YazgacResearch/3DPrinter/README.md

# High Resolution 3D Printer

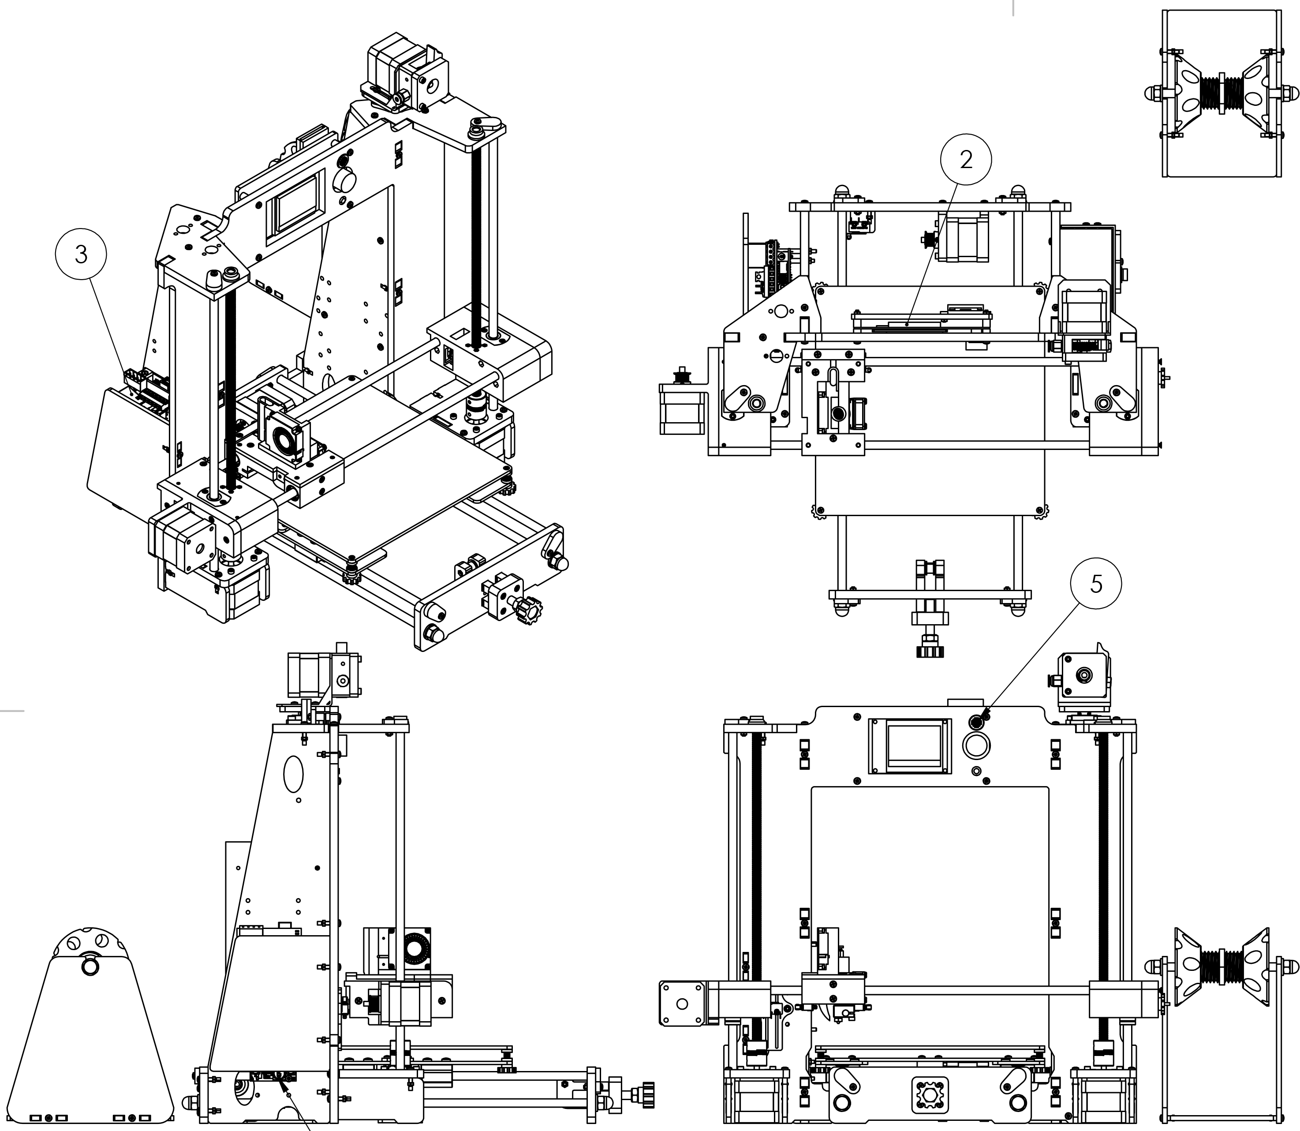
[picture p1: Images/design-1.png]
