YazgacResearch/3DPrinter/Marlin-bugfix-2.0.4.4/Patches for Eagle/Readme.txt

configuration files for Eagle.

Marlin version 020005
