YazgacResearch/3DPrinter/Drawings/3D_Printer_Rev_02/Electronics/Ramps_1.4/Shield Ramps 1.4.jpg

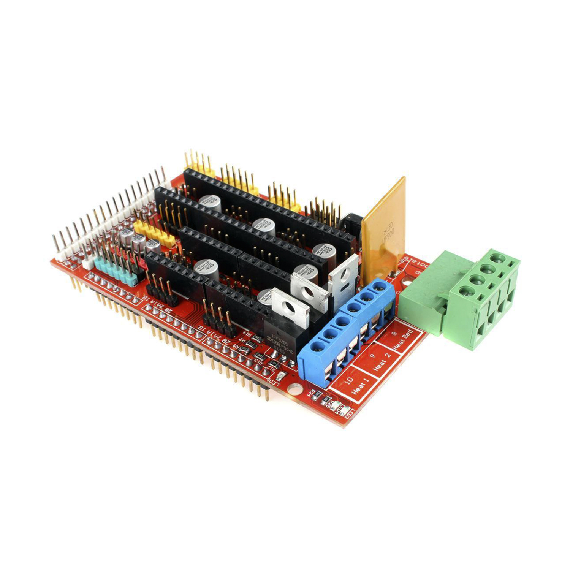
Drawings/3D_Printer_Rev_02/Electronics/Ramps_1.4/Shield Ramps 1.4.jpg
