YazgacResearch/3DPrinter/Marlin-bugfix-2.0.4.4/fotolar/IMG-9921.JPG

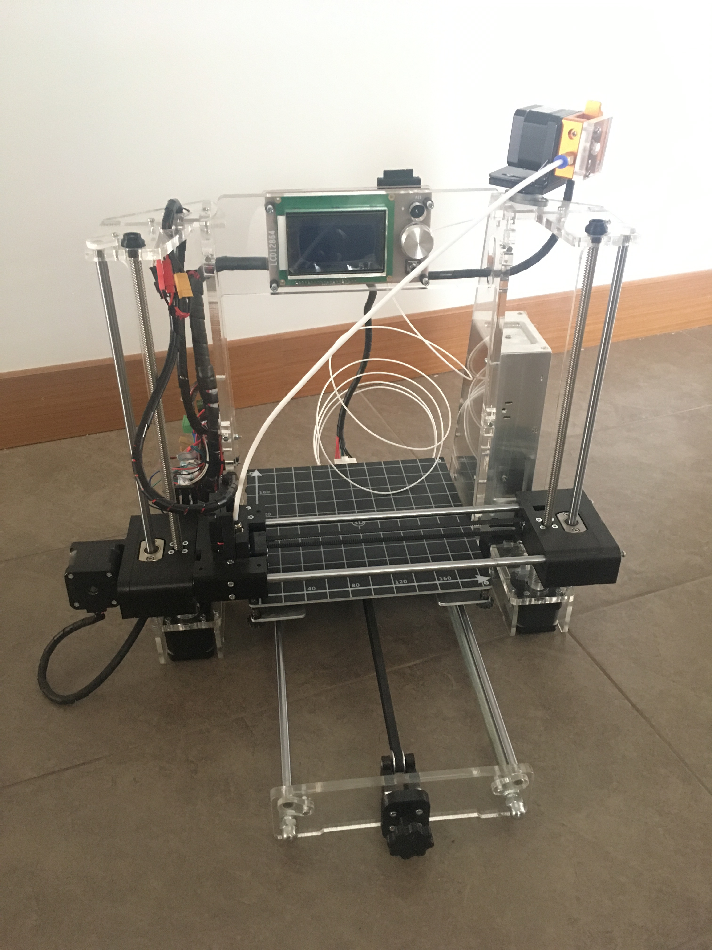
Marlin-bugfix-2.0.4.4/fotolar/IMG-9921.JPG
