YazgacResearch/3DPrinter/Marlin-bugfix-2.0.4.4/fotolar/IMG-9924.JPG

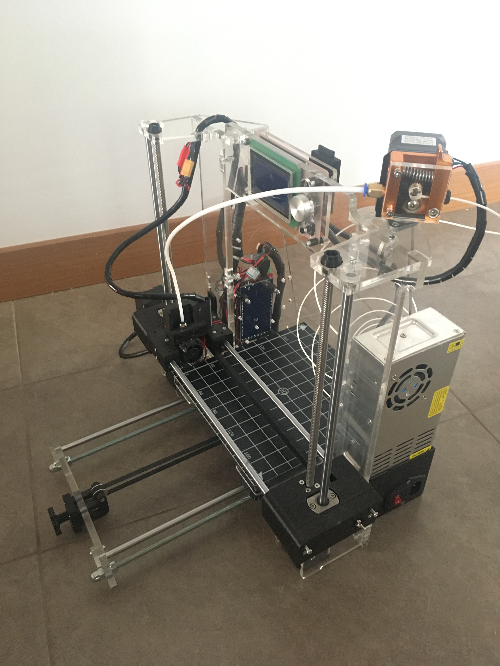
Marlin-bugfix-2.0.4.4/fotolar/IMG-9924.JPG
