YazgacResearch/3DPrinter/Marlin-bugfix-2.0.4.4/Pics/2.jpg

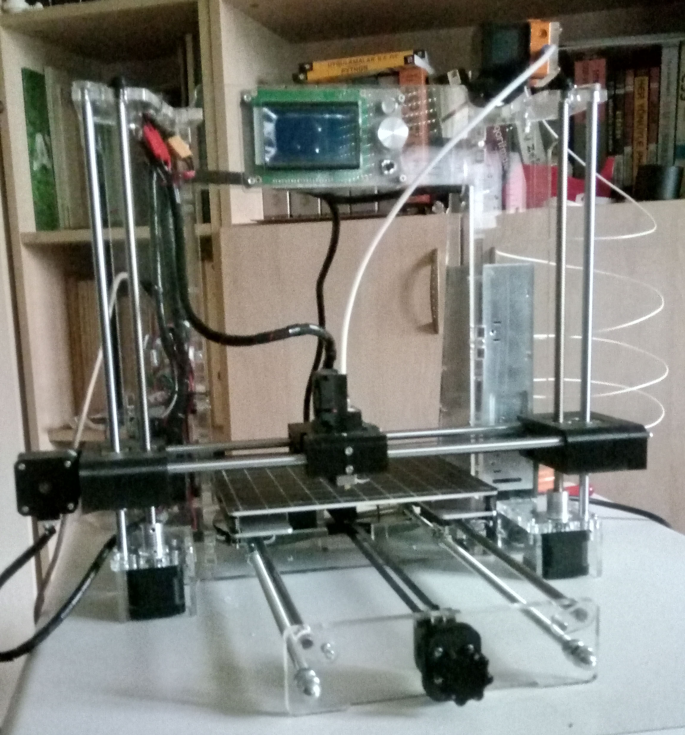
Marlin-bugfix-2.0.4.4/Pics/2.jpg
