YazgacResearch/3DPrinter/Marlin-bugfix-2.0.4.4/Pics/3-34178_black-eagle-png-eagle-clip-art.png

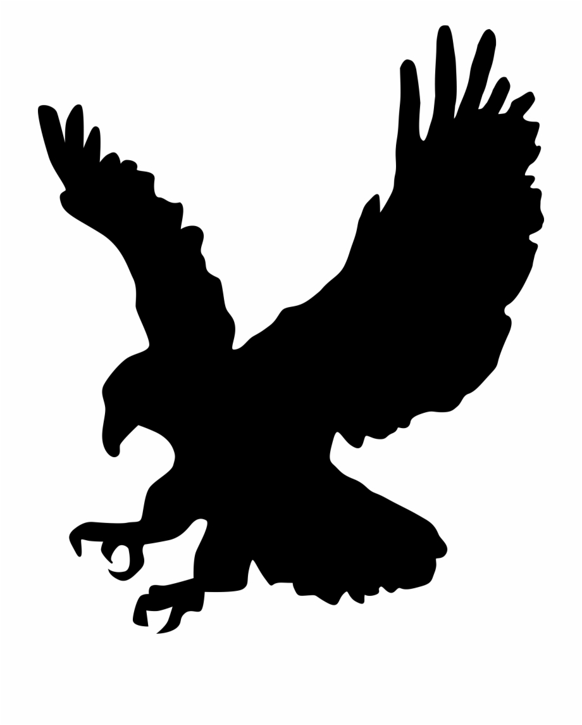
Marlin-bugfix-2.0.4.4/Pics/3-34178_black-eagle-png-eagle-clip-art.png
