YazgacResearch/3DPrinter/Marlin-bugfix-2.0.4.4/Pics/20200408_193704.jpg

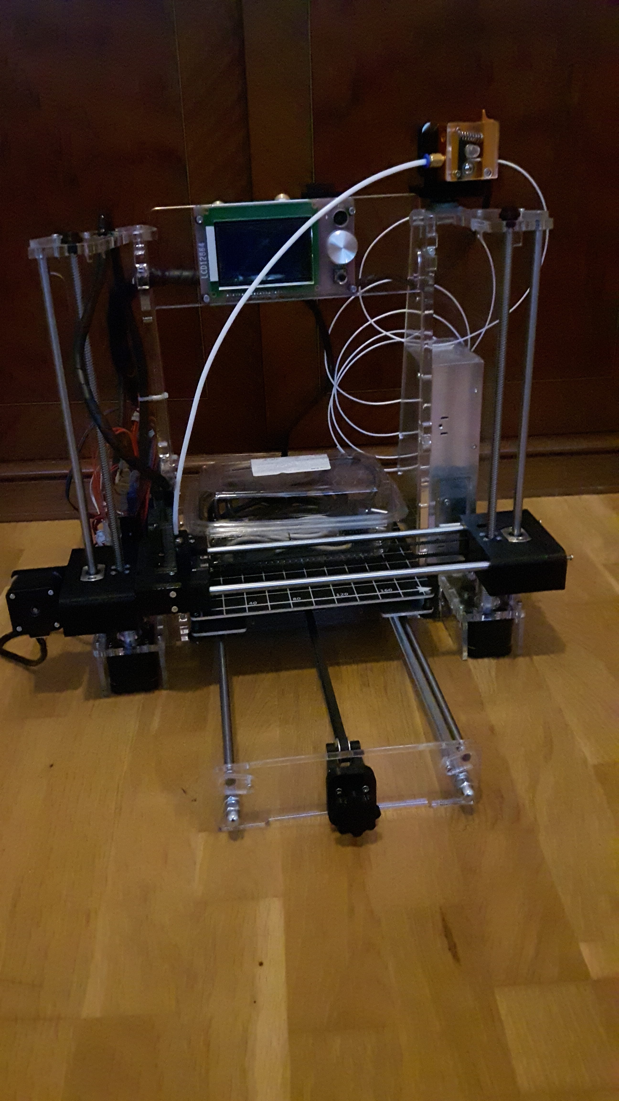
Marlin-bugfix-2.0.4.4/Pics/20200408_193704.jpg
