YazgacResearch/3DPrinter/Marlin-bugfix-2.0.4.4/Pics/20200408_193806.jpg

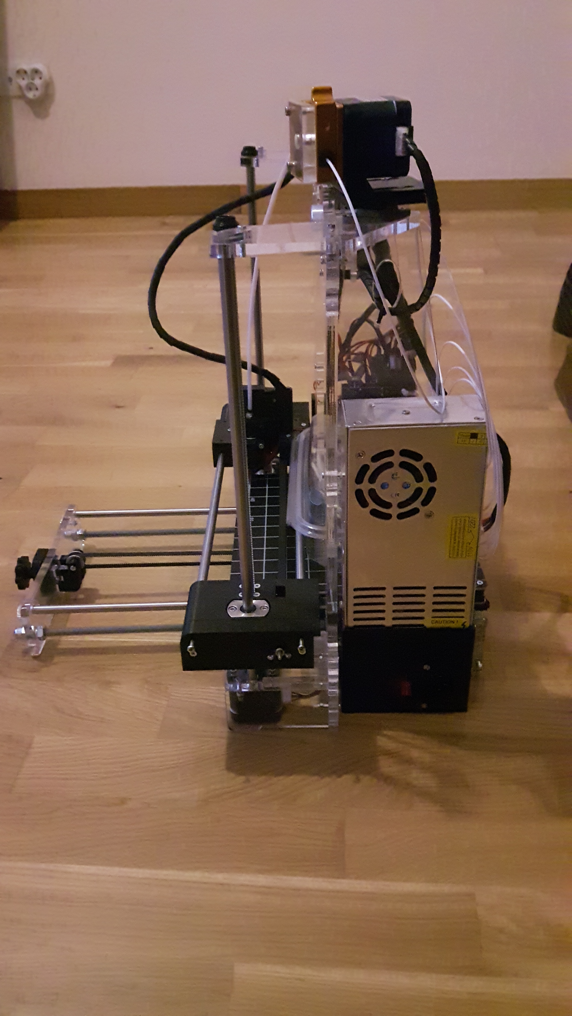
Marlin-bugfix-2.0.4.4/Pics/20200408_193806.jpg
