YazgacResearch/3DPrinter/Marlin-bugfix-2.0.4.4/Pics/Bald Eagle.png

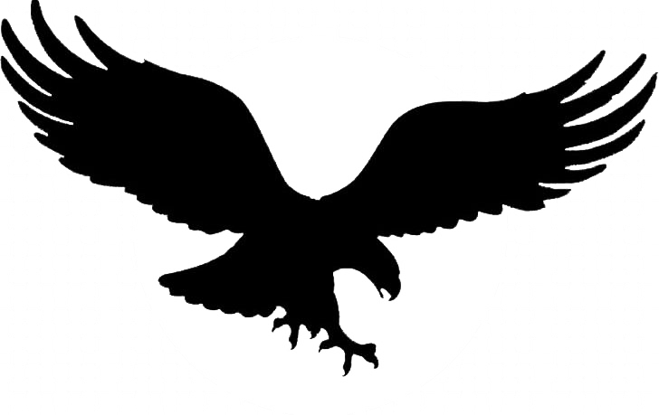
Marlin-bugfix-2.0.4.4/Pics/Bald Eagle.png
