YazgacResearch/3DPrinter/Marlin-bugfix-2.0.4.4/Pics/hiclipart.com.png

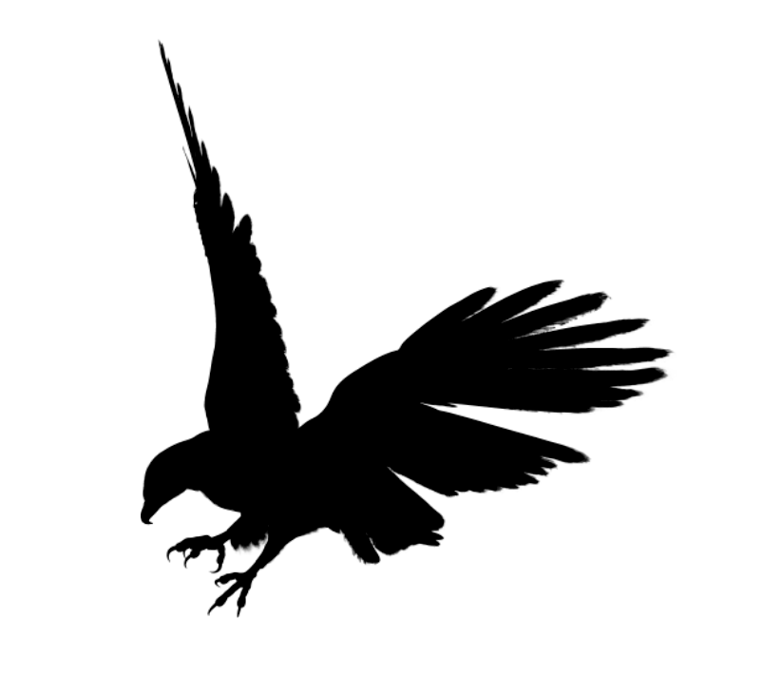
Marlin-bugfix-2.0.4.4/Pics/hiclipart.com.png
