YazgacResearch/3DPrinter/Marlin-bugfix-2.0.4.4/Pics/imgbin-bald-eagle-golden-eagle-tattoo-black-eagle-winged-eagle-insignia-ps52xis5R0xdxzzyCkJUg5Wib.jpg

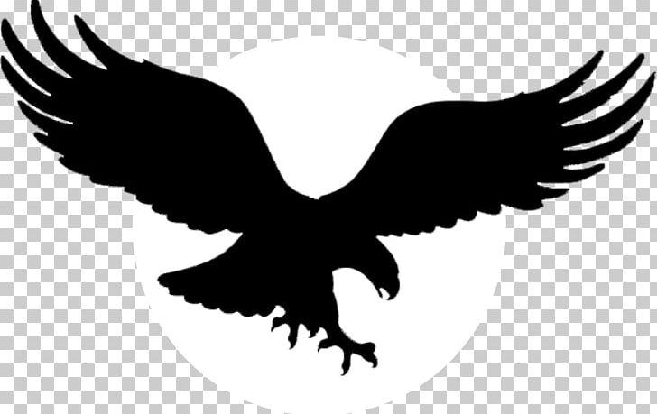
Marlin-bugfix-2.0.4.4/Pics/imgbin-bald-eagle-golden-eagle-tattoo-black-eagle-winged-eagle-insignia-ps52xis5R0xdxzzyCkJUg5Wib.jpg
