YazgacResearch/3DPrinter/Marlin-bugfix-2.0.4.4/Pics/SeekPng.com_magnifying-glass-png-no_660315.png

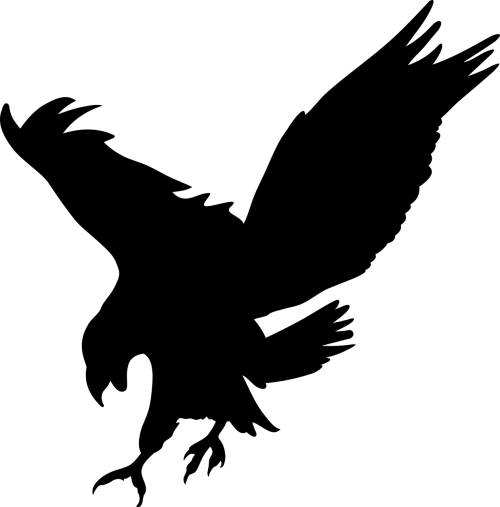
Marlin-bugfix-2.0.4.4/Pics/SeekPng.com_magnifying-glass-png-no_660315.png
