YazgacResearch/3DPrinter/Marlin-bugfix-2.0.4.4/Pics/toppng.com-flying-eagle-png-image-eagle-sv-516x599.png

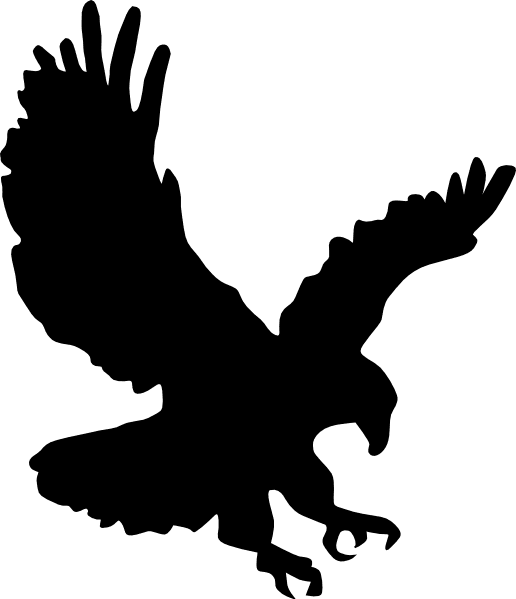
Marlin-bugfix-2.0.4.4/Pics/toppng.com-flying-eagle-png-image-eagle-sv-516x599.png
