YazgacResearch/3DPrinter/Drawings/3D_Printer_Rev_02/3D_Printer/Table_3DPrinter_BOM_01.xlsx

ITEM NO. | QTY. | PART NO. | DESCRIPTION
1 | 1 | 3D_Printer_Mechanic_Assem
 | 1 | MainFrame_Assem
 | 1 | MainFrame_Grp_Assem
 | 1 | MainFrame_FrontSide
 | 1 | MainFrame_BackLeftSide
 | 1 | MainFrame_BackRightSide
 | 1 | MainFrame_TopLeftSide
 | 1 | MainFrame_TopRightSide
 | 12 | M3 DIN 934 | Hexagon Full Nut to DIN 934 ~ISO 4032
 | 12 | M3X12mm ISO_7045 | Pan Head PoziDriv® Machine Screw DIN 7985 Z ~ISO 7045
 | 2 | MainFrame_ShaftStoper
 | 1 | Y_Axis_Grp_Assem
 | 1 | Y_DriveSide_Grp_Assem
 | 1 | Y_Axis_DriveSide_Plate
 | 1 | Y_Axis_MotorPlate_01
 | 1 | Y_Axis_MotorPlate_02
 | 1 | Y_Axis_SensorPlate
 | 4 | M3 DIN 934 | Hexagon Full Nut to DIN 934 ~ISO 4032
 | 1 | Step_motor_nema17_42x42x40mm
 | 4 | M3 x 30 DIN_912 | DIN 912 / ISO 4762 Made by Desing Table From M1,6 x 2,5 to M16 x 330
 | 1 | LimitSwitch_10T85(GSFY-10)
 | 2 | M2,5 DIN 934 | Hexagon Full Nut to DIN 934 ~ISO 4032
 | 2 | M2,5 x 10 | DIN 912 / ISO 4762 Made by Desing Table From M1,6 x 2,5 to M16 x 330
 | 1 | Pulley_GT2_20T
 | 4 | M3X12mm ISO_7045 | Pan Head PoziDriv® Machine Screw DIN 7985 Z ~ISO 7045
 | 2 | GuideRod_380_Yax
 | 1 | Y_TensionSide_Grp_Assem
 | 1 | Y_Axis_TensionSide_Plate
 | 1 | Y_Axis_Tensioner_Right
 | 1 | Y_Axis_Tensioner_Left
 | 1 | GT2_Pulley-3mm_bore-v8
 | 1 | GT2 Pulley 3mm bore v8.step
 | 1 | bearing.step
 | 1 | outer_plate.step
 | 5 | M3 DIN 934 | Hexagon Full Nut to DIN 934 ~ISO 4032
 | 1 | M3x25 ISO 7046-2
 | 1 | Y_Axis_TensionPlate_M8
 | 2 | M8 DIN 934 | Hexagon Full Nut to DIN 934 ~ISO 4032
 | 4 | M3x30 ISO_7046-2
 | 1 | DIN 933 | Hexagon Head Set Screw DIN 933
 | 1 | Y_Axis_TensionScrewCover_M8
 | 4 | MainFrame_ShaftStoper
 | 4 | M3 DIN 934 | Hexagon Full Nut to DIN 934 ~ISO 4032
 | 4 | M3X12mm ISO_7045 | Pan Head PoziDriv® Machine Screw DIN 7985 Z ~ISO 7045
 | 1 | Y_Carriage_Grp_WHB
 | 1 | HeatBed_CenterPart
 | 2 | HeatBed_SidePart
 | 14 | M3 DIN 934 | Hexagon Full Nut to DIN 934 ~ISO 4032
 | 1 | Y_Axis_BeltHolder
 | 6 | M3X10mm ISO_7045 | Pan Head PoziDriv® Machine Screw DIN 7985 Z ~ISO 7045
 | 2 | M3X12mm ISO_7045 | Pan Head PoziDriv® Machine Screw DIN 7985 Z ~ISO 7045
 | 2 | M3X20mm ISO_7045 | Pan Head PoziDriv® Machine Screw DIN 7985 Z ~ISO 7045
 | 4 | LineerBearingBlock_SC8UU
 | 16 | M4X16mm ISO_7045 | Pan Head PoziDriv® Machine Screw DIN 7985 Z ~ISO 7045
 | 8 | BedLeveling_SpringCap
 | 4 | BedLeveling_SpringD6H10
 | 4 | BedLeveling_ThumbWheel
 | 1 | HeatPad_220x220
 | 4 | M3x25 ISO 7046-2
 | 2 | Rod_M8x400
 | 8 | M8 DIN_125A | Flat Washer to DIN125A
 | 4 | M8 DIN 934 | Hexagon Full Nut to DIN 934 ~ISO 4032
 | 4 | M8 ISO_1587 | Hexagon Domed Cap Nut DIN 1587
 | 4 | M3 DIN 934 | Hexagon Full Nut to DIN 934 ~ISO 4032
 | 4 | M3X12mm ISO_7045 | Pan Head PoziDriv® Machine Screw DIN 7985 Z ~ISO 7045
 | 1 | Z_Axis_Grp_Right
 | 1 | Z_Axis_FramePart_01_Right
 | 2 | Z_Axis_FramePart_02
 | 2 | M3 DIN 934 | Hexagon Full Nut to DIN 934 ~ISO 4032
 | 1 | Z_Axis_Motor_Plate
 | 1 | Step_motor_nema17_42x42x40mm
 | 4 | M3 x 30 DIN_912 | DIN 912 / ISO 4762 Made by Desing Table From M1,6 x 2,5 to M16 x 330
 | 1 | Coupling_5x8
 | 4 | M3X5mm DIN_913 | Hexagon Socket Drive Set Screw Flat Point DIN 913 ISO 4026
 | 1 | LeadScrew_Trap_tr8_P2_318
 | 1 | GuideRod_340_Zax
 | 1 | Z_Axis_TopSide_ShaftGuide
 | 2 | M3X12mm ISO_7045 | Pan Head PoziDriv® Machine Screw DIN 7985 Z ~ISO 7045
 | 1 | Z_Axis_Grp_Left
 | 1 | Z_Axis_FramePart_01_Left
 | 2 | Z_Axis_FramePart_02
 | 2 | M3 DIN 934 | Hexagon Full Nut to DIN 934 ~ISO 4032
 | 1 | Z_Axis_Motor_Plate
 | 1 | Step_motor_nema17_42x42x40mm
 | 4 | M3 x 30 DIN_912 | DIN 912 / ISO 4762 Made by Desing Table From M1,6 x 2,5 to M16 x 330
 | 1 | Coupling_5x8
 | 4 | M3X5mm DIN_913 | Hexagon Socket Drive Set Screw Flat Point DIN 913 ISO 4026
 | 1 | LeadScrew_Trap_tr8_P2_318
 | 1 | Z_Axis_TopSide_ShaftGuide
 | 1 | GuideRod_340_Zax
 | 2 | M3X12mm ISO_7045 | Pan Head PoziDriv® Machine Screw DIN 7985 Z ~ISO 7045
 | 11 | M3 DIN 934 | Hexagon Full Nut to DIN 934 ~ISO 4032
 | 9 | M3X12mm ISO_7045 | Pan Head PoziDriv® Machine Screw DIN 7985 Z ~ISO 7045
 | 1 | Z_Axis_LimitSwitch_Grp
 | 1 | Z_Axis_LimitSwitch_BasePlate
 | 1 | LimitSwitch_10T85(GSFY-10)
 | 2 | M2 DIN 934 | Hexagon Full Nut to DIN 934 ~ISO 4032
 | 2 | Senkschraube ISO 7046-2 - M2x10-H1
 | 2 | M3 x 30 DIN_912 | DIN 912 / ISO 4762 Made by Desing Table From M1,6 x 2,5 to M16 x 330
 | 1 | X_Axis_Grp_Assem
 | 1 | DriveSideGrp_Assem
 | 1 | X_DriverSide_Block
 | 1 | X_DriverSide_MotorBlock
 | 6 | M3 DIN 934 | Hexagon Full Nut to DIN 934 ~ISO 4032
 | 4 | M3x30 ISO_7046-2
 | 4 | M3x5 ISO_7046-2
 | 1 | LineerBearingFlange-LM8UU
 | 2 | M3x25 DIN_912 | DIN 912 / ISO 4762 Made by Desing Table From M1,6 x 2,5 to M16 x 330
 | 1 | LeadScrew_AntiBacklash_tr8x2_Trapezodial
 | 1 | TR08.stp
 | 1 | nakretka tr08.stp
 | 1 | napinacz nakretki tr8.stp
 | 1 | sprezyna nakretka tr 8.stp
 | 4 | M2 DIN 934 | Hexagon Full Nut to DIN 934 ~ISO 4032
 | 4 | M2 x 10 DIN_912 | DIN 912 / ISO 4762 Made by Desing Table From M1,6 x 2,5 to M16 x 330
 | 1 | Step_motor_nema17_42x42x40mm
 | 4 | M3x12 ISO_7046-2
 | 1 | Pulley_GT2_20T
 | 1 | X_TensionSideGrp_Assem
 | 1 | X_TensionSide_Block
 | 1 | X_Tension_Grp
 | 1 | X_Tensioner
 | 1 | M3x15 ISO_7046-2
 | 3 | M3 DIN 934 | Hexagon Full Nut to DIN 934 ~ISO 4032
 | 1 | X_TensionerScrewPart
 | 1 | M3x55 ISO_7046-2
 | 1 | GT2_Pulley-3mm_bore-v8
 | 1 | GT2 Pulley 3mm bore v8.step
 | 1 | bearing.step
 | 1 | outer_plate.step
 | 1 | X_TensionSide_Cap
 | 8 | M3 DIN 934 | Hexagon Full Nut to DIN 934 ~ISO 4032
 | 4 | M3x35 ISO_7046-2
 | 1 | LineerBearingFlange-LM8UU
 | 2 | M3 x 30 DIN_912 | DIN 912 / ISO 4762 Made by Desing Table From M1,6 x 2,5 to M16 x 330
 | 1 | LeadScrew_AntiBacklash_tr8x2_Trapezodial
 | 1 | TR08.stp
 | 1 | nakretka tr08.stp
 | 1 | napinacz nakretki tr8.stp
 | 1 | sprezyna nakretka tr 8.stp
 | 4 | M2 DIN 934 | Hexagon Full Nut to DIN 934 ~ISO 4032
 | 4 | M2 x 10 DIN_912 | DIN 912 / ISO 4762 Made by Desing Table From M1,6 x 2,5 to M16 x 330
 | 2 | GuideRod_400_Xax
 | 2 | M3x25 ISO 7046-2
 | 2 | M3X5mm DIN_913 | Hexagon Socket Drive Set Screw Flat Point DIN 913 ISO 4026
 | 1 | X_Carriage_Main_Assem
 | 1 | X_Carriage_Grp_Assem
 | 1 | Carriage_Main
 | 4 | LineerBearing_LM8UU
 | 2 | M3X5mm DIN_913 | Hexagon Socket Drive Set Screw Flat Point DIN 913 ISO 4026
 | 2 | M3X3mm DIN_913 | Hexagon Socket Drive Set Screw Flat Point DIN 913 ISO 4026
 | 2 | LimitSwitch_10T85(GSFY-10)
 | 4 | M2,5 DIN 934 | Hexagon Full Nut to DIN 934 ~ISO 4032
 | 4 | M2,5x10 ISO_7046-2
 | 1 | Carriage_Cable_Clamp
 | 2 | M3x8 ISO_7046-2
 | 2 | M3x5 ISO_7046-2
 | 1 | Extruder_Grp_Assem
 | 1 | Extruder_Frame_Main
 | 1 | Fan_BLDC_40x10
 | 1 | Fan centrifugal 40x40x10 v9.iges
 | 1 | base.iges
 | 1 | lid.iges
 | 1 | driver and stator.iges
 | 1 | rotor.iges
 | 1 | fan.iges
 | 4 | M2 x 10 DIN_912 | DIN 912 / ISO 4762 Made by Desing Table From M1,6 x 2,5 to M16 x 330
 | 1 | Extruder_Hotend_E3D_V6
 | 1 | E3D All Metal Hotend V6 assy.STEP
 | 1 | Fan-DC-KDE0503PFB3-Promoco_Fan-DC-KDE0503PFB3-Promoco.STEP
 | 1 | Fan-House-30x30x10-Promoco_Fan-House-KDE0503PFB3-Promoco.STEP
 | 1 | Fan-30x30x10-Promoco_Fan-KDE0503PFB3-Promoco.STEP
 | 1 | E3D v6 HotEnd - Heatsink.STEP
 | 1 | E3D v6 HotEnd - Heatbreak.STEP
 | 1 | E3D v6 HotEnd - Nozzle.STEP
 | 1 | E3D v6 HotEnd - Heat Block.STEP
 | 1 | Ceramic Cartridge Heater.STEP
 | 1 | Thermistor.STEP
 | 1 | HEXAGON SOCKET HEAD CAP SCREWS_SCB3-4.STEP
 | 1 | HEXAGON SOCKET HEAD CAP SCREWS_SCB3-10.STEP
 | 1 | Flat Washers_PWF3.STEP
 | 1 | E3D-v6 Fan Duct.STEP
 | 4 | Self Tapping Screws - Pan Head_CSPTRSA-SUS-TP3-16.STEP
 | 1 | Extruder_Clamp_Main
 | 2 | M3 x 30 DIN_912 | DIN 912 / ISO 4762 Made by Desing Table From M1,6 x 2,5 to M16 x 330
 | 1 | Extruder_Cable_Clamp_Main
 | 2 | Senkschraube ISO 7046-2 - M2x10-H1
 | 1 | Extruder_Nozle_Main
 | 1 | Bowden_M8
 | 1 | Bronse fitting^Bowden_M8
 | 1 | Bushing^Bowden_M8
 | 1 | Push-In^Bowden_M8
 | 3 | M3x10 ISO_7046-2
 | 1 | Feeder_Grp_Assem
 | 1 | Angle_Mounting_Bracket_Nema17
 | 1 | Step_motor_nema17_42x42x40mm
 | 1 | Remote_Extrueder_Motor_Mount
 | 4 | M3X12mm ISO_7045 | Pan Head PoziDriv® Machine Screw DIN 7985 Z ~ISO 7045
 | 1 | Bearing_House_KFL08 | Rhino converted to STEP
 | 2 | DIN125_EN_ISO_7089_M4 | Washer BRB A4 1,7x4x0,3
 | 2 | DIN_EN_ISO_4032_M4
 | 2 | DIN_EN_ISO_912_M4x20
 | 1 | Mk8_Ext_Main_Right
 | 1 | MK8_Ext_01
 | 1 | DIN_EN_ISO_7045_M3x10
 | 1 | MK8_Ext_02
 | 1 | MK8_Ext_03
 | 2 | DIN_EN_ISO_912M3x5
 | 1 | MK8_Ext_04
 | 1 | Spring_1x25
 | 1 | DIN_EN_ISO_913M3x5
 | 1 | DIN_EN_ISO_912M3x20
 | 1 | Filament_Input_Guide_M6x1.75x7.8
 | 1 | Filament_Output_Guide
 | 1 | Filament_Output_Guide_M6x0.96x7.5
 | 1 | Bowden_M6x4
 | 1 | Feeder_Cover_Mount
 | 2 | M3 x 30 DIN_912 | DIN 912 / ISO 4762 Made by Desing Table From M1,6 x 2,5 to M16 x 330
 | 1 | SpoolHolder_Assem
 | 2 | SpoolHolder_SidePlate
 | 1 | SpoolHolder_BedPlate
 | 4 | M3 DIN 934 | Hexagon Full Nut to DIN 934 ~ISO 4032
 | 4 | M3X12mm ISO_7045 | Pan Head PoziDriv® Machine Screw DIN 7985 Z ~ISO 7045
 | 1 | Rod_M8x125
 | 2 | M8 DIN_125A | Flat Washer to DIN125A
 | 2 | M8 ISO_1587 | Hexagon Domed Cap Nut DIN 1587
 | 1 | SpoolHolder_Shaft_M30
 | 2 | SpoolHolder_Knob_M30
 | 1 | ECard_Cover_Plate
 | 1 | PSU_Cover_Assem
 | 1 | PSU_Cover
 | 1 | PSU_EnergySocket
 | 2 | M3 DIN 934 | Hexagon Full Nut to DIN 934 ~ISO 4032
 | 2 | M3X10mm ISO_7045 | Pan Head PoziDriv® Machine Screw DIN 7985 Z ~ISO 7045
2 | 1 | LCD_Main_ElecCards_Grp_Assem
 | 1 | LCDBottom_AnetA6
 | 1 | LCD_12864_RevA6
 | 4 | Spacer_D7H4
 | 4 | Spacer_D7H8
 | 1 | LCD_Support_PLK
 | 1 | SD_CardCase_Assem
 | 1 | SD_CardCase_Bottom
 | 1 | SD_CardCase_Top
 | 2 | Senkschraube ISO 7046-2 - M2x10-H1
 | 6 | M3 DIN 934 | Hexagon Full Nut to DIN 934 ~ISO 4032
 | 2 | M3x10 ISO_7046-2
 | 4 | M3X12mm | Pan Head PoziDriv® Machine Screw DIN 7985 Z ~ISO 7045
3 | 1 | Main_ElecCards_Grp_Ass
 | 1 | Arduino_Mega-2650
 | 1 | arduino MEGA2650.STEP
 | 1 | USB type b.SLDPRT.STEP
 | 1 | USB SHELL.STEP
 | 1 | USB core.STEP
 | 2 | usb top contact.STEP
 | 2 | usb btm contact.STEP
 | 1 | RESET BUTTON.STEP
 | 1 | RESET CORE.STEP
 | 1 | RESET.STEP
 | 1 | MEGAboard.STEP
 | 2 | 47uf CAP Dcase.STEP
 | 1 | power jack.STEP
 | 1 | crystal.STEP
 | 6 | 2pin_header__02.STEP
 | 1 | reg.STEP
 | 4 | led.STEP
 | 1 | atmega16u2.STEP
 | 5 | 8 PORT HEADER.STEP
 | 1 | 10 PORT HEADER.STEP
 | 2 | 102 RESISTOR PACK.STEP
 | 2 | 103 RESISTOR PACK.STEP
 | 1 | 220 RESISTOR PACK.STEP
 | 1 | 16mhz crystal - measured.STEP
 | 1 | PADS001.STEP
 | 15 | 603 cap on pad.STEP
 | 1 | ssot3.STEP
 | 1 | mf-msmf050-2.STEP
 | 1 | lmv358.STEP
 | 1 | lp2985dgkr.STEP
 | 2 | cd1206 diode.STEP
 | 2 | 603 resistor.STEP
 | 1 | blm21.STEP
 | 1 | m7 diode.STEP
 | 2 | MLC0603.STEP
 | 1 | 18 X 2 ROW HEADER.STEP
 | 1 | atmega2650-16AU.STEP
 | 1 | Ramps_1.4
 | 3 | Spacer_D4.4H11
 | 5 | StepMotorDriver_DRV8825
 | 1 | DRV8825.step
 | 1 | DRV8825 Driver v9.step
 | 1 | DRV8825 53TG5 CLV1.step
 | 1 | Package.step
 | 1 | PCB.step
 | 2 | RI00 v1.step
 | 1 | 152 v2.step
 | 1 | EDI v3.step
 | 1 | CAP.step
 | 5 | Cap Small.step
 | 1 | Voltage Regulator.step
 | 2 | 2.54 4W Header.step
 | 3 | Spacer_D4.4H10
 | 3 | M3 DIN 934 | Hexagon Full Nut to DIN 934 ~ISO 4032
 | 3 | M3X12mm | Pan Head PoziDriv® Machine Screw DIN 7985 Z ~ISO 7045
4 | 1 | Main_ElecCards_lm2596_Assem
 | 1 | Arduino_LM2596
 | 2 | Spacer_D4.4H10
 | 2 | M3 DIN 934 | Hexagon Full Nut to DIN 934 ~ISO 4032
 | 2 | M3X12mm | Pan Head PoziDriv® Machine Screw DIN 7985 Z ~ISO 7045
5 | 1 | BuzzerCap
6 | 1 | PSU_Assem
 | 1 | PSU_Jotta_S350-12V
 | 5 | M3X10mm ISO_7045 | Pan Head PoziDriv® Machine Screw DIN 7985 Z ~ISO 7045
