YazgacResearch/3DPrinter/Drawings/3D_Printer_Rev_02/3D_Printer/Table_3DPrinterMechanic_BOM.xlsx

ITEM NO. | QTY. | PART NO.
1 | 1 | MainFrame_Assem
 | 1 | MainFrame_Grp_Assem
 | 1 | MainFrame_FrontSide
 | 1 | MainFrame_BackLeftSide
 | 1 | MainFrame_BackRightSide
 | 1 | MainFrame_TopLeftSide
 | 1 | MainFrame_TopRightSide
 | 12 | M3 DIN 934
 | 12 | M3X12mm ISO_7045
 | 2 | MainFrame_ShaftStoper
 | 1 | Y_Axis_Grp_Assem
 | 1 | Y_DriveSide_Grp_Assem
 | 1 | Y_Axis_DriveSide_Plate
 | 1 | Y_Axis_MotorPlate_01
 | 1 | Y_Axis_MotorPlate_02
 | 1 | Y_Axis_SensorPlate
 | 4 | M3 DIN 934
 | 1 | Step_motor_nema17_42x42x40mm
 | 4 | M3 x 30 DIN_912
 | 1 | LimitSwitch_10T85(GSFY-10)
 | 2 | M2,5 DIN 934
 | 2 | M2,5 x 10
 | 1 | Pulley_GT2_20T
 | 4 | M3X12mm ISO_7045
 | 2 | GuideRod_380_Yax
 | 1 | Y_TensionSide_Grp_Assem
 | 1 | Y_Axis_TensionSide_Plate
 | 1 | Y_Axis_Tensioner_Right
 | 1 | Y_Axis_Tensioner_Left
 | 1 | GT2_Pulley-3mm_bore-v8
 | 5 | M3 DIN 934
 | 1 | M3x25 ISO 7046-2
 | 1 | Y_Axis_TensionPlate_M8
 | 2 | M8 DIN 934
 | 4 | M3x30 ISO_7046-2
 | 1 | DIN 933
 | 1 | Y_Axis_TensionScrewCover_M8
 | 4 | MainFrame_ShaftStoper
 | 4 | M3 DIN 934
 | 4 | M3X12mm ISO_7045
 | 1 | Y_Carriage_Grp_WHB
 | 1 | HeatBed_CenterPart
 | 2 | HeatBed_SidePart
 | 14 | M3 DIN 934
 | 1 | Y_Axis_BeltHolder
 | 6 | M3X10mm ISO_7045
 | 2 | M3X12mm ISO_7045
 | 2 | M3X20mm ISO_7045
 | 4 | LineerBearingBlock_SC8UU
 | 16 | M4X16mm ISO_7045
 | 8 | BedLeveling_SpringCap
 | 4 | BedLeveling_SpringD6H10
 | 4 | BedLeveling_ThumbWheel
 | 1 | HeatPad_220x220
 | 4 | M3x25 ISO 7046-2
 | 2 | Rod_M8x400
 | 8 | M8 DIN_125A
 | 4 | M8 DIN 934
 | 4 | M8 ISO_1587
 | 4 | M3 DIN 934
 | 4 | M3X12mm ISO_7045
2 | 1 | Z_Axis_Grp_Right
 | 1 | Z_Axis_FramePart_01_Right
 | 2 | Z_Axis_FramePart_02
 | 2 | M3 DIN 934
 | 1 | Z_Axis_Motor_Plate
 | 1 | Step_motor_nema17_42x42x40mm
 | 4 | M3 x 30 DIN_912
 | 1 | Coupling_5x8
 | 4 | M3X5mm DIN_913
 | 1 | LeadScrew_Trap_tr8_P2_318
 | 1 | GuideRod_340_Zax
 | 1 | Z_Axis_TopSide_ShaftGuide
 | 2 | M3X12mm ISO_7045
3 | 1 | Z_Axis_Grp_Left
 | 1 | Z_Axis_FramePart_01_Left
 | 2 | Z_Axis_FramePart_02
 | 2 | M3 DIN 934
 | 1 | Z_Axis_Motor_Plate
 | 1 | Step_motor_nema17_42x42x40mm
 | 4 | M3 x 30 DIN_912
 | 1 | Coupling_5x8
 | 4 | M3X5mm DIN_913
 | 1 | LeadScrew_Trap_tr8_P2_318
 | 1 | Z_Axis_TopSide_ShaftGuide
 | 1 | GuideRod_340_Zax
 | 2 | M3X12mm ISO_7045
4 | 11 | M3 DIN 934
5 | 9 | M3X12mm ISO_7045
6 | 1 | Z_Axis_LimitSwitch_Grp
 | 1 | Z_Axis_LimitSwitch_BasePlate
 | 1 | LimitSwitch_10T85(GSFY-10)
 | 2 | M2 DIN 934
 | 2 | Senkschraube ISO 7046-2 - M2x10-H1
7 | 2 | M3 x 30 DIN_912
8 | 1 | X_Axis_Grp_Assem
 | 1 | DriveSideGrp_Assem
 | 1 | X_DriverSide_Block
 | 1 | X_DriverSide_MotorBlock
 | 6 | M3 DIN 934
 | 4 | M3x30 ISO_7046-2
 | 4 | M3x5 ISO_7046-2
 | 1 | LineerBearingFlange-LM8UU
 | 2 | M3x25 DIN_912
 | 1 | LeadScrew_AntiBacklash_tr8x2_Trapezodial
 | 4 | M2 DIN 934
 | 4 | M2 x 10 DIN_912
 | 1 | Step_motor_nema17_42x42x40mm
 | 4 | M3x12 ISO_7046-2
 | 1 | Pulley_GT2_20T
 | 1 | X_TensionSideGrp_Assem
 | 1 | X_TensionSide_Block
 | 1 | X_Tension_Grp
 | 1 | X_Tensioner
 | 1 | M3x15 ISO_7046-2
 | 3 | M3 DIN 934
 | 1 | X_TensionerScrewPart
 | 1 | M3x55 ISO_7046-2
 | 1 | GT2_Pulley-3mm_bore-v8
 | 1 | X_TensionSide_Cap
 | 8 | M3 DIN 934
 | 4 | M3x35 ISO_7046-2
 | 1 | LineerBearingFlange-LM8UU
 | 2 | M3 x 30 DIN_912
 | 1 | LeadScrew_AntiBacklash_tr8x2_Trapezodial
 | 4 | M2 DIN 934
 | 4 | M2 x 10 DIN_912
 | 2 | GuideRod_400_Xax
 | 2 | M3x25 ISO 7046-2
 | 2 | M3X5mm DIN_913
 | 1 | X_Carriage_Main_Assem
 | 1 | X_Carriage_Grp_Assem
 | 1 | Carriage_Main
 | 4 | LineerBearing_LM8UU
 | 2 | M3X5mm DIN_913
 | 2 | M3X3mm DIN_913
 | 2 | LimitSwitch_10T85(GSFY-10)
 | 4 | M2,5 DIN 934
 | 4 | M2,5x10 ISO_7046-2
 | 1 | Carriage_Cable_Clamp
 | 2 | M3x8 ISO_7046-2
 | 2 | M3x5 ISO_7046-2
 | 1 | Extruder_Grp_Assem
 | 1 | Extruder_Frame_Main
 | 1 | Fan_BLDC_40x10
 | 4 | M2 x 10 DIN_912
 | 1 | Extruder_Hotend_E3D_V6
 | 1 | Extruder_Clamp_Main
 | 2 | M3 x 30 DIN_912
 | 1 | Extruder_Cable_Clamp_Main
 | 2 | Senkschraube ISO 7046-2 - M2x10-H1
 | 1 | Extruder_Nozle_Main
 | 1 | Bowden_M8
 | 3 | M3x10 ISO_7046-2
9 | 1 | Feeder_Grp_Assem
 | 1 | Angle_Mounting_Bracket_Nema17
 | 1 | Step_motor_nema17_42x42x40mm
 | 1 | Remote_Extrueder_Motor_Mount
 | 4 | M3X12mm ISO_7045
 | 1 | Bearing_House_KFL08
 | 2 | DIN125_EN_ISO_7089_M4
 | 2 | DIN_EN_ISO_4032_M4
 | 2 | DIN_EN_ISO_912_M4x20
 | 1 | Mk8_Ext_Main_Right
 | 1 | Filament_Input_Guide_M6x1.75x7.8
 | 1 | Filament_Output_Guide
 | 1 | Filament_Output_Guide_M6x0.96x7.5
 | 1 | Bowden_M6x4
 | 1 | Feeder_Cover_Mount
 | 2 | M3 x 30 DIN_912
10 | 1 | SpoolHolder_Assem
 | 2 | SpoolHolder_SidePlate
 | 1 | SpoolHolder_BedPlate
 | 4 | M3 DIN 934
 | 4 | M3X12mm ISO_7045
 | 1 | Rod_M8x125
 | 2 | M8 DIN_125A
 | 2 | M8 ISO_1587
 | 1 | SpoolHolder_Shaft_M30
 | 2 | SpoolHolder_Knob_M30
11 | 1 | ECard_Cover_Plate
12 | 1 | PSU_Cover_Assem
 | 1 | PSU_Cover
 | 1 | PSU_EnergySocket
 | 2 | M3 DIN 934
 | 2 | M3X10mm ISO_7045
