YazgacResearch/3DPrinter/Drawings/3D_Printer_Rev_02/Electronics/Main_ElecCards_lm2596_Assem.SLDASM

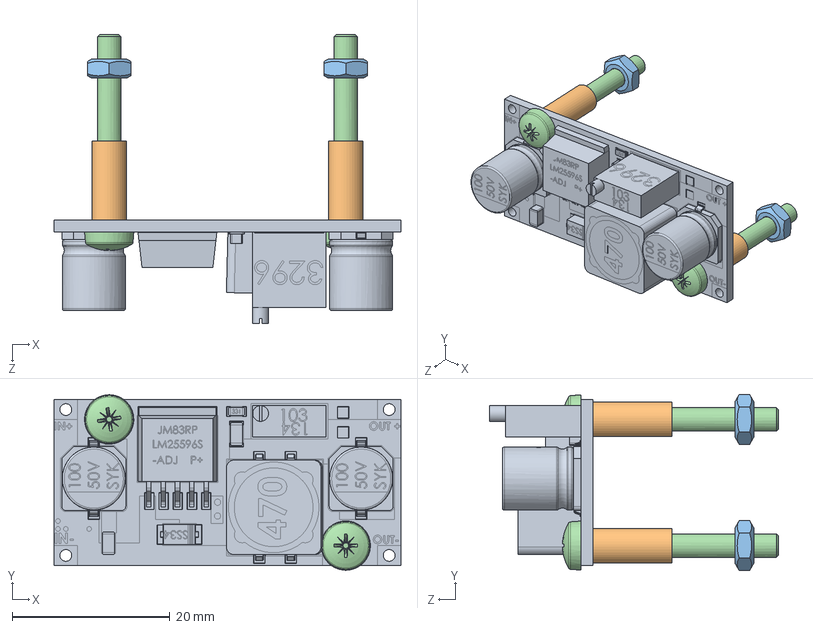
[picture p30: CAD file, 2021-01-05]
Drawings/3D_Printer_Rev_02/Electronics/Main_ElecCards_lm2596_Assem.SLDASM
44.0 x 22.4 x 36.6 mm
Arduino_LM2596
Spacer_D4.4H10 x 2
DIN_EN_ISO_934_M3 x 2
DIN_EN_ISO_7045M3x25 x 2
