YazgacResearch/3DPrinter/Drawings/3D_Printer_Rev_02/Extruder_Grp/Extruder_Sub_Parts/Extruder_Nozle_Main.SLDPRT

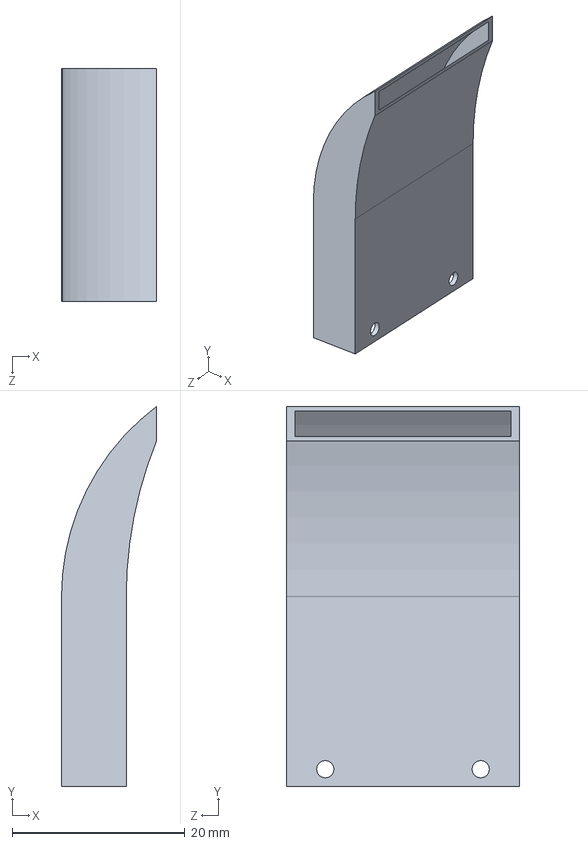
[picture p32: CAD file, 2021-01-05]
Drawings/3D_Printer_Rev_02/Extruder_Grp/Extruder_Sub_Parts/Extruder_Nozle_Main.SLDPRT
11.0 x 44.0 x 27.0 mm
