YazgacResearch/3DPrinter/Drawings/3D_Printer_Rev_02/MainFrame/MainFrame_Grp_Assem.SLDASM

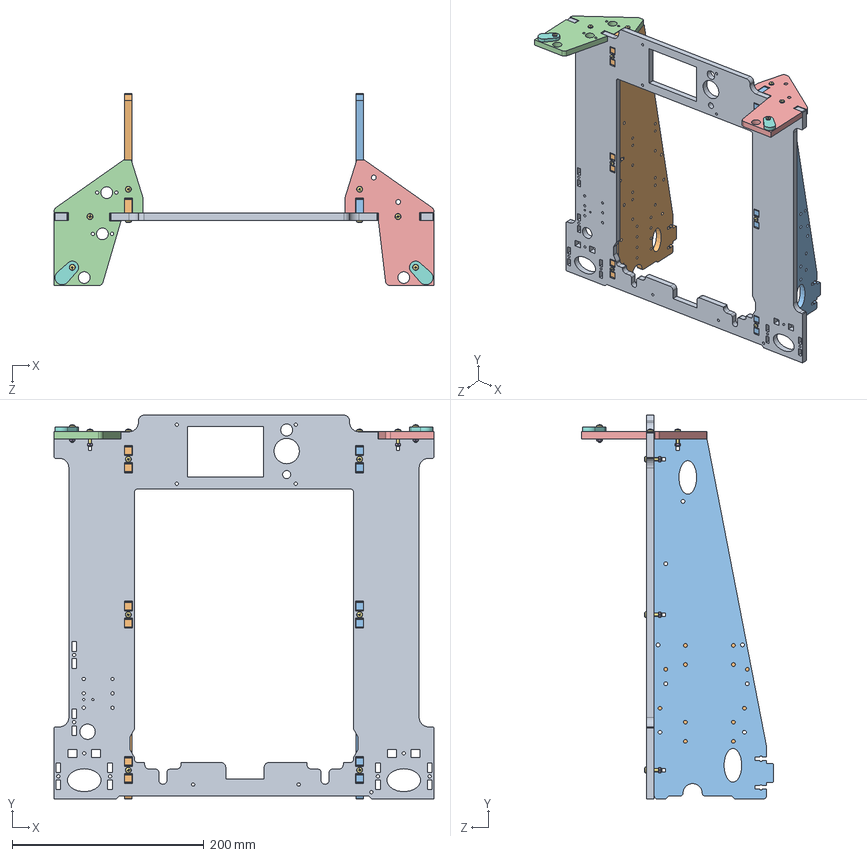
[picture p33: CAD file, 2021-01-05]
Drawings/3D_Printer_Rev_02/MainFrame/MainFrame_Grp_Assem.SLDASM
396.0 x 400.0 x 200.5 mm
MainFrame_FrontSide
MainFrame_BackLeftSide
MainFrame_BackRightSide
MainFrame_TopLeftSide
MainFrame_TopRightSide
DIN_EN_ISO_934_M3 x 12
DIN_EN_ISO_7045M3x16 x 12
MainFrame_ShaftStoper x 2
