YazgacResearch/3DPrinter/Drawings/3D_Printer_Rev_02/Ticari/e3d-v6-hot-end/Extruder_Hotend_E3D_V6.SLDASM

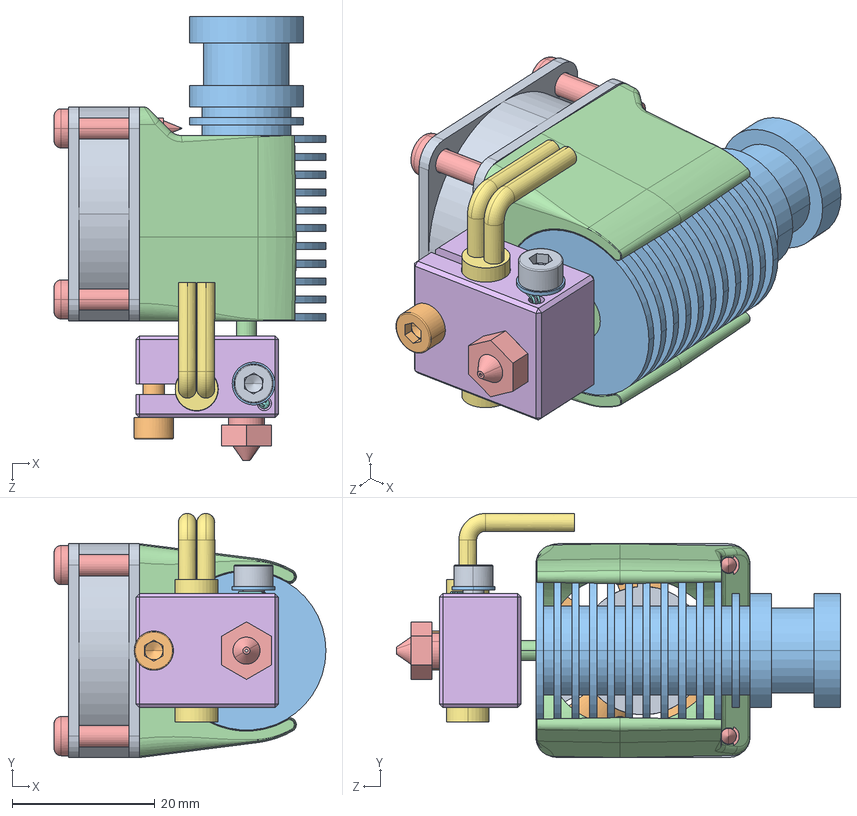
[picture p36: CAD file, 2021-01-05]
Drawings/3D_Printer_Rev_02/Ticari/e3d-v6-hot-end/Extruder_Hotend_E3D_V6.SLDASM
38.2 x 34.2 x 62.3 mm
Fan-House-30x30x10-Promoco_Fan-House-KDE0503PFB3-Promoco.STEP
Fan-30x30x10-Promoco_Fan-KDE0503PFB3-Promoco.STEP
E3D v6 HotEnd - Heatsink.STEP
E3D v6 HotEnd - Heatbreak.STEP
E3D v6 HotEnd - Nozzle.STEP
E3D v6 HotEnd - Heat Block.STEP
Ceramic Cartridge Heater.STEP
Thermistor.STEP
HEXAGON SOCKET HEAD CAP SCREWS_SCB3-4.STEP
HEXAGON SOCKET HEAD CAP SCREWS_SCB3-10.STEP
Flat Washers_PWF3.STEP
E3D-v6 Fan Duct.STEP
Self Tapping Screws - Pan Head_CSPTRSA-SUS-TP3-16.STEP x 4
