YazgacResearch/3DPrinter/Drawings/3D_Printer_Rev_02/X_Axis/X_Carriage/X_Carriage_Grp_Assem.SLDASM

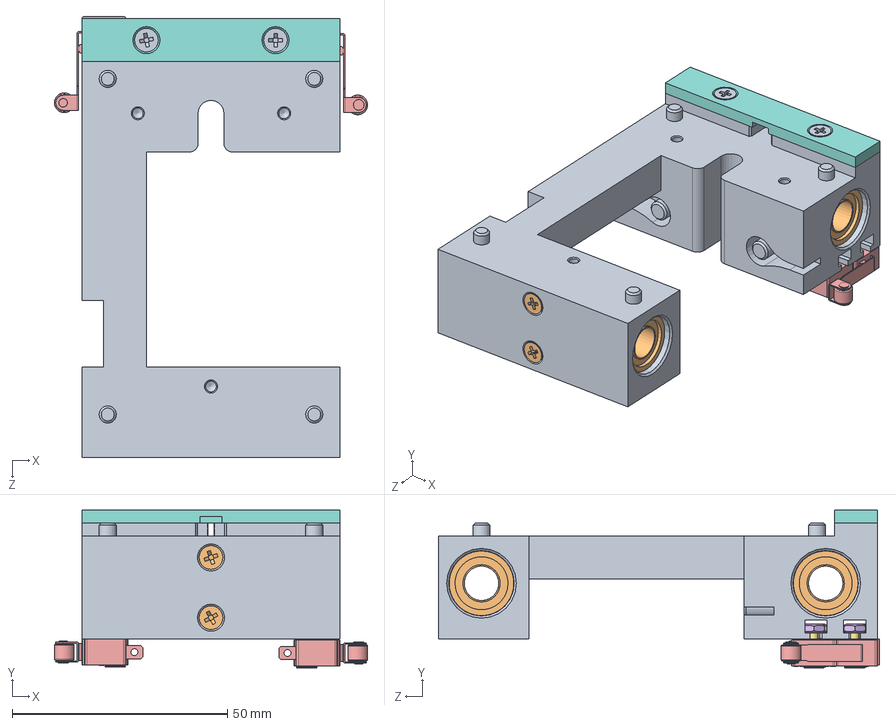
[picture p37: CAD file, 2021-01-05]
Drawings/3D_Printer_Rev_02/X_Axis/X_Carriage/X_Carriage_Grp_Assem.SLDASM
72.8 x 36.7 x 102.5 mm
Carriage_Main
LineerBearing_LM8UU x 4
DIN_EN_ISO_913_M3x5 x 2
DIN_EN_ISO_913_M3x3 x 2
LimitSwitch_10T85(GSFY-10) x 2
DIN_EN_ISO_934_M2.5 x 4
DIN_EN_ISO_7046-2-R1_M2.5x10 x 4
Carriage_Cable_Clamp
DIN_EN_ISO_7046-2-R1_M3x8 x 2
DIN_EN_ISO_7046-2-R1_M3x5 x 2
