YazgacResearch/3DPrinter/Drawings/3D_Printer_Rev_02/X_Axis/X_DriverSide/DriveSideGrp_Assem.SLDASM

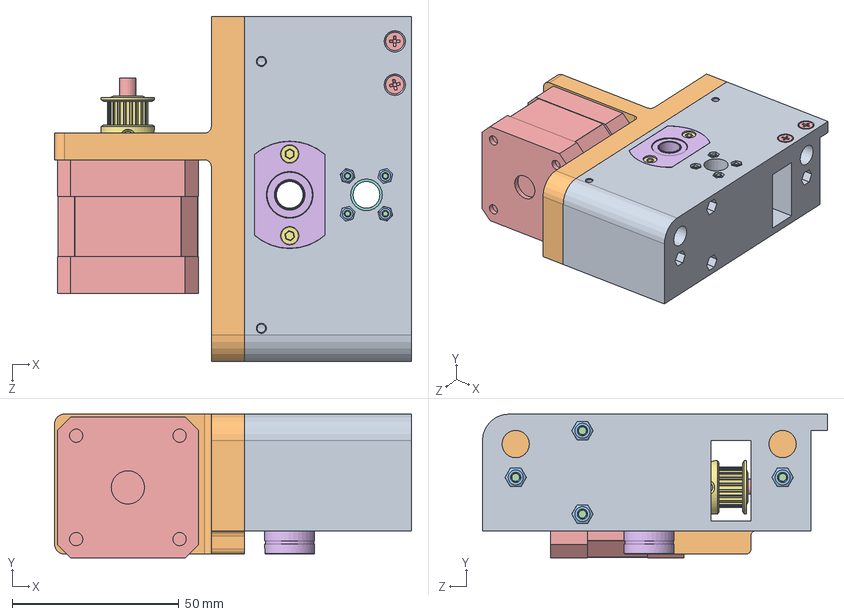
[picture p38: CAD file, 2021-01-05]
Drawings/3D_Printer_Rev_02/X_Axis/X_DriverSide/DriveSideGrp_Assem.SLDASM
107.0 x 43.2 x 103.5 mm
X_DriverSide_Block
X_DriverSide_MotorBlock
DIN_EN_ISO_934_M3 x 6
DIN_EN_ISO_7046-2-R1_M3x30 x 4
DIN_EN_ISO_7046-2-R1_M3x5 x 4
LineerBearingFlange-LM8UU
DIN_EN_ISO_912_M3x25 x 2
nakretka tr08.stp
napinacz nakretki tr8.stp
sprezyna nakretka tr 8.stp
DIN_EN_ISO_934_M2 x 4
DIN_EN_ISO_912_M2x10 x 4
Step_motor_nema17_42x42x40mm
DIN_EN_ISO_7046-2-R1_M3x12 x 4
Pulley_GT2_20T
