YazgacResearch/3DPrinter/Drawings/3D_Printer_Rev_02/X_Axis/X_TensionSide/X_Tension_Grp.SLDASM

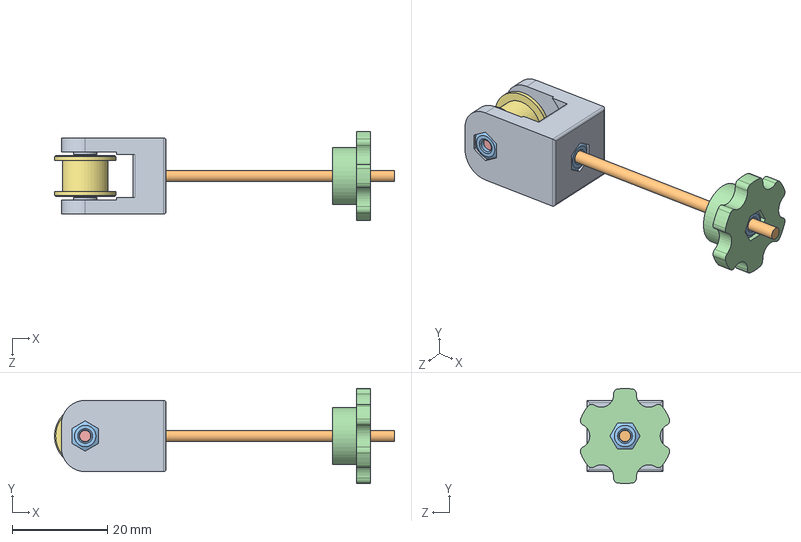
[picture p39: CAD file, 2021-01-05]
Drawings/3D_Printer_Rev_02/X_Axis/X_TensionSide/X_Tension_Grp.SLDASM
71.4 x 20.0 x 18.8 mm
X_Tensioner
DIN_EN_ISO_7046-2-R1_M3x55
DIN_EN_ISO_934_M3 x 3
X_TensionerScrewPart
DIN_EN_ISO_7046-2-R1_M3x15
bearing.step
outer_plate.step
