YazgacResearch/3DPrinter/Drawings/3D_Printer_Rev_02/Y_Axis/Y_Axis_Grp_Assem.SLDASM

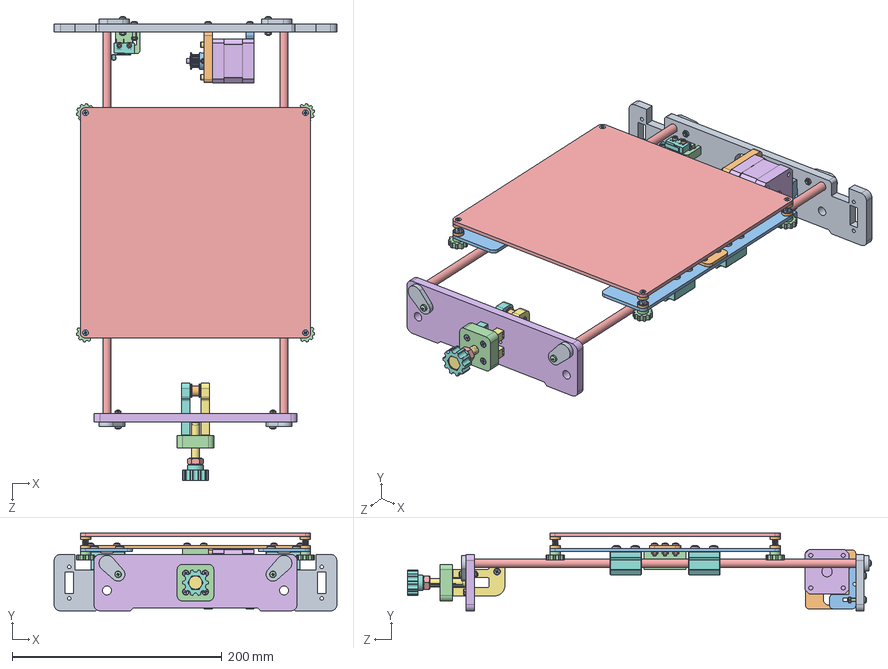
[picture p40: CAD file, 2021-01-05]
Drawings/3D_Printer_Rev_02/Y_Axis/Y_Axis_Grp_Assem.SLDASM
270.0 x 74.3 x 443.0 mm
Y_Axis_DriveSide_Plate
Y_Axis_MotorPlate_01
Y_Axis_MotorPlate_02
Y_Axis_SensorPlate
DIN_EN_ISO_934_M3 x 27
Step_motor_nema17_42x42x40mm
DIN_EN_ISO_912_M3x15 x 4
LimitSwitch_10T85(GSFY-10)
DIN_EN_ISO_934_M2.5 x 2
DIN_EN_ISO_912_M2.5x18 x 2
Pulley_GT2_20T
DIN_EN_ISO_7045M3x16 x 8
GuideRod_380_Yax x 2
Y_Axis_TensionSide_Plate
Y_Axis_Tensioner_Right
Y_Axis_Tensioner_Left
bearing.step
outer_plate.step
DIN_EN_ISO_7046-2-R1_M3x25 x 5
Y_Axis_TensionPlate_M8
DIN_EN_ISO_934_M8 x 2
DIN_EN_ISO_7046-2-R1_M3x30 x 4
DIN_EN_ISO_933_M8x50
Y_Axis_TensionScrewCover_M8
MainFrame_ShaftStoper x 4
HeatBed_CenterPart
HeatBed_SidePart x 2
Y_Axis_BeltHolder
DIN_EN_ISO_7045M3x10 x 6
DIN_EN_ISO_7045M3x12 x 2
DIN_EN_ISO_7045M3x20 x 2
LineerBearingBlock_SC8UU x 4
DIN_EN_ISO_7045M4x16 x 16
BedLeveling_SpringCap x 8
BedLeveling_SpringD6H10 x 4
BedLeveling_ThumbWheel x 4
HeatPad_220x220
