YazgacResearch/3DPrinter/Drawings/3D_Printer_Rev_02/Y_Axis/Y_Carriage/Y_Carriage_Grp_WHB.SLDASM

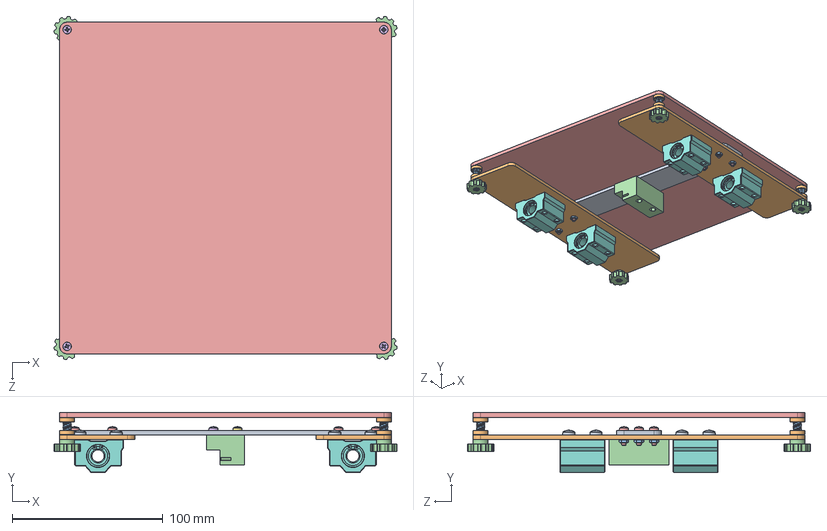
[picture p41: CAD file, 2021-01-05]
Drawings/3D_Printer_Rev_02/Y_Axis/Y_Carriage/Y_Carriage_Grp_WHB.SLDASM
227.5 x 39.8 x 227.5 mm
HeatBed_CenterPart
HeatBed_SidePart x 2
DIN_EN_ISO_934_M3 x 14
Y_Axis_BeltHolder
DIN_EN_ISO_7045M3x10 x 6
DIN_EN_ISO_7045M3x12 x 2
DIN_EN_ISO_7045M3x20 x 2
LineerBearingBlock_SC8UU x 4
DIN_EN_ISO_7045M4x16 x 16
BedLeveling_SpringCap x 8
BedLeveling_SpringD6H10 x 4
BedLeveling_ThumbWheel x 4
HeatPad_220x220
DIN_EN_ISO_7046-2-R1_M3x25 x 4
