YazgacResearch/3DPrinter/Drawings/3D_Printer_Rev_02/Y_Axis/Y_TensionSide/Y_TensionSide_Grp_Assem.SLDASM

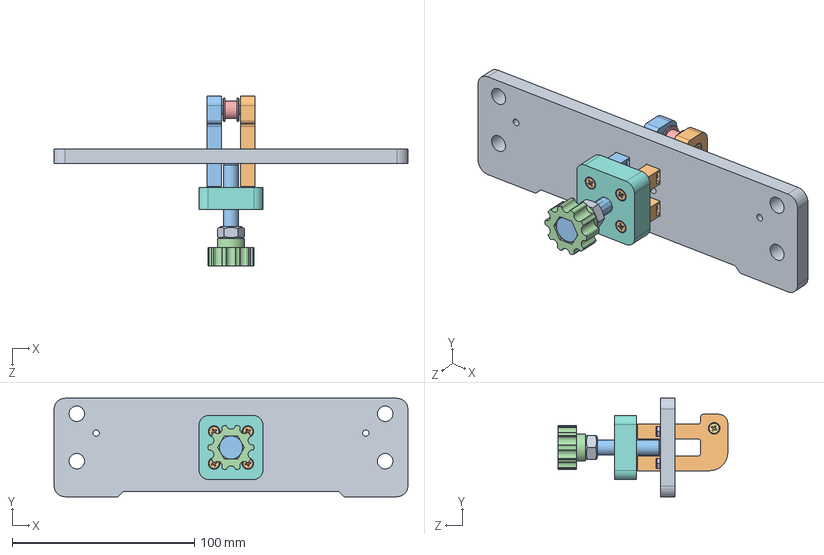
[picture p43: CAD file, 2021-01-05]
Drawings/3D_Printer_Rev_02/Y_Axis/Y_TensionSide/Y_TensionSide_Grp_Assem.SLDASM
194.0 x 54.0 x 93.0 mm
Y_Axis_TensionSide_Plate
Y_Axis_Tensioner_Right
Y_Axis_Tensioner_Left
bearing.step
outer_plate.step
DIN_EN_ISO_934_M3 x 5
DIN_EN_ISO_7046-2-R1_M3x25
Y_Axis_TensionPlate_M8
DIN_EN_ISO_934_M8 x 2
DIN_EN_ISO_7046-2-R1_M3x30 x 4
DIN_EN_ISO_933_M8x50
Y_Axis_TensionScrewCover_M8
