YazgacResearch/3DPrinter/Drawings/3D_Printer_Rev_02/Z_Axis/Z_Axis_LimitSwitch_Grp.SLDASM

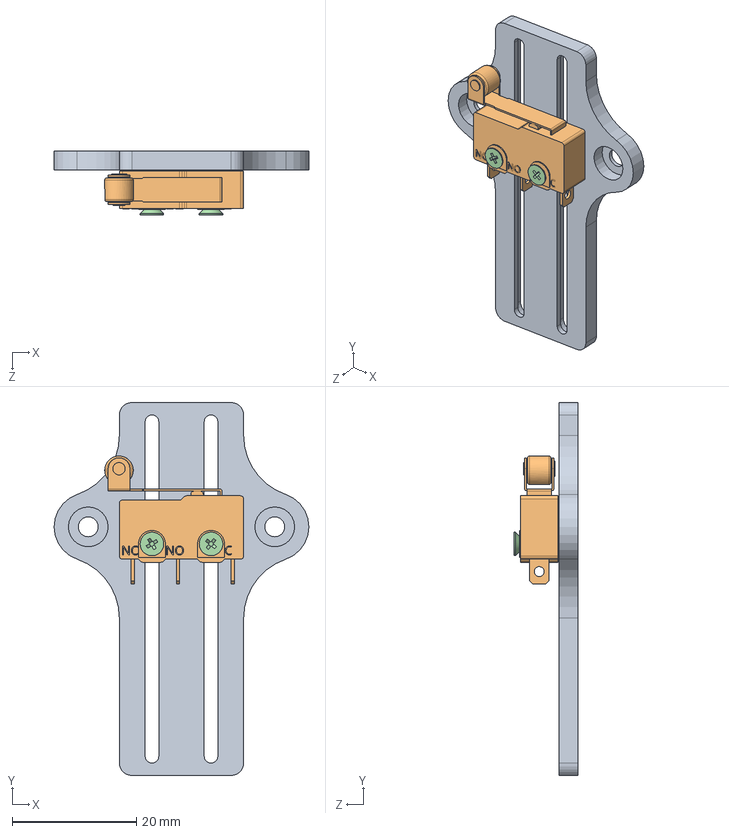
[picture p44: CAD file, 2021-01-05]
Drawings/3D_Printer_Rev_02/Z_Axis/Z_Axis_LimitSwitch_Grp.SLDASM
41.0 x 60.0 x 10.2 mm
Z_Axis_LimitSwitch_BasePlate
LimitSwitch_10T85(GSFY-10)
DIN_EN_ISO_934_M2 x 2
DIN_EN_ISO_7046-2-R1_M2x10 x 2
