YazgacResearch/3DPrinter/Drawings/3D_Printer_Rev_02/ZZ_Assembly_Documents/Solid_Assem_Doc/Soild_ExpView_Files/ExpView_Extruder_Grp_Assem.SLDASM

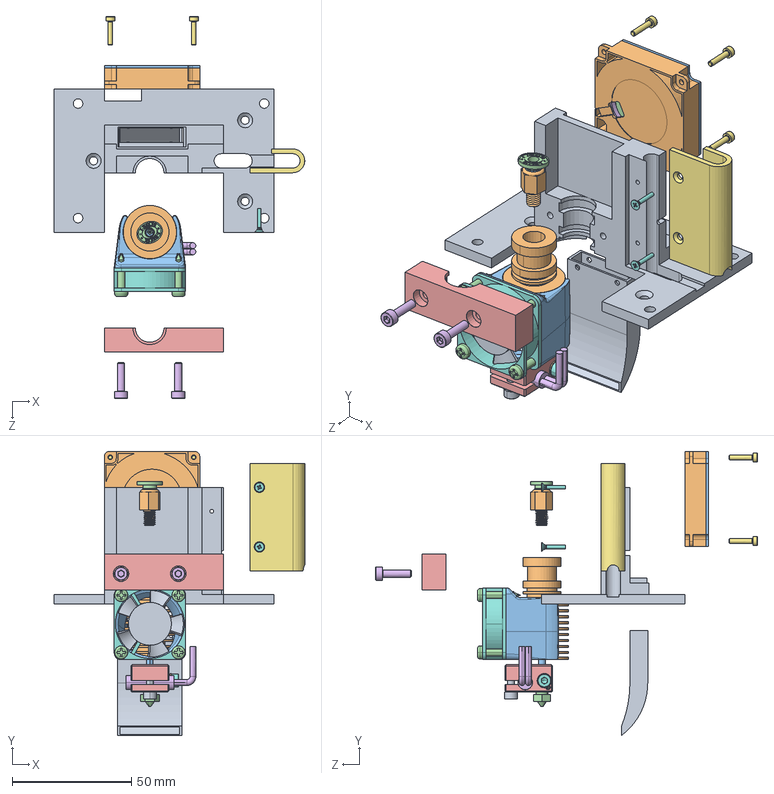
[picture p45: CAD file, 2021-01-05]
Drawings/3D_Printer_Rev_02/ZZ_Assembly_Documents/Solid_Assem_Doc/Soild_ExpView_Files/ExpView_Extruder_Grp_Assem.SLDASM
105.0 x 119.0 x 160.1 mm
Extruder_Frame_Main
base.iges
lid.iges
driver and stator.iges
rotor.iges
fan.iges
DIN_EN_ISO_912_M2x10 x 4
Fan-House-30x30x10-Promoco_Fan-House-KDE0503PFB3-Promoco.STEP
Fan-30x30x10-Promoco_Fan-KDE0503PFB3-Promoco.STEP
E3D v6 HotEnd - Heatsink.STEP
E3D v6 HotEnd - Heatbreak.STEP
E3D v6 HotEnd - Nozzle.STEP
E3D v6 HotEnd - Heat Block.STEP
Ceramic Cartridge Heater.STEP
Thermistor.STEP
HEXAGON SOCKET HEAD CAP SCREWS_SCB3-4.STEP
HEXAGON SOCKET HEAD CAP SCREWS_SCB3-10.STEP
Flat Washers_PWF3.STEP
E3D-v6 Fan Duct.STEP
Self Tapping Screws - Pan Head_CSPTRSA-SUS-TP3-16.STEP x 4
Extruder_Clamp_Main
DIN_EN_ISO_912_M3x12 x 2
Extruder_Cable_Clamp_Main
DIN_EN_ISO_7046-2-R1_M2x10 x 2
Extruder_Nozle_Main
Bronse fitting^Bowden_M8
Bushing^Bowden_M8
Push-In^Bowden_M8
