YazgacResearch/3DPrinter/Drawings/3D_Printer_Rev_02/ZZ_Extruding_Parts/Extruder_Ex/Ex_Extruder_Frame_Main.SLDPRT

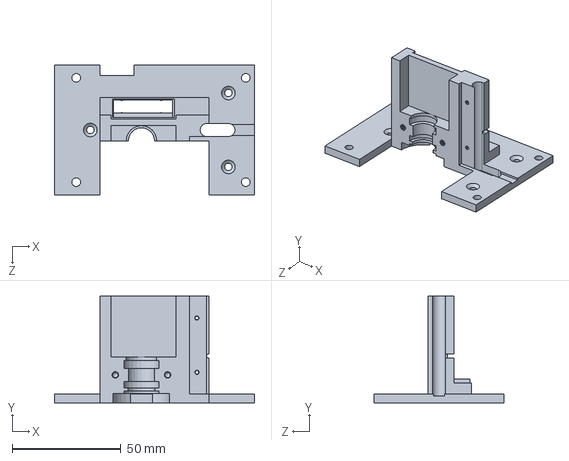
[picture p47: CAD file, 2021-01-05]
Drawings/3D_Printer_Rev_02/ZZ_Extruding_Parts/Extruder_Ex/Ex_Extruder_Frame_Main.SLDPRT
92.0 x 49.0 x 60.0 mm
