YazgacResearch/3DPrinter/Drawings/3D_Printer_Rev_02/ZZ_LaserCutting_Parts/LaserCutting_Assem_Plexi_8mm.SLDASM

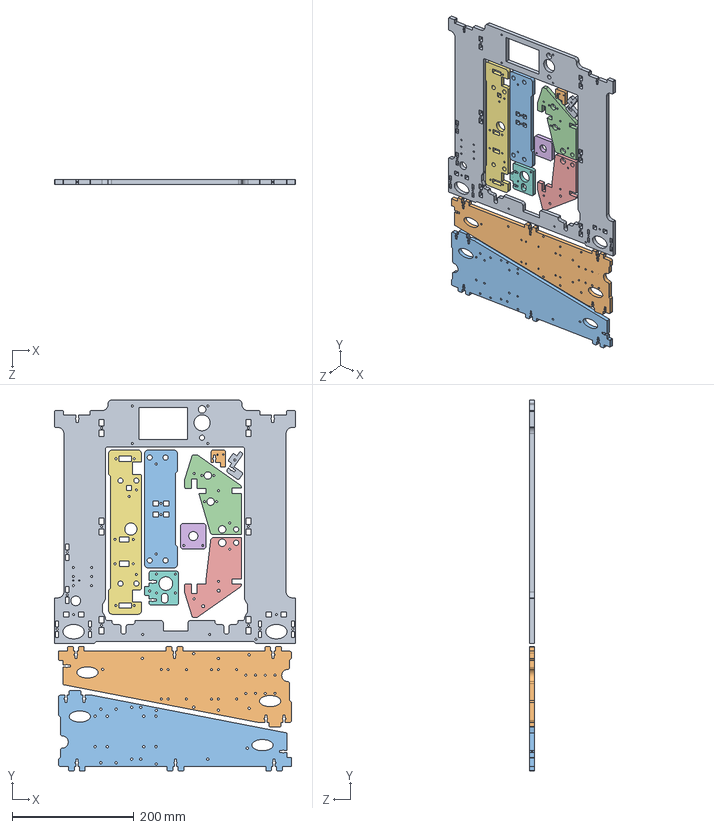
[picture p48: CAD file, 2021-01-05]
Drawings/3D_Printer_Rev_02/ZZ_LaserCutting_Parts/LaserCutting_Assem_Plexi_8mm.SLDASM
396.0 x 609.4 x 8.00 mm
MainFrame_FrontSide
MainFrame_BackLeftSide
MainFrame_BackRightSide
MainFrame_TopLeftSide
MainFrame_TopRightSide
Feeder_Cover_Mount
Y_Axis_DriveSide_Plate
Y_Axis_MotorPlate_01
Y_Axis_MotorPlate_02
Y_Axis_SensorPlate
Y_Axis_TensionSide_Plate
