YazgacResearch/3DPrinter/Drawings/3D_Printer_Rev_02/Electronics/LCD_Main_ElecCards_Grp_Assem.SLDASM

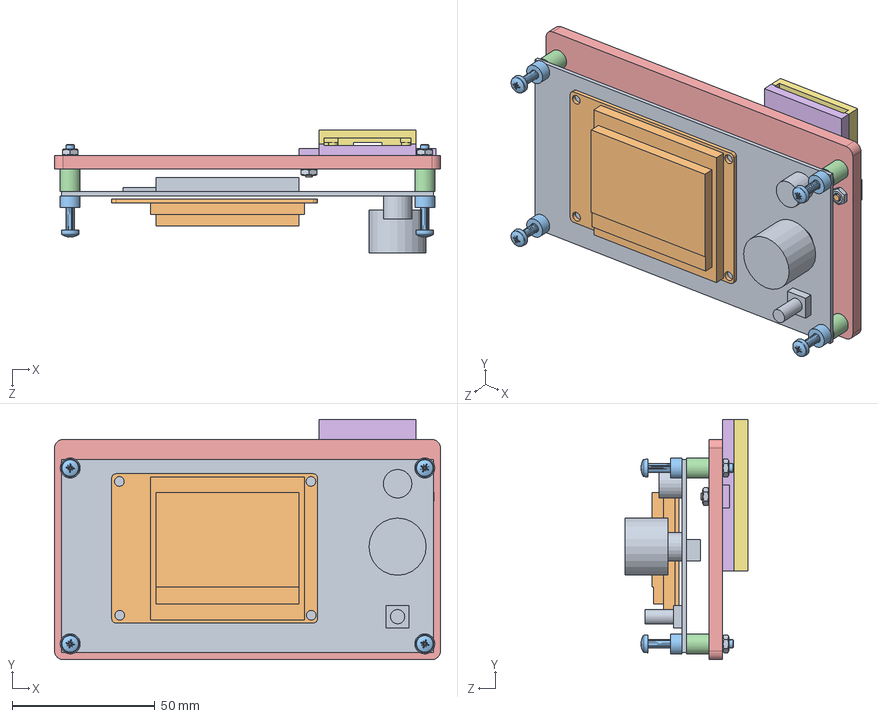
[picture p49: CAD file, 2021-01-05]
Drawings/3D_Printer_Rev_02/Electronics/LCD_Main_ElecCards_Grp_Assem.SLDASM
135.0 x 84.0 x 43.1 mm
LCDBottom_AnetA6
LCD_12864_RevA6
Spacer_D7H4 x 4
Spacer_D7H8 x 4
LCD_Support_PLK
SD_CardCase_Bottom
SD_CardCase_Top
DIN_EN_ISO_7046-2-R1_M2x5 x 2
DIN_EN_ISO_934_M3 x 6
DIN_EN_ISO_7046-2-R1_M3x10 x 2
DIN_EN_ISO_7045M3x30 x 4
