YazgacResearch/3DPrinter/Drawings/3D_Printer_Rev_02/Extruder_Grp/Extruder_Sub_Parts/Extruder_Cable_Clamp_Main.SLDPRT

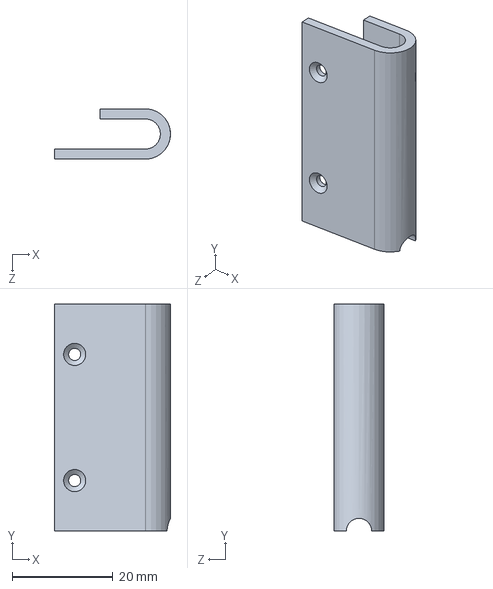
[picture p50: CAD file, 2021-01-05]
Drawings/3D_Printer_Rev_02/Extruder_Grp/Extruder_Sub_Parts/Extruder_Cable_Clamp_Main.SLDPRT
23.0 x 45.0 x 10.0 mm
