YazgacResearch/3DPrinter/Drawings/3D_Printer_Rev_02/MainFrame/MainFrame_Sub_Parts/MainFrame_FrontSide.SLDPRT

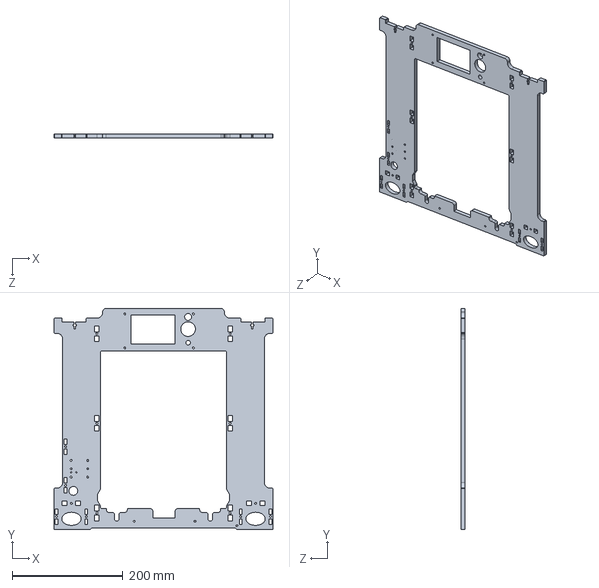
[picture p52: CAD file, 2021-01-05]
Drawings/3D_Printer_Rev_02/MainFrame/MainFrame_Sub_Parts/MainFrame_FrontSide.SLDPRT
396.0 x 400.0 x 8.00 mm
