YazgacResearch/3DPrinter/Drawings/3D_Printer_Rev_02/Ticari/Fan_BLDC_40x10/Fan_BLDC_40x10.SLDASM

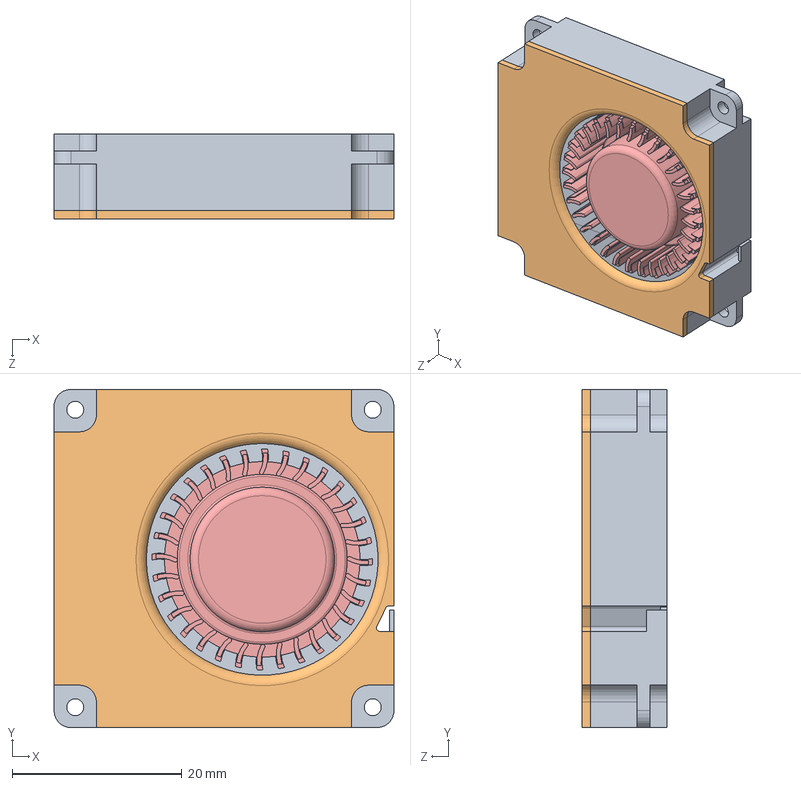
[picture p53: CAD file, 2021-01-05]
Drawings/3D_Printer_Rev_02/Ticari/Fan_BLDC_40x10/Fan_BLDC_40x10.SLDASM
40.0 x 39.8 x 10.0 mm
base.iges
lid.iges
driver and stator.iges
rotor.iges
fan.iges
