YazgacResearch/3DPrinter/Drawings/3D_Printer_Rev_02/X_Axis/X_Carriage/X_Carriage_Sub_Parts/Carriage_Main.SLDPRT

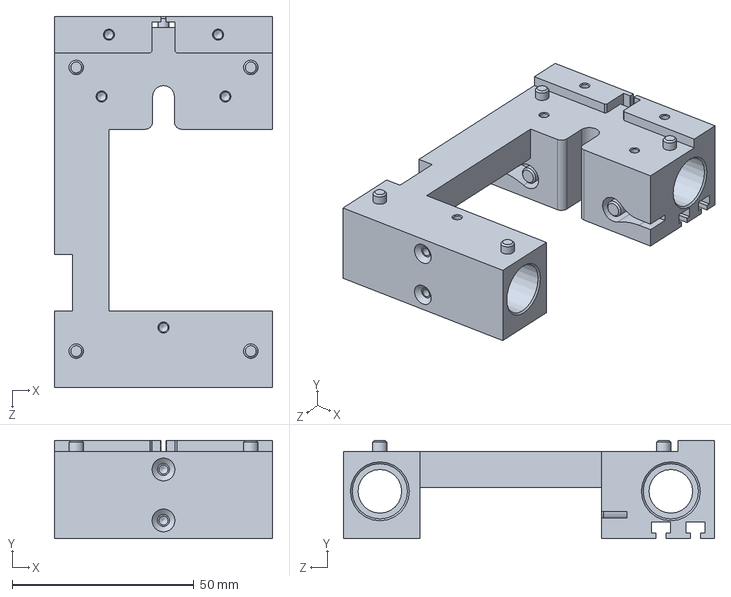
[picture p55: CAD file, 2021-01-05]
Drawings/3D_Printer_Rev_02/X_Axis/X_Carriage/X_Carriage_Sub_Parts/Carriage_Main.SLDPRT
60.0 x 27.0 x 102.0 mm
