YazgacResearch/3DPrinter/Drawings/3D_Printer_Rev_02/X_Axis/X_TensionSide/X_TensionSideGrp_Assem.SLDASM

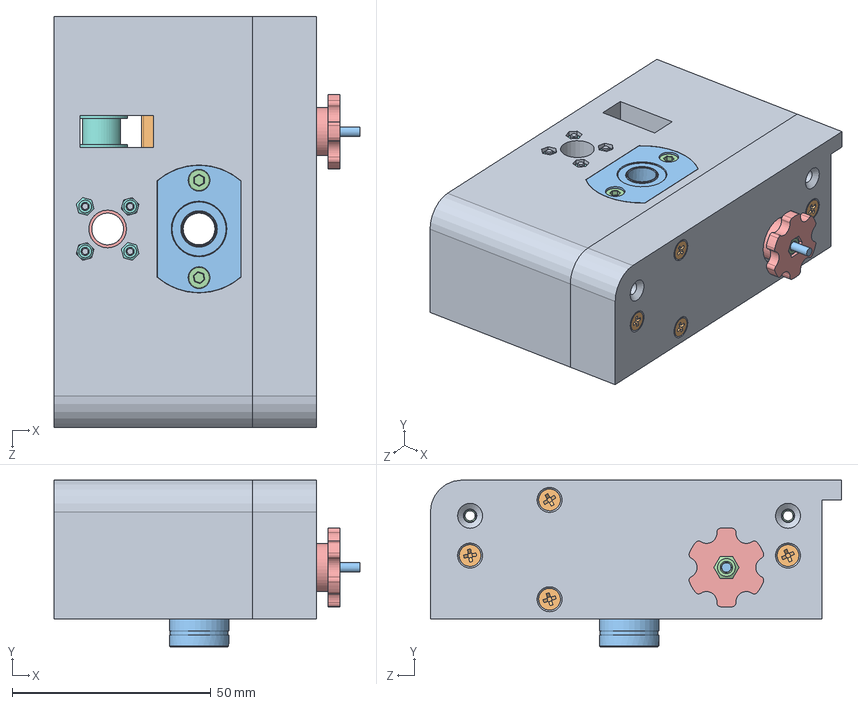
[picture p56: CAD file, 2021-01-05]
Drawings/3D_Printer_Rev_02/X_Axis/X_TensionSide/X_TensionSideGrp_Assem.SLDASM
77.0 x 42.0 x 103.5 mm
X_TensionSide_Block
X_Tensioner
DIN_EN_ISO_7046-2-R1_M3x55
DIN_EN_ISO_934_M3 x 11
X_TensionerScrewPart
DIN_EN_ISO_7046-2-R1_M3x15
bearing.step
outer_plate.step
X_TensionSide_Cap
DIN_EN_ISO_7046-2-R1_M3x35 x 4
LineerBearingFlange-LM8UU
DIN_EN_ISO_912_M3x30 x 2
nakretka tr08.stp
napinacz nakretki tr8.stp
sprezyna nakretka tr 8.stp
DIN_EN_ISO_934_M2 x 4
DIN_EN_ISO_912_M2x10 x 4
