YazgacResearch/3DPrinter/Drawings/3D_Printer_Rev_02/Z_Axis/Z_Axis_Grp_Right.SLDASM

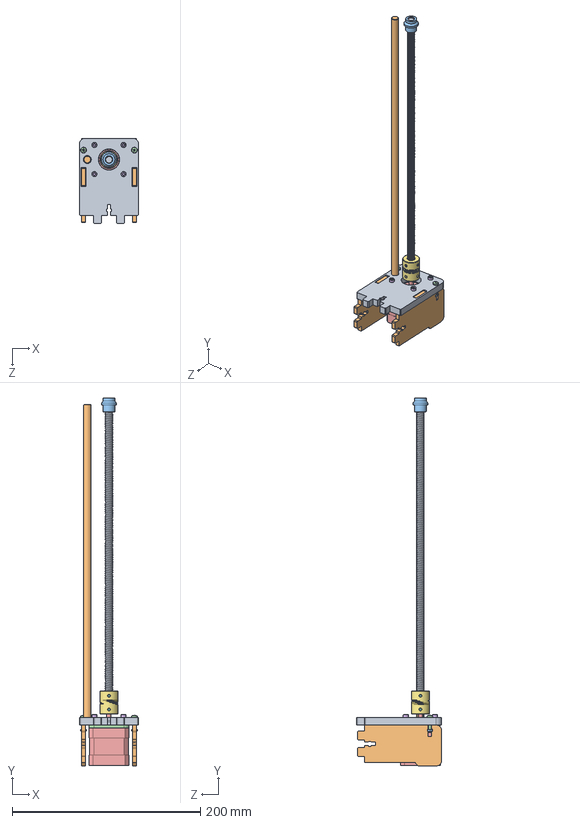
[picture p57: CAD file, 2021-01-05]
Drawings/3D_Printer_Rev_02/Z_Axis/Z_Axis_Grp_Right.SLDASM
63.0 x 390.5 x 90.5 mm
Z_Axis_FramePart_01_Right
Z_Axis_FramePart_02 x 2
DIN_EN_ISO_934_M3 x 2
Z_Axis_Motor_Plate
Step_motor_nema17_42x42x40mm
DIN_EN_ISO_912_M3x15 x 4
Coupling_5x8
DIN_EN_ISO_913_M3x5 x 4
LeadScrew_Trap_tr8_P2_318
GuideRod_340_Zax
Z_Axis_TopSide_ShaftGuide
DIN_EN_ISO_7045M3x16 x 2
