YazgacResearch/3DPrinter/Drawings/3D_Printer_Rev_02/ZZ_Assembly_Documents/Solid_Assem_Doc/Soild_ExpView_Files/ExpView_Z_Axis_Grp_Left.SLDASM

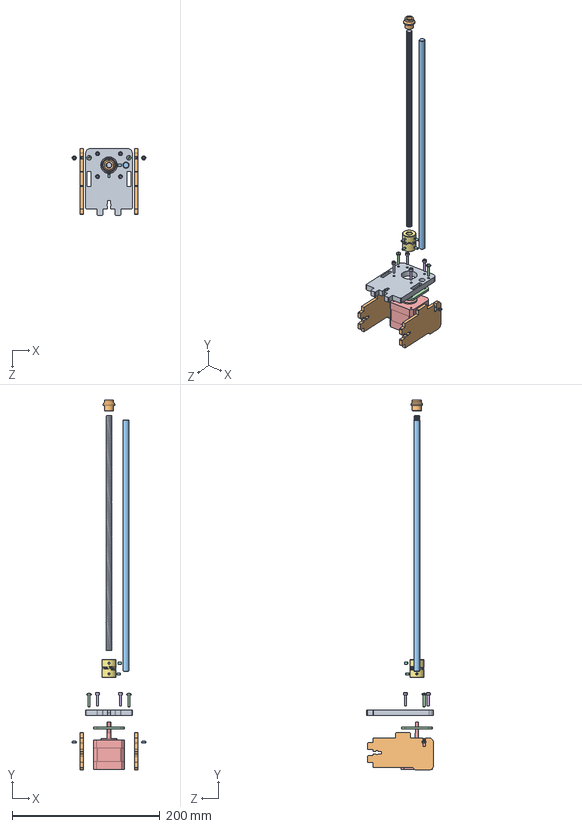
[picture p58: CAD file, 2021-01-05]
Drawings/3D_Printer_Rev_02/ZZ_Assembly_Documents/Solid_Assem_Doc/Soild_ExpView_Files/ExpView_Z_Axis_Grp_Left.SLDASM
100.4 x 500.5 x 90.5 mm
Z_Axis_FramePart_01_Left
Z_Axis_FramePart_02 x 2
DIN_EN_ISO_934_M3 x 2
Z_Axis_Motor_Plate
Step_motor_nema17_42x42x40mm
DIN_EN_ISO_912_M3x15 x 4
Coupling_5x8
DIN_EN_ISO_913_M3x5 x 4
LeadScrew_Trap_tr8_P2_318
Z_Axis_TopSide_ShaftGuide
GuideRod_340_Zax
DIN_EN_ISO_7045M3x16 x 2
