YazgacResearch/3DPrinter/Drawings/3D_Printer_Rev_02/ZZ_LaserCutting_Parts/LaserCutting_Assem_Al_3mm.SLDASM

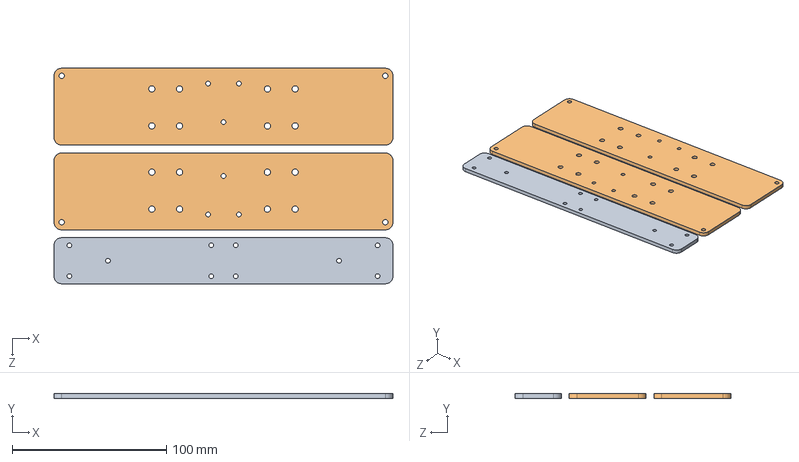
[picture p59: CAD file, 2021-01-05]
Drawings/3D_Printer_Rev_02/ZZ_LaserCutting_Parts/LaserCutting_Assem_Al_3mm.SLDASM
220.0 x 3.00 x 140.0 mm
HeatBed_CenterPart
HeatBed_SidePart x 2
