YazgacResearch/3DPrinter/Drawings/3D_Printer_Rev_02/Electronics/LCD_12864/LCD_12864_Controller_RevA6.SLDASM

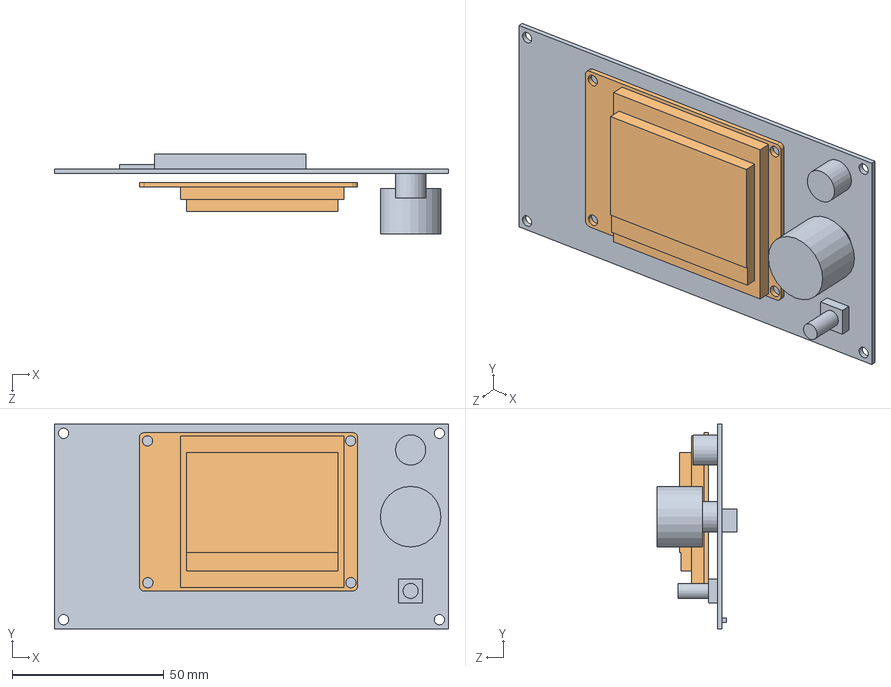
[picture p60: CAD file, 2021-01-05]
Drawings/3D_Printer_Rev_02/Electronics/LCD_12864/LCD_12864_Controller_RevA6.SLDASM
130.0 x 67.5 x 26.5 mm
LCDBottom_AnetA6
LCD_12864_RevA6
