YazgacResearch/3DPrinter/Drawings/3D_Printer_Rev_02/Electronics/PSU_Assem.SLDASM

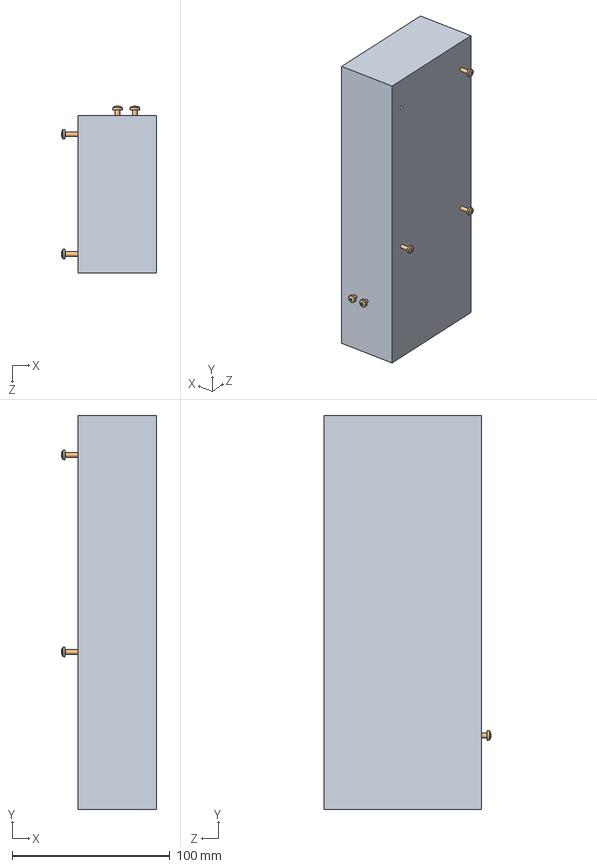
[picture p61: CAD file, 2021-01-05]
Drawings/3D_Printer_Rev_02/Electronics/PSU_Assem.SLDASM
60.4 x 250.0 x 105.9 mm
PSU_Jotta_S350-12V
DIN_EN_ISO_7045M3x10 x 5
