YazgacResearch/3DPrinter/Drawings/3D_Printer_Rev_02/MainFrame/MainFrame_Sub_Parts/MainFrame_BackRightSide.SLDPRT

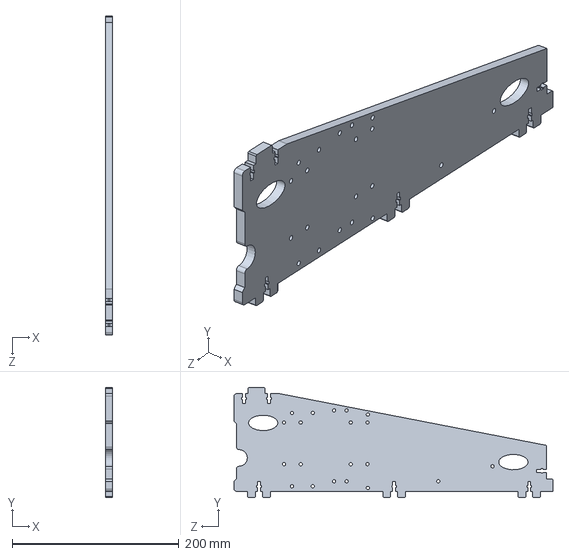
[picture p63: CAD file, 2021-01-05]
Drawings/3D_Printer_Rev_02/MainFrame/MainFrame_Sub_Parts/MainFrame_BackRightSide.SLDPRT
8.00 x 132.0 x 382.5 mm
