YazgacResearch/3DPrinter/Drawings/3D_Printer_Rev_02/ZZ_LaserCutting_Parts/LaserCutting_Assem_Plexi_4.6mm.SLDASM

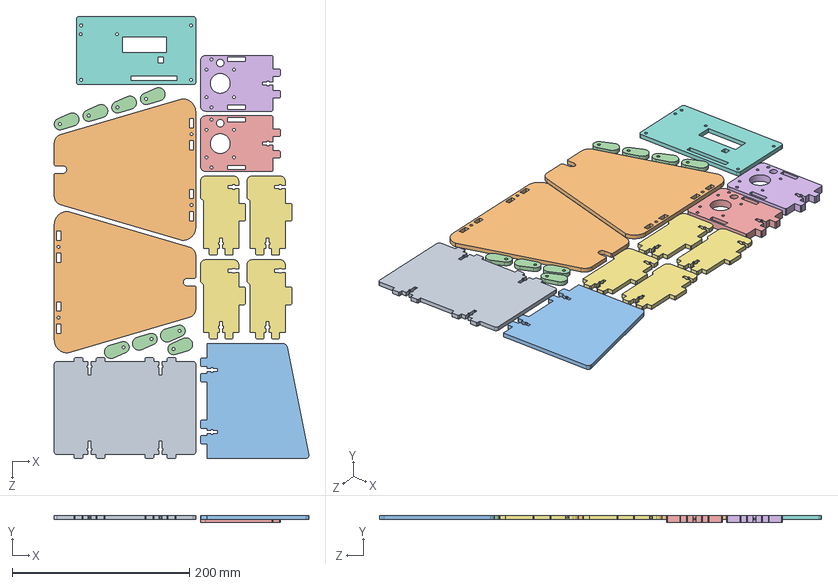
[picture p65: CAD file, 2021-01-05]
Drawings/3D_Printer_Rev_02/ZZ_LaserCutting_Parts/LaserCutting_Assem_Plexi_4.6mm.SLDASM
287.5 x 8.00 x 499.0 mm
SpoolHolder_BedPlate
SpoolHolder_SidePlate x 2
ECard_Cover_Plate
MainFrame_ShaftStoper x 8
Z_Axis_FramePart_01_Left
Z_Axis_FramePart_01_Right
Z_Axis_FramePart_02 x 4
LCD_Support_PLK
