YazgacResearch/3DPrinter/Drawings/3D_Printer_Rev_02/Electronics/PSU_Cover_Assem.SLDASM

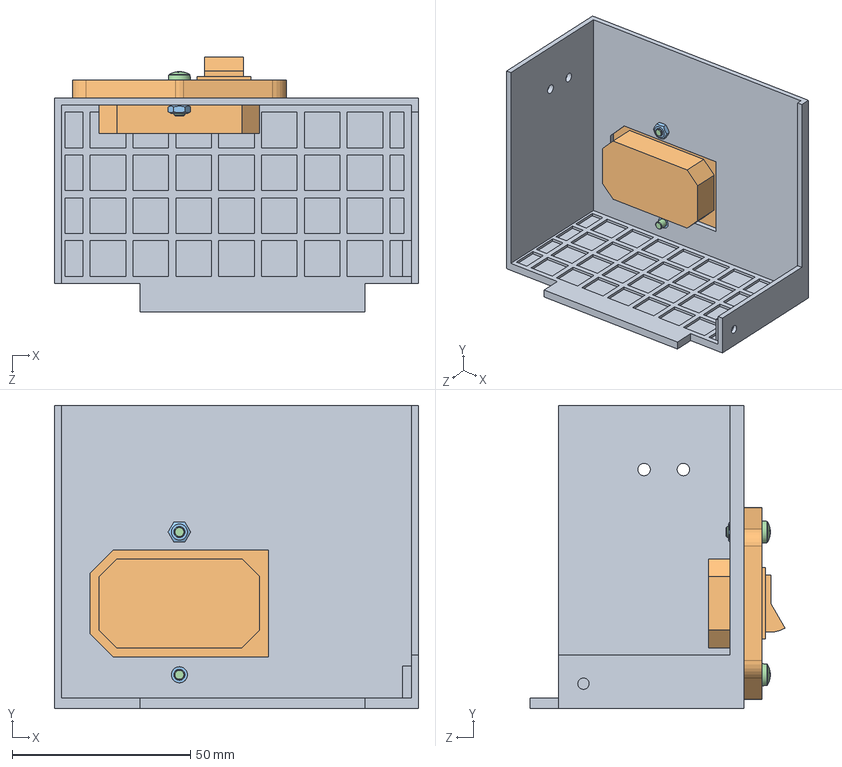
[picture p66: CAD file, 2021-01-05]
Drawings/3D_Printer_Rev_02/Electronics/PSU_Cover_Assem.SLDASM
102.0 x 85.0 x 71.5 mm
PSU_Cover
PSU_EnergySocket
DIN_EN_ISO_934_M3 x 2
DIN_EN_ISO_7045M3x10 x 2
