YazgacResearch/3DPrinter/Drawings/3D_Printer_Rev_02/MainFrame/MainFrame_Sub_Parts/MainFrame_ShaftStoper.SLDPRT

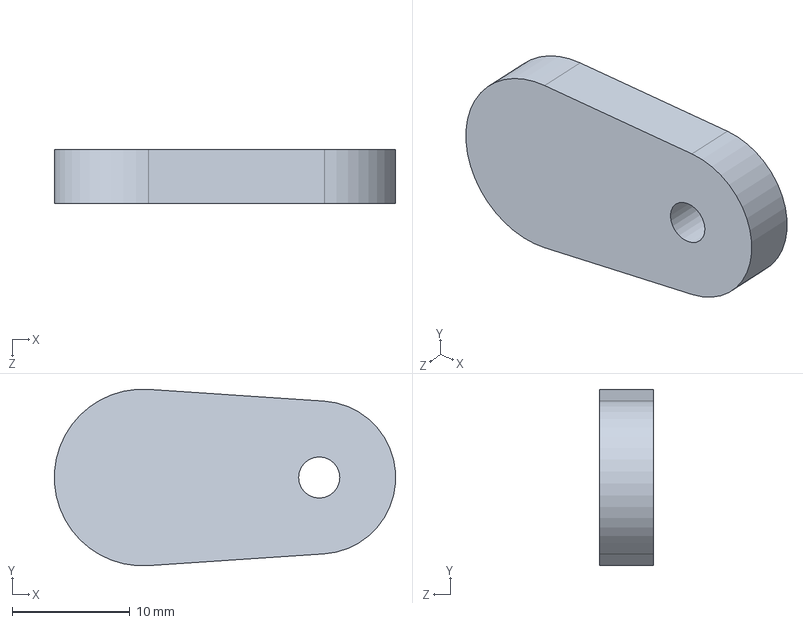
[picture p67: CAD file, 2021-01-05]
Drawings/3D_Printer_Rev_02/MainFrame/MainFrame_Sub_Parts/MainFrame_ShaftStoper.SLDPRT
29.0 x 15.0 x 4.60 mm
