YazgacResearch/3DPrinter/Drawings/3D_Printer_Rev_02/ZZ_Assembly_Documents/Solid_Assem_Doc/Soild_ExpView_Files/ExpView_MainFrame_Grp_Assem.SLDASM

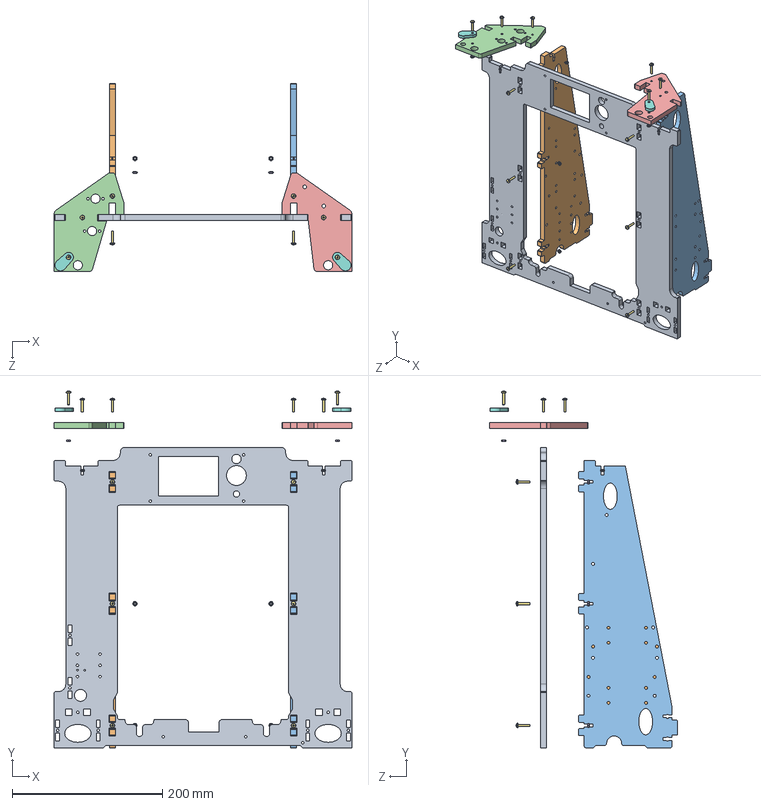
[picture p68: CAD file, 2021-01-05]
Drawings/3D_Printer_Rev_02/ZZ_Assembly_Documents/Solid_Assem_Doc/Soild_ExpView_Files/ExpView_MainFrame_Grp_Assem.SLDASM
396.0 x 475.0 x 250.5 mm
MainFrame_FrontSide
MainFrame_BackLeftSide
MainFrame_BackRightSide
MainFrame_TopLeftSide
MainFrame_TopRightSide
DIN_EN_ISO_934_M3 x 12
DIN_EN_ISO_7045M3x16 x 12
MainFrame_ShaftStoper x 2
