YazgacResearch/3DPrinter/Drawings/3D_Printer_Rev_02/MainFrame/MainFrame_Sub_Parts/MainFrame_TopLeftSide.SLDPRT

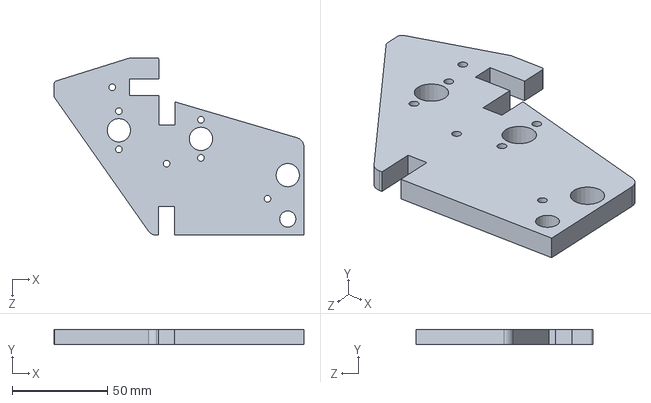
[picture p69: CAD file, 2021-01-05]
Drawings/3D_Printer_Rev_02/MainFrame/MainFrame_Sub_Parts/MainFrame_TopLeftSide.SLDPRT
131.0 x 8.00 x 93.0 mm
