YazgacResearch/3DPrinter/Drawings/3D_Printer_Rev_02/ZZ_Assembly_Documents/Solid_Assem_Doc/Soild_ExpView_Files/ExpView_Y_DriveSide_Grp_Assem.SLDASM

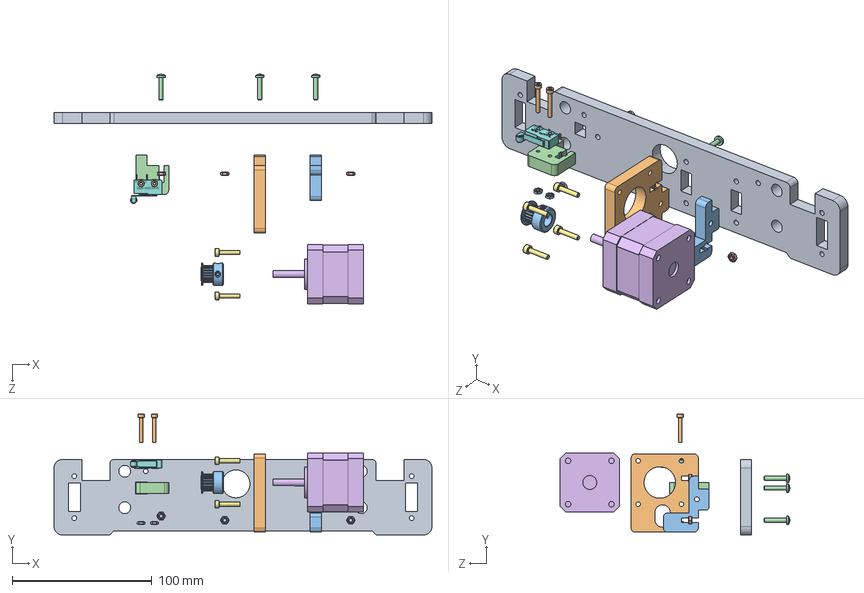
[picture p71: CAD file, 2021-01-05]
Drawings/3D_Printer_Rev_02/ZZ_Assembly_Documents/Solid_Assem_Doc/Soild_ExpView_Files/ExpView_Y_DriveSide_Grp_Assem.SLDASM
270.0 x 86.4 x 164.0 mm
Y_Axis_DriveSide_Plate
Y_Axis_MotorPlate_01
Y_Axis_MotorPlate_02
Y_Axis_SensorPlate
DIN_EN_ISO_934_M3 x 4
Step_motor_nema17_42x42x40mm
DIN_EN_ISO_912_M3x15 x 4
LimitSwitch_10T85(GSFY-10)
DIN_EN_ISO_934_M2.5 x 2
DIN_EN_ISO_912_M2.5x18 x 2
Pulley_GT2_20T
DIN_EN_ISO_7045M3x16 x 4
