YazgacResearch/3DPrinter/Drawings/3D_Printer_Rev_02/Electronics/Electronics_Sub_Parts/SD_CardCase_Assem.SLDASM

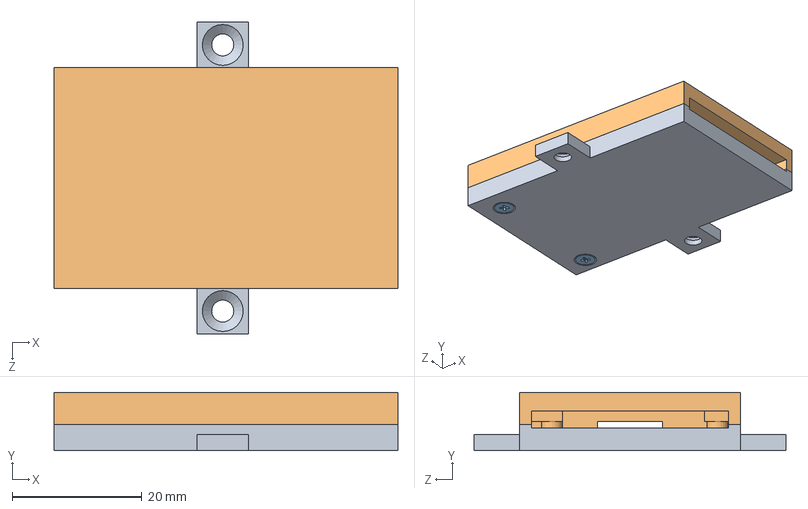
[picture p73: CAD file, 2021-01-05]
Drawings/3D_Printer_Rev_02/Electronics/Electronics_Sub_Parts/SD_CardCase_Assem.SLDASM
53.0 x 9.00 x 48.0 mm
SD_CardCase_Bottom
SD_CardCase_Top
DIN_EN_ISO_7046-2-R1_M2x5 x 2
