YazgacResearch/3DPrinter/Drawings/3D_Printer_Rev_02/ZZ_Assembly_Documents/Solid_Assem_Doc/Soild_ExpView_Files/ExpView_Feeder_Grp_Assem.SLDASM

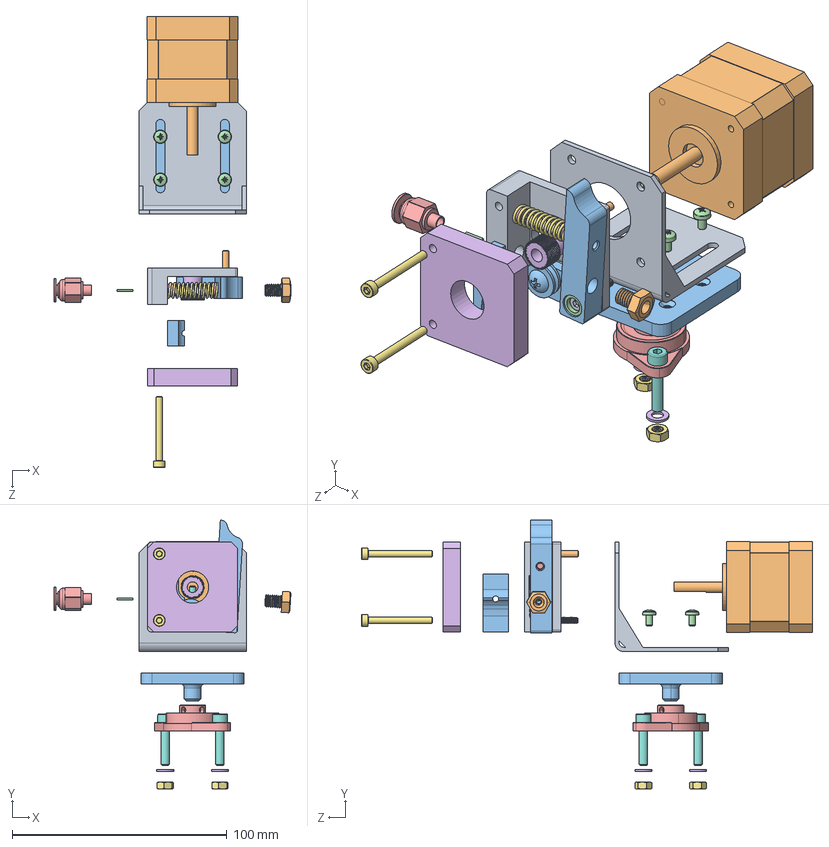
[picture p74: CAD file, 2021-01-05]
Drawings/3D_Printer_Rev_02/ZZ_Assembly_Documents/Solid_Assem_Doc/Soild_ExpView_Files/ExpView_Feeder_Grp_Assem.SLDASM
110.3 x 125.3 x 210.0 mm
Angle_Mounting_Bracket_Nema17
Step_motor_nema17_42x42x40mm
Remote_Extrueder_Motor_Mount
DIN_EN_ISO_7045M3x5 x 4
Bearing_House_KFL08
DIN125_EN_ISO_7089_M4 x 2
DIN_EN_ISO_4032_M4 x 2
DIN_EN_ISO_912_M4x20 x 2
MK8_Ext_01
DIN_EN_ISO_7045_M3x10
MK8_Ext_02
MK8_Ext_03
DIN_EN_ISO_912M3x5 x 2
MK8_Ext_04
Spring_1x25
DIN_EN_ISO_913M3x5
DIN_EN_ISO_912M3x20
Filament_Input_Guide_M6x1.75x7.8
Filament_Output_Guide
Filament_Output_Guide_M6x0.96x7.5
Bowden_M6x4
Feeder_Cover_Mount
DIN_EN_ISO_912_M3x30 x 2
