YazgacResearch/3DPrinter/Drawings/3D_Printer_Rev_02/ZZ_Assembly_Documents/Solid_Assem_Doc/Soild_ExpView_Files/ExpView_SpoolHolder_Assem.SLDASM

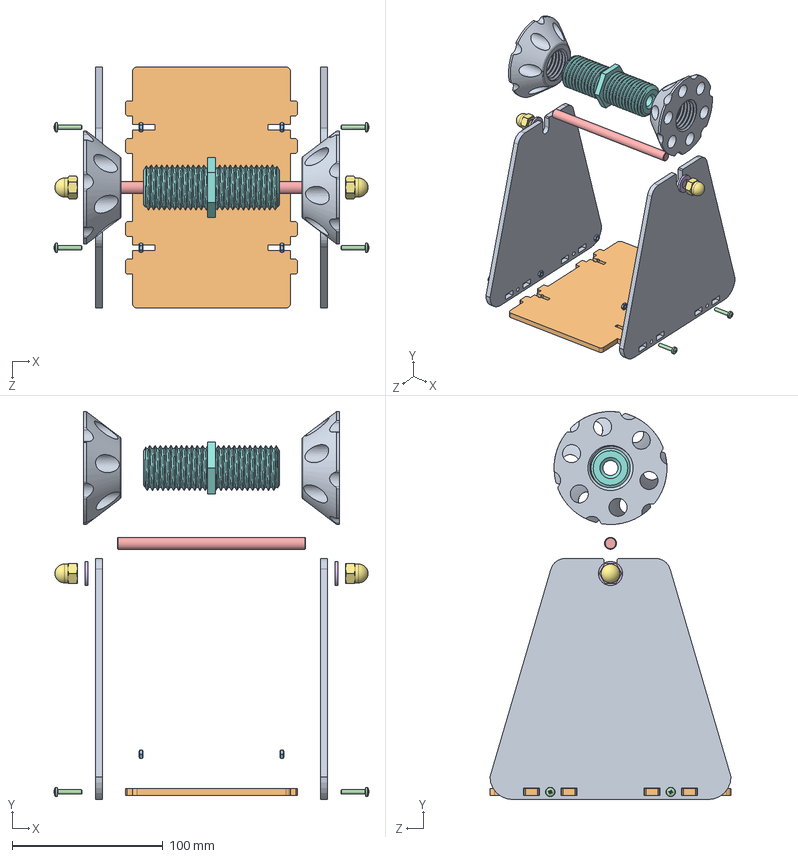
[picture p76: CAD file, 2021-01-05]
Drawings/3D_Printer_Rev_02/ZZ_Assembly_Documents/Solid_Assem_Doc/Soild_ExpView_Files/ExpView_SpoolHolder_Assem.SLDASM
208.9 x 257.5 x 160.0 mm
SpoolHolder_SidePlate x 2
SpoolHolder_BedPlate
DIN_EN_ISO_934_M3 x 4
DIN_EN_ISO_7045M3x16 x 4
Rod_M8x125
DIN_EN_ISO_125A_M8 x 2
DIN_EN_ISO_1587_M8 x 2
SpoolHolder_Shaft_M30
SpoolHolder_Knob_M30 x 2
