YazgacResearch/3DPrinter/Drawings/3D_Printer_Rev_02/Ticari/MK8 EXTRUDER RIGHT/Mk8_Ext_Main_Right.SLDASM

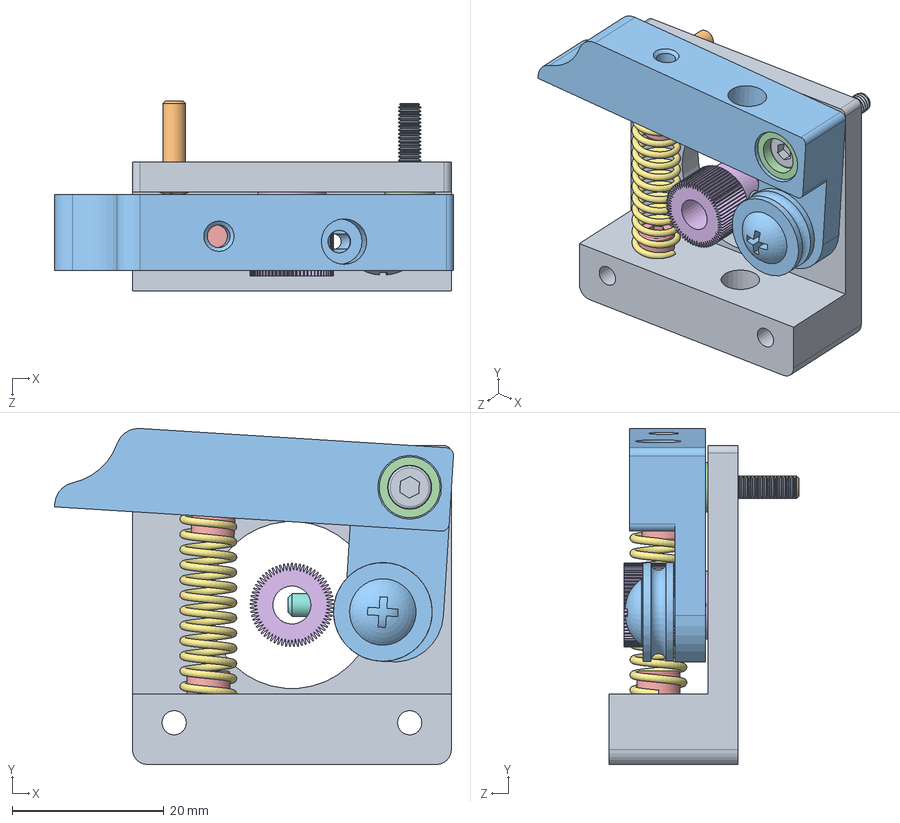
[picture p78: CAD file, 2021-01-05]
Drawings/3D_Printer_Rev_02/Ticari/MK8 EXTRUDER RIGHT/Mk8_Ext_Main_Right.SLDASM
52.5 x 44.2 x 25.0 mm
MK8_Ext_01
DIN_EN_ISO_7045_M3x10
MK8_Ext_02
MK8_Ext_03
DIN_EN_ISO_912M3x5 x 2
MK8_Ext_04
Spring_1x25
DIN_EN_ISO_913M3x5
DIN_EN_ISO_912M3x20
