YazgacResearch/3DPrinter/Drawings/3D_Printer_Rev_02/Electronics/Arduino_lm-2596/LM2596.step

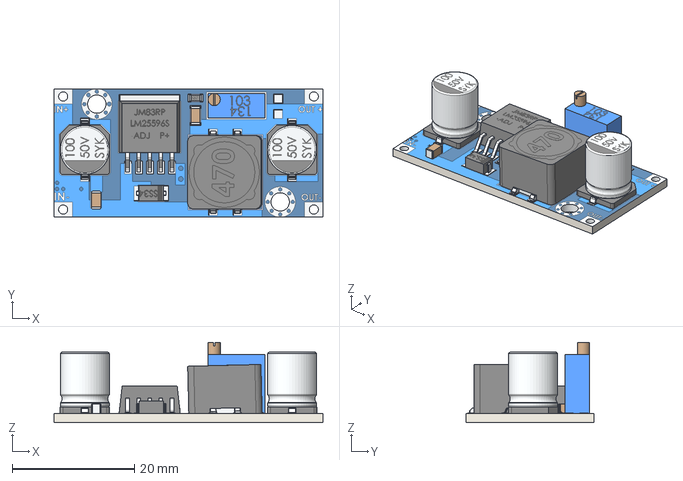
[picture p79: CAD file, 2021-01-05]
Drawings/3D_Printer_Rev_02/Electronics/Arduino_lm-2596/LM2596.step
44.0 x 21.0 x 13.1 mm
