YazgacResearch/3DPrinter/Drawings/3D_Printer_Rev_02/Electronics/Electronics_Sub_Parts/SD_Card_Case/SD_CardCase_Top.SLDPRT

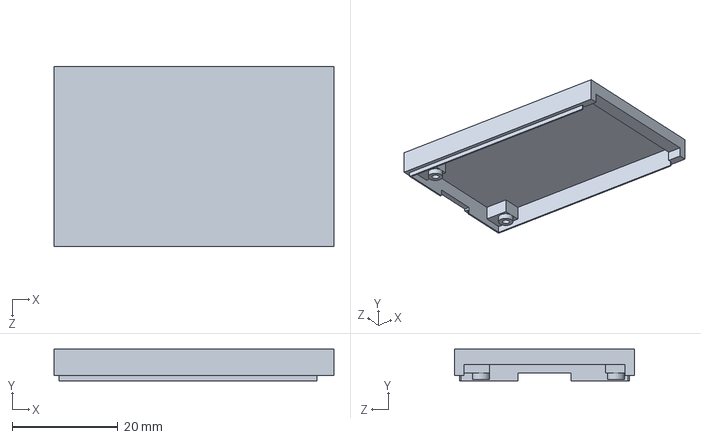
[picture p80: CAD file, 2021-01-05]
Drawings/3D_Printer_Rev_02/Electronics/Electronics_Sub_Parts/SD_Card_Case/SD_CardCase_Top.SLDPRT
53.0 x 6.00 x 34.0 mm
