YazgacResearch/3DPrinter/Drawings/3D_Printer_Rev_02/Electronics/Electronics_Sub_Parts/Spacer_D7H11.SLDPRT

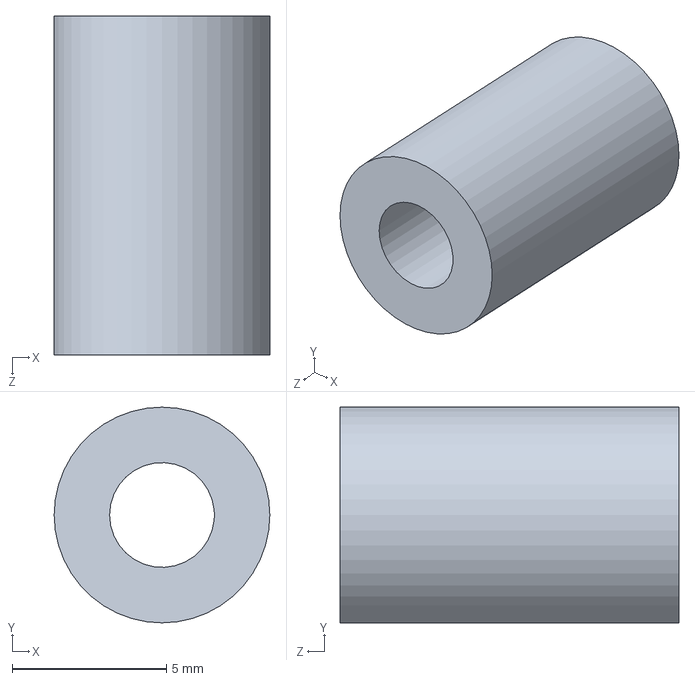
[picture p81: CAD file, 2021-01-05]
Drawings/3D_Printer_Rev_02/Electronics/Electronics_Sub_Parts/Spacer_D7H11.SLDPRT
7.00 x 7.00 x 11.0 mm
