YazgacResearch/3DPrinter/Drawings/3D_Printer_Rev_02/Electronics/LCD_12864/LCDBottom_AnetA6.SLDPRT

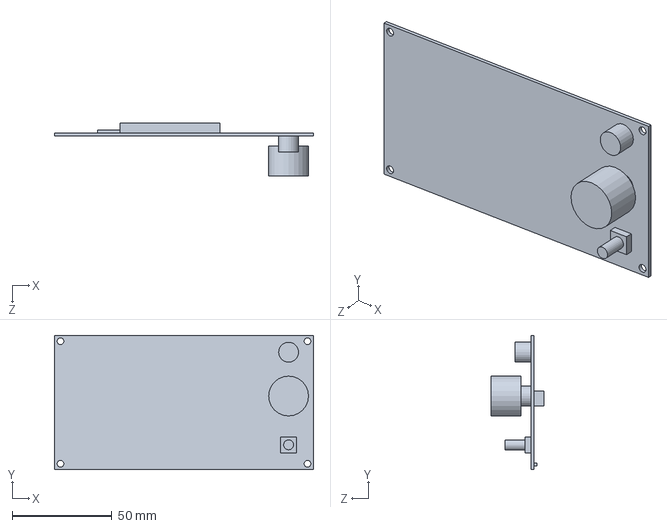
[picture p82: CAD file, 2021-01-05]
Drawings/3D_Printer_Rev_02/Electronics/LCD_12864/LCDBottom_AnetA6.SLDPRT
130.0 x 67.5 x 26.5 mm
