YazgacResearch/3DPrinter/Drawings/3D_Printer_Rev_02/Electronics/PSU_S350-12/PSU_Jotta_S350-12V.SLDPRT

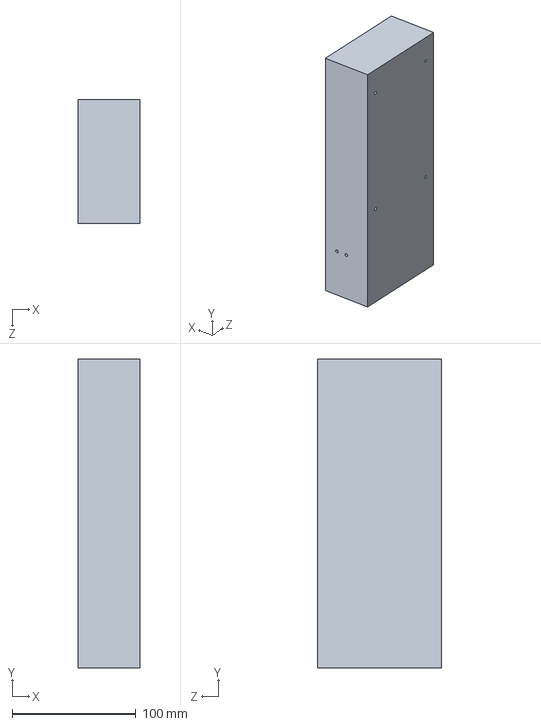
[picture p83: CAD file, 2021-01-05]
Drawings/3D_Printer_Rev_02/Electronics/PSU_S350-12/PSU_Jotta_S350-12V.SLDPRT
50.0 x 250.0 x 100.0 mm
