YazgacResearch/3DPrinter/Drawings/3D_Printer_Rev_02/Feeder_Grp/Feeder_Sub_Parts/Filament_Input_Guide_M6x1.75x7.8.SLDPRT

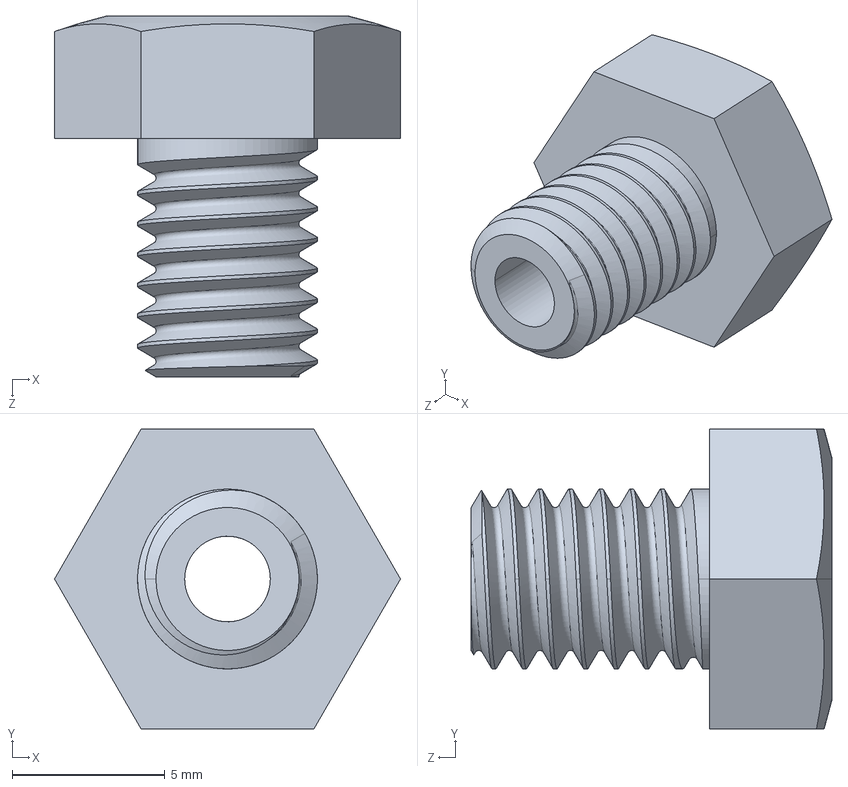
[picture p84: CAD file, 2021-01-05]
Drawings/3D_Printer_Rev_02/Feeder_Grp/Feeder_Sub_Parts/Filament_Input_Guide_M6x1.75x7.8.SLDPRT
11.3 x 9.80 x 11.8 mm
