YazgacResearch/3DPrinter/Drawings/3D_Printer_Rev_02/Hirdavat/DIN_EN_ISO_7045_M3x6.SLDPRT

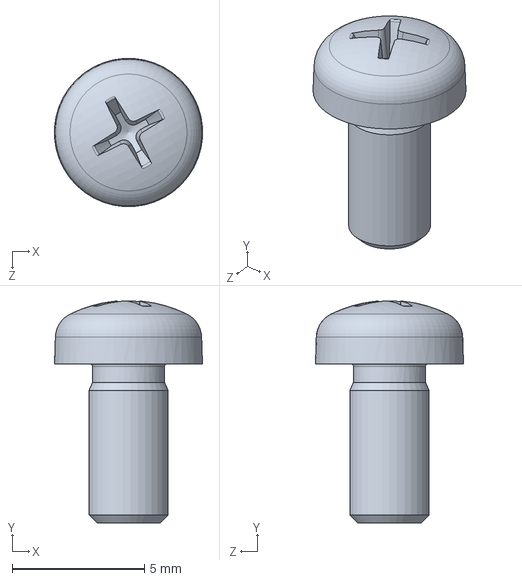
[picture p85: CAD file, 2021-01-05]
Drawings/3D_Printer_Rev_02/Hirdavat/DIN_EN_ISO_7045_M3x6.SLDPRT
5.59 x 8.38 x 5.59 mm
