YazgacResearch/3DPrinter/Drawings/3D_Printer_Rev_02/Spool_Holder/SpoolHolder_Sub_Parts/SpoolHolder_BedPlate.SLDPRT

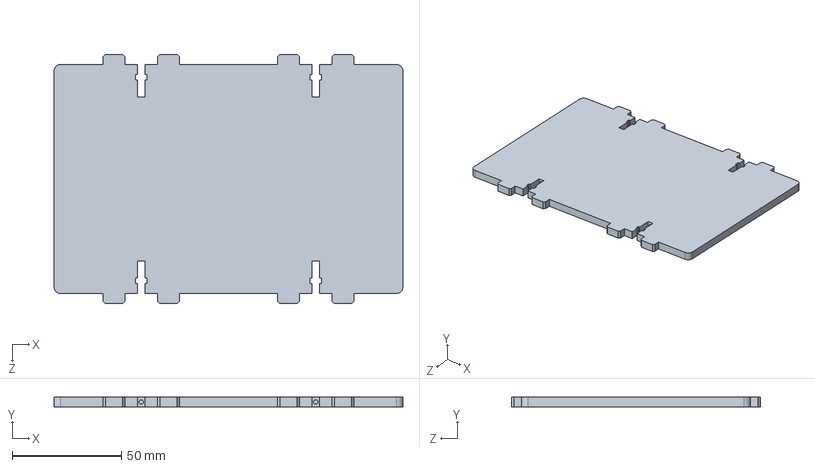
[picture p86: CAD file, 2021-01-05]
Drawings/3D_Printer_Rev_02/Spool_Holder/SpoolHolder_Sub_Parts/SpoolHolder_BedPlate.SLDPRT
160.0 x 4.60 x 114.0 mm
