YazgacResearch/3DPrinter/Drawings/3D_Printer_Rev_02/Ticari/GT2 Pulley 3mm bore/GT2 Pulley 3mm bore v8.step

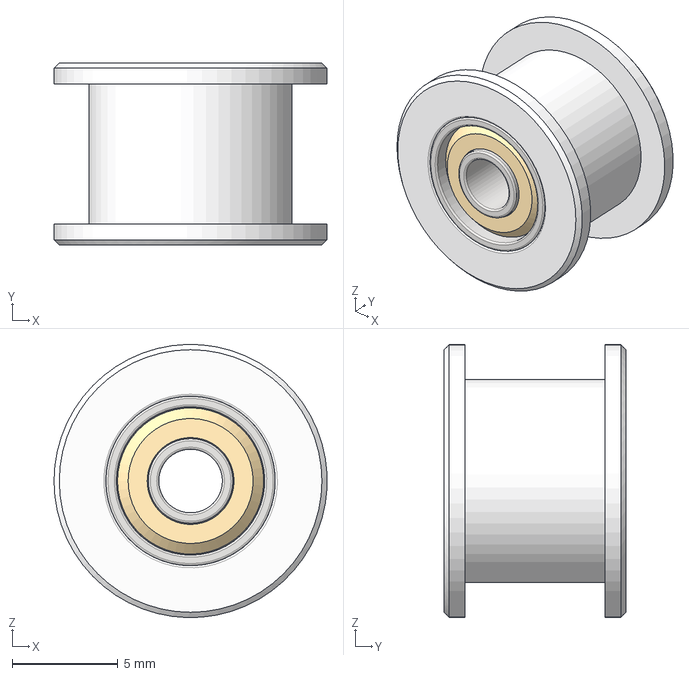
[picture p87: CAD file, 2021-01-05]
Drawings/3D_Printer_Rev_02/Ticari/GT2 Pulley 3mm bore/GT2 Pulley 3mm bore v8.step
12.9 x 8.60 x 12.9 mm
bearing
outer_plate
