YazgacResearch/3DPrinter/Drawings/3D_Printer_Rev_02/Ticari/KFL08_Yatak/KFL08.stp

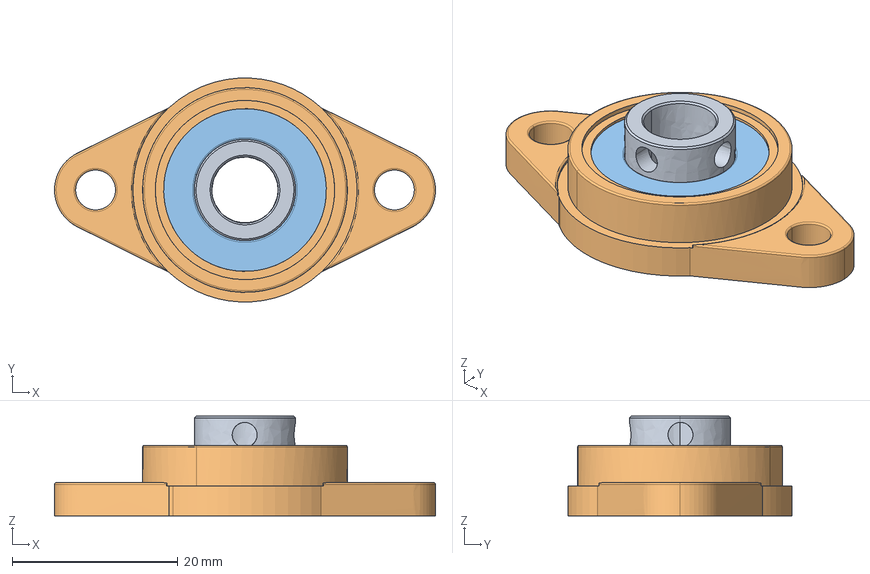
[picture p88: CAD file, 2021-01-05]
Drawings/3D_Printer_Rev_02/Ticari/KFL08_Yatak/KFL08.stp
45.9 x 27.0 x 12.0 mm
