YazgacResearch/3DPrinter/Drawings/3D_Printer_Rev_02/Ticari/LimitSwitch_10T85(GSFY-10).SLDPRT

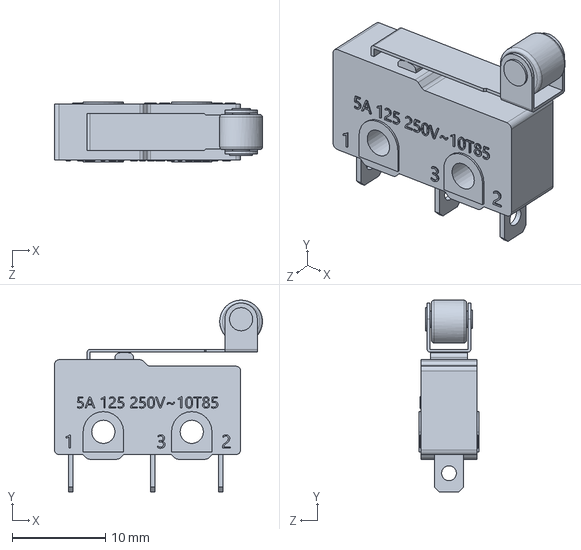
[picture p89: CAD file, 2021-01-05]
Drawings/3D_Printer_Rev_02/Ticari/LimitSwitch_10T85(GSFY-10).SLDPRT
22.4 x 20.6 x 6.40 mm
