YazgacResearch/3DPrinter/Drawings/3D_Printer_Rev_02/Ticari/MK8 EXTRUDER RIGHT/MK8 EXTRUDER RIGHT.stp

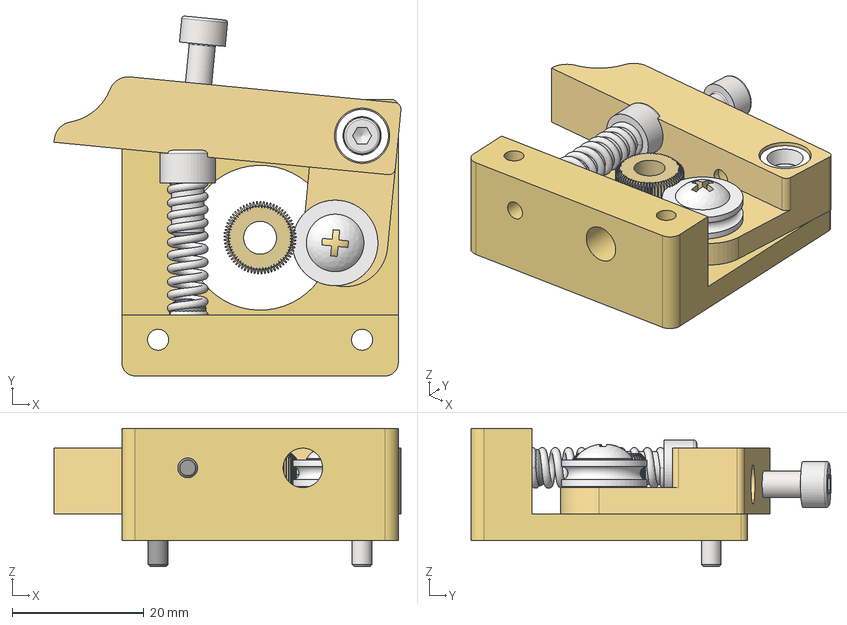
[picture p90: CAD file, 2021-01-05]
Drawings/3D_Printer_Rev_02/Ticari/MK8 EXTRUDER RIGHT/MK8 EXTRUDER RIGHT.stp
52.7 x 54.7 x 21.0 mm
mk8 1
mk8 2
banh rang nhua
bac xoay mk8
loxo mk8
DIN 912 - M5 x 8
DIN 912 - M4 x 20
DIN 912 - M3 x 12
ISO 7045 - M3 x 6 - 4.8 - H x 2
