YazgacResearch/3DPrinter/Drawings/3D_Printer_Rev_02/X_Axis/X_Carriage/X_Carriage_Sub_Parts/Carriage_Cable_Clamp.SLDPRT

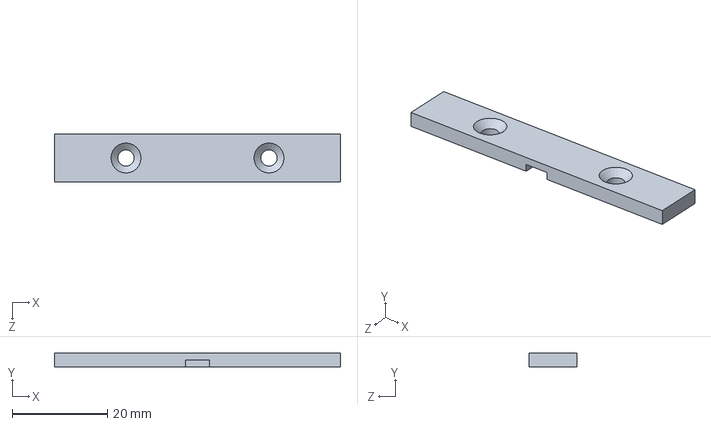
[picture p91: CAD file, 2021-01-05]
Drawings/3D_Printer_Rev_02/X_Axis/X_Carriage/X_Carriage_Sub_Parts/Carriage_Cable_Clamp.SLDPRT
60.0 x 3.00 x 10.0 mm
