YazgacResearch/3DPrinter/Drawings/3D_Printer_Rev_02/X_Axis/X_DriverSide/X_DriverSide_Sub_Parts/X_DriverSide_Block.SLDPRT

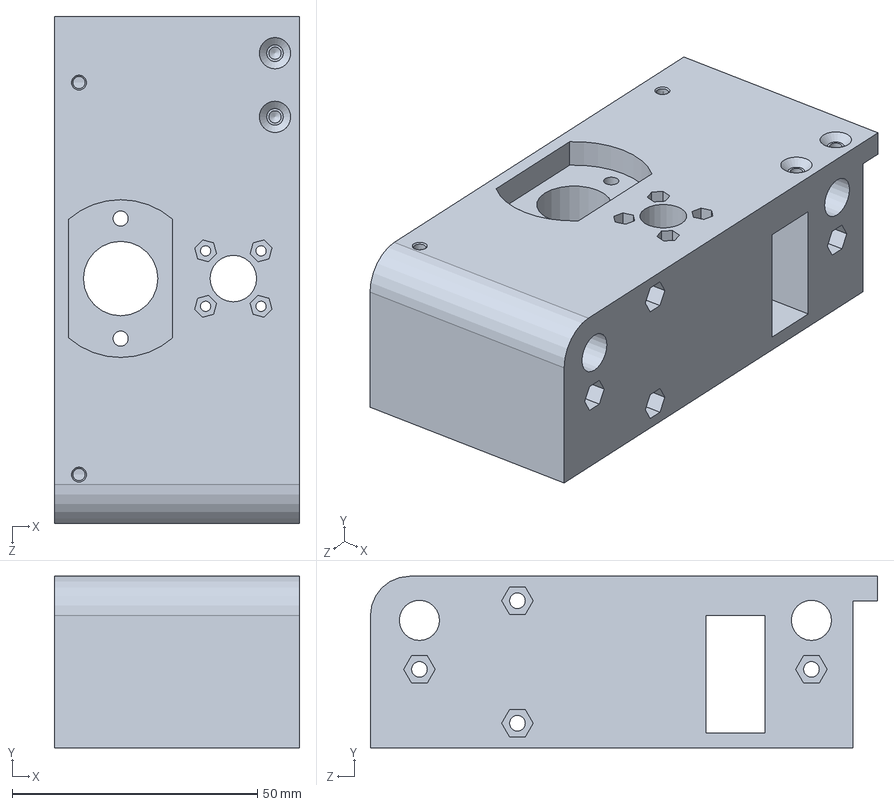
[picture p92: CAD file, 2021-01-05]
Drawings/3D_Printer_Rev_02/X_Axis/X_DriverSide/X_DriverSide_Sub_Parts/X_DriverSide_Block.SLDPRT
50.0 x 35.0 x 103.5 mm
