YazgacResearch/3DPrinter/Drawings/3D_Printer_Rev_02/Y_Axis/Y_Carriage/Y_Carriage_Sub_Parts/BedLeveling_SpringCap.SLDPRT

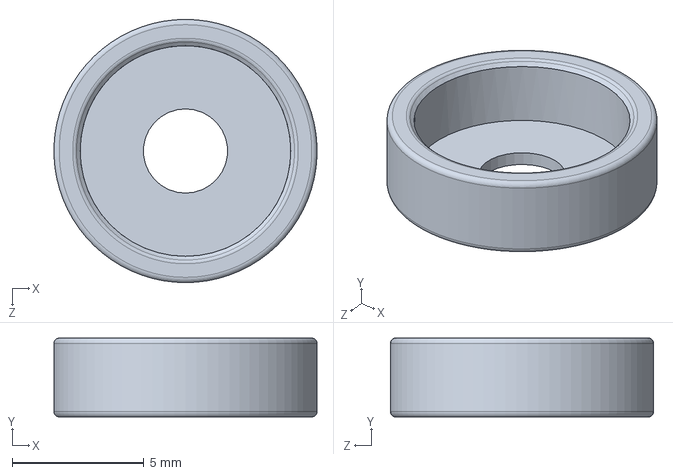
[picture p93: CAD file, 2021-01-05]
Drawings/3D_Printer_Rev_02/Y_Axis/Y_Carriage/Y_Carriage_Sub_Parts/BedLeveling_SpringCap.SLDPRT
9.99 x 3.00 x 10.0 mm
