YazgacResearch/3DPrinter/Drawings/3D_Printer_Rev_02/Y_Axis/Y_DriveSide/Y_DriveSide_Sub_Parts/Y_Axis_MotorPlate_01.SLDPRT

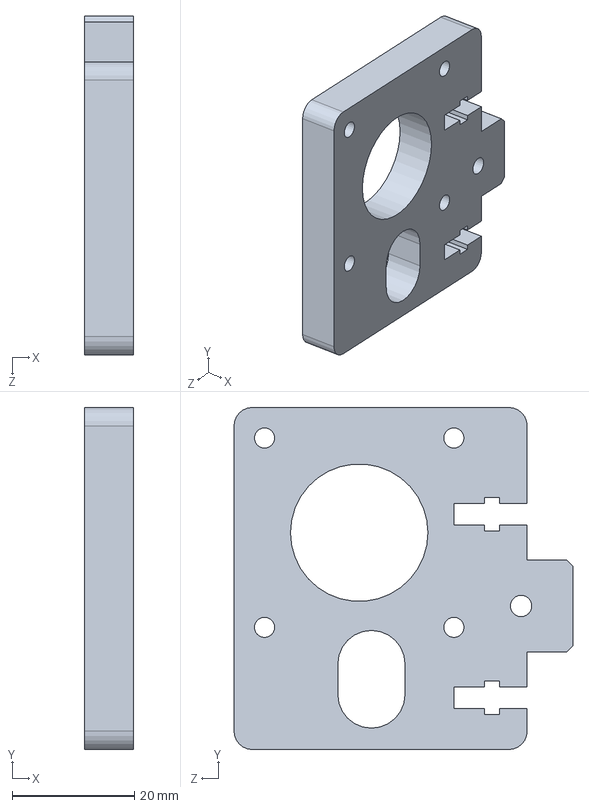
[picture p94: CAD file, 2021-01-05]
Drawings/3D_Printer_Rev_02/Y_Axis/Y_DriveSide/Y_DriveSide_Sub_Parts/Y_Axis_MotorPlate_01.SLDPRT
8.00 x 56.0 x 55.5 mm
