YazgacResearch/3DPrinter/Drawings/3D_Printer_Rev_02/Y_Axis/Y_TensionSide/Y_TensionSide_Sub_Parts/Or/Y_Axis_TensionPlate.SLDPRT

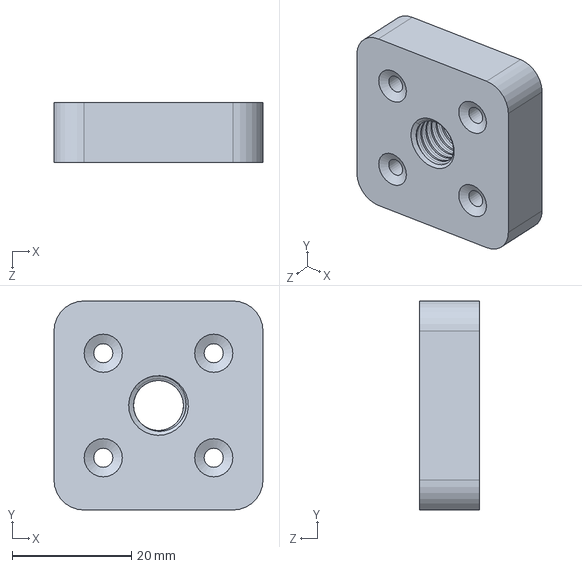
[picture p95: CAD file, 2021-01-05]
Drawings/3D_Printer_Rev_02/Y_Axis/Y_TensionSide/Y_TensionSide_Sub_Parts/Or/Y_Axis_TensionPlate.SLDPRT
35.0 x 35.0 x 10.0 mm
