YazgacResearch/3DPrinter/Drawings/3D_Printer_Rev_02/Y_Axis/Y_TensionSide/Y_TensionSide_Sub_Parts/Y_Axis_TensionSide_Plate.SLDPRT

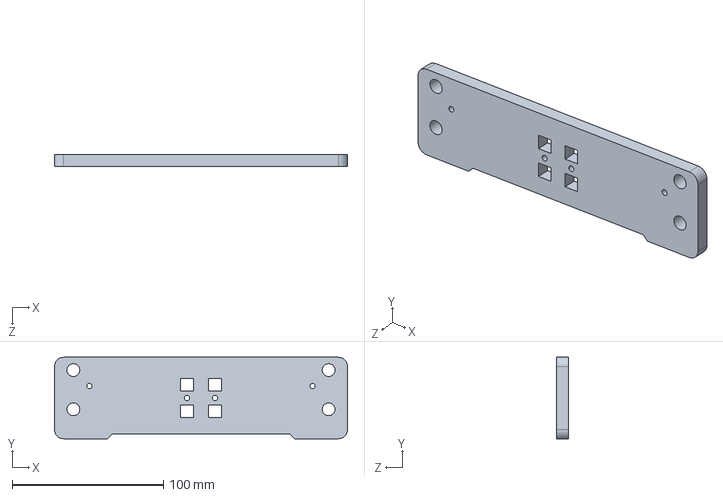
[picture p96: CAD file, 2021-01-05]
Drawings/3D_Printer_Rev_02/Y_Axis/Y_TensionSide/Y_TensionSide_Sub_Parts/Y_Axis_TensionSide_Plate.SLDPRT
194.0 x 54.0 x 8.00 mm
