YazgacResearch/3DPrinter/Drawings/3D_Printer_Rev_02/Z_Axis/Z_Axis_Sub_Parts/Z_Axis_FramePart_01_Right.SLDPRT

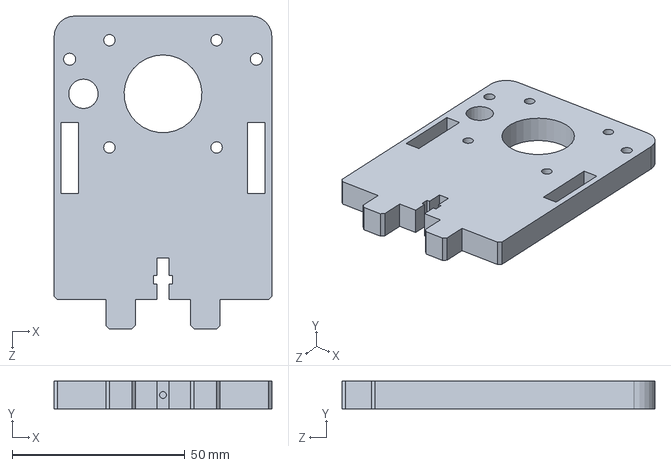
[picture p97: CAD file, 2021-01-05]
Drawings/3D_Printer_Rev_02/Z_Axis/Z_Axis_Sub_Parts/Z_Axis_FramePart_01_Right.SLDPRT
63.0 x 8.00 x 90.5 mm
