YazgacResearch/3DPrinter/Drawings/3D_Printer_Rev_02/ZZ_Extruding_Parts/Feeder_Ex/Ex_Feeder_Adaptor_M6x7mm.SLDPRT

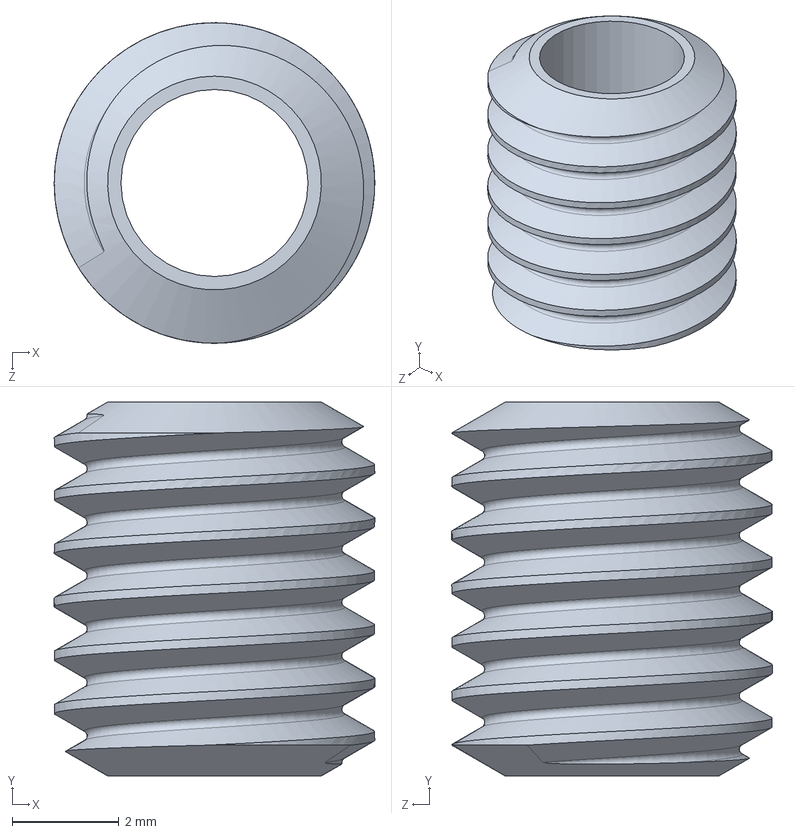
[picture p98: CAD file, 2021-01-05]
Drawings/3D_Printer_Rev_02/ZZ_Extruding_Parts/Feeder_Ex/Ex_Feeder_Adaptor_M6x7mm.SLDPRT
6.00 x 7.00 x 6.00 mm
