YazgacResearch/3DPrinter/Drawings/3D_Printer_Rev_02/ZZ_Extruding_Parts/SpoolHolder_Ex/Ex_SpoolHolder_Shaft_M30.SLDPRT

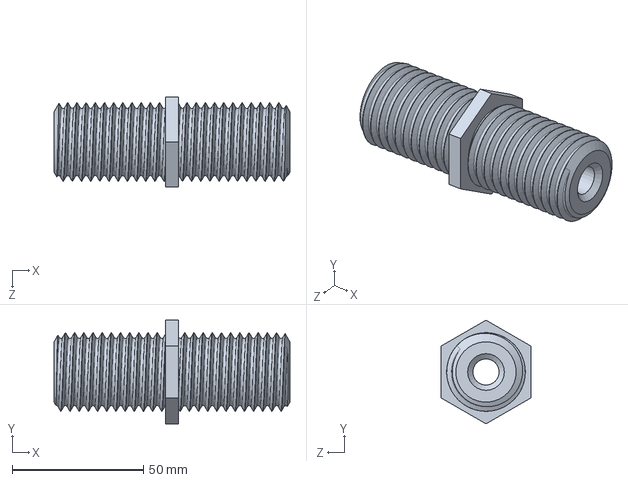
[picture p99: CAD file, 2021-01-05]
Drawings/3D_Printer_Rev_02/ZZ_Extruding_Parts/SpoolHolder_Ex/Ex_SpoolHolder_Shaft_M30.SLDPRT
90.0 x 39.5 x 34.3 mm
