YazgacResearch/3DPrinter/Drawings/3D_Printer_Rev_02/ZZ_Extruding_Parts/X_Axis_Ex/Ex_X_Tensioner.SLDPRT

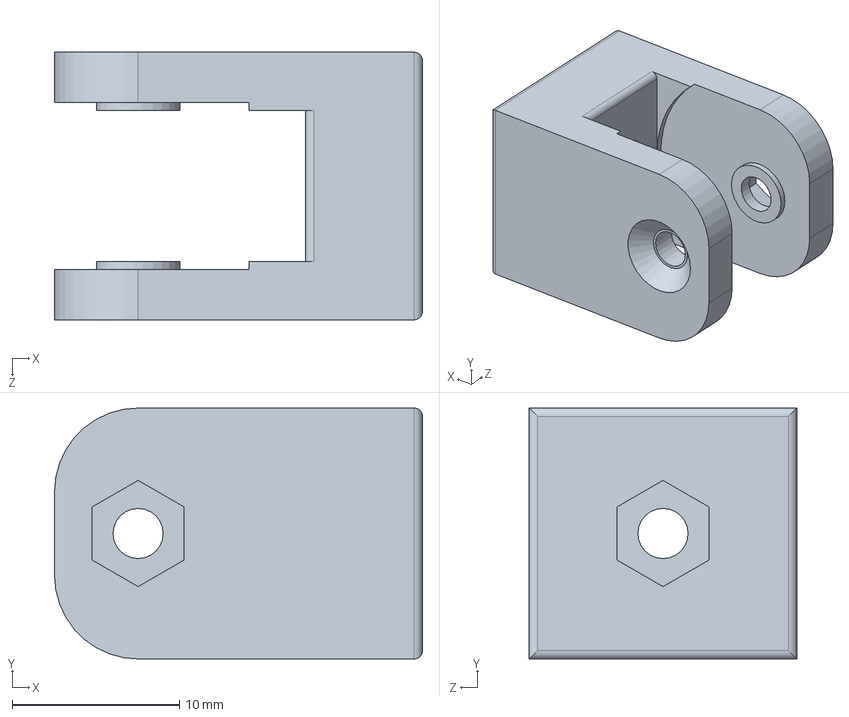
[picture p100: CAD file, 2021-01-05]
Drawings/3D_Printer_Rev_02/ZZ_Extruding_Parts/X_Axis_Ex/Ex_X_Tensioner.SLDPRT
22.0 x 15.0 x 16.0 mm
