YazgacResearch/3DPrinter/Drawings/3D_Printer_Rev_02/ZZ_Extruding_Parts/Z_Axis_Ex/Ex_Z_Axis_TopSide_ShaftGuide.SLDPRT

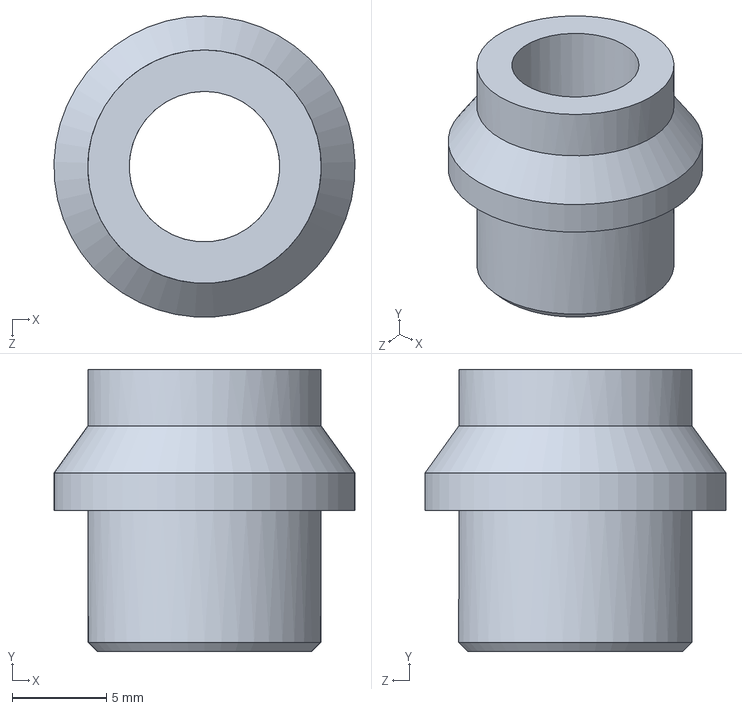
[picture p101: CAD file, 2021-01-05]
Drawings/3D_Printer_Rev_02/ZZ_Extruding_Parts/Z_Axis_Ex/Ex_Z_Axis_TopSide_ShaftGuide.SLDPRT
16.0 x 15.0 x 16.0 mm
