YazgacResearch/3DPrinter/Marlin-bugfix-2.0.4.4/Cura/Test Prints/30x20x5mm M5 M10 Hole R plus Nozzel Size div 4.stl

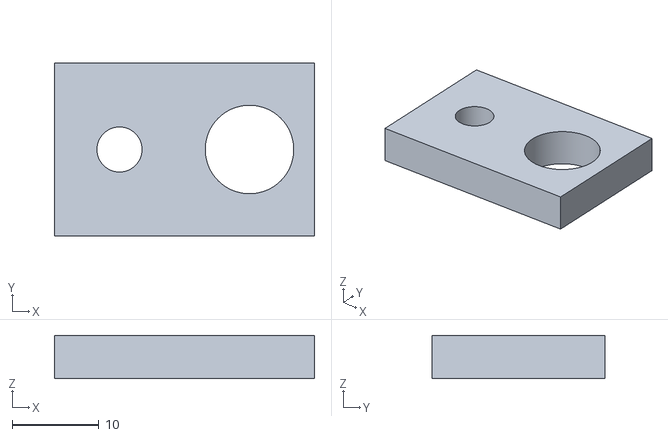
[picture p102: CAD file, 2021-01-05]
Marlin-bugfix-2.0.4.4/Cura/Test Prints/30x20x5mm M5 M10 Hole R plus Nozzel Size div 4.stl
30.0 x 20.0 x 5.00
