YazgacResearch/3DPrinter/Drawings/3D_Printer_Rev_02/Electronics/Electronics_Sub_Parts/SD_Card_Case/SD_CardCase_Bottom.SLDPRT

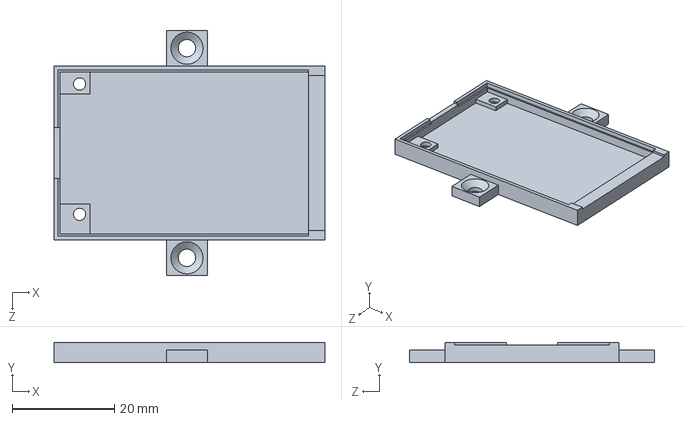
[picture p103: CAD file, 2021-01-05]
Drawings/3D_Printer_Rev_02/Electronics/Electronics_Sub_Parts/SD_Card_Case/SD_CardCase_Bottom.SLDPRT
53.0 x 4.00 x 48.0 mm
