YazgacResearch/3DPrinter/Drawings/3D_Printer_Rev_02/Electronics/Electronics_Sub_Parts/Spacer_D10H10.SLDPRT

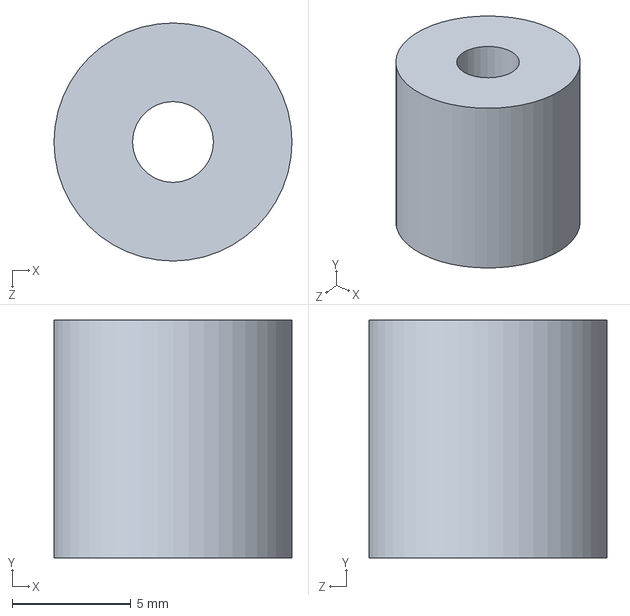
[picture p104: CAD file, 2021-01-05]
Drawings/3D_Printer_Rev_02/Electronics/Electronics_Sub_Parts/Spacer_D10H10.SLDPRT
10.0 x 10.0 x 10.0 mm
