YazgacResearch/3DPrinter/Drawings/3D_Printer_Rev_02/Electronics/LCD_12864/LCD_12864_RevA6.SLDPRT

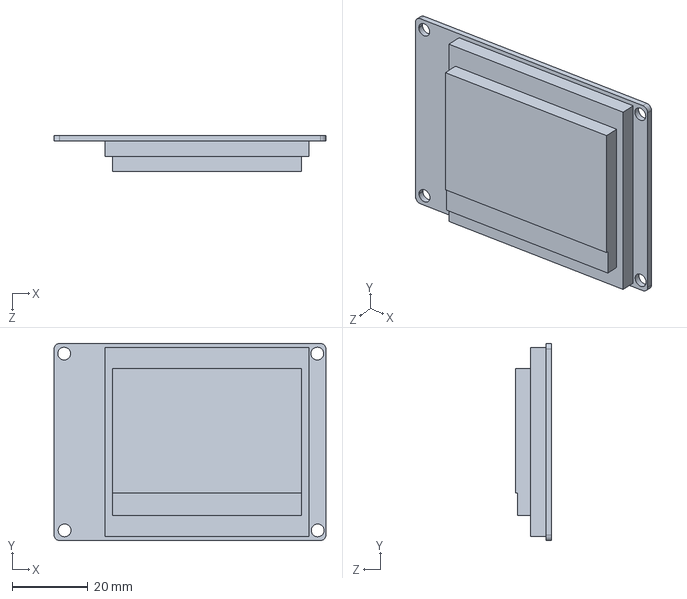
[picture p105: CAD file, 2021-01-05]
Drawings/3D_Printer_Rev_02/Electronics/LCD_12864/LCD_12864_RevA6.SLDPRT
72.0 x 52.2 x 9.50 mm
