YazgacResearch/3DPrinter/Drawings/3D_Printer_Rev_02/Electronics/PSU_S350-12/PSU_EnergySocket.SLDPRT

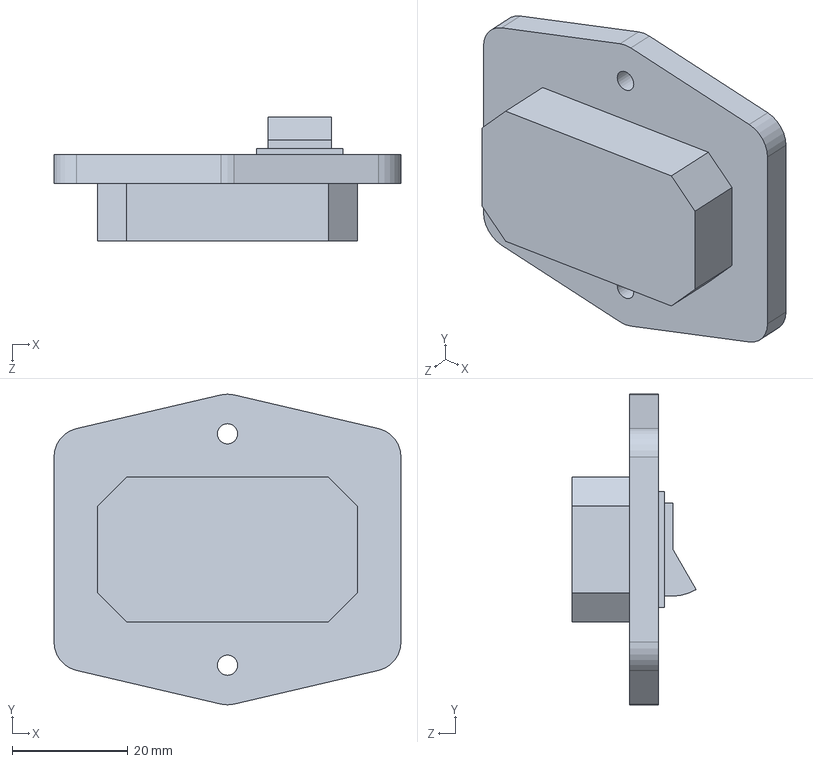
[picture p106: CAD file, 2021-01-05]
Drawings/3D_Printer_Rev_02/Electronics/PSU_S350-12/PSU_EnergySocket.SLDPRT
60.0 x 53.7 x 21.5 mm
