YazgacResearch/3DPrinter/Drawings/3D_Printer_Rev_02/Feeder_Grp/Feeder_Sub_Parts/Remote_Extrueder_Motor_Mount.SLDPRT

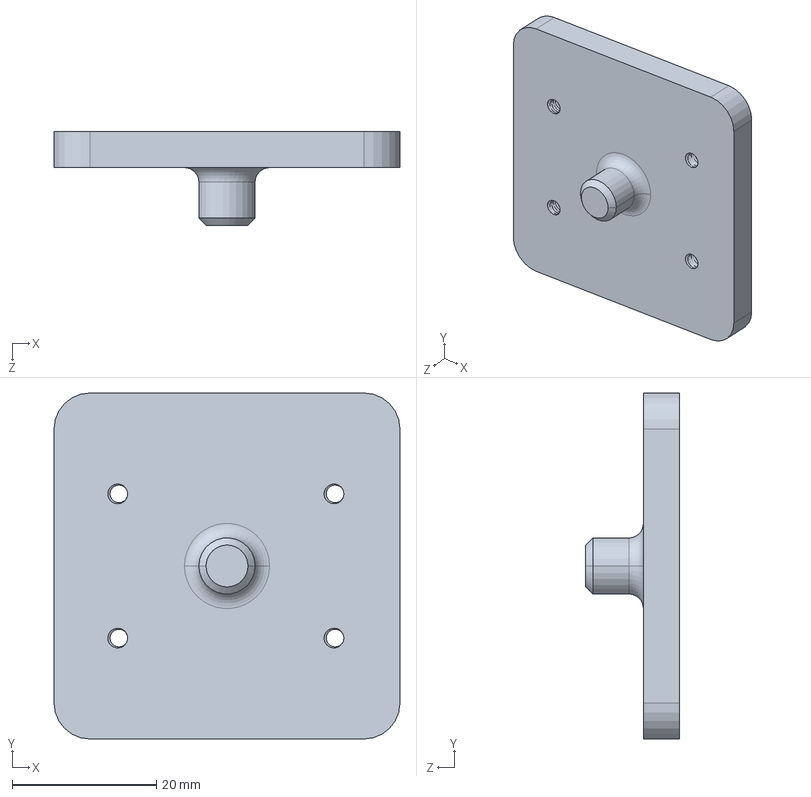
[picture p107: CAD file, 2021-01-05]
Drawings/3D_Printer_Rev_02/Feeder_Grp/Feeder_Sub_Parts/Remote_Extrueder_Motor_Mount.SLDPRT
48.0 x 48.0 x 13.0 mm
