YazgacResearch/3DPrinter/Drawings/3D_Printer_Rev_02/Hirdavat/DIN_EN_ISO_933_M8x35.SLDPRT

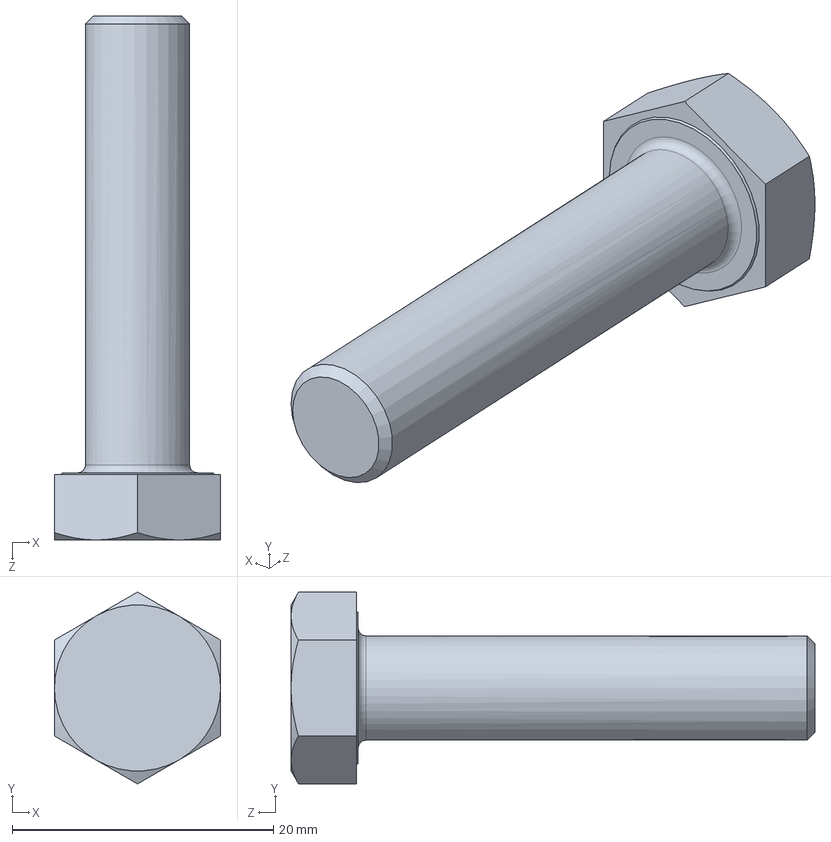
[picture p108: CAD file, 2021-01-05]
Drawings/3D_Printer_Rev_02/Hirdavat/DIN_EN_ISO_933_M8x35.SLDPRT
12.7 x 14.7 x 40.2 mm
