YazgacResearch/3DPrinter/Drawings/3D_Printer_Rev_02/Spool_Holder/SpoolHolder_Sub_Parts/SpoolHolder_SidePlate.SLDPRT

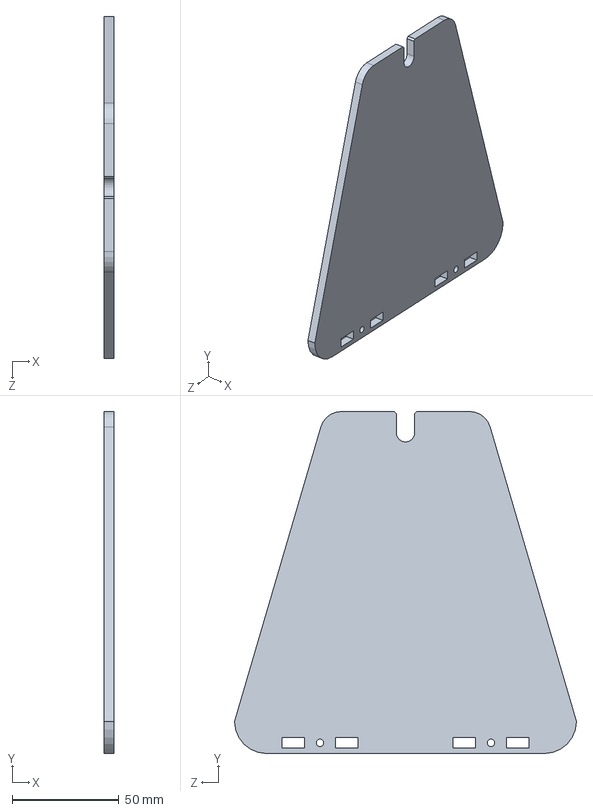
[picture p109: CAD file, 2021-01-05]
Drawings/3D_Printer_Rev_02/Spool_Holder/SpoolHolder_Sub_Parts/SpoolHolder_SidePlate.SLDPRT
4.60 x 160.0 x 160.0 mm
