YazgacResearch/3DPrinter/Drawings/3D_Printer_Rev_02/Ticari/MK8 EXTRUDER RIGHT/MK8_Ext_02.SLDPRT

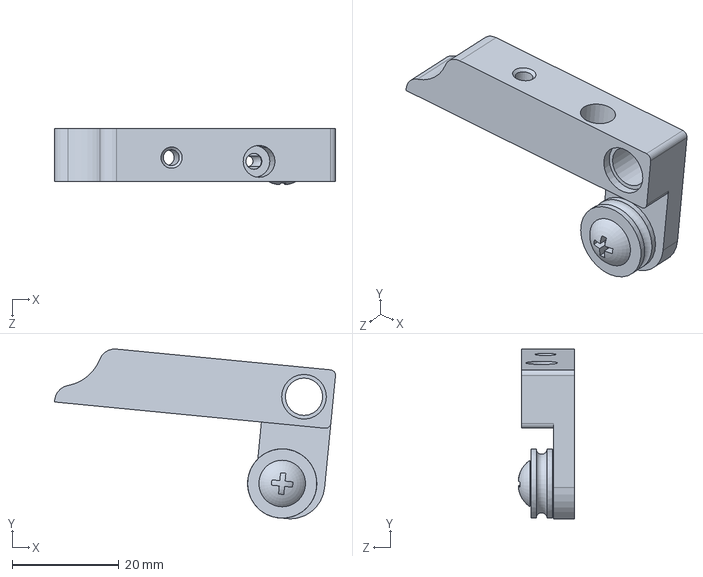
[picture p110: CAD file, 2021-01-05]
Drawings/3D_Printer_Rev_02/Ticari/MK8 EXTRUDER RIGHT/MK8_Ext_02.SLDPRT
52.7 x 31.9 x 10.6 mm
