YazgacResearch/3DPrinter/Drawings/3D_Printer_Rev_02/Ticari/Pulley_GT2_20T.SLDPRT

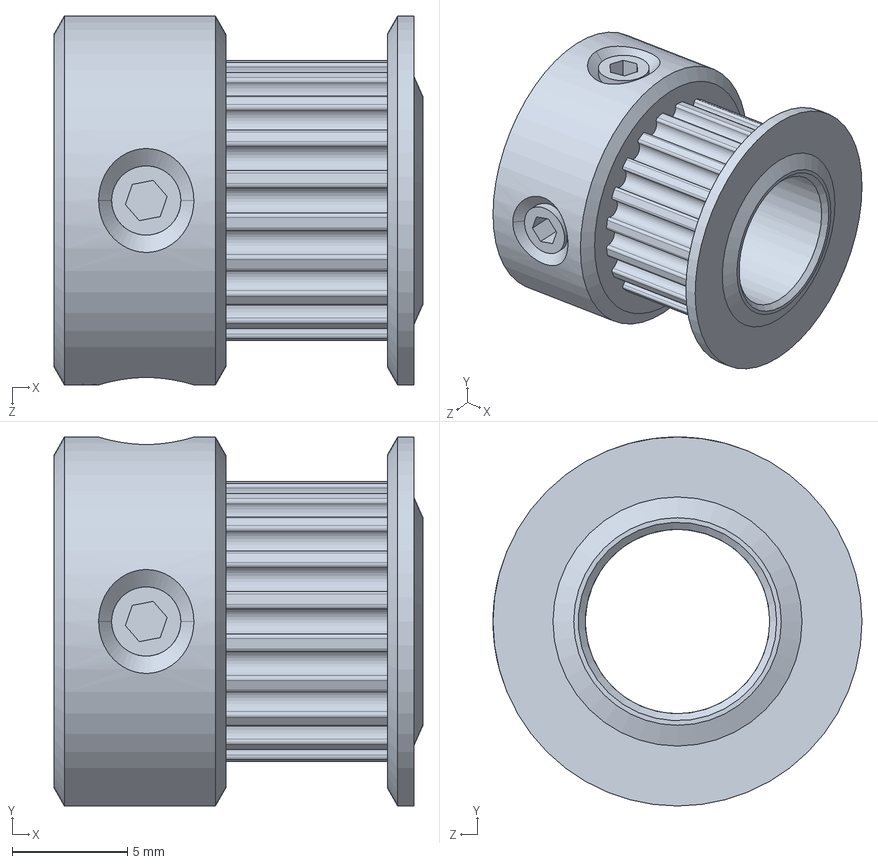
[picture p111: CAD file, 2021-01-05]
Drawings/3D_Printer_Rev_02/Ticari/Pulley_GT2_20T.SLDPRT
16.0 x 16.0 x 16.0 mm
