YazgacResearch/3DPrinter/Drawings/3D_Printer_Rev_02/X_Axis/X_DriverSide/X_DriverSide_Sub_Parts/X_DriverSide_MotorBlock.SLDPRT

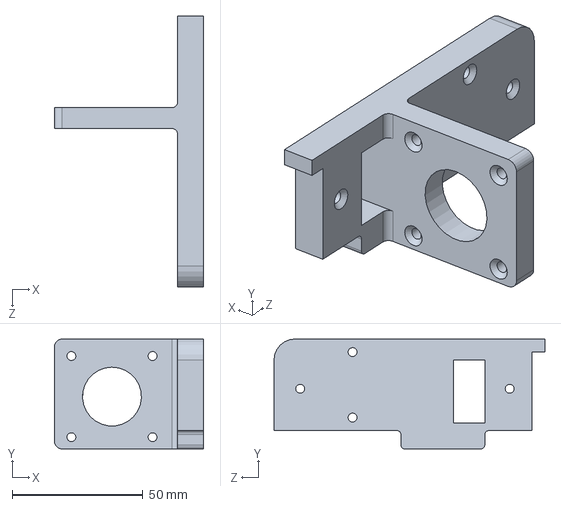
[picture p112: CAD file, 2021-01-05]
Drawings/3D_Printer_Rev_02/X_Axis/X_DriverSide/X_DriverSide_Sub_Parts/X_DriverSide_MotorBlock.SLDPRT
57.0 x 42.0 x 103.5 mm
