YazgacResearch/3DPrinter/Drawings/3D_Printer_Rev_02/X_Axis/X_TensionSide/X_TensionSide_Sub_Parts/X_TensionSide_Cap.SLDPRT

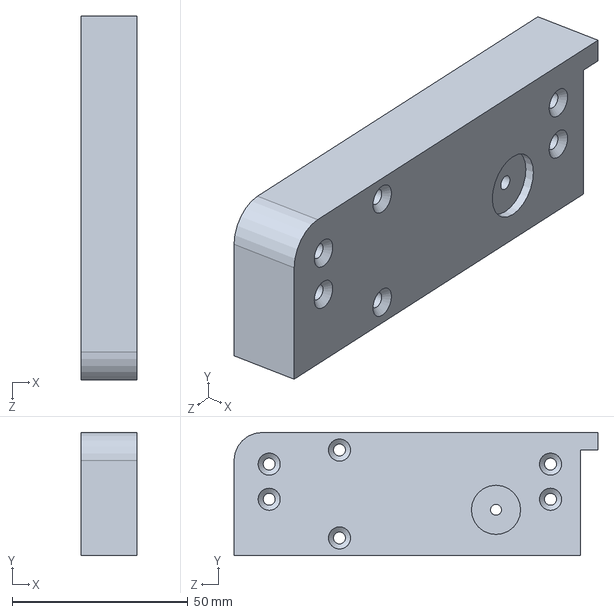
[picture p113: CAD file, 2021-01-05]
Drawings/3D_Printer_Rev_02/X_Axis/X_TensionSide/X_TensionSide_Sub_Parts/X_TensionSide_Cap.SLDPRT
16.0 x 35.0 x 103.5 mm
