YazgacResearch/3DPrinter/Drawings/3D_Printer_Rev_02/Y_Axis/Y_Carriage/Y_Carriage_Sub_Parts/HeatBed_CenterPart.SLDPRT

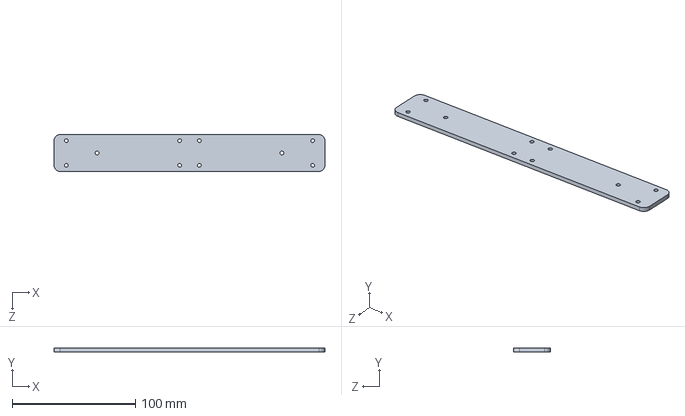
[picture p114: CAD file, 2021-01-05]
Drawings/3D_Printer_Rev_02/Y_Axis/Y_Carriage/Y_Carriage_Sub_Parts/HeatBed_CenterPart.SLDPRT
220.0 x 3.00 x 30.0 mm
