YazgacResearch/3DPrinter/Drawings/3D_Printer_Rev_02/Y_Axis/Y_DriveSide/Y_DriveSide_Sub_Parts/Y_Axis_SensorPlate.SLDPRT

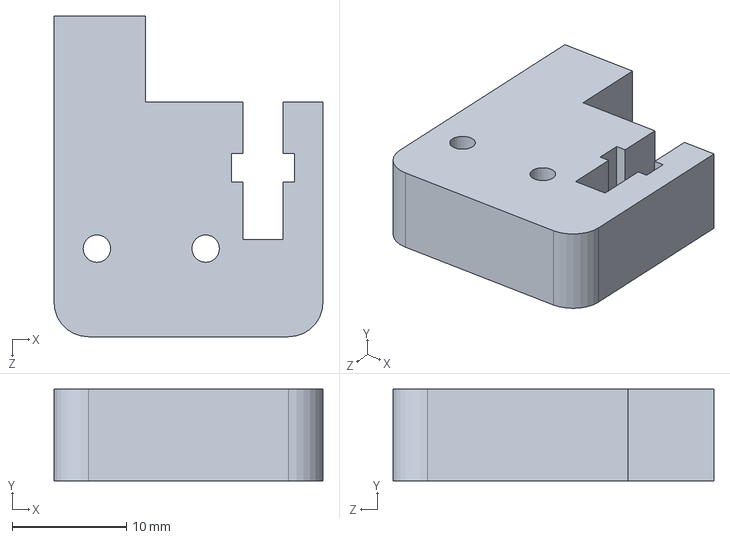
[picture p115: CAD file, 2021-01-05]
Drawings/3D_Printer_Rev_02/Y_Axis/Y_DriveSide/Y_DriveSide_Sub_Parts/Y_Axis_SensorPlate.SLDPRT
23.5 x 8.00 x 28.0 mm
