YazgacResearch/3DPrinter/Drawings/3D_Printer_Rev_02/ZZ_Extruding_Parts/Electronics_Ex/Ex_Spacer_D7H4.SLDPRT

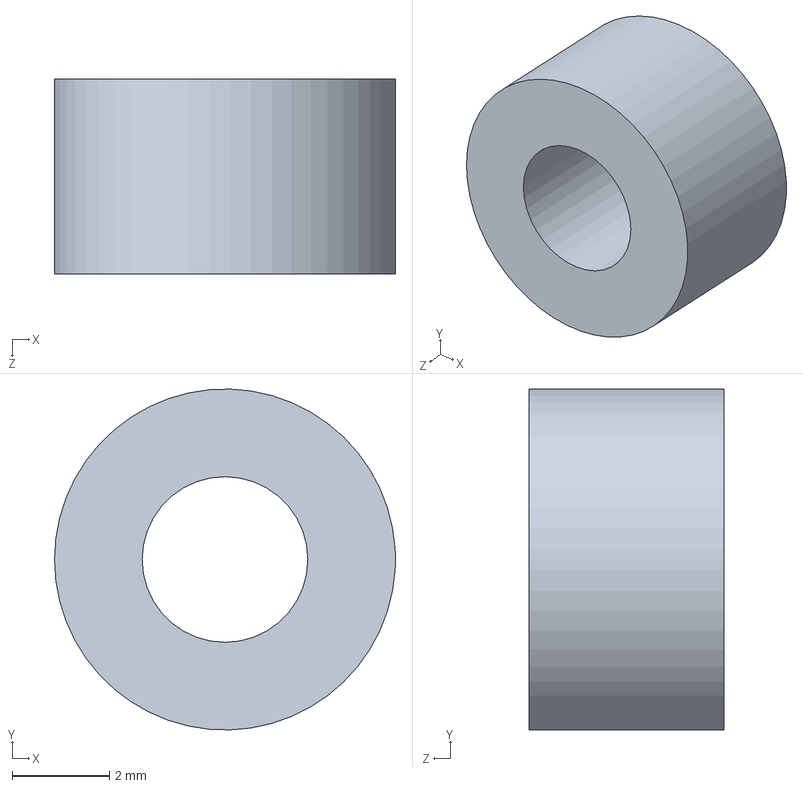
[picture p116: CAD file, 2021-01-05]
Drawings/3D_Printer_Rev_02/ZZ_Extruding_Parts/Electronics_Ex/Ex_Spacer_D7H4.SLDPRT
7.00 x 7.00 x 4.00 mm
