YazgacResearch/3DPrinter/Drawings/3D_Printer_Rev_02/ZZ_Extruding_Parts/Feeder_Ex/Ex_Feeder_adaptor_M6x10mm.SLDPRT

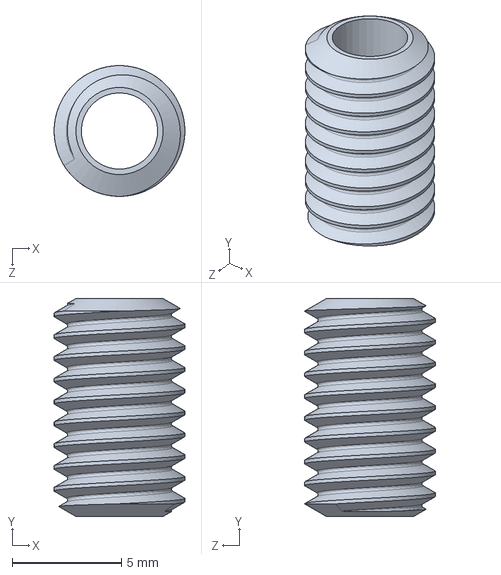
[picture p117: CAD file, 2021-01-05]
Drawings/3D_Printer_Rev_02/ZZ_Extruding_Parts/Feeder_Ex/Ex_Feeder_adaptor_M6x10mm.SLDPRT
6.00 x 10.0 x 6.00 mm
