YazgacResearch/3DPrinter/Drawings/3D_Printer_Rev_02/ZZ_Extruding_Parts/SpoolHolder_Ex/Ex_SpoolHolder_Knob_M30.SLDPRT

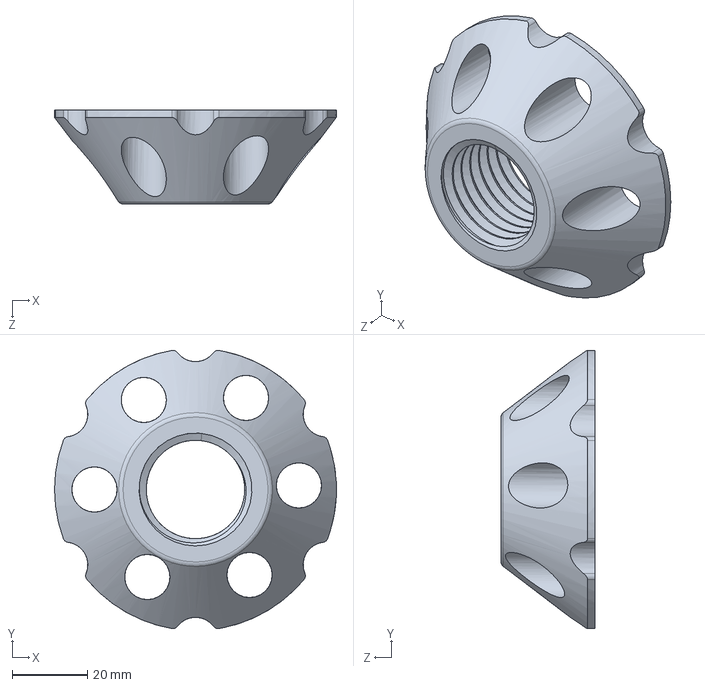
[picture p118: CAD file, 2021-01-05]
Drawings/3D_Printer_Rev_02/ZZ_Extruding_Parts/SpoolHolder_Ex/Ex_SpoolHolder_Knob_M30.SLDPRT
75.0 x 74.0 x 25.0 mm
