YazgacResearch/3DPrinter/Drawings/3D_Printer_Rev_02/ZZ_Extruding_Parts/X_Axis_Ex/Ex_X_DriverSide_LimiterPlate.SLDPRT

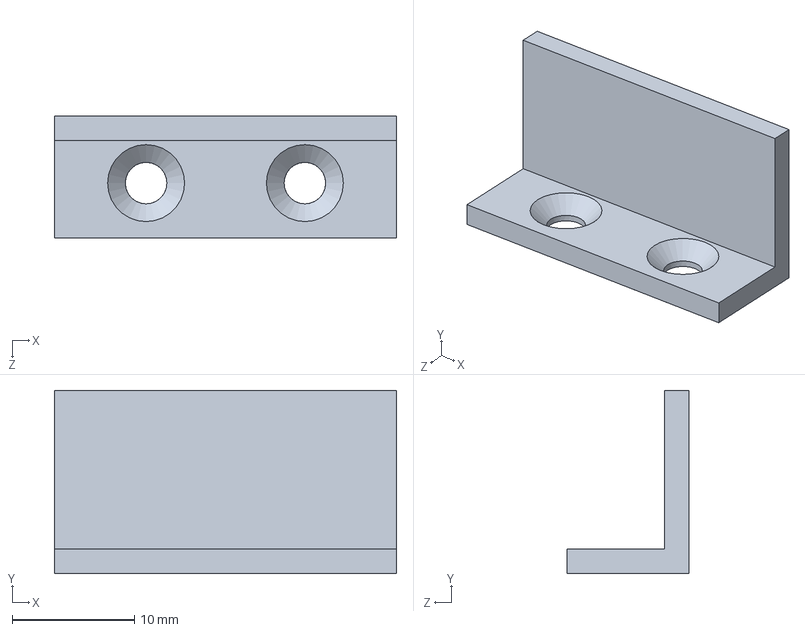
[picture p119: CAD file, 2021-01-05]
Drawings/3D_Printer_Rev_02/ZZ_Extruding_Parts/X_Axis_Ex/Ex_X_DriverSide_LimiterPlate.SLDPRT
28.0 x 15.0 x 10.0 mm
