YazgacResearch/3DPrinter/Drawings/3D_Printer_Rev_02/ZZ_Extruding_Parts/Y_Axis_Ex/Ex_BedLeveling_ThumbWheel.SLDPRT

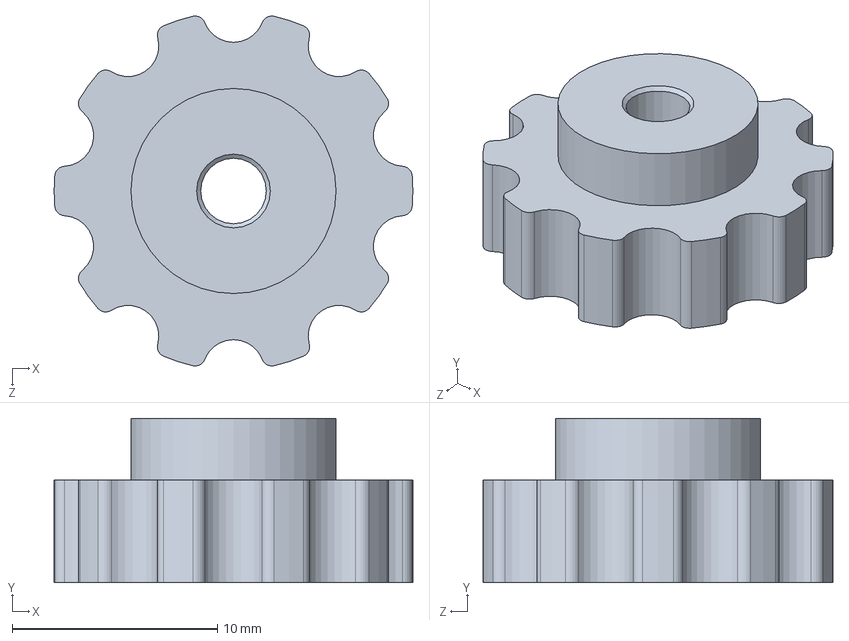
[picture p120: CAD file, 2021-01-05]
Drawings/3D_Printer_Rev_02/ZZ_Extruding_Parts/Y_Axis_Ex/Ex_BedLeveling_ThumbWheel.SLDPRT
17.5 x 8.00 x 17.1 mm
