YazgacResearch/3DPrinter/Drawings/3D_Printer_Rev_02/ZZ_Extruding_Parts/Z_Axis_Ex/Ex_Z_Axis_Motor_Plate.SLDPRT

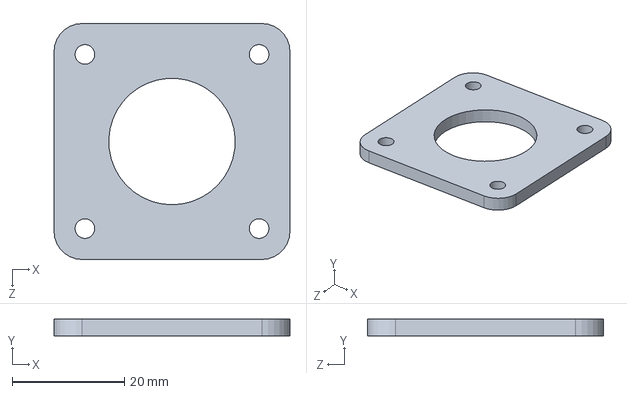
[picture p121: CAD file, 2021-01-05]
Drawings/3D_Printer_Rev_02/ZZ_Extruding_Parts/Z_Axis_Ex/Ex_Z_Axis_Motor_Plate.SLDPRT
42.0 x 3.00 x 42.0 mm
