YazgacResearch/3DPrinter/Drawings/3D_Printer_Rev_02/Electronics/Electronics_Sub_Parts/PSU_Cover.SLDPRT

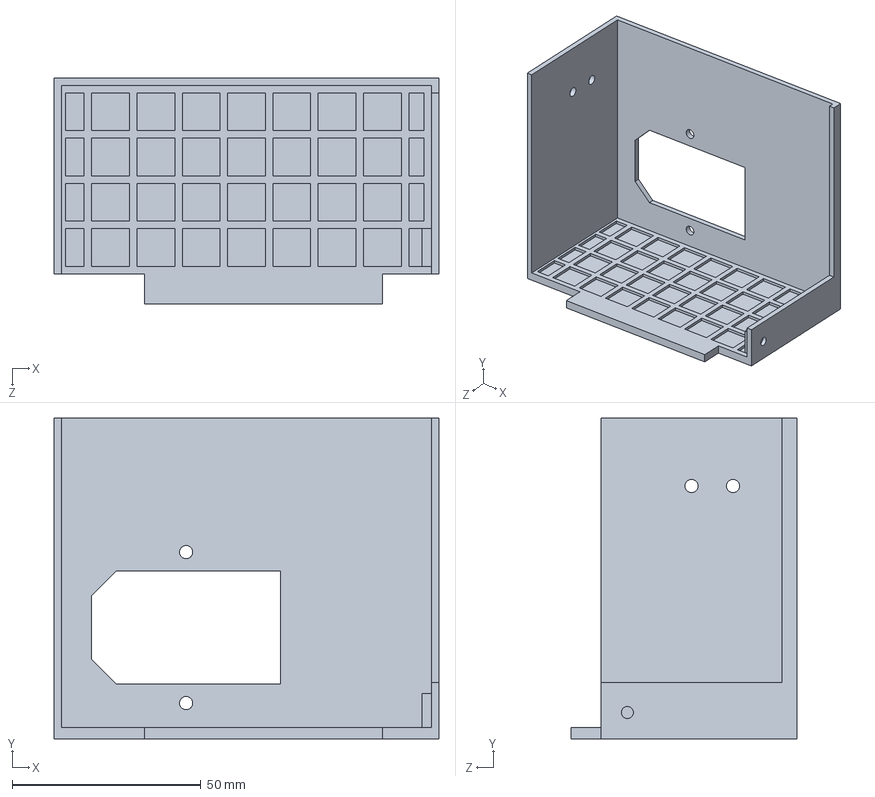
[picture p122: CAD file, 2021-01-05]
Drawings/3D_Printer_Rev_02/Electronics/Electronics_Sub_Parts/PSU_Cover.SLDPRT
102.0 x 85.0 x 60.0 mm
