YazgacResearch/3DPrinter/Drawings/3D_Printer_Rev_02/Feeder_Grp/Feeder_Sub_Parts/Feeder_Adaptor_M6x7mm.SLDPRT

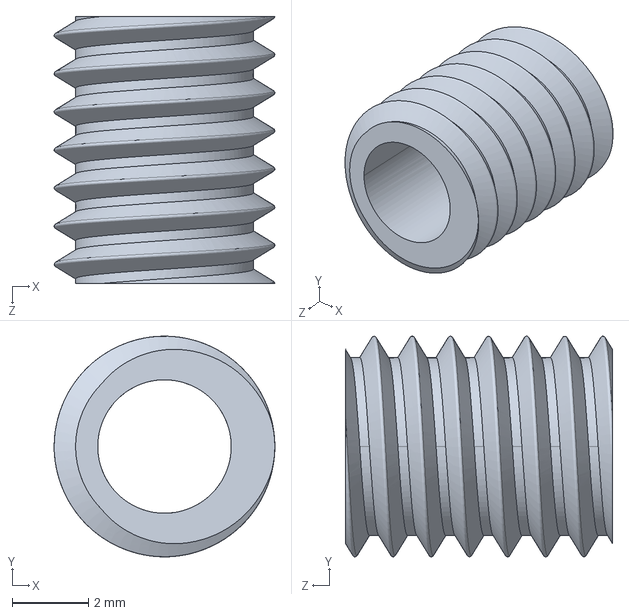
[picture p123: CAD file, 2021-01-05]
Drawings/3D_Printer_Rev_02/Feeder_Grp/Feeder_Sub_Parts/Feeder_Adaptor_M6x7mm.SLDPRT
5.79 x 5.79 x 7.00 mm
