YazgacResearch/3DPrinter/Drawings/3D_Printer_Rev_02/Hirdavat/DIN_EN_ISO_934_M2.5.SLDPRT

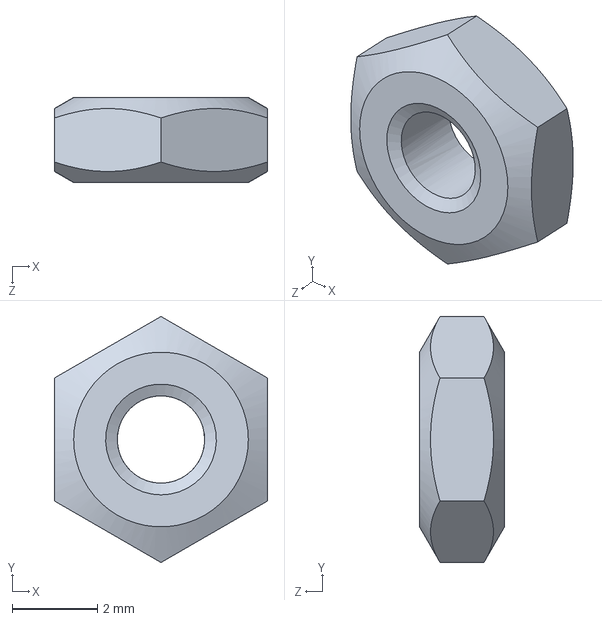
[picture p124: CAD file, 2021-01-05]
Drawings/3D_Printer_Rev_02/Hirdavat/DIN_EN_ISO_934_M2.5.SLDPRT
5.00 x 5.77 x 2.00 mm
