YazgacResearch/3DPrinter/Drawings/3D_Printer_Rev_02/Ticari/Angle_Mounting_Bracket_Nema17.SLDPRT

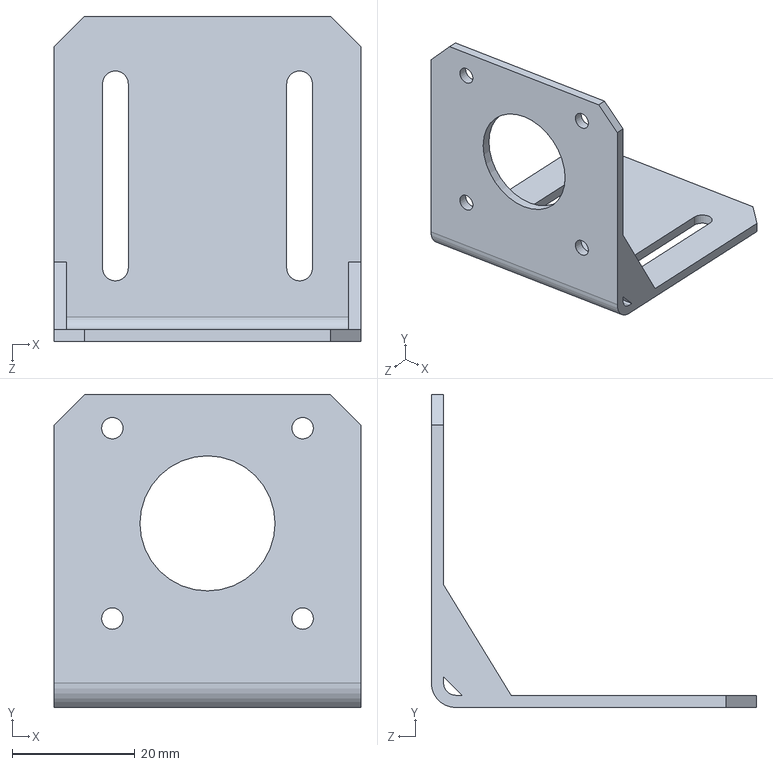
[picture p125: CAD file, 2021-01-05]
Drawings/3D_Printer_Rev_02/Ticari/Angle_Mounting_Bracket_Nema17.SLDPRT
50.0 x 51.0 x 53.0 mm
