YazgacResearch/3DPrinter/Drawings/3D_Printer_Rev_02/Ticari/MK8 EXTRUDER RIGHT/MK8_Ext_04.SLDPRT

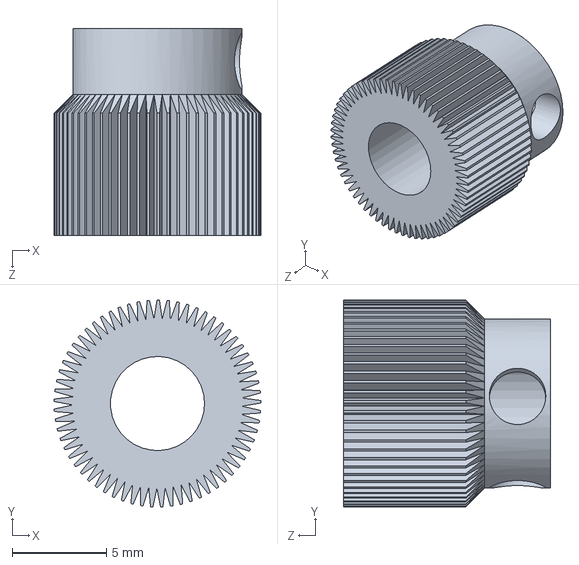
[picture p126: CAD file, 2021-01-05]
Drawings/3D_Printer_Rev_02/Ticari/MK8 EXTRUDER RIGHT/MK8_Ext_04.SLDPRT
11.0 x 11.0 x 11.0 mm
