YazgacResearch/3DPrinter/Drawings/3D_Printer_Rev_02/Y_Axis/Y_Carriage/Y_Carriage_Sub_Parts/HeatBed_SidePart.SLDPRT

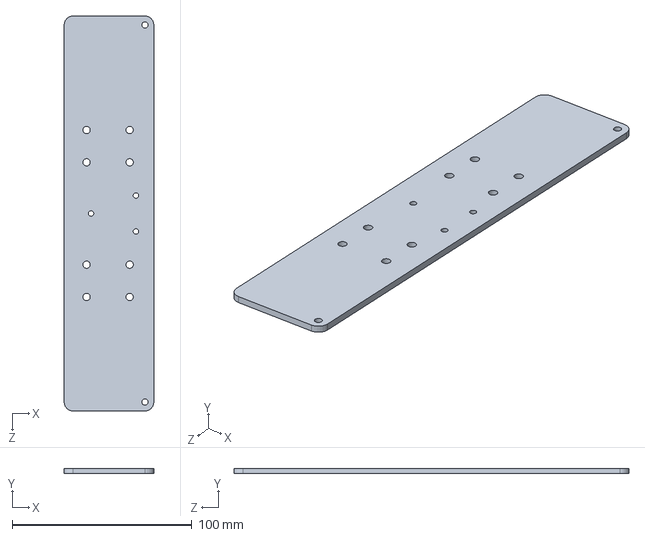
[picture p127: CAD file, 2021-01-05]
Drawings/3D_Printer_Rev_02/Y_Axis/Y_Carriage/Y_Carriage_Sub_Parts/HeatBed_SidePart.SLDPRT
50.0 x 3.00 x 220.0 mm
