YazgacResearch/3DPrinter/Drawings/3D_Printer_Rev_02/Y_Axis/Y_DriveSide/Y_DriveSide_Sub_Parts/Y_Axis_DriveSide_Plate.SLDPRT

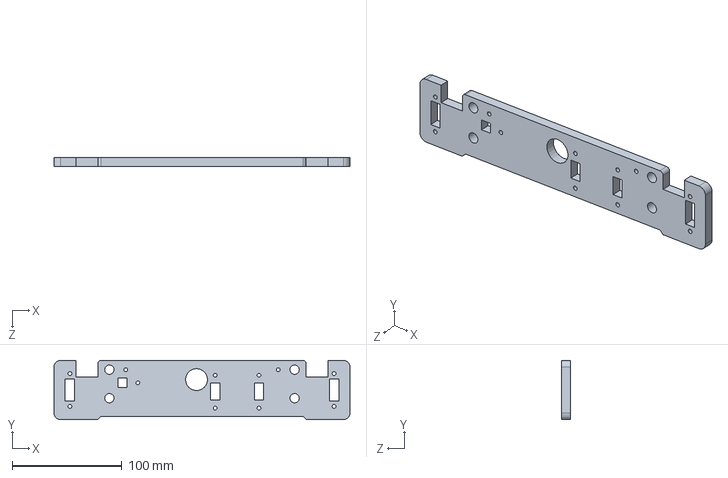
[picture p128: CAD file, 2021-01-05]
Drawings/3D_Printer_Rev_02/Y_Axis/Y_DriveSide/Y_DriveSide_Sub_Parts/Y_Axis_DriveSide_Plate.SLDPRT
270.0 x 54.0 x 8.00 mm
