YazgacResearch/3DPrinter/Drawings/3D_Printer_Rev_02/Y_Axis/Y_TensionSide/Y_TensionSide_Sub_Parts/Y_Axis_TensionPlate_M8.SLDPRT

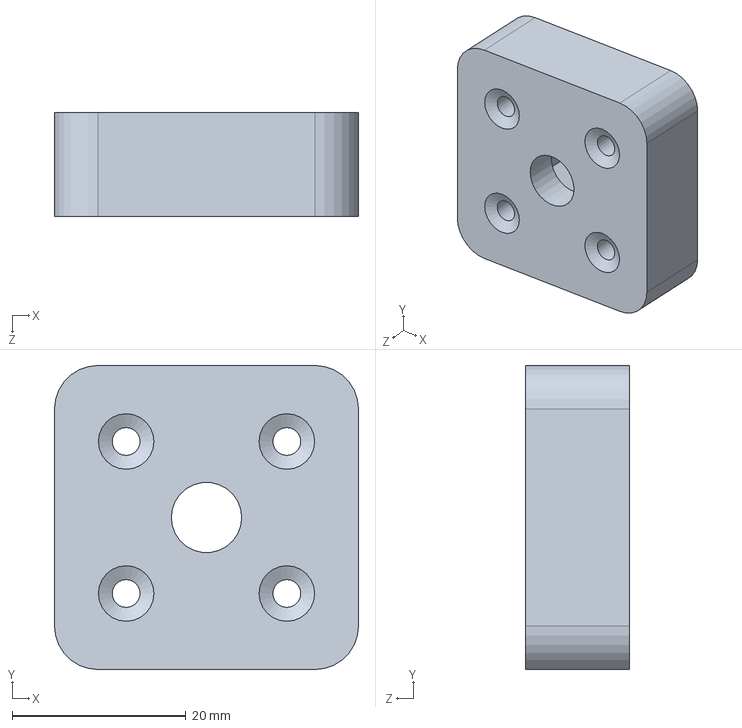
[picture p129: CAD file, 2021-01-05]
Drawings/3D_Printer_Rev_02/Y_Axis/Y_TensionSide/Y_TensionSide_Sub_Parts/Y_Axis_TensionPlate_M8.SLDPRT
35.0 x 35.0 x 12.0 mm
