YazgacResearch/3DPrinter/Drawings/3D_Printer_Rev_02/Z_Axis/Z_Axis_Sub_Parts/Z_Axis_FramePart_02.SLDPRT

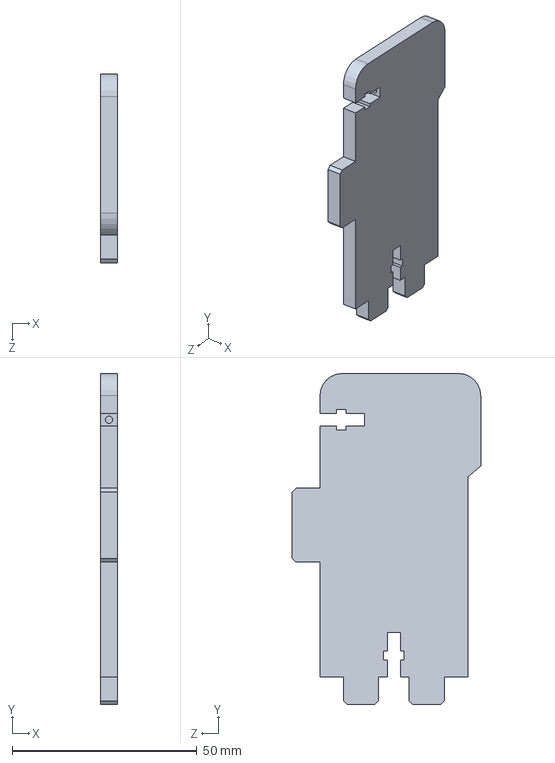
[picture p130: CAD file, 2021-01-05]
Drawings/3D_Printer_Rev_02/Z_Axis/Z_Axis_Sub_Parts/Z_Axis_FramePart_02.SLDPRT
4.60 x 89.5 x 51.0 mm
