YazgacResearch/3DPrinter/Drawings/3D_Printer_Rev_02/ZZ_Extruding_Parts/Feeder_Ex/Ex_Remote_Extruder_Motor_Mount.SLDPRT

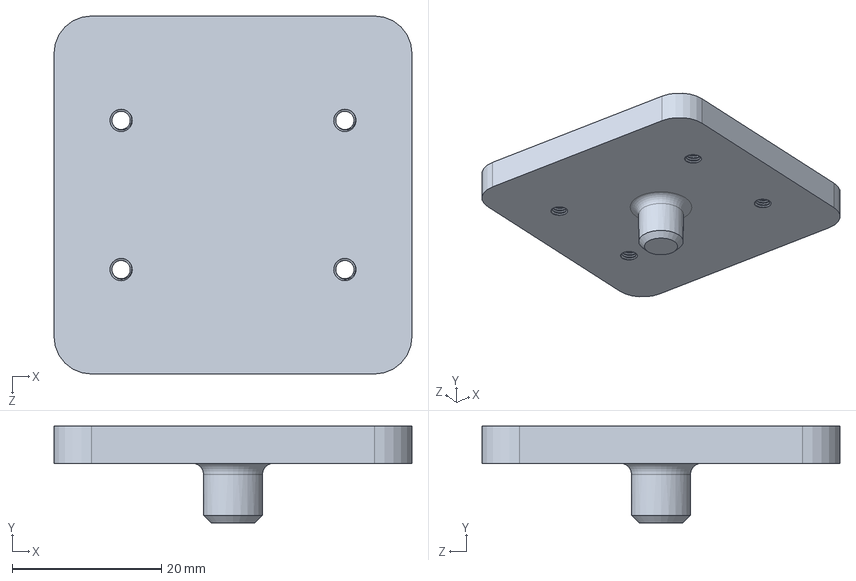
[picture p131: CAD file, 2021-01-05]
Drawings/3D_Printer_Rev_02/ZZ_Extruding_Parts/Feeder_Ex/Ex_Remote_Extruder_Motor_Mount.SLDPRT
48.0 x 13.0 x 48.0 mm
