YazgacResearch/3DPrinter/Drawings/3D_Printer_Rev_02/ZZ_Extruding_Parts/Z_Axis_Ex/Ex_Z_Axis_LimitSwitch_BasePlate.SLDPRT

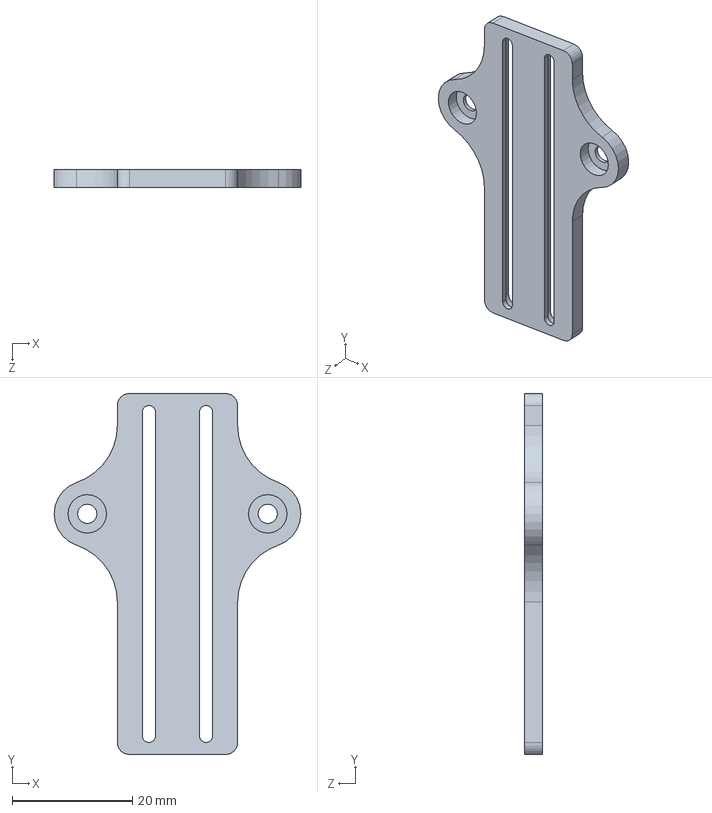
[picture p132: CAD file, 2021-01-05]
Drawings/3D_Printer_Rev_02/ZZ_Extruding_Parts/Z_Axis_Ex/Ex_Z_Axis_LimitSwitch_BasePlate.SLDPRT
41.0 x 60.0 x 3.00 mm
