YazgacResearch/3DPrinter/Drawings/3D_Printer_Rev_02/Electronics/Electronics_Sub_Parts/LCD_Support_PLK.SLDPRT

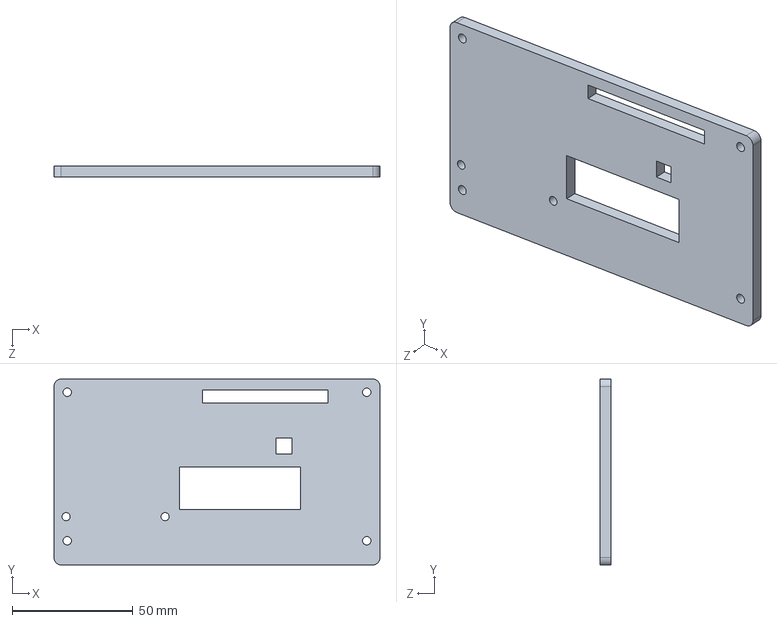
[picture p133: CAD file, 2021-01-05]
Drawings/3D_Printer_Rev_02/Electronics/Electronics_Sub_Parts/LCD_Support_PLK.SLDPRT
135.0 x 77.0 x 4.60 mm
