YazgacResearch/3DPrinter/Drawings/3D_Printer_Rev_02/Electronics/LCD_12864/MKS MINI12864 V1.STEP

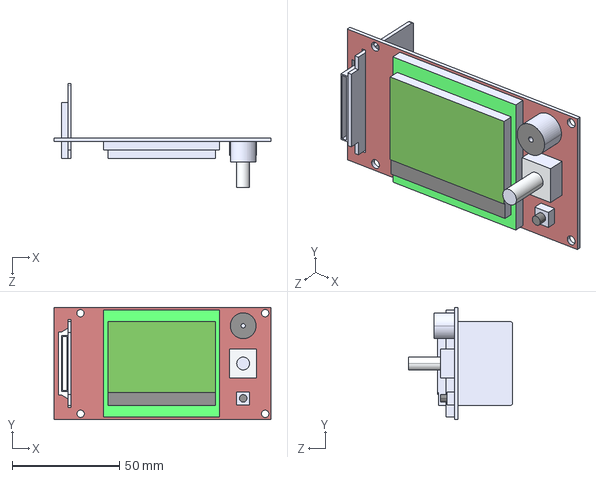
[picture p134: CAD file, 2021-01-05]
Drawings/3D_Printer_Rev_02/Electronics/LCD_12864/MKS MINI12864 V1.STEP
101.0 x 52.2 x 48.5 mm
