YazgacResearch/3DPrinter/Drawings/3D_Printer_Rev_02/Feeder_Grp/Feeder_Sub_Parts/Filament_Output_Guide_M6x0.96x7.5.SLDPRT

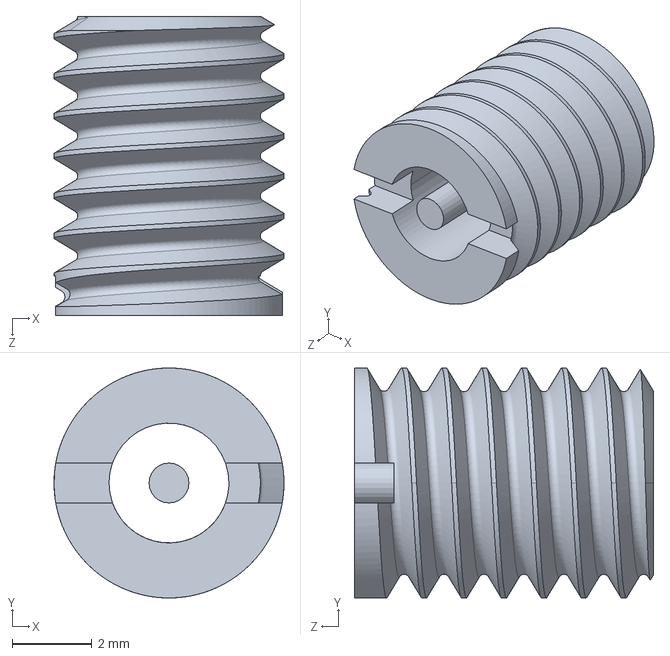
[picture p135: CAD file, 2021-01-05]
Drawings/3D_Printer_Rev_02/Feeder_Grp/Feeder_Sub_Parts/Filament_Output_Guide_M6x0.96x7.5.SLDPRT
5.76 x 5.76 x 7.50 mm
