YazgacResearch/3DPrinter/Drawings/3D_Printer_Rev_02/Hirdavat/DIN_EN_ISO_7045M3x16.SLDPRT

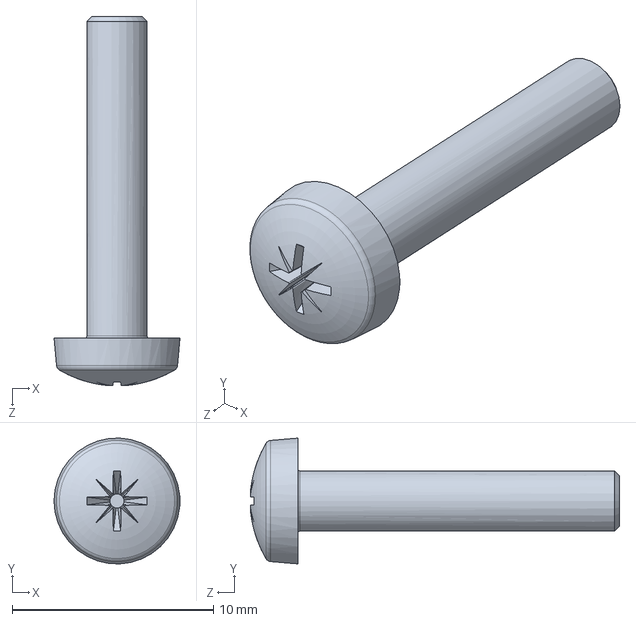
[picture p136: CAD file, 2021-01-05]
Drawings/3D_Printer_Rev_02/Hirdavat/DIN_EN_ISO_7045M3x16.SLDPRT
6.27 x 6.26 x 18.4 mm
