YazgacResearch/3DPrinter/Drawings/3D_Printer_Rev_02/Ticari/GuideRod_340_Zax.SLDPRT

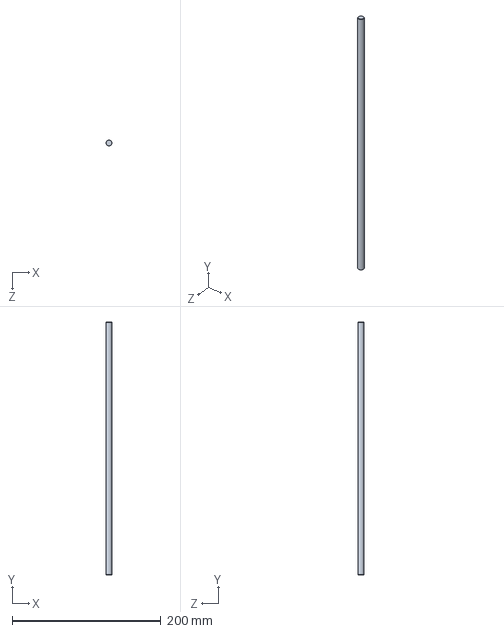
[picture p137: CAD file, 2021-01-05]
Drawings/3D_Printer_Rev_02/Ticari/GuideRod_340_Zax.SLDPRT
8.00 x 340.0 x 8.00 mm
