YazgacResearch/3DPrinter/Drawings/3D_Printer_Rev_02/Ticari/MK8 EXTRUDER RIGHT/DIN_EN_ISO_912M3x15.SLDPRT

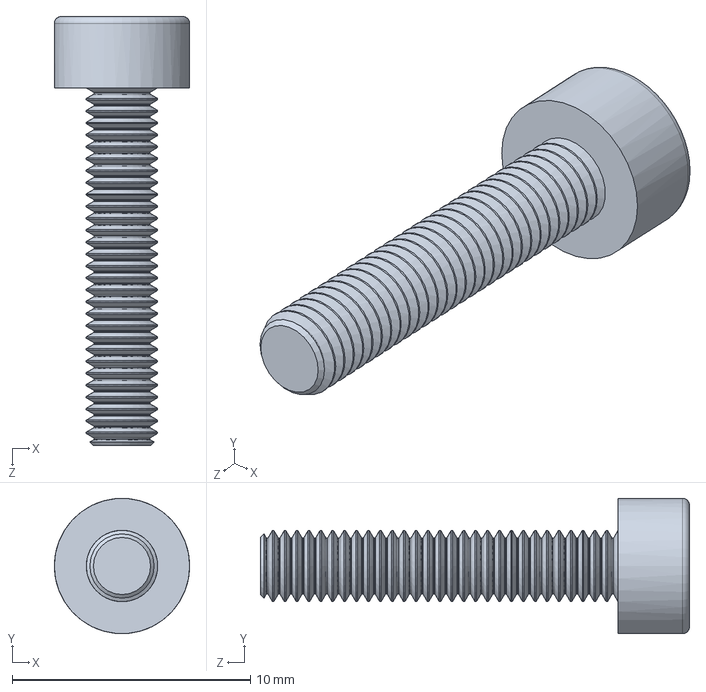
[picture p138: CAD file, 2021-01-05]
Drawings/3D_Printer_Rev_02/Ticari/MK8 EXTRUDER RIGHT/DIN_EN_ISO_912M3x15.SLDPRT
5.68 x 5.68 x 18.0 mm
