YazgacResearch/3DPrinter/Drawings/3D_Printer_Rev_02/Y_Axis/Y_DriveSide/Y_DriveSide_Sub_Parts/Y_Axis_MotorPlate_02.SLDPRT

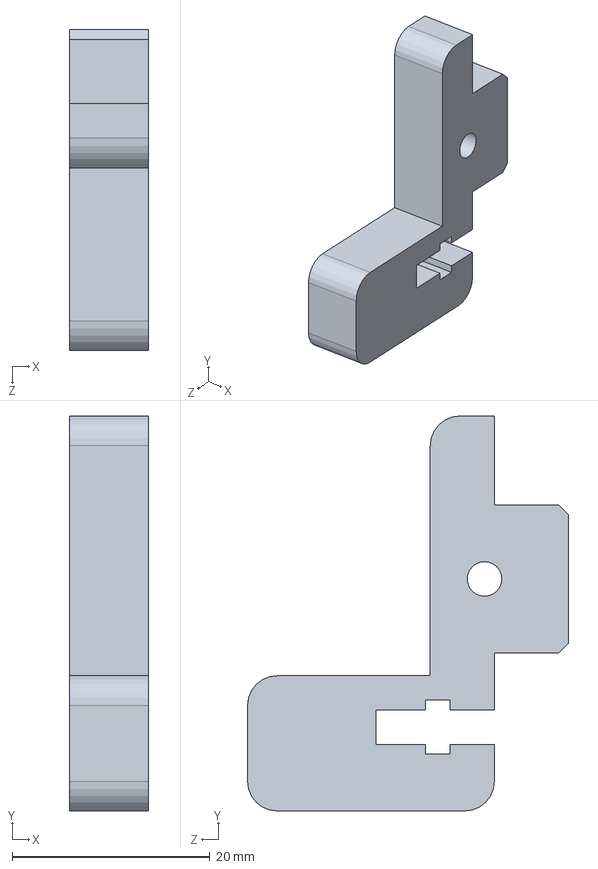
[picture p139: CAD file, 2021-01-05]
Drawings/3D_Printer_Rev_02/Y_Axis/Y_DriveSide/Y_DriveSide_Sub_Parts/Y_Axis_MotorPlate_02.SLDPRT
8.00 x 40.0 x 32.5 mm
