YazgacResearch/3DPrinter/Drawings/3D_Printer_Rev_02/Y_Axis/Y_TensionSide/Y_TensionSide_Sub_Parts/Y_Axis_Tensioner_Right.SLDPRT

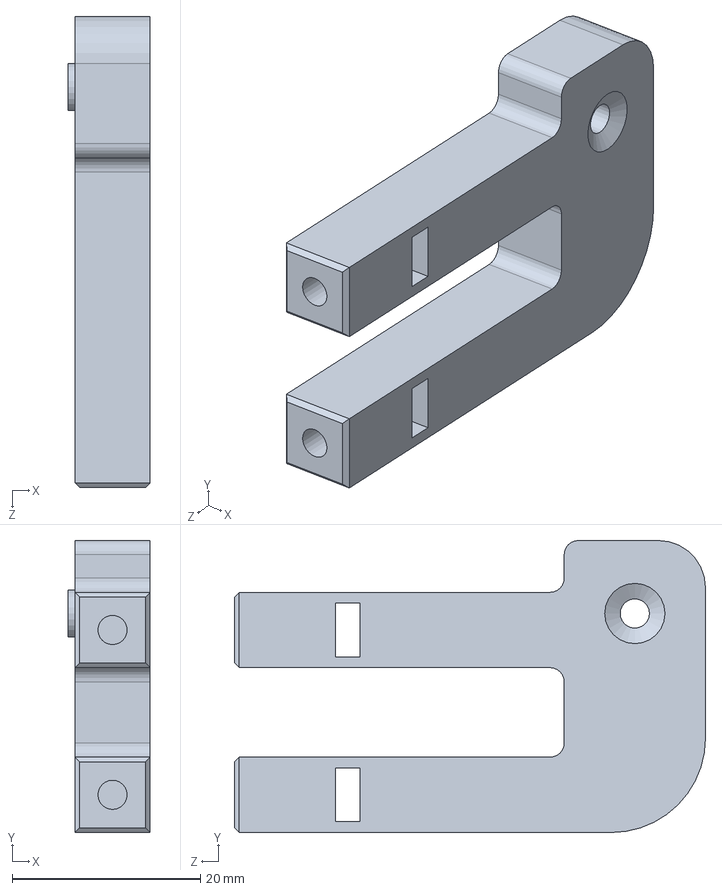
[picture p140: CAD file, 2021-01-05]
Drawings/3D_Printer_Rev_02/Y_Axis/Y_TensionSide/Y_TensionSide_Sub_Parts/Y_Axis_Tensioner_Right.SLDPRT
8.75 x 31.0 x 50.0 mm
