YazgacResearch/3DPrinter/Drawings/3D_Printer_Rev_02/ZZ_Extruding_Parts/Feeder_Ex/Ex_Flement_Output_Guide_M6x7.5.SLDPRT

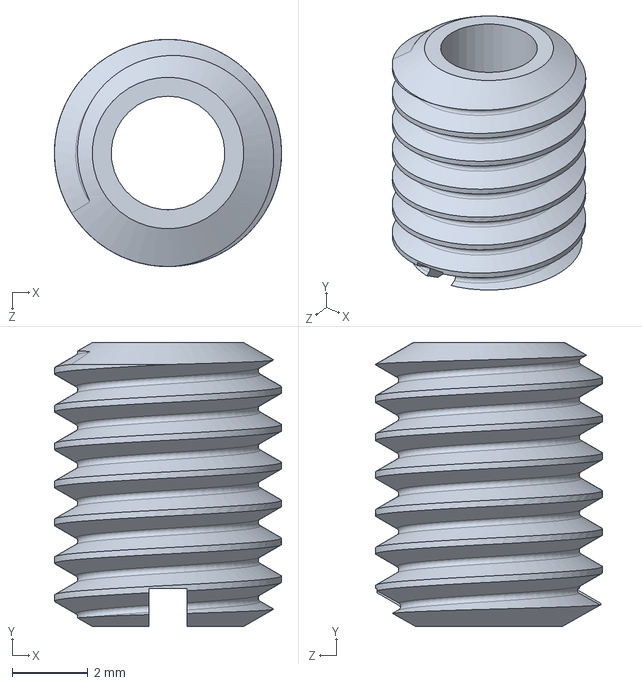
[picture p142: CAD file, 2021-01-05]
Drawings/3D_Printer_Rev_02/ZZ_Extruding_Parts/Feeder_Ex/Ex_Flement_Output_Guide_M6x7.5.SLDPRT
6.00 x 7.50 x 6.00 mm
