YazgacResearch/3DPrinter/Drawings/3D_Printer_Rev_02/Hirdavat/DIN_EN_ISO_912_M4x20.SLDPRT

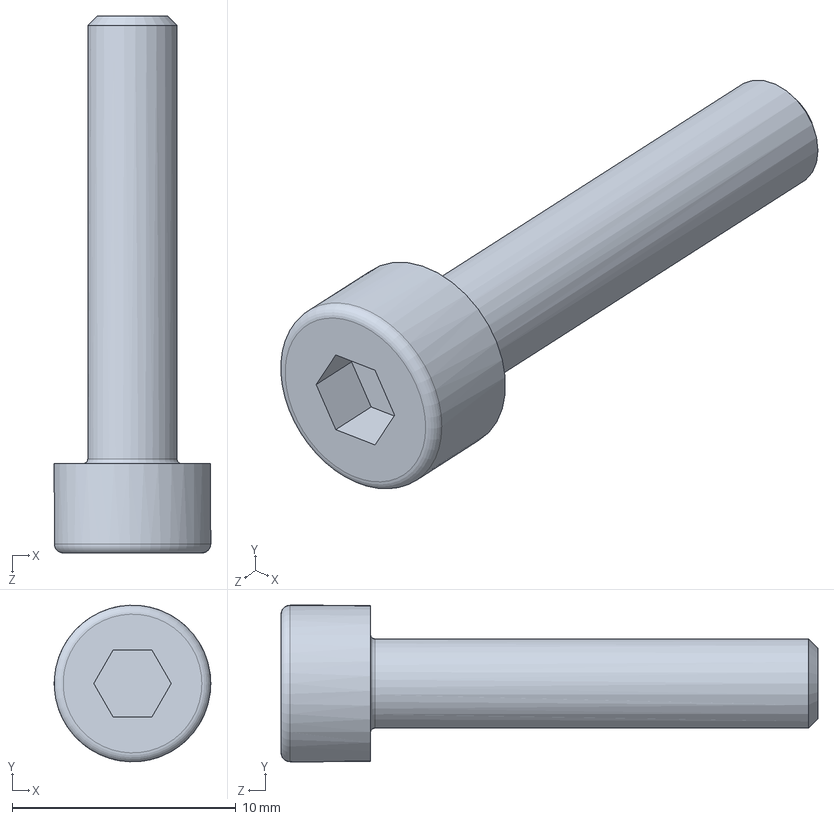
[picture p145: CAD file, 2021-01-05]
Drawings/3D_Printer_Rev_02/Hirdavat/DIN_EN_ISO_912_M4x20.SLDPRT
7.00 x 7.00 x 24.0 mm
