YazgacResearch/3DPrinter/Drawings/3D_Printer_Rev_02/Ticari/GuideRod_400_Xax.SLDPRT

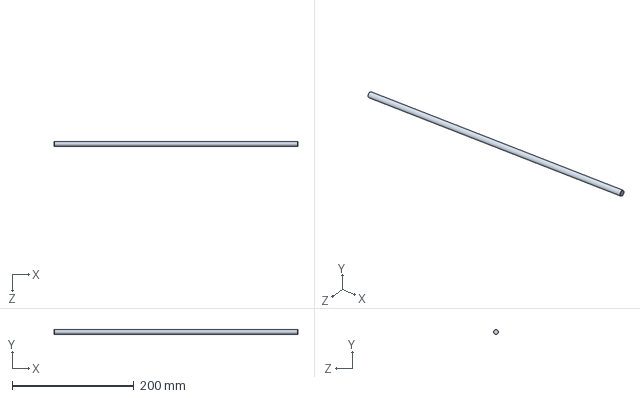
[picture p146: CAD file, 2021-01-05]
Drawings/3D_Printer_Rev_02/Ticari/GuideRod_400_Xax.SLDPRT
400.0 x 8.00 x 8.00 mm
