YazgacResearch/3DPrinter/Drawings/3D_Printer_Rev_02/Ticari/MK8 EXTRUDER RIGHT/DIN_EN_ISO_912M3x5.SLDPRT

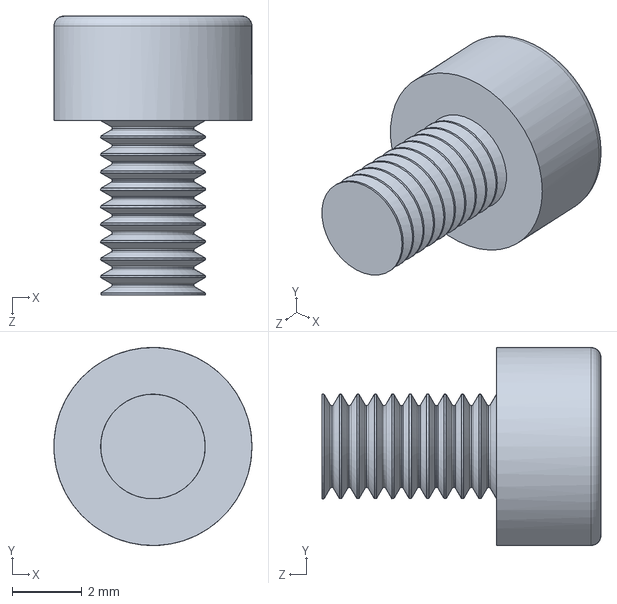
[picture p147: CAD file, 2021-01-05]
Drawings/3D_Printer_Rev_02/Ticari/MK8 EXTRUDER RIGHT/DIN_EN_ISO_912M3x5.SLDPRT
5.68 x 5.68 x 8.00 mm
