YazgacResearch/3DPrinter/Drawings/3D_Printer_Rev_02/Y_Axis/Y_Carriage/Y_Carriage_Sub_Parts/Y_Axis_BeltHolder.SLDPRT

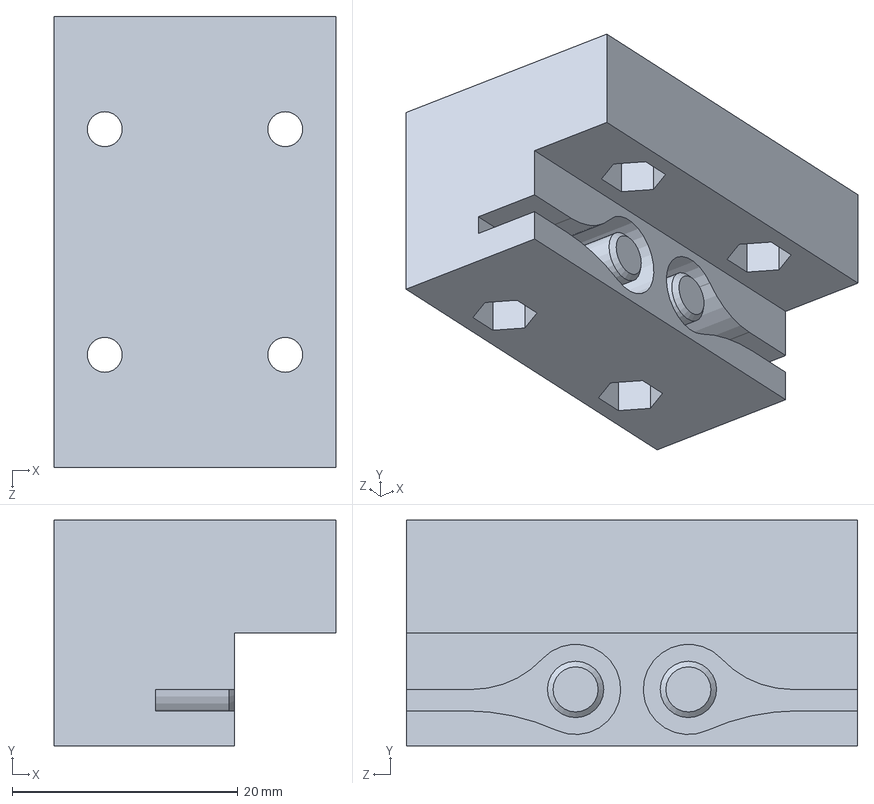
[picture p148: CAD file, 2021-01-05]
Drawings/3D_Printer_Rev_02/Y_Axis/Y_Carriage/Y_Carriage_Sub_Parts/Y_Axis_BeltHolder.SLDPRT
25.0 x 20.0 x 40.0 mm
