YazgacResearch/3DPrinter/Drawings/3D_Printer_Rev_02/Ticari/Bowden_M8.SLDASM

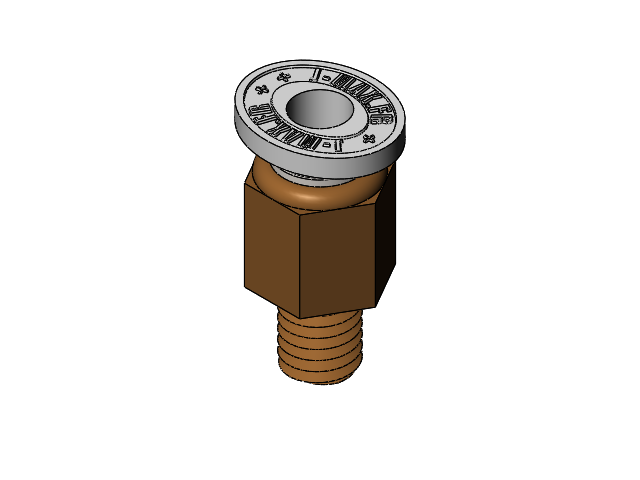
[picture p149: CAD file, 2021-01-05]
Drawings/3D_Printer_Rev_02/Ticari/Bowden_M8.SLDASM
Bronse fitting^Bowden_M8
Bushing^Bowden_M8
Push-In^Bowden_M8
