YazgacResearch/3DPrinter/(list of files, cad)

Other CAD files:
Drawings/3D_Printer_Rev_02/Ticari/e3d-v6-hot-end/E3D All Metal Hotend V6 assy.STEP
Drawings/3D_Printer_Rev_02/ZZ_Extruding_Parts/Extruder_Ex/Ex_Extruder_Cable_Clamp_Main.SLDPRT
Drawings/3D_Printer_Rev_02/Z_Axis/Z_Axis_Grp_Left.SLDASM
Drawings/3D_Printer_Rev_02/ZZ_Extruding_Parts/Extruder_Ex/Ex_Extruder_Nozle_Main.SLDPRT
Drawings/3D_Printer_Rev_02/Extruder_Grp/Extruder_Sub_Parts/Extruder_Frame_Main.SLDPRT
Drawings/3D_Printer_Rev_02/ZZ_Extruding_Parts/Extruder_Ex/Ex_Extruder_Clamp_Main.SLDPRT
Drawings/3D_Printer_Rev_02/MainFrame/MainFrame_Sub_Parts/MainFrame_BackLeftSide.SLDPRT
Drawings/3D_Printer_Rev_02/ZZ_Extruding_Parts/X_Axis_Ex/Ex_Carriage_Main.SLDPRT
Drawings/3D_Printer_Rev_02/Ticari/Fan_BLDC_40x10/Fan centrifugal 40x40x10 v9.iges
Drawings/3D_Printer_Rev_02/X_Axis/X_TensionSide/X_TensionSide_Sub_Parts/X_TensionSide_Block.SLDPRT
Drawings/3D_Printer_Rev_02/ZZ_Extruding_Parts/Electronics_Ex/Ex_SD_CardCase_Top.SLDPRT
Drawings/3D_Printer_Rev_02/ZZ_LaserCutting_Parts/DWG_Files/03_DocA_LaserCutting_Assem_Al_3mm.DWG
Drawings/3D_Printer_Rev_02/Electronics/Arduino_lm-2596/Arduino_LM2596.SLDPRT
Drawings/3D_Printer_Rev_02/Ticari/KFL08_Yatak/Bearing_House_KFL08.SLDPRT
Drawings/3D_Printer_Rev_02/Z_Axis/Z_Axis_Sub_Parts/Z_Axis_TopSide_ShaftGuide.SLDPRT
Drawings/3D_Printer_Rev_02/ZZ_LaserCutting_Parts/DWG_Files/03_DocB_LaserCutting_Assem_Plexi_4.DWG
Drawings/3D_Printer_Rev_02/Spool_Holder/SpoolHolder_Sub_Parts/SpoolHolder_Knob_M30.SLDPRT
Drawings/3D_Printer_Rev_02/X_Axis/X_DriverSide/X_DriverSide_Sub_Parts/X_DriverSide_LimiterPlate.SLDPRT
Drawings/3D_Printer_Rev_02/ZZ_Extruding_Parts/Electronics_Ex/Ex_Spacer_D7H11.SLDPRT
Drawings/3D_Printer_Rev_02/ZZ_Extruding_Parts/X_Axis_Ex/Ex_Carriage_Cable_Clamp.SLDPRT
Drawings/3D_Printer_Rev_02/ZZ_Extruding_Parts/Y_Axis_Ex/Ex_BedLeveling_SpringCap.SLDPRT
Drawings/3D_Printer_Rev_02/ZZ_LaserCutting_Parts/DWG_Files/03_DocC_LaserCutting_Assem_Plexi_8mm.DWG
Drawings/3D_Printer_Rev_02/Spool_Holder/SpoolHolder_Sub_Parts/SpoolHolder_Shaft_M30.SLDPRT
Drawings/3D_Printer_Rev_02/X_Axis/X_TensionSide/X_TensionSide_Sub_Parts/X_Tensioner.SLDPRT
Drawings/3D_Printer_Rev_02/Y_Axis/Y_Carriage/Y_Carriage_Sub_Parts/BedLeveling_ThumbWheel.SLDPRT
Drawings/3D_Printer_Rev_02/Z_Axis/Z_Axis_Sub_Parts/Z_Axis_FramePart_01_Left.SLDPRT
Drawings/3D_Printer_Rev_02/ZZ_Extruding_Parts/X_Axis_Ex/Ex_X_TensionSide_Cap.SLDPRT
Drawings/3D_Printer_Rev_02/ZZ_Extruding_Parts/Y_Axis_Ex/Ex_Y_Axis_Tensioner_Left.SLDPRT
Drawings/3D_Printer_Rev_02/Y_Axis/Y_TensionSide/Y_TensionSide_Sub_Parts/Y_Axis_Tensioner_Left.SLDPRT
Drawings/3D_Printer_Rev_02/Z_Axis/Z_Axis_Sub_Parts/Z_Axis_Motor_Plate.SLDPRT
Drawings/3D_Printer_Rev_02/Electronics/DRV8825/8825 v55.f3d
Drawings/3D_Printer_Rev_02/Electronics/Electronics_Sub_Parts/BuzzerCap.SLDPRT
Drawings/3D_Printer_Rev_02/Electronics/Electronics_Sub_Parts/ECard_Cover_Plate.SLDPRT
Drawings/3D_Printer_Rev_02/Electronics/Electronics_Sub_Parts/Spacer_D4.4H10.SLDPRT
Drawings/3D_Printer_Rev_02/Electronics/Electronics_Sub_Parts/Spacer_D4.4H11.SLDPRT
Drawings/3D_Printer_Rev_02/Electronics/Electronics_Sub_Parts/Spacer_D7H4.SLDPRT
Drawings/3D_Printer_Rev_02/Electronics/Electronics_Sub_Parts/Spacer_D7H6.SLDPRT
Drawings/3D_Printer_Rev_02/Electronics/LCD_12864/MKS MINI12864 V1.SLDPRT
Drawings/3D_Printer_Rev_02/Feeder_Grp/Feeder_Sub_Parts/Feeder_Cover_Mount.SLDPRT
Drawings/3D_Printer_Rev_02/Feeder_Grp/Feeder_Sub_Parts/Filament_Output_Guide.SLDPRT
Drawings/3D_Printer_Rev_02/Hirdavat/DIN125_EN_ISO_7089_M4.SLDPRT
Drawings/3D_Printer_Rev_02/Hirdavat/DIN_EN_ISO_125A_M8.SLDPRT
Drawings/3D_Printer_Rev_02/Hirdavat/DIN_EN_ISO_1587_M8.SLDPRT
Drawings/3D_Printer_Rev_02/Hirdavat/DIN_EN_ISO_4032_M4.SLDPRT
Drawings/3D_Printer_Rev_02/Hirdavat/DIN_EN_ISO_7045M3x10.SLDPRT
Drawings/3D_Printer_Rev_02/Hirdavat/DIN_EN_ISO_7045M3x12.SLDPRT
Drawings/3D_Printer_Rev_02/Hirdavat/DIN_EN_ISO_7045M3x20.SLDPRT
Drawings/3D_Printer_Rev_02/Hirdavat/DIN_EN_ISO_7045M3x25.SLDPRT
Drawings/3D_Printer_Rev_02/Hirdavat/DIN_EN_ISO_7045M3x28.SLDPRT
Drawings/3D_Printer_Rev_02/Hirdavat/DIN_EN_ISO_7045M3x30.SLDPRT
Drawings/3D_Printer_Rev_02/Hirdavat/DIN_EN_ISO_7045M3x40.SLDPRT
Drawings/3D_Printer_Rev_02/Hirdavat/DIN_EN_ISO_7045M3x5.SLDPRT
Drawings/3D_Printer_Rev_02/Hirdavat/DIN_EN_ISO_7045M4x16.SLDPRT
Drawings/3D_Printer_Rev_02/Hirdavat/DIN_EN_ISO_7045_M2.5x12.SLDPRT
Drawings/3D_Printer_Rev_02/Hirdavat/DIN_EN_ISO_7046-2-R1_M2.5x10.SLDPRT
Drawings/3D_Printer_Rev_02/Hirdavat/DIN_EN_ISO_7046-2-R1_M2.5x8.SLDPRT
Drawings/3D_Printer_Rev_02/Hirdavat/DIN_EN_ISO_7046-2-R1_M2x10.SLDPRT
Drawings/3D_Printer_Rev_02/Hirdavat/DIN_EN_ISO_7046-2-R1_M2x5.SLDPRT
Drawings/3D_Printer_Rev_02/Hirdavat/DIN_EN_ISO_7046-2-R1_M3x10.SLDPRT
Drawings/3D_Printer_Rev_02/Hirdavat/DIN_EN_ISO_7046-2-R1_M3x12.SLDPRT
Drawings/3D_Printer_Rev_02/Hirdavat/DIN_EN_ISO_7046-2-R1_M3x15.SLDPRT
Drawings/3D_Printer_Rev_02/Hirdavat/DIN_EN_ISO_7046-2-R1_M3x16.SLDPRT
Drawings/3D_Printer_Rev_02/Hirdavat/DIN_EN_ISO_7046-2-R1_M3x25.SLDPRT
Drawings/3D_Printer_Rev_02/Hirdavat/DIN_EN_ISO_7046-2-R1_M3x30.SLDPRT
Drawings/3D_Printer_Rev_02/Hirdavat/DIN_EN_ISO_7046-2-R1_M3x35.SLDPRT
Drawings/3D_Printer_Rev_02/Hirdavat/DIN_EN_ISO_7046-2-R1_M3x5.SLDPRT
Drawings/3D_Printer_Rev_02/Hirdavat/DIN_EN_ISO_7046-2-R1_M3x55.SLDPRT
Drawings/3D_Printer_Rev_02/Hirdavat/DIN_EN_ISO_7046-2-R1_M3x8.SLDPRT
Drawings/3D_Printer_Rev_02/Hirdavat/DIN_EN_ISO_7046-2-R1_M5x16.SLDPRT
Drawings/3D_Printer_Rev_02/Hirdavat/DIN_EN_ISO_7046-2-R1_M5x18.SLDPRT
Drawings/3D_Printer_Rev_02/Hirdavat/DIN_EN_ISO_7046-2-R1_M5x20.SLDPRT
Drawings/3D_Printer_Rev_02/Hirdavat/DIN_EN_ISO_912_M2.5x10.SLDPRT
Drawings/3D_Printer_Rev_02/Hirdavat/DIN_EN_ISO_912_M2.5x18.SLDPRT
Drawings/3D_Printer_Rev_02/Hirdavat/DIN_EN_ISO_912_M2x10.SLDPRT
Drawings/3D_Printer_Rev_02/Hirdavat/DIN_EN_ISO_912_M3x10.SLDPRT
Drawings/3D_Printer_Rev_02/Hirdavat/DIN_EN_ISO_912_M3x12.SLDPRT
Drawings/3D_Printer_Rev_02/Hirdavat/DIN_EN_ISO_912_M3x15.SLDPRT
Drawings/3D_Printer_Rev_02/Hirdavat/DIN_EN_ISO_912_M3x25.SLDPRT
Drawings/3D_Printer_Rev_02/Hirdavat/DIN_EN_ISO_912_M3x30.SLDPRT
Drawings/3D_Printer_Rev_02/Hirdavat/DIN_EN_ISO_912_M4x12.SLDPRT
Drawings/3D_Printer_Rev_02/Hirdavat/DIN_EN_ISO_913_M3x3.SLDPRT
Drawings/3D_Printer_Rev_02/Hirdavat/DIN_EN_ISO_913_M3x5.SLDPRT
Drawings/3D_Printer_Rev_02/Hirdavat/DIN_EN_ISO_933_M8x30.SLDPRT
Drawings/3D_Printer_Rev_02/Hirdavat/DIN_EN_ISO_933_M8x50.SLDPRT
Drawings/3D_Printer_Rev_02/Hirdavat/DIN_EN_ISO_934_M2.SLDPRT
Drawings/3D_Printer_Rev_02/Hirdavat/DIN_EN_ISO_934_M3.SLDPRT
Drawings/3D_Printer_Rev_02/Hirdavat/DIN_EN_ISO_934_M5.SLDPRT
Drawings/3D_Printer_Rev_02/Hirdavat/DIN_EN_ISO_934_M8.SLDPRT
Drawings/3D_Printer_Rev_02/Ticari/BedLeveling_SpringD6H10.SLDPRT
Drawings/3D_Printer_Rev_02/Ticari/Bowden_M6x4.SLDPRT
Drawings/3D_Printer_Rev_02/Ticari/Coupling_5x8.SLDPRT
Drawings/3D_Printer_Rev_02/Ticari/Fan_BLDC_40x10/Fan centrifugal 40x40x10 v9.f3d
Drawings/3D_Printer_Rev_02/Ticari/GT2 Pulley 3mm bore/GT2_Pulley-3mm_bore-v8.SLDASM
Drawings/3D_Printer_Rev_02/Ticari/GuideRod_380_Yax.SLDPRT
Drawings/3D_Printer_Rev_02/Ticari/HeatPad_220x220.SLDPRT
Drawings/3D_Printer_Rev_02/Ticari/KFL08_Yatak/KFL08.3dm
Drawings/3D_Printer_Rev_02/Ticari/KFL08_Yatak/KFL08.igs
Drawings/3D_Printer_Rev_02/Ticari/LeadScrew_AntiBacklash_tr8_trapezoidal/LeadScrew_AntiBacklash_tr8x2_Trapezodial.SLDASM
Drawings/3D_Printer_Rev_02/Ticari/LeadScrew_AntiBacklash_tr8_trapezoidal/TR08.iam
Drawings/3D_Printer_Rev_02/Ticari/LeadScrew_AntiBacklash_tr8_trapezoidal/TR08.stp
Drawings/3D_Printer_Rev_02/Ticari/LeadScrew_AntiBacklash_tr8_trapezoidal/nakretka tr08.ipt
Drawings/3D_Printer_Rev_02/Ticari/LeadScrew_AntiBacklash_tr8_trapezoidal/nakretka tr08.stp
Drawings/3D_Printer_Rev_02/Ticari/LeadScrew_AntiBacklash_tr8_trapezoidal/napinacz nakretki tr8.ipt
Drawings/3D_Printer_Rev_02/Ticari/LeadScrew_AntiBacklash_tr8_trapezoidal/napinacz nakretki tr8.stp
Drawings/3D_Printer_Rev_02/Ticari/LeadScrew_AntiBacklash_tr8_trapezoidal/sprezyna nakretka tr 8.ipt
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
