YazgacResearch/3DPrinter/Drawings/3D_Printer_Rev_02/ZZ_Assembly_Documents/01_Doc_Sub_Part-Grp_Assembly.PDF

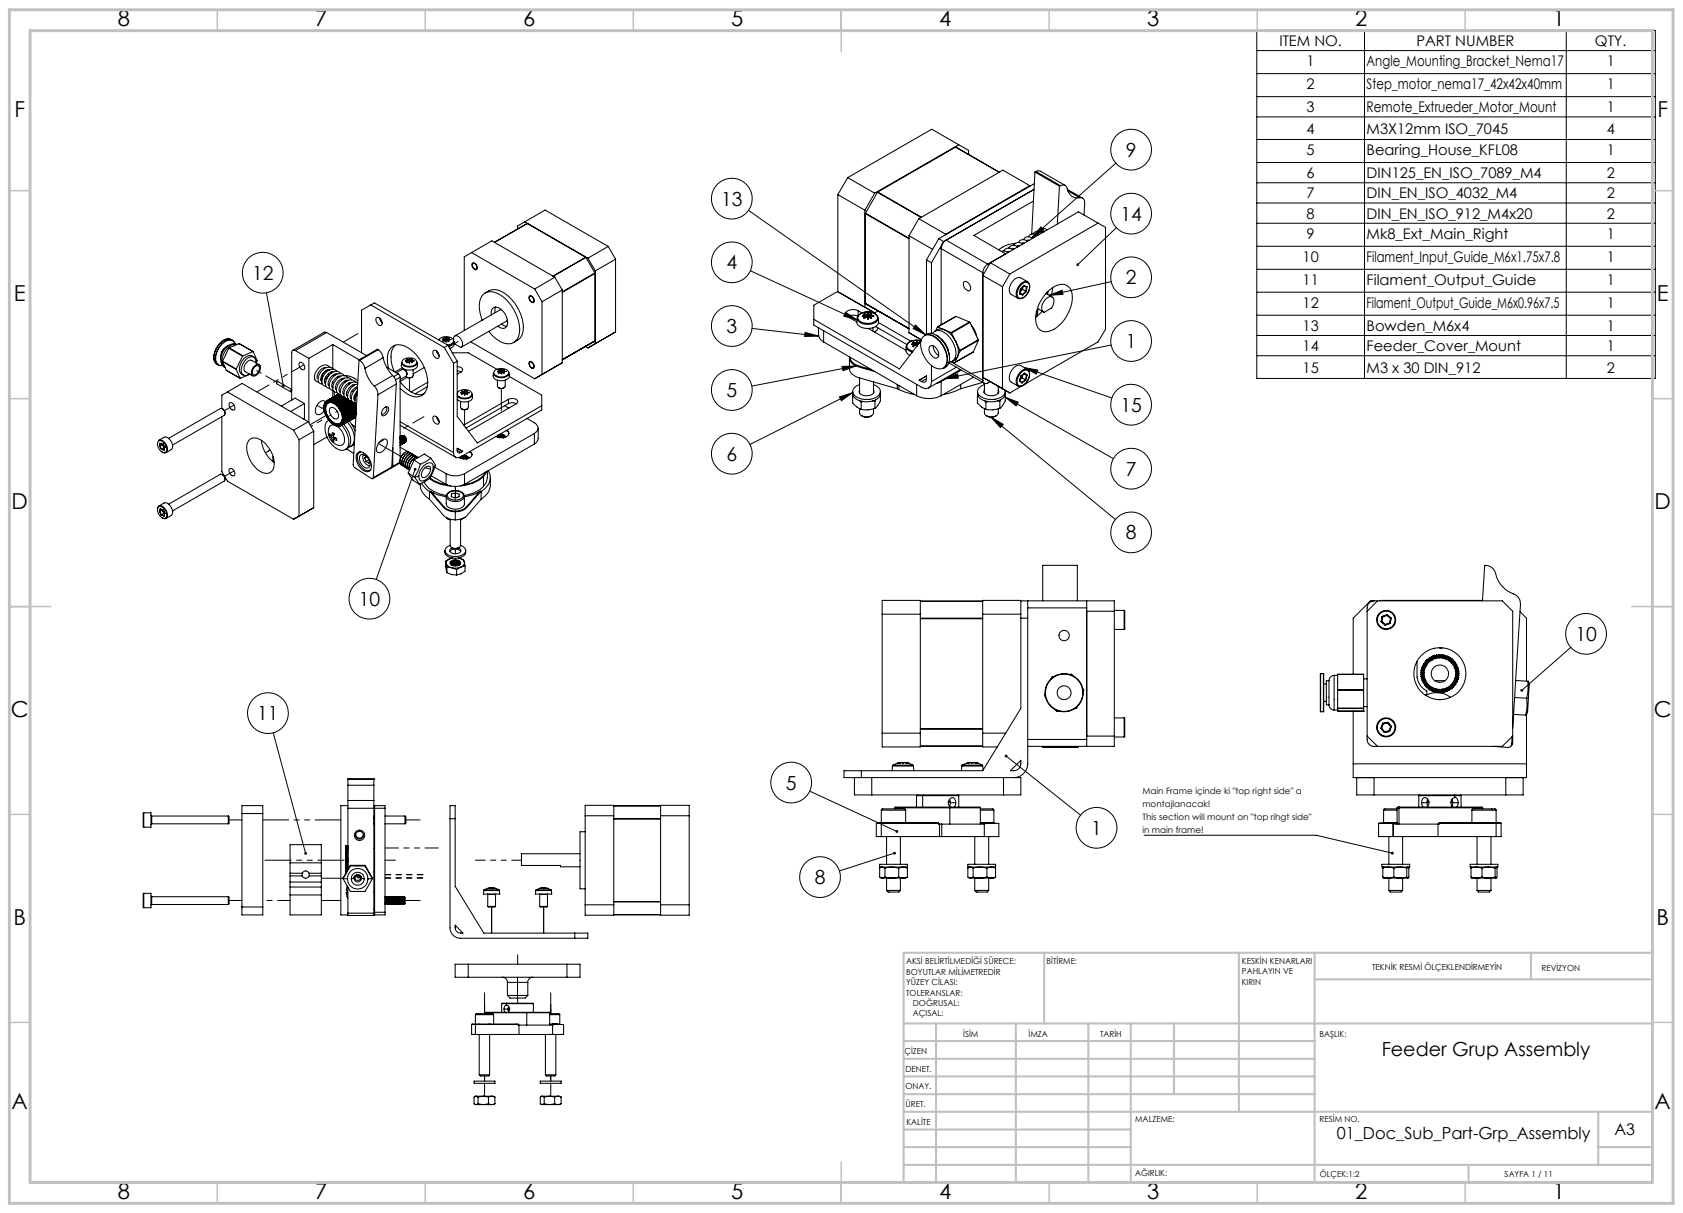
[picture p150: page 1]
in main frame!; ITEM NO.; PART NUMBER; QTY. 1; Angle_Mounting_Bracket_Nema17; Step_motor_nema17_42x42x40mm; Remote_Extrueder_Motor_Mount; M3X12mm ISO_7045; Bearing_House_KFL08; DIN125_EN_ISO_7089_M4; DIN_EN_ISO_4032_M4; DIN_EN_ISO_912_M4x20; Mk8_Ext_Main_Right; BİTİRME:; KESKİN KENARLARI; PAHLAYIN VE; TEKNİK RESMİ ÖLÇEKLENDİRMEYİN; REVİZYON; ÖLÇEK:1:2; SAYFA 1 / 11

10 | Filament_Input_Guide_M6x1.75x7.8 | 1
11 | Filament_Output_Guide | 1
12 | Filament_Output_Guide_M6x0.96x7.5 | 1
13 | Bowden_M6x4 | 1
14 | Feeder_Cover_Mount | 1
15 | M3 x 30 DIN_912 | 2

Main Frame içinde ki "top right side" a
montajlanacak!
This section will mount on "top rihgt side"

AKSİ BELİRTİLMEDİĞİ SÜRECE:
BOYUTLAR MİLİMETREDİR
YÜZEY CİLASI:
TOLERANSLAR:
DOĞRUSAL:
AÇISAL:

İSİM | İMZA | TARİH | | | | BAŞLIK: Feeder Grup Assembly

ÇİZEN
DENET.
ONAY.
ÜRET.
KALİTE | | | | MALZEME: | RESİM NO. 01_Doc_Sub_Part-Grp_Assembly | A3

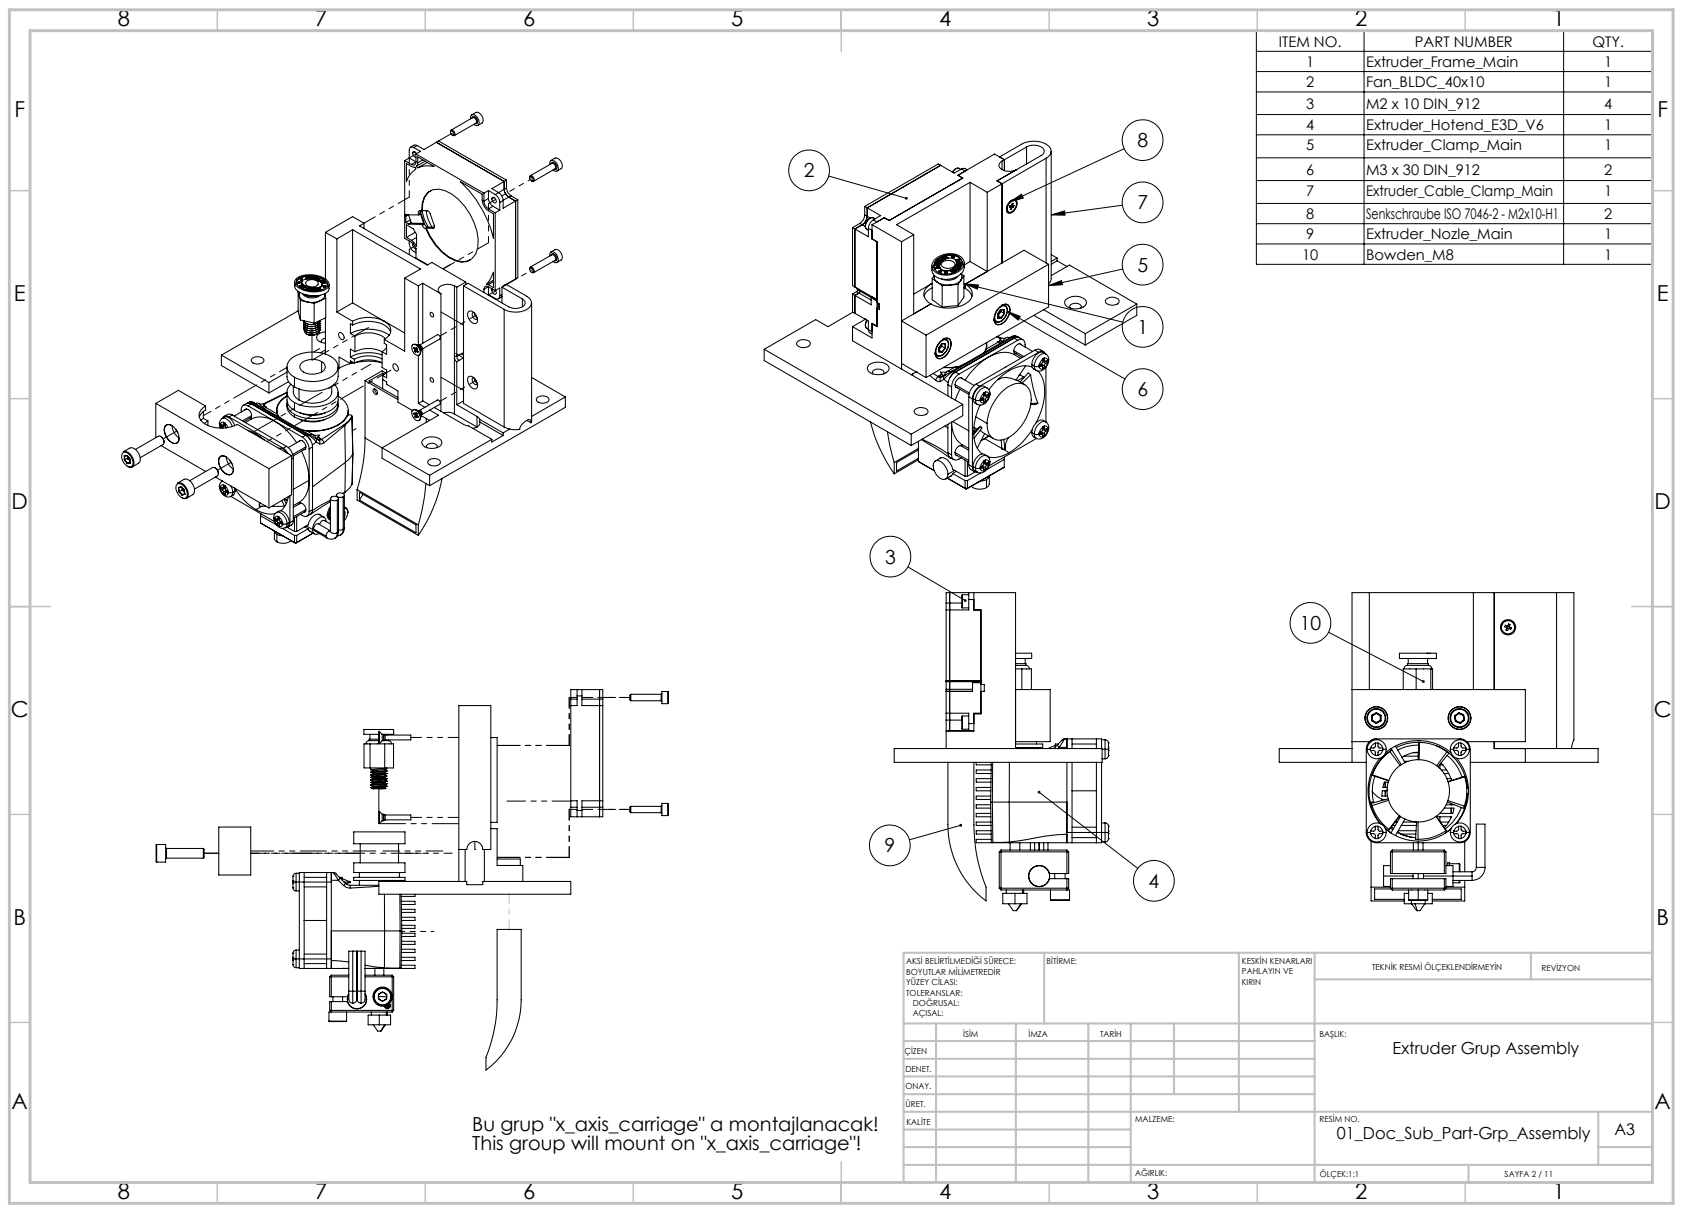
[picture p151: page 2]
BİTİRME:; KESKİN KENARLARI; PAHLAYIN VE; TEKNİK RESMİ ÖLÇEKLENDİRMEYİN; REVİZYON; ÖLÇEK:1:1; SAYFA 2 / 11

ITEM NO. | PART NUMBER | QTY.
1 | Extruder_Frame_Main | 1
2 | Fan_BLDC_40x10 | 1
3 | M2 x 10 DIN_912 | 4
4 | Extruder_Hotend_E3D_V6 | 1
5 | Extruder_Clamp_Main | 1
6 | M3 x 30 DIN_912 | 2
7 | Extruder_Cable_Clamp_Main | 1
8 | Senkschraube ISO 7046-2 - M2x10-H1 | 2
9 | Extruder_Nozle_Main | 1
10 | Bowden_M8 | 1

AKSİ BELİRTİLMEDİĞİ SÜRECE:
BOYUTLAR MİLİMETREDİR
YÜZEY CİLASI:
TOLERANSLAR:
DOĞRUSAL:
AÇISAL:

İSİM | İMZA | TARİH | BAŞLIK: Extruder Grup Assembly

ÇİZEN
DENET.
ONAY.
ÜRET.

Bu grup "x_axis_carriage" a montajlanacak!
This group will mount on "x_axis_carriage"!

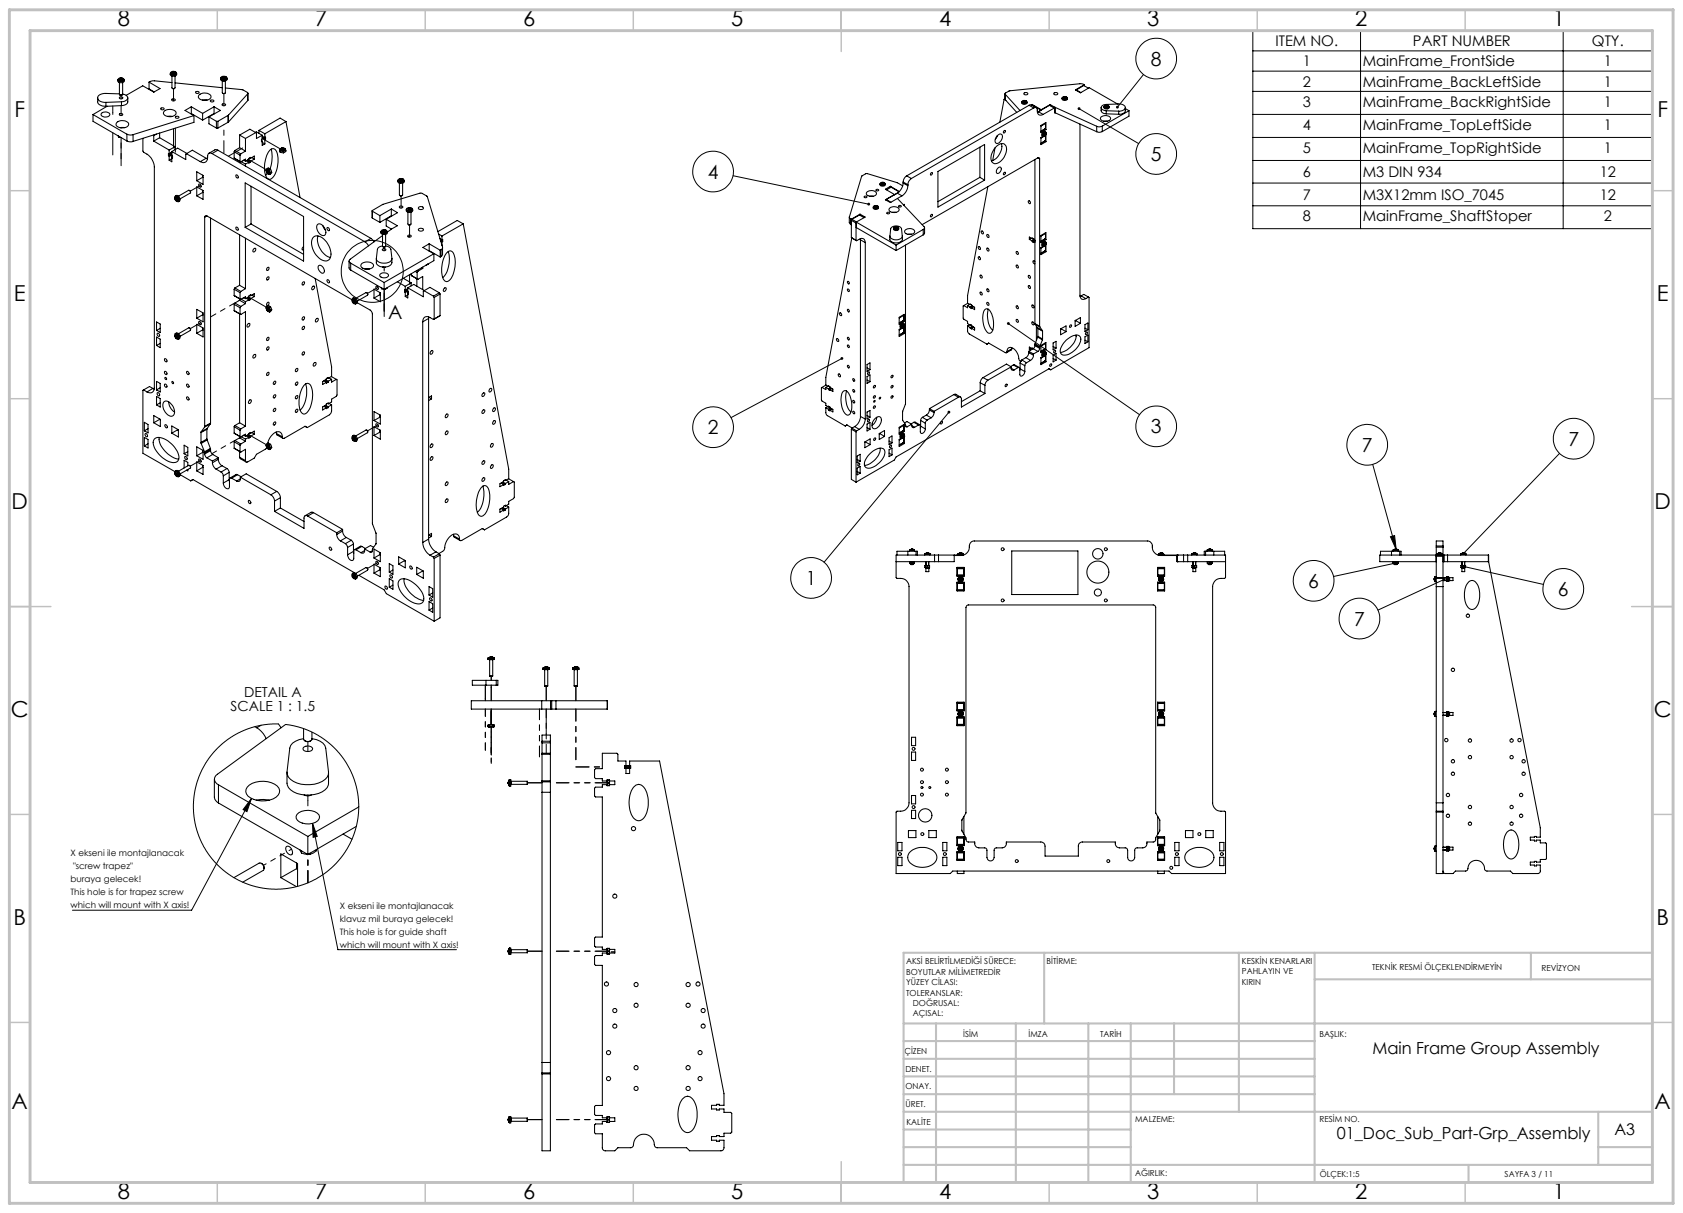
[picture p152: page 3]
DETAIL A SCALE 1 : 1.5; which will mount with X axis!; X ekseni ile montajlanacak; BİTİRME:; KESKİN KENARLARI; PAHLAYIN VE; TEKNİK RESMİ ÖLÇEKLENDİRMEYİN; REVİZYON; ÖLÇEK:1:5; SAYFA 3 / 11

1 | MainFrame_FrontSide | 1
2 | MainFrame_BackLeftSide | 1
3 | MainFrame_BackRightSide | 1
4 | MainFrame_TopLeftSide | 1
5 | MainFrame_TopRightSide | 1
6 | M3 DIN 934 | 12
7 | M3X12mm ISO_7045 | 12
8 | MainFrame_ShaftStoper | 2

X ekseni ile montajlanacak
"screw trapez"
buraya gelecek!
This hole is for trapez screw

klavuz mil buraya gelecek!
This hole is for guide shaft
which will mount with X axis!

AKSİ BELİRTİLMEDİĞİ SÜRECE:
BOYUTLAR MİLİMETREDİR
YÜZEY CİLASI:
TOLERANSLAR:
DOĞRUSAL:
AÇISAL:

İSİM | İMZA | TARİH | BAŞLIK: Main Frame Group Assembly

ÇİZEN
DENET.
ONAY.
ÜRET.

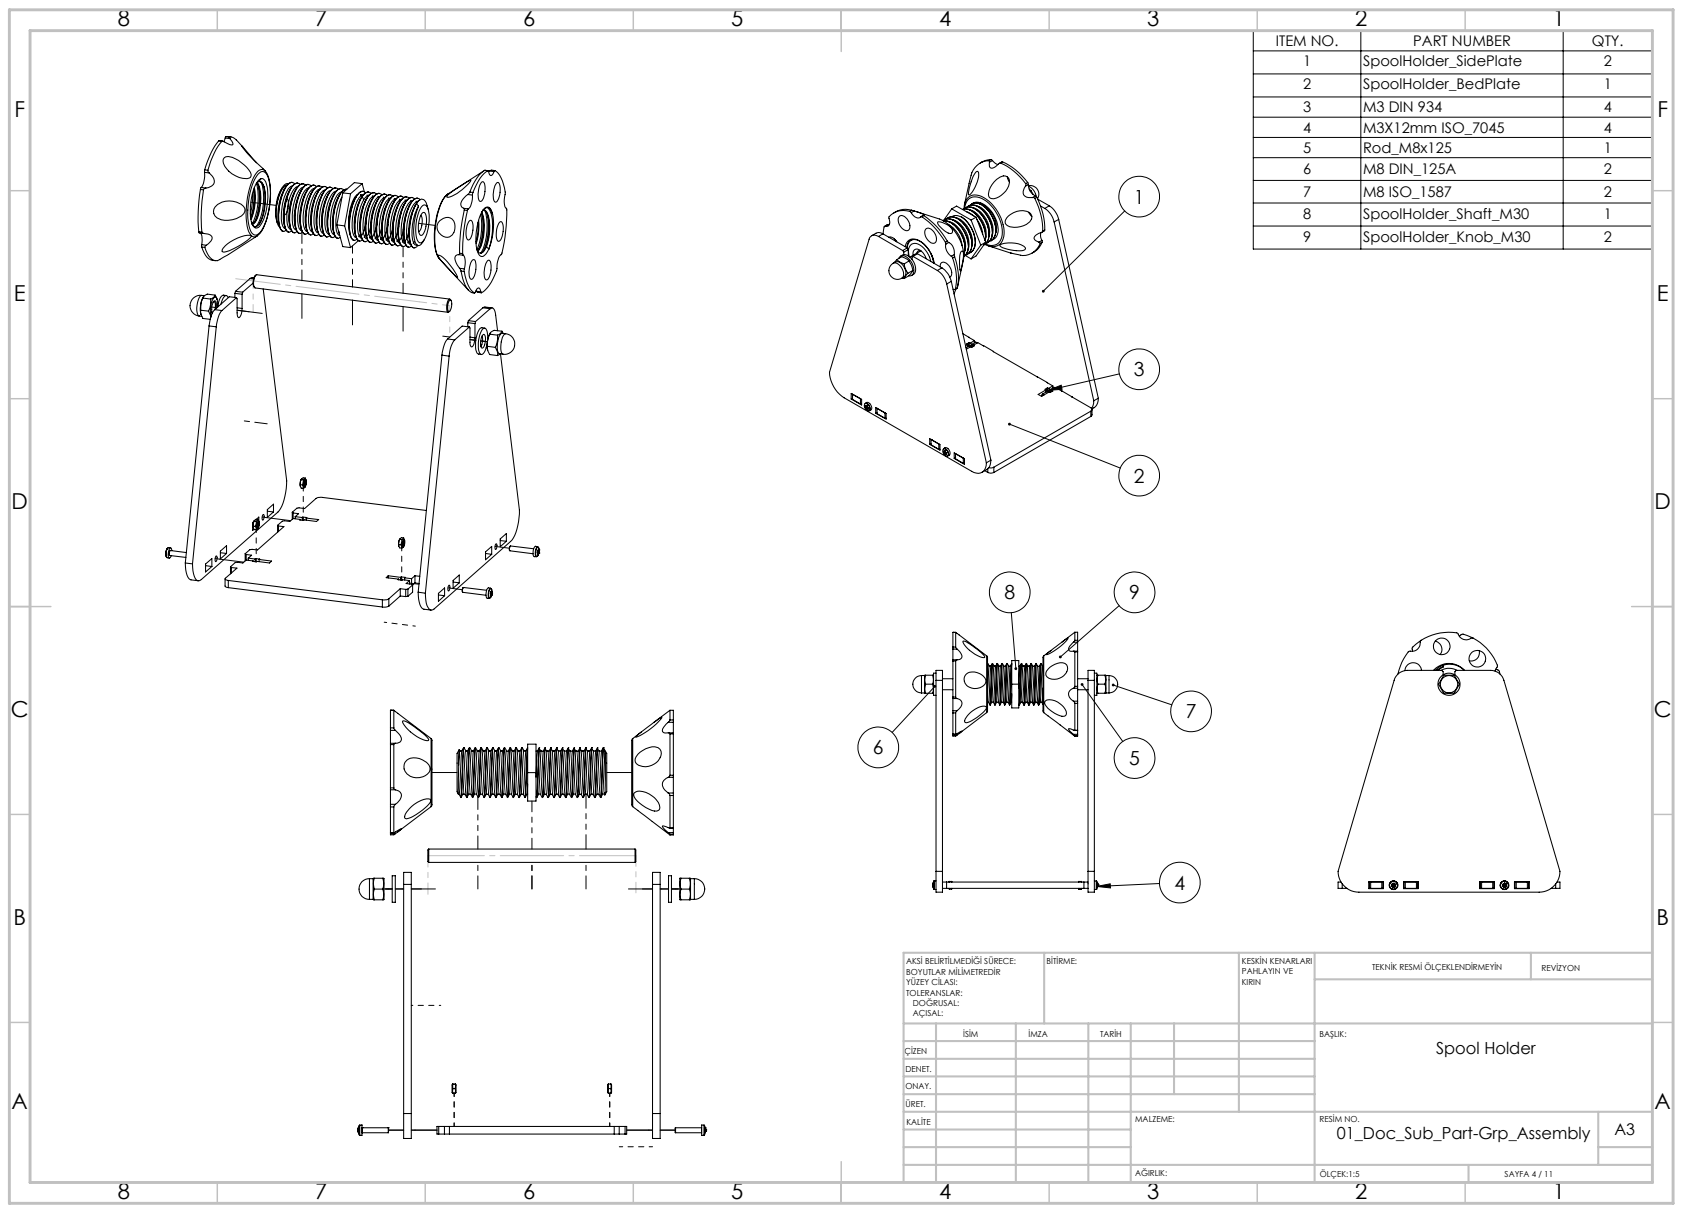
[picture p153: page 4]
BİTİRME:; KESKİN KENARLARI; PAHLAYIN VE; TEKNİK RESMİ ÖLÇEKLENDİRMEYİN; REVİZYON; ÖLÇEK:1:5; SAYFA 4 / 11

1 | SpoolHolder_SidePlate | 2
2 | SpoolHolder_BedPlate | 1
3 | M3 DIN 934 | 4
4 | M3X12mm ISO_7045 | 4
5 | Rod_M8x125 | 1
6 | M8 DIN_125A | 2
7 | M8 ISO_1587 | 2
8 | SpoolHolder_Shaft_M30 | 1
9 | SpoolHolder_Knob_M30 | 2

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

İSİM | İMZA | TARİH | BAŞLIK: Spool Holder

ÇİZEN
DENET.
ONAY.
ÜRET.

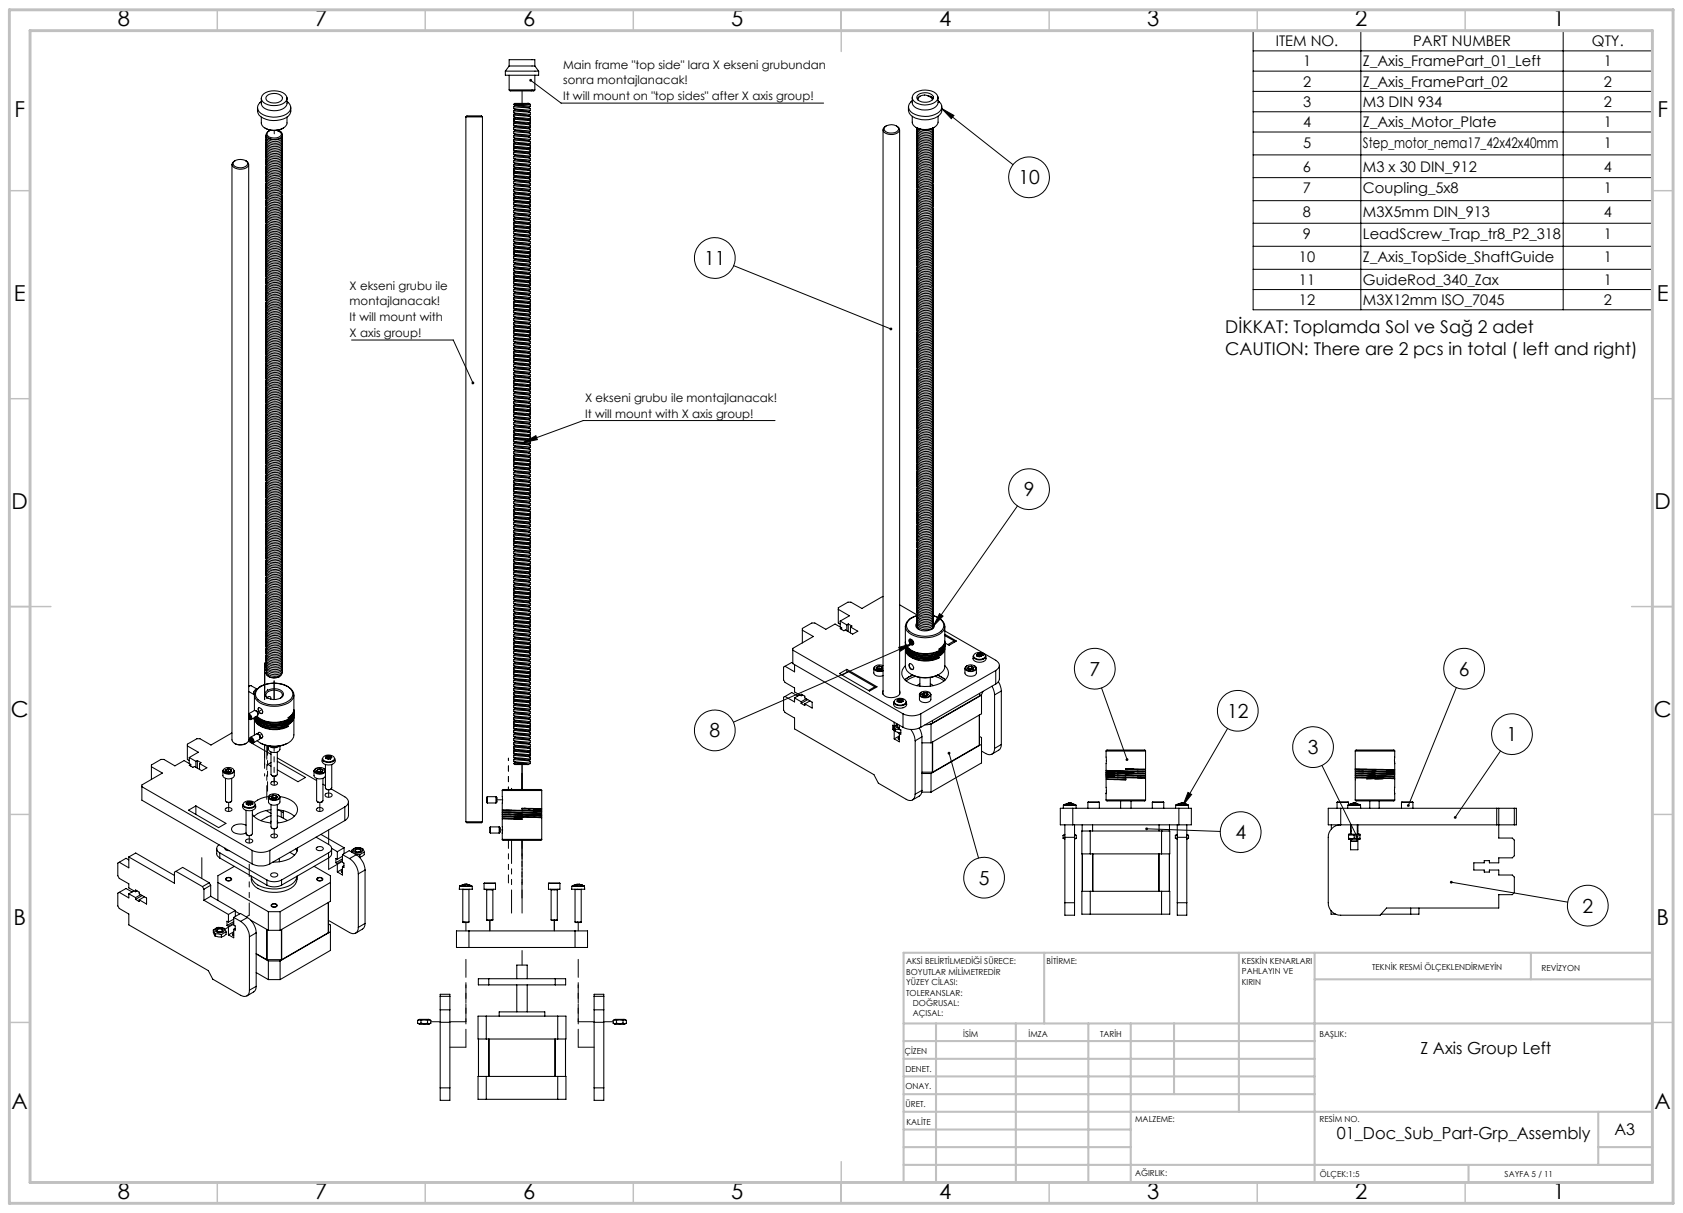
[picture p154: page 5]
X axis group!; DİKKAT: Toplamda Sol ve Sağ 2 adet; BİTİRME:; KESKİN KENARLARI; PAHLAYIN VE; TEKNİK RESMİ ÖLÇEKLENDİRMEYİN; REVİZYON; ÖLÇEK:1:5; SAYFA 5 / 11

1 | Z_Axis_FramePart_01_Left | 1
2 | Z_Axis_FramePart_02 | 2
3 | M3 DIN 934 | 2
4 | Z_Axis_Motor_Plate | 1
5 | Step_motor_nema17_42x42x40mm | 1
6 | M3 x 30 DIN_912 | 4
7 | Coupling_5x8 | 1
8 | M3X5mm DIN_913 | 4
9 | LeadScrew_Trap_tr8_P2_318 | 1
10 | Z_Axis_TopSide_ShaftGuide | 1
11 | GuideRod_340_Zax | 1
12 | M3X12mm ISO_7045 | 2

Main frame "top side" lara X ekseni grubundan
sonra montajlanacak!
It will mount on "top sides" after X axis group!

X ekseni grubu ile
montajlanacak!
It will mount with

CAUTION: There are 2 pcs in total ( left and right)

X ekseni grubu ile montajlanacak!
It will mount with X axis group!

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

İSİM | İMZA | TARİH | BAŞLIK: Z Axis Group Left

ÇİZEN
DENET.
ONAY.
ÜRET.

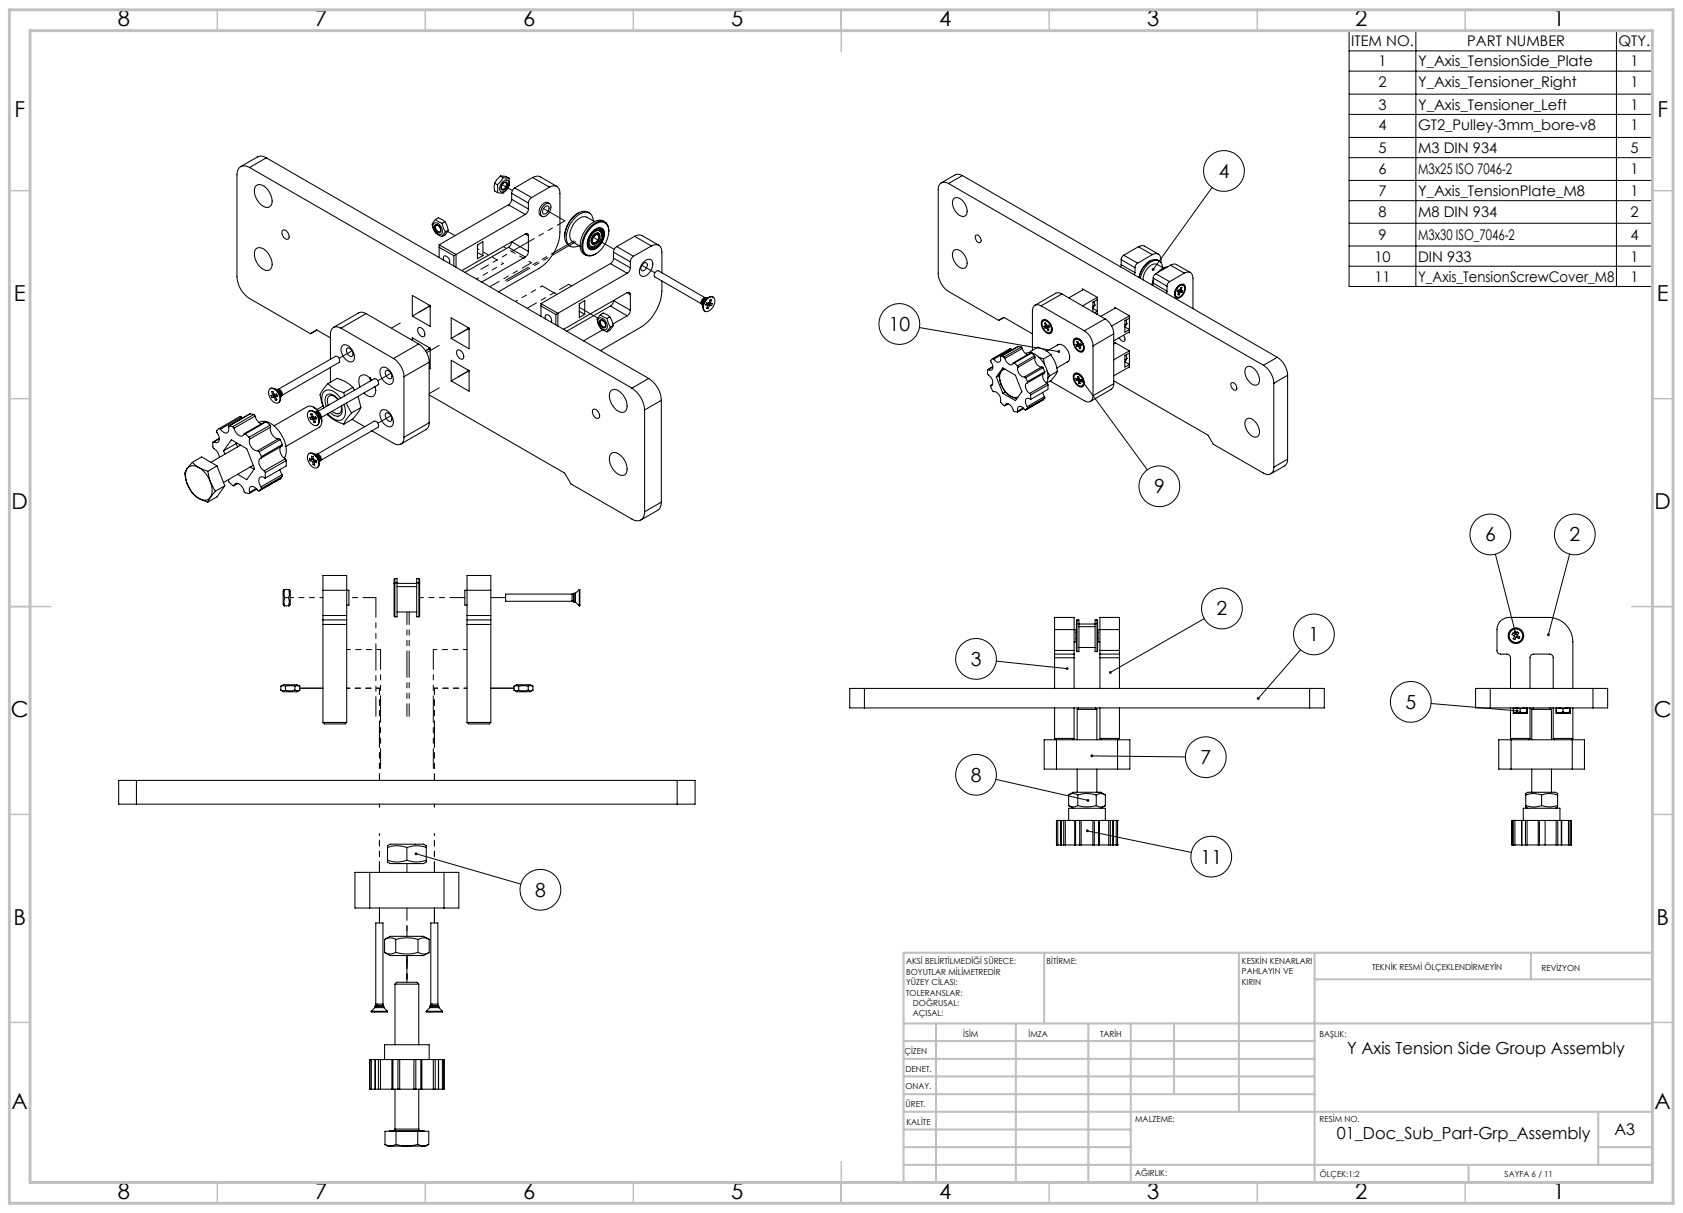
[picture p155: page 6]
ITEM NO.; PART NUMBER; QTY. 1; Y_Axis_TensionSide_Plate; Y_Axis_Tensioner_Right; Y_Axis_Tensioner_Left; GT2_Pulley-3mm_bore-v8; M3 DIN 934; M3x25 ISO 7046-2; Y_Axis_TensionPlate_M8; M8 DIN 934; M3x30 ISO_7046-2; BİTİRME:; KESKİN KENARLARI; PAHLAYIN VE; TEKNİK RESMİ ÖLÇEKLENDİRMEYİN; REVİZYON; ÖLÇEK:1:2; SAYFA 6 / 11

10 | DIN 933 | 1
11 | Y_Axis_TensionScrewCover_M8 | 1

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

İSİM | İMZA | TARİH | BAŞLIK: Y Axis Tension Side Group Assembly

ÇİZEN
DENET.
ONAY.
ÜRET.

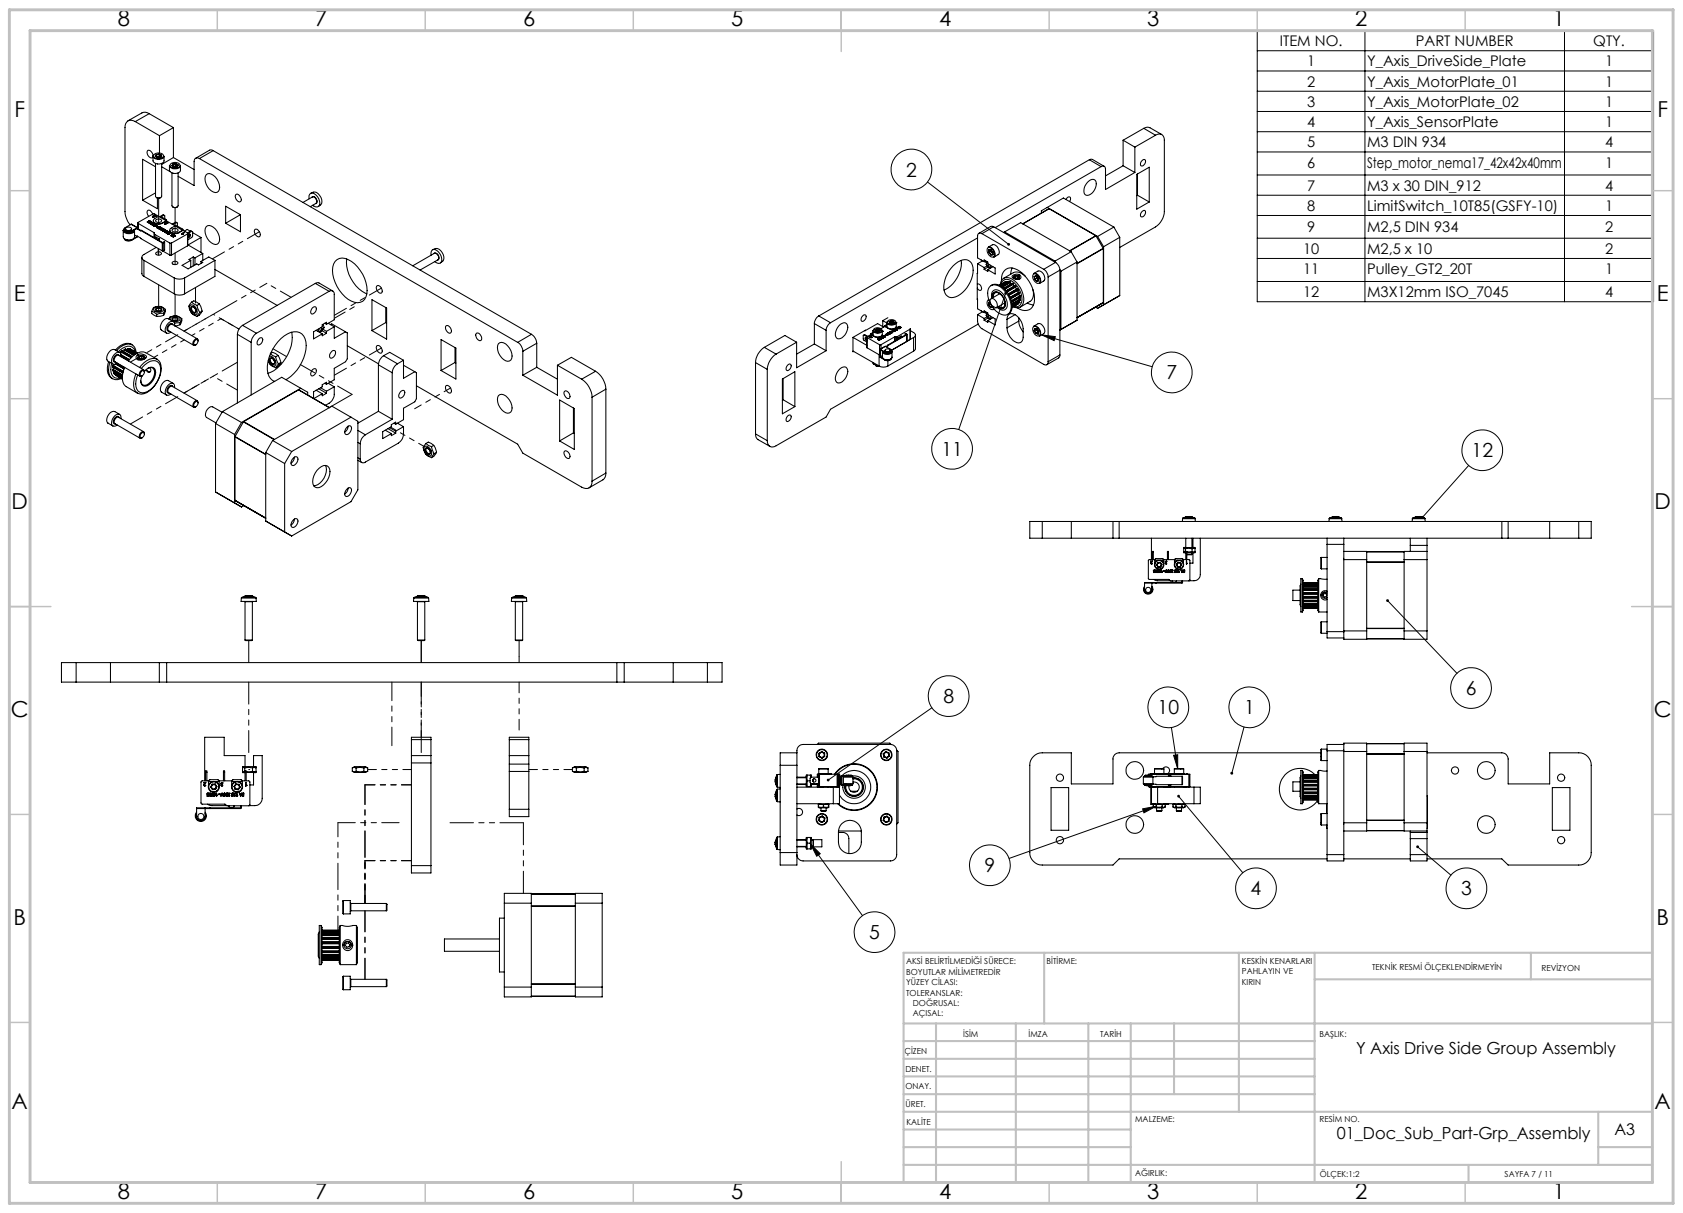
[picture p156: page 7]
BİTİRME:; KESKİN KENARLARI; PAHLAYIN VE; TEKNİK RESMİ ÖLÇEKLENDİRMEYİN; REVİZYON; ÖLÇEK:1:2; SAYFA 7 / 11

1 | Y_Axis_DriveSide_Plate | 1
2 | Y_Axis_MotorPlate_01 | 1
3 | Y_Axis_MotorPlate_02 | 1
4 | Y_Axis_SensorPlate | 1
5 | M3 DIN 934 | 4
6 | Step_motor_nema17_42x42x40mm | 1
7 | M3 x 30 DIN_912 | 4
8 | LimitSwitch_10T85(GSFY-10) | 1
9 | M2,5 DIN 934 | 2
10 | M2,5 x 10 | 2
11 | Pulley_GT2_20T | 1
12 | M3X12mm ISO_7045 | 4

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

İSİM | İMZA | TARİH | BAŞLIK: Y Axis Drive Side Group Assembly

ÇİZEN
DENET.
ONAY.
ÜRET.

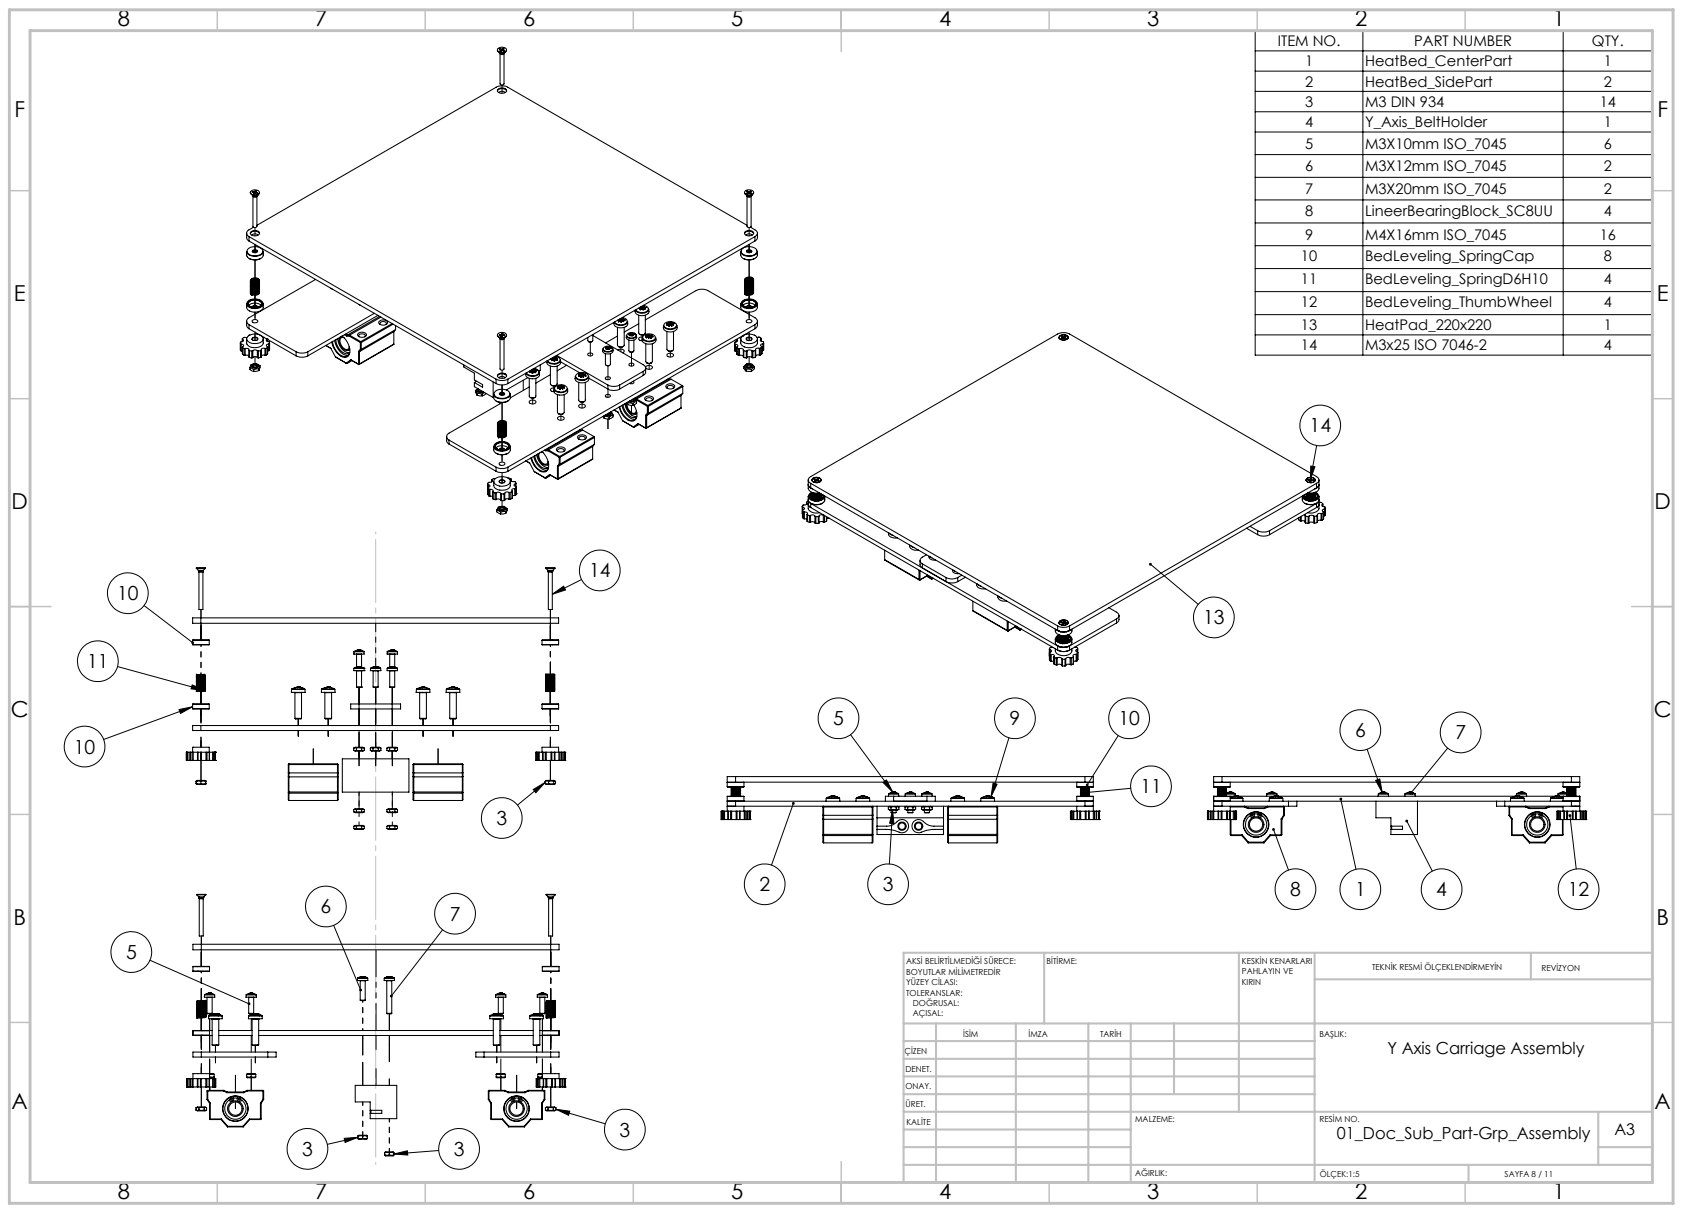
[picture p157: page 8]
ITEM NO.; PART NUMBER; QTY. 1; HeatBed_CenterPart; HeatBed_SidePart; M3 DIN 934; Y_Axis_BeltHolder; M3X10mm ISO_7045; M3X12mm ISO_7045; M3X20mm ISO_7045; LineerBearingBlock_SC8UU; M4X16mm ISO_7045; BİTİRME:; KESKİN KENARLARI; PAHLAYIN VE; TEKNİK RESMİ ÖLÇEKLENDİRMEYİN; REVİZYON; ÖLÇEK:1:5; SAYFA 8 / 11

10 | BedLeveling_SpringCap | 8
11 | BedLeveling_SpringD6H10 | 4
12 | BedLeveling_ThumbWheel | 4
13 | HeatPad_220x220 | 1
14 | M3x25 ISO 7046-2 | 4

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

İSİM | İMZA | TARİH | BAŞLIK: Y Axis Carriage Assembly

ÇİZEN
DENET.
ONAY.
ÜRET.

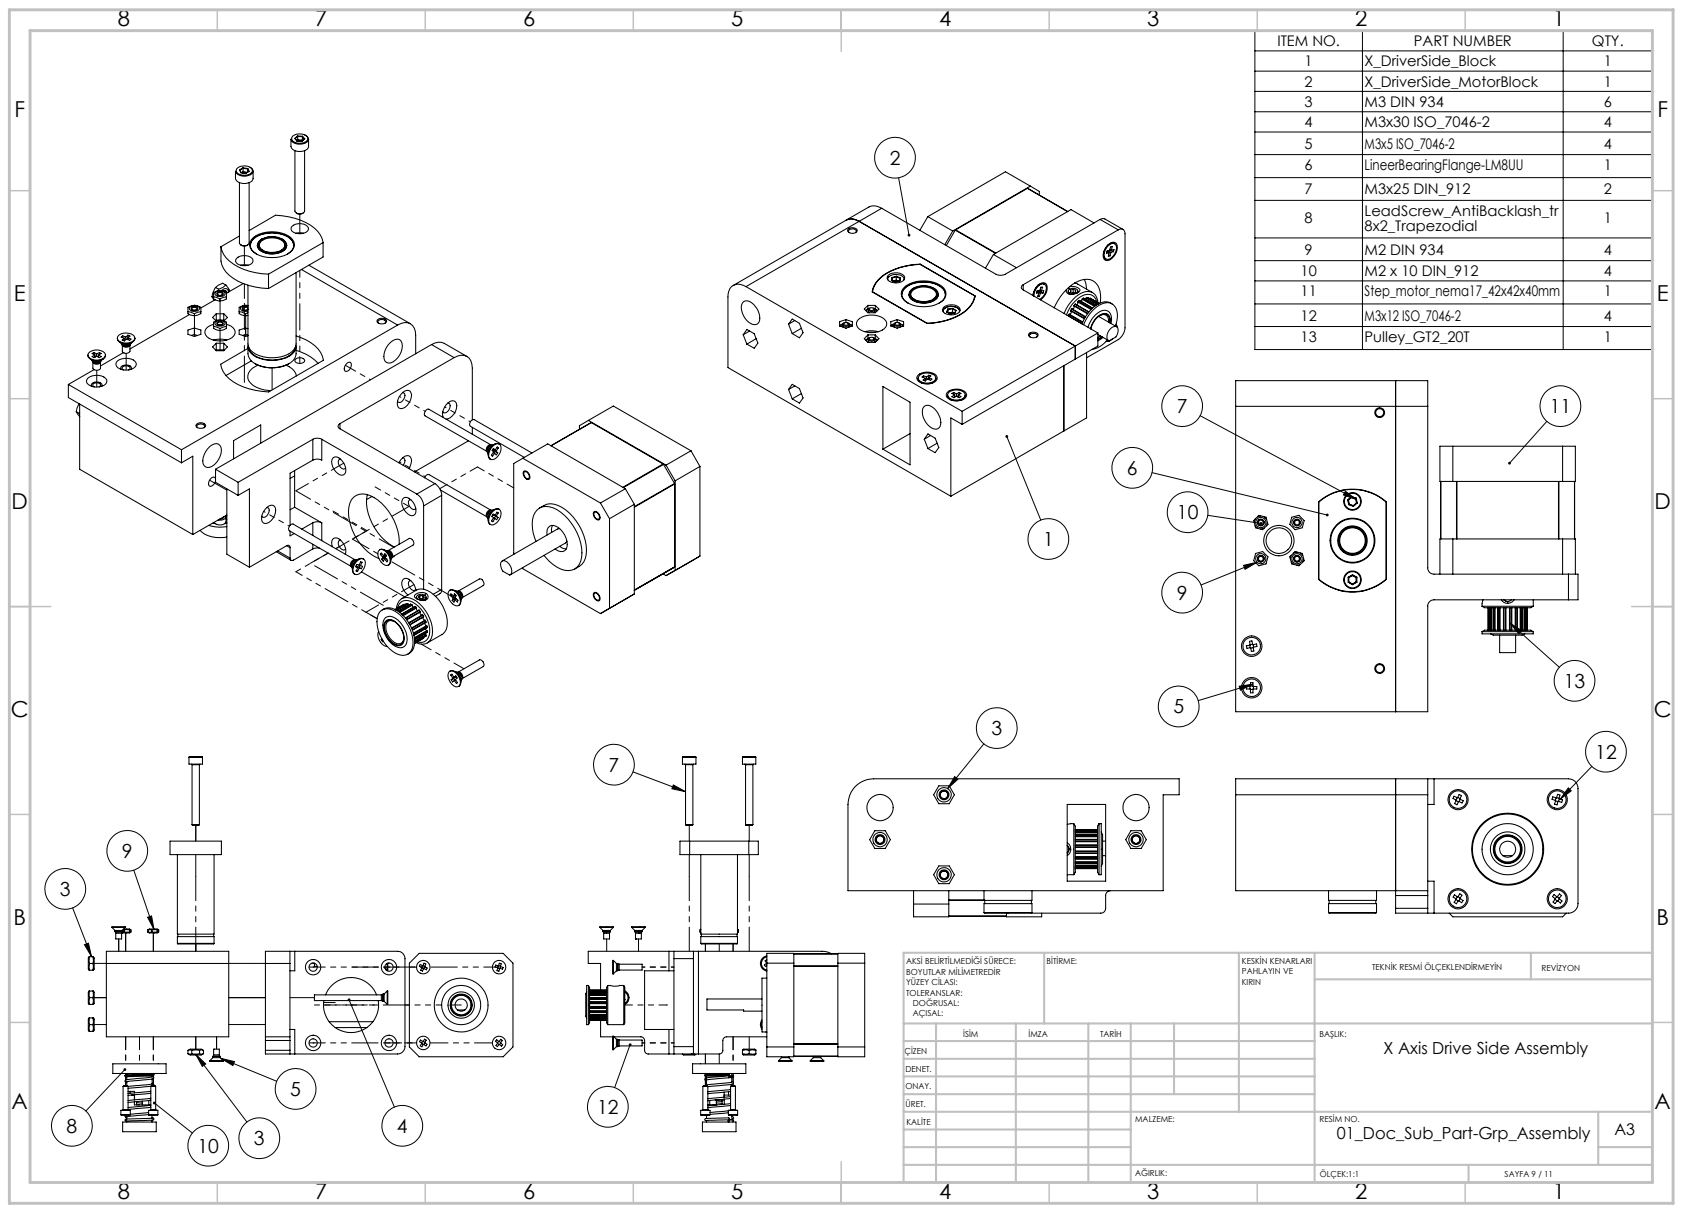
[picture p158: page 9]
ITEM NO.; PART NUMBER; QTY. 1; X_DriverSide_Block; X_DriverSide_MotorBlock; M3 DIN 934; M3x30 ISO_7046-2; M3x5 ISO_7046-2; LineerBearingFlange-LM8UU; M3x25 DIN_912; LeadScrew_AntiBacklash_tr; BİTİRME:; KESKİN KENARLARI; PAHLAYIN VE; TEKNİK RESMİ ÖLÇEKLENDİRMEYİN; REVİZYON; ÖLÇEK:1:1; SAYFA 9 / 11

8x2_Trapezodial | 1

9 | M2 DIN 934 | 4
10 | M2 x 10 DIN_912 | 4
11 | Step_motor_nema17_42x42x40mm | 1
12 | M3x12 ISO_7046-2 | 4
13 | Pulley_GT2_20T | 1

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

İSİM | İMZA | TARİH | BAŞLIK: X Axis Drive Side Assembly

ÇİZEN
DENET.
ONAY.
ÜRET.

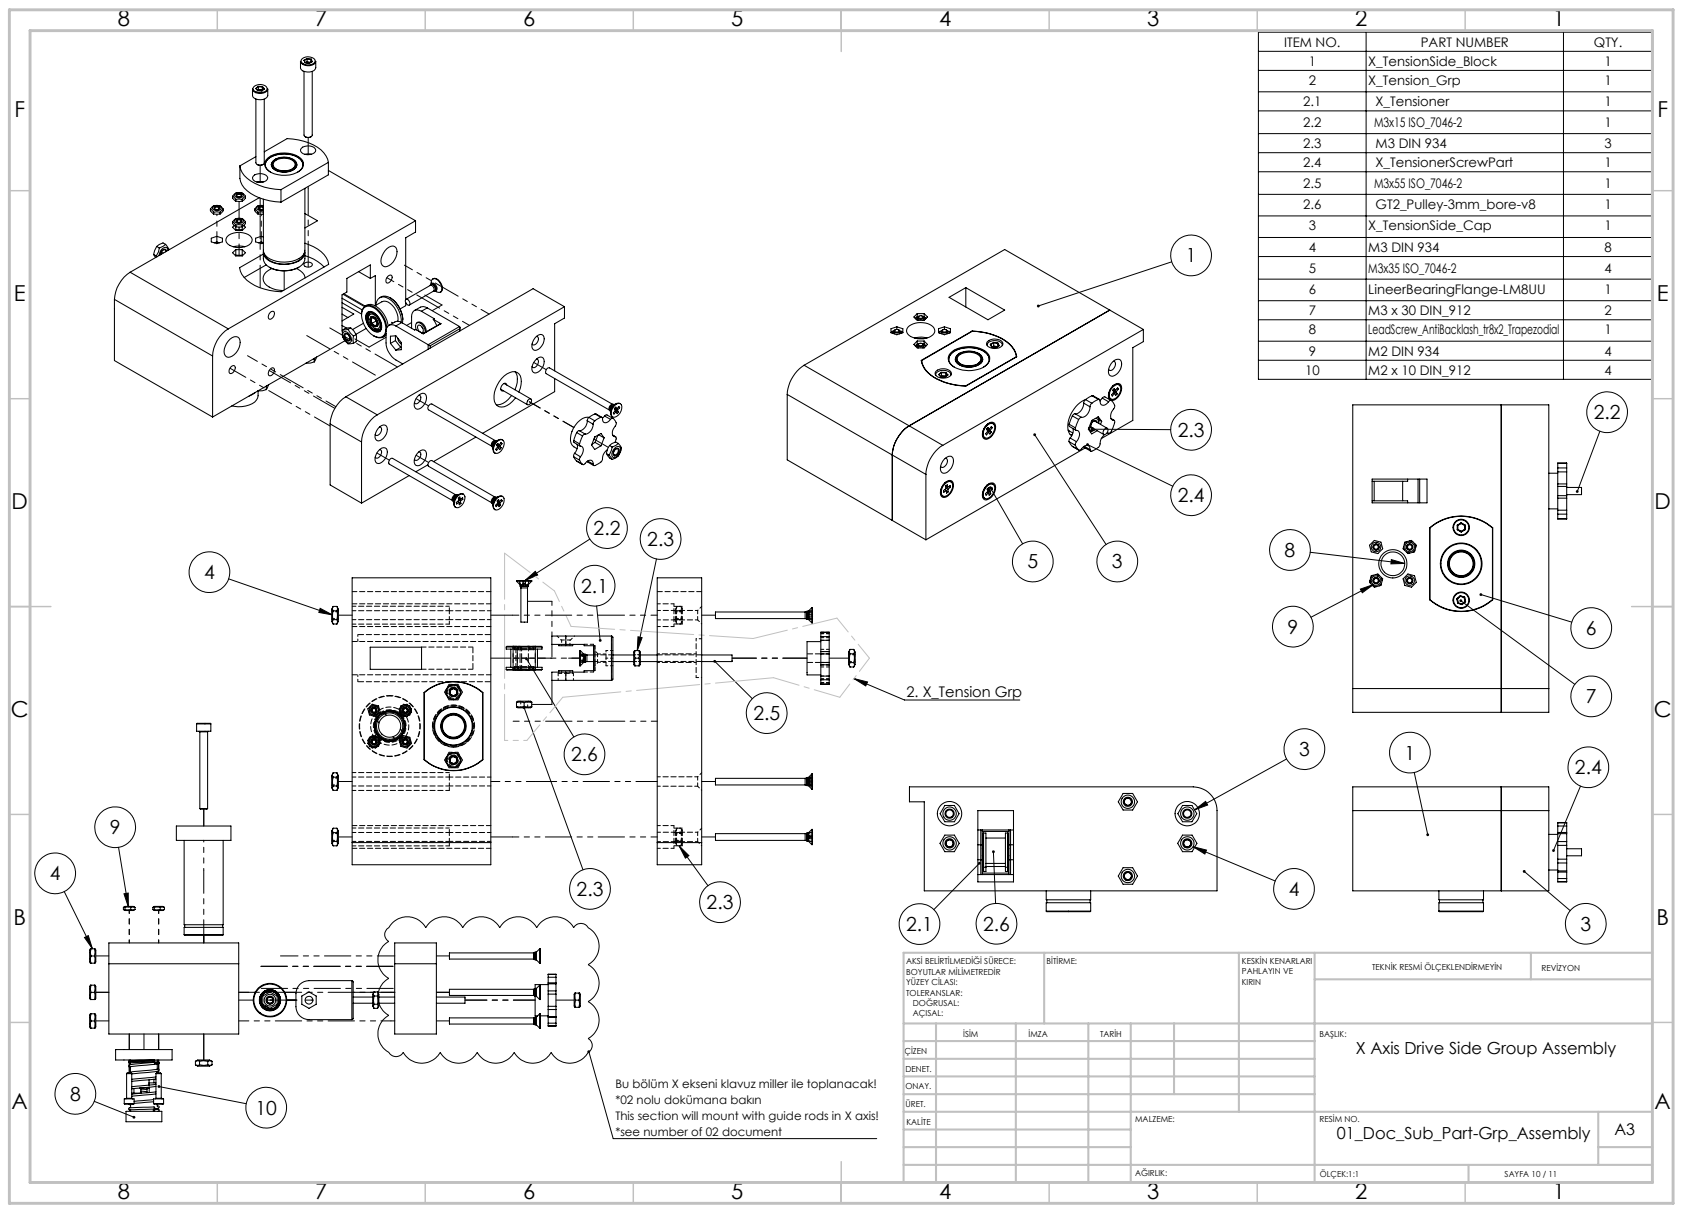
[picture p159: page 10]
2. X_Tension Grp; BİTİRME:; KESKİN KENARLARI; PAHLAYIN VE; TEKNİK RESMİ ÖLÇEKLENDİRMEYİN; REVİZYON; ÖLÇEK:1:1; SAYFA 10 / 11

1 | X_TensionSide_Block | 1
2 | X_Tension_Grp | 1
2.1 | X_Tensioner | 1
2.2 | M3x15 ISO_7046-2 | 1
2.3 | M3 DIN 934 | 3
2.4 | X_TensionerScrewPart | 1
2.5 | M3x55 ISO_7046-2 | 1
2.6 | GT2_Pulley-3mm_bore-v8 | 1
3 | X_TensionSide_Cap | 1
4 | M3 DIN 934 | 8
5 | M3x35 ISO_7046-2 | 4
6 | LineerBearingFlange-LM8UU | 1
7 | M3 x 30 DIN_912 | 2
8 | LeadScrew_AntiBacklash_tr8x2_Trapezodial | 1
9 | M2 DIN 934 | 4
10 | M2 x 10 DIN_912 | 4

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

İSİM | İMZA | TARİH | BAŞLIK: X Axis Drive Side Group Assembly

ÇİZEN
DENET.
ONAY.
ÜRET.

Bu bölüm X ekseni klavuz miller ile toplanacak!
*02 nolu dokümana bakın
This section will mount with guide rods in X axis!
*see number of 02 document

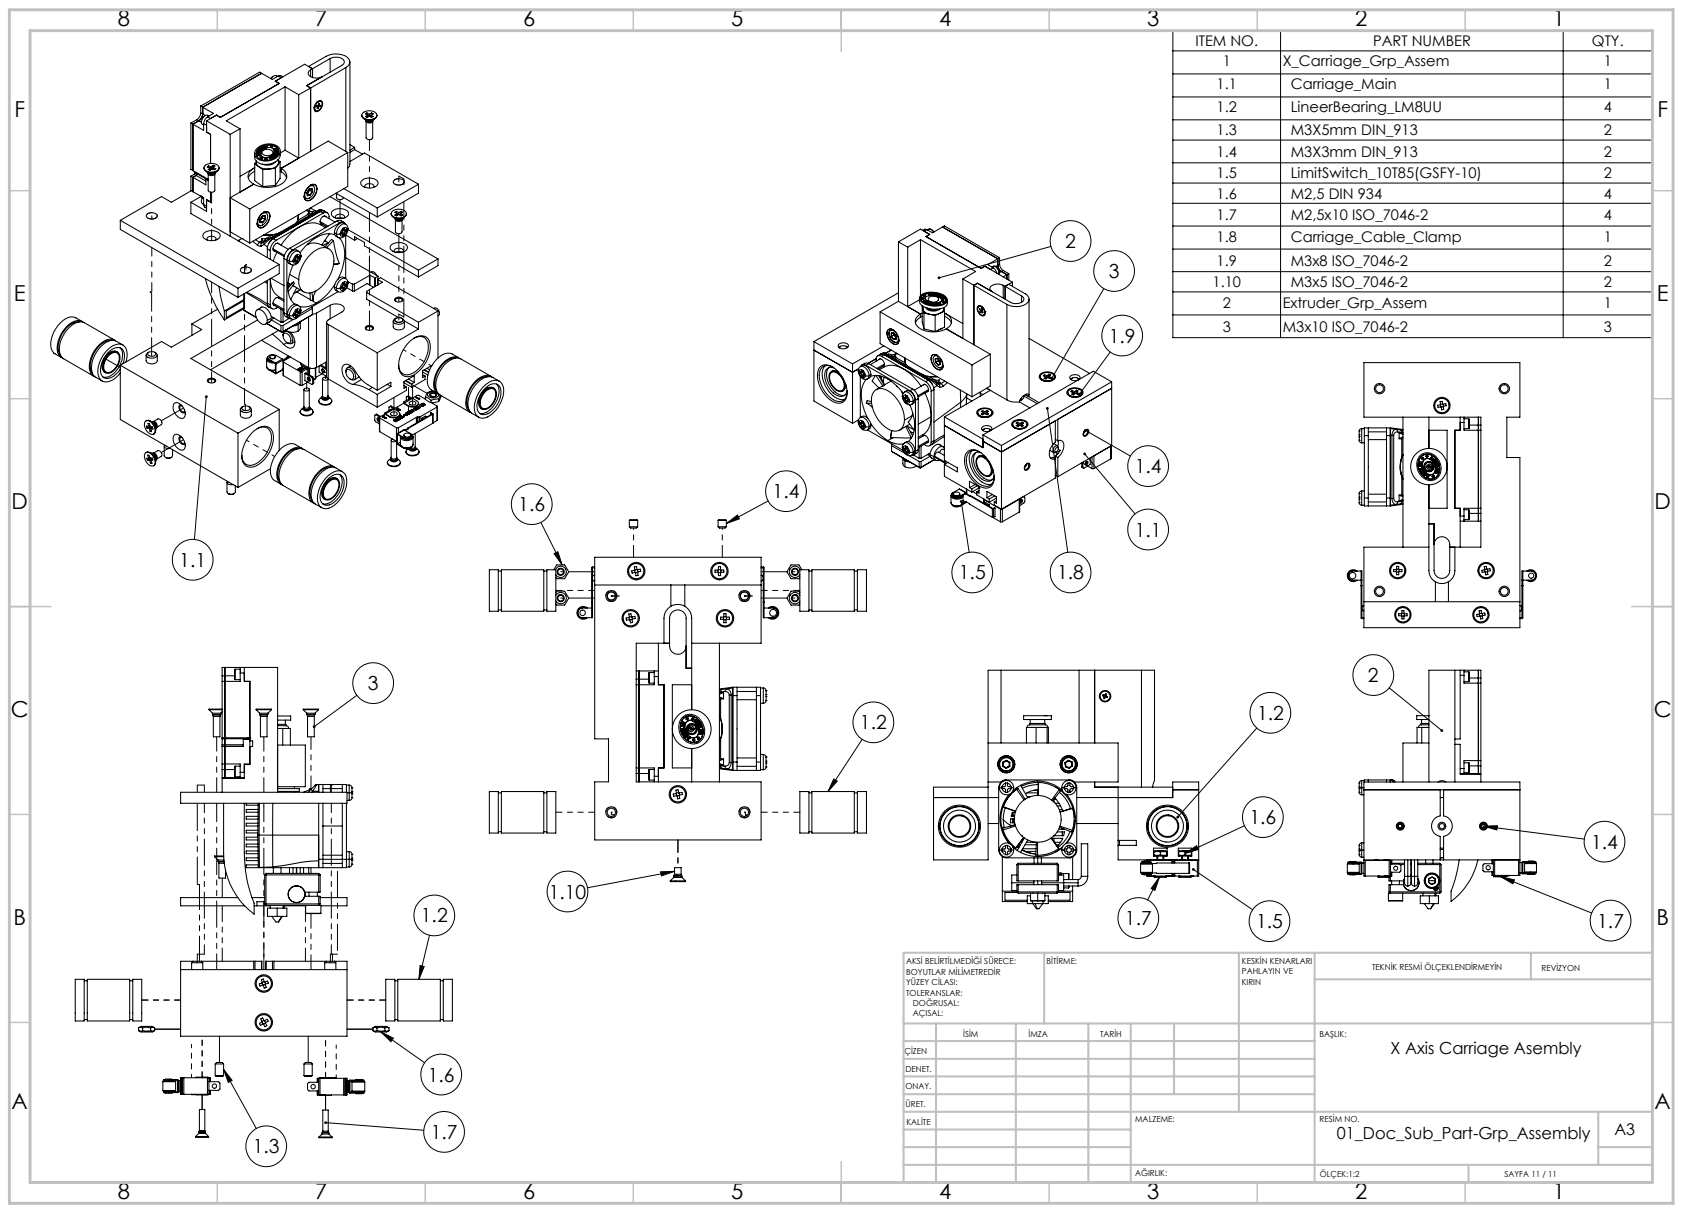
[picture p160: page 11]
BİTİRME:; KESKİN KENARLARI; PAHLAYIN VE; TEKNİK RESMİ ÖLÇEKLENDİRMEYİN; REVİZYON; ÖLÇEK:1:2; SAYFA 11 / 11

1 | X_Carriage_Grp_Assem | 1
1.1 | Carriage_Main | 1
1.2 | LineerBearing_LM8UU | 4
1.3 | M3X5mm DIN_913 | 2
1.4 | M3X3mm DIN_913 | 2
1.5 | LimitSwitch_10T85(GSFY-10) | 2
1.6 | M2,5 DIN 934 | 4
1.7 | M2,5x10 ISO_7046-2 | 4
1.8 | Carriage_Cable_Clamp | 1
1.9 | M3x8 ISO_7046-2 | 2
1.10 | M3x5 ISO_7046-2 | 2
2 | Extruder_Grp_Assem | 1
3 | M3x10 ISO_7046-2 | 3

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

İSİM | İMZA | TARİH | BAŞLIK: X Axis Carriage Asembly

ÇİZEN
DENET.
ONAY.
ÜRET.
