YazgacResearch/3DPrinter/Drawings/3D_Printer_Rev_02/ZZ_Assembly_Documents/02_Doc_Sub_Group_Assembly.PDF

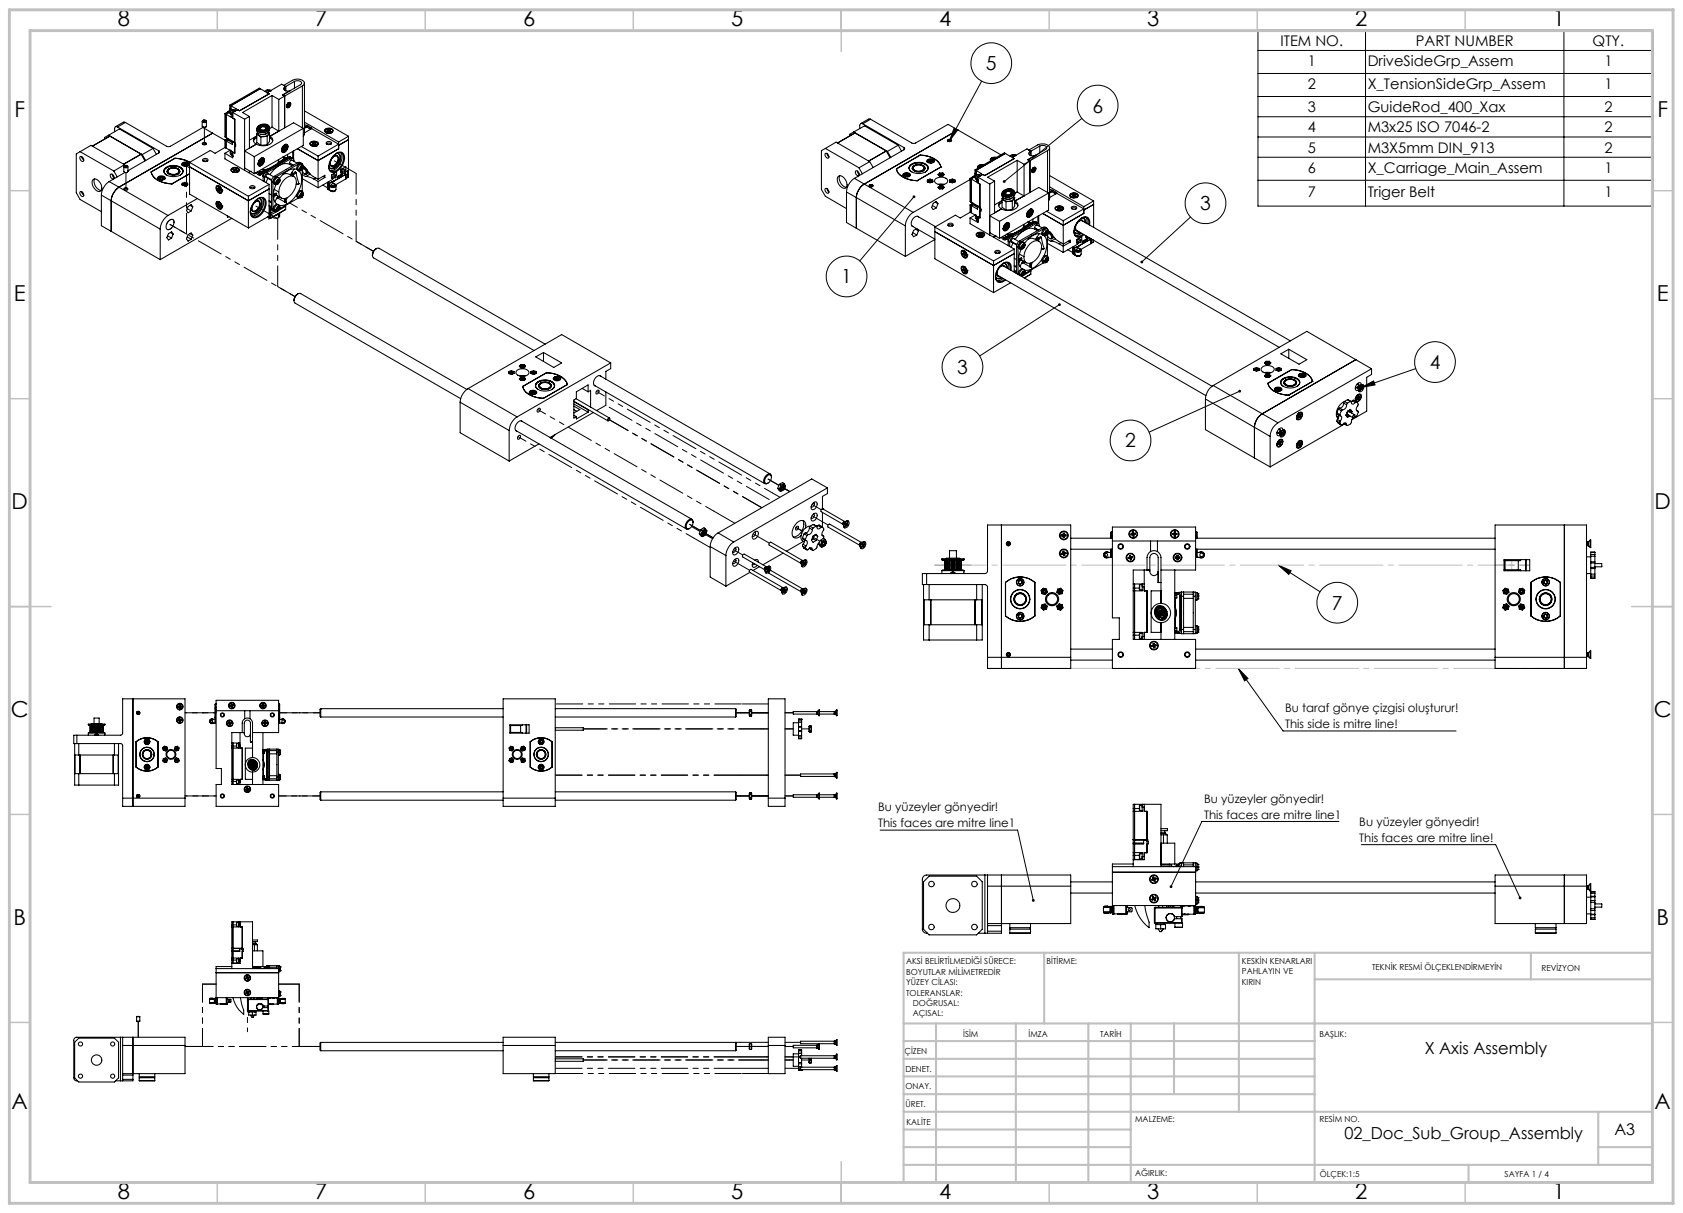
[picture p161: page 1]
BİTİRME:; KESKİN KENARLARI; PAHLAYIN VE; TEKNİK RESMİ ÖLÇEKLENDİRMEYİN; REVİZYON; ÖLÇEK:1:5; SAYFA 1 / 4

ITEM NO. | PART NUMBER | QTY.
1 | DriveSideGrp_Assem | 1
2 | X_TensionSideGrp_Assem | 1
3 | GuideRod_400_Xax | 2
4 | M3x25 ISO 7046-2 | 2
5 | M3X5mm DIN_913 | 2
6 | X_Carriage_Main_Assem | 1
7 | Triger Belt | 1

Bu taraf gönye çizgisi oluşturur!
This side is mitre line!

Bu yüzeyler gönyedir!

This faces are mitre line1 Bu yüzeyler gönyedir!
This faces are mitre line1

This faces are mitre line!

AKSİ BELİRTİLMEDİĞİ SÜRECE:
BOYUTLAR MİLİMETREDİR
YÜZEY CİLASI:
TOLERANSLAR:
DOĞRUSAL:
AÇISAL:

İSİM | İMZA | TARİH | | | | BAŞLIK: X Axis Assembly

ÇİZEN
DENET.
ONAY.
ÜRET.
KALİTE | | | | MALZEME: | RESİM NO. 02_Doc_Sub_Group_Assembly | A3

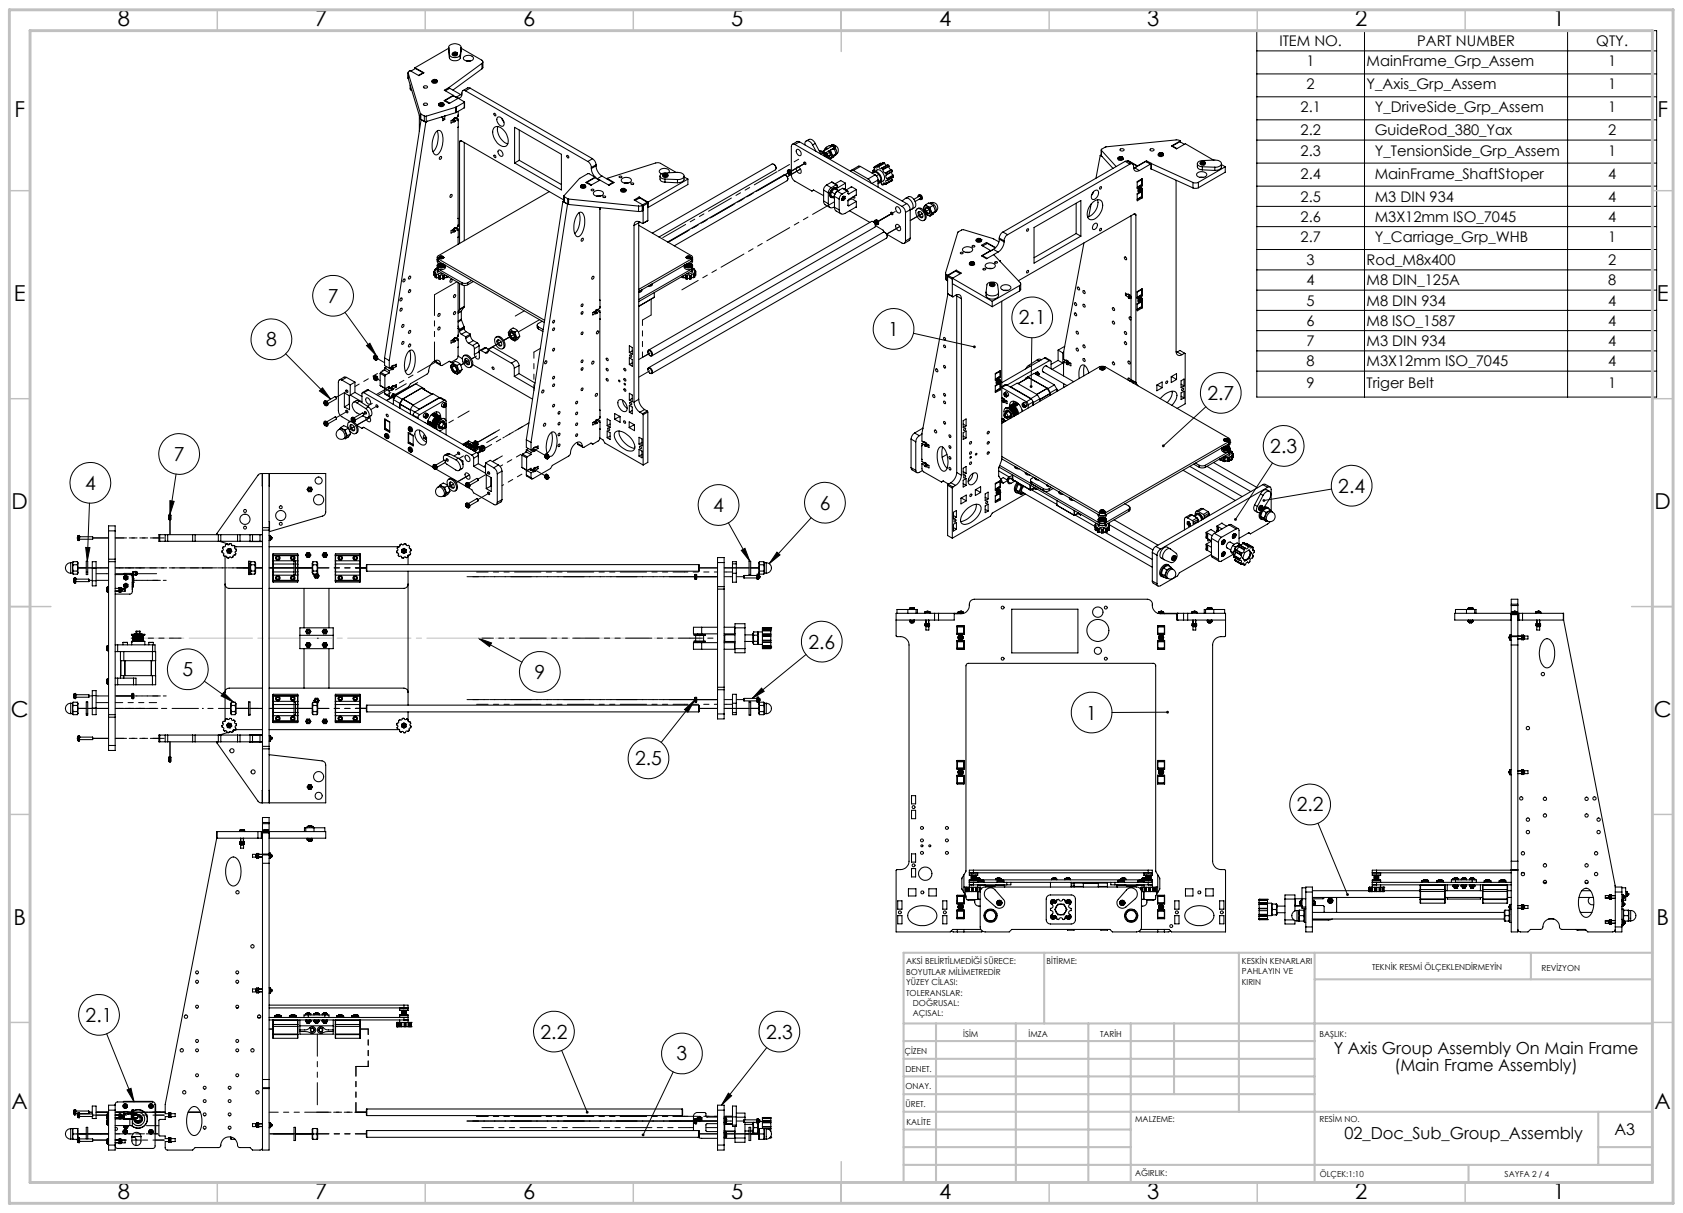
[picture p162: page 2]
BİTİRME:; KESKİN KENARLARI; PAHLAYIN VE; TEKNİK RESMİ ÖLÇEKLENDİRMEYİN; REVİZYON; ÖLÇEK:1:10; SAYFA 2 / 4

1 | MainFrame_Grp_Assem | 1
2 | Y_Axis_Grp_Assem | 1
2.1 | Y_DriveSide_Grp_Assem | 1
2.2 | GuideRod_380_Yax | 2
2.3 | Y_TensionSide_Grp_Assem | 1
2.4 | MainFrame_ShaftStoper | 4
2.5 | M3 DIN 934 | 4
2.6 | M3X12mm ISO_7045 | 4
2.7 | Y_Carriage_Grp_WHB | 1
3 | Rod_M8x400 | 2
4 | M8 DIN_125A | 8
5 | M8 DIN 934 | 4
6 | M8 ISO_1587 | 4
7 | M3 DIN 934 | 4
8 | M3X12mm ISO_7045 | 4
9 | Triger Belt | 1

AKSİ BELİRTİLMEDİĞİ SÜRECE:
BOYUTLAR MİLİMETREDİR
YÜZEY CİLASI:
TOLERANSLAR:
DOĞRUSAL:
AÇISAL:

İSİM | İMZA | TARİH | BAŞLIK: Y Axis Group Assembly On Main Frame (Main Frame Assembly)

ÇİZEN
DENET.
ONAY.
ÜRET.

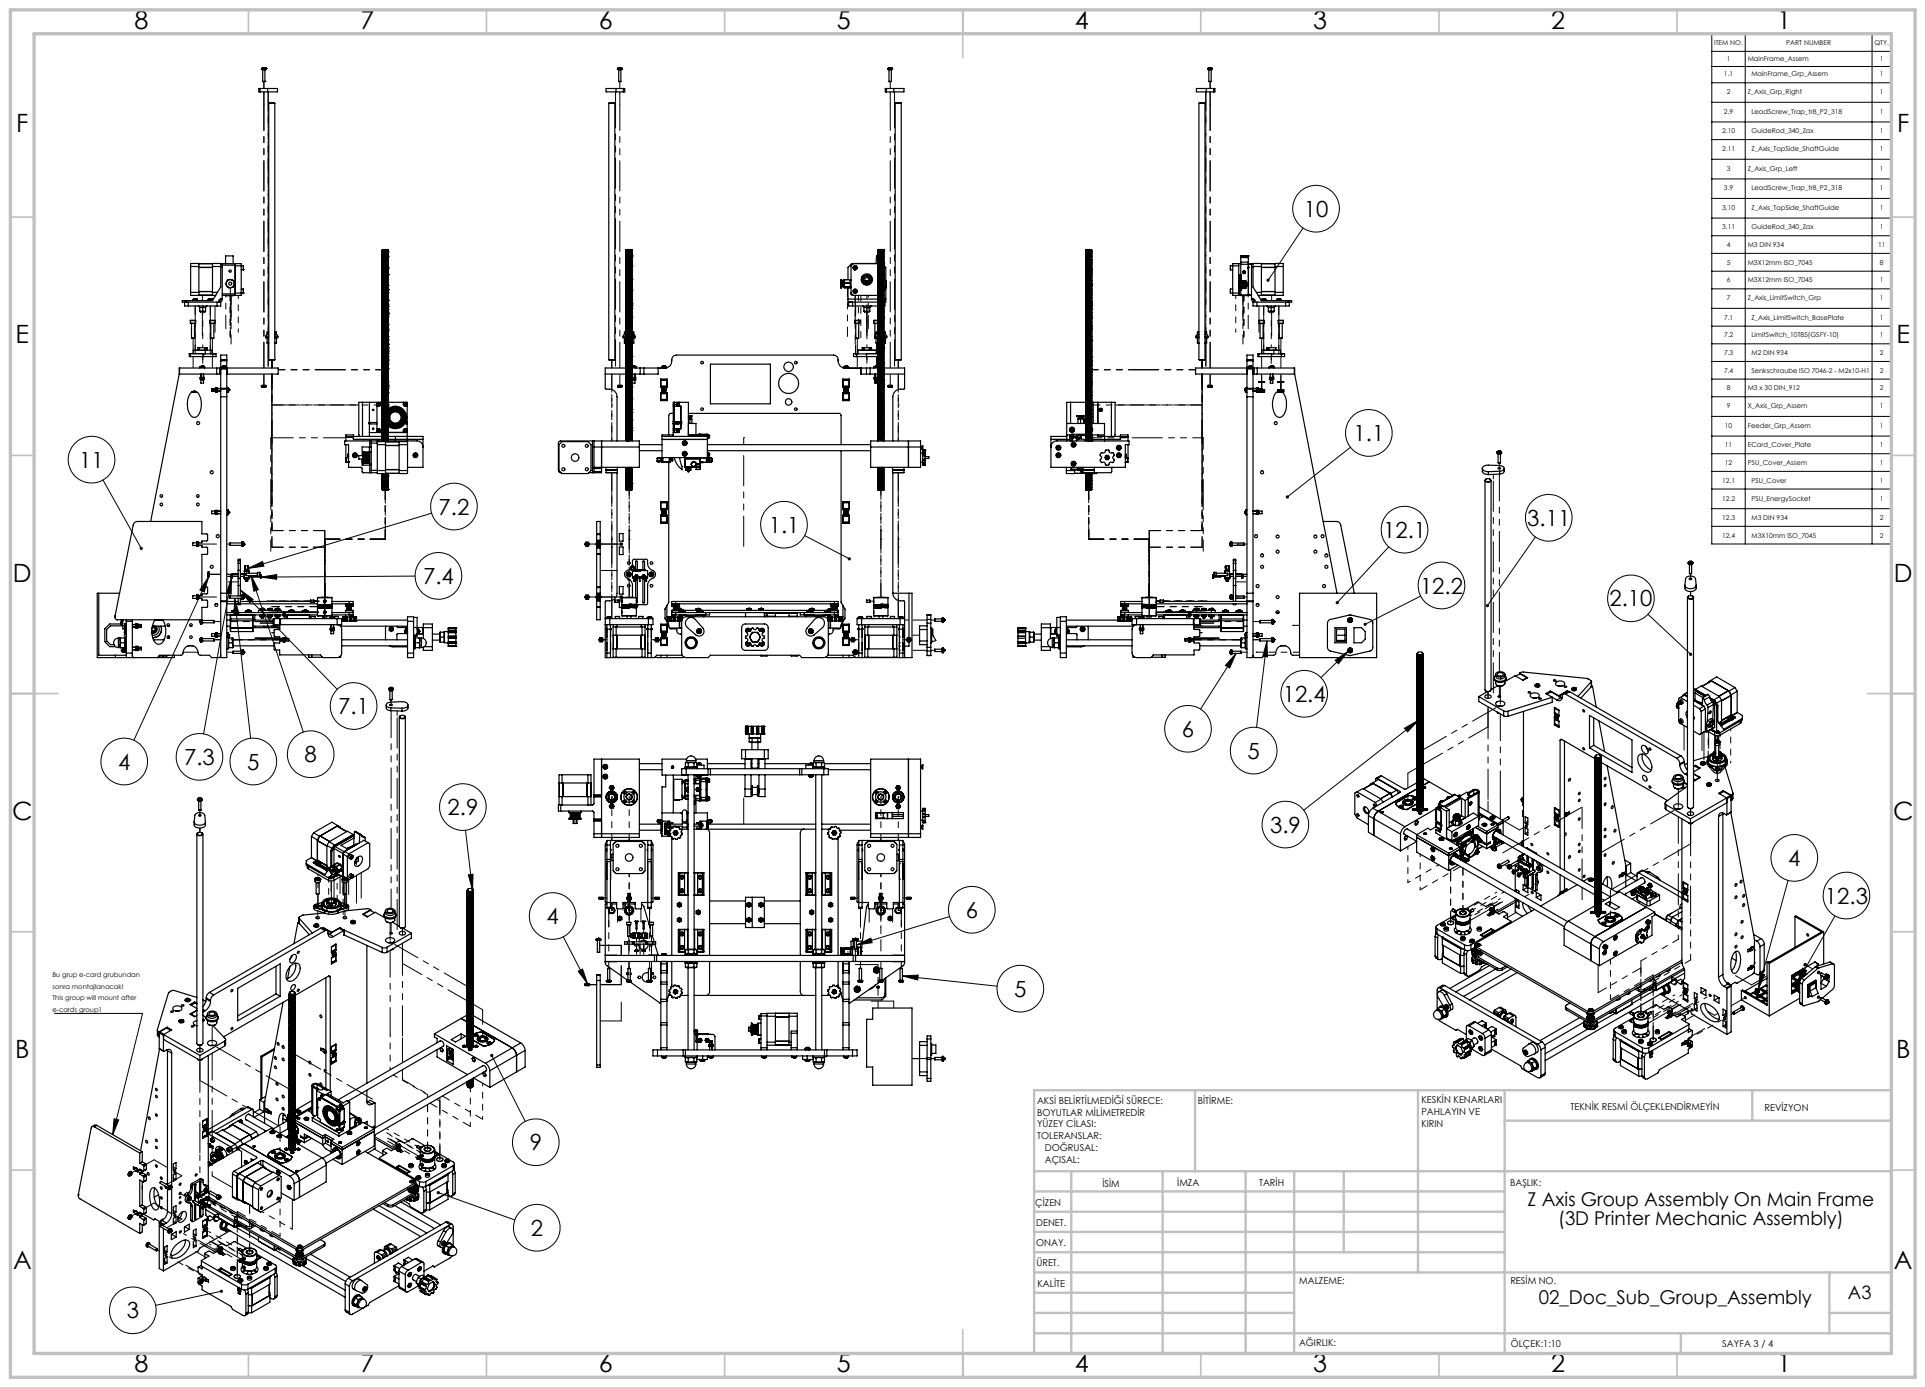
[picture p163: page 3]
BİTİRME:; KESKİN KENARLARI; PAHLAYIN VE; TEKNİK RESMİ ÖLÇEKLENDİRMEYİN; REVİZYON

1 | MainFrame_Assem | 1
1.1 | MainFrame_Grp_Assem | 1

2 | Z_Axis_Grp_Right | 1

2.9 | LeadScrew_Trap_tr8_P2_318 | 1

2.10 | GuideRod_340_Zax | 1

2.11 | Z_Axis_TopSide_ShaftGuide | 1

3 | Z_Axis_Grp_Left | 1

3.9 | LeadScrew_Trap_tr8_P2_318 | 1

3.10 | Z_Axis_TopSide_ShaftGuide | 1

4 | M3 DIN 934 | 11

5 | M3X12mm ISO_7045 | 8

6 | M3X12mm ISO_7045 | 1

7 | Z_Axis_LimitSwitch_Grp | 1

7.1 | Z_Axis_LimitSwitch_BasePlate | 1

7.2 | LimitSwitch_10T85(GSFY-10) | 1

7.3 | M2 DIN 934 | 2

7.4 | Senkschraube ISO 7046-2 - M2x10-H1 | 2

8 | M3 x 30 DIN_912 | 2

9 | X_Axis_Grp_Assem | 1

10 | Feeder_Grp_Assem | 1

11 | ECard_Cover_Plate | 1

12 | PSU_Cover_Assem | 1

12.1 | PSU_Cover | 1

12.2 | PSU_EnergySocket | 1

12.3 | M3 DIN 934 | 2

12.4 | M3X10mm ISO_7045 | 2

Bu grup e-card grubundan
sonra montajlanacak!
This group will mount after
e-cards group1

AKSİ BELİRTİLMEDİĞİ SÜRECE:
BOYUTLAR MİLİMETREDİR
YÜZEY CİLASI:
TOLERANSLAR:
DOĞRUSAL:
AÇISAL:

İSİM | İMZA | TARİH | BAŞLIK: Z Axis Group Assembly On Main Frame (3D Printer Mechanic Assembly)

ÇİZEN
DENET.
ONAY.
ÜRET.

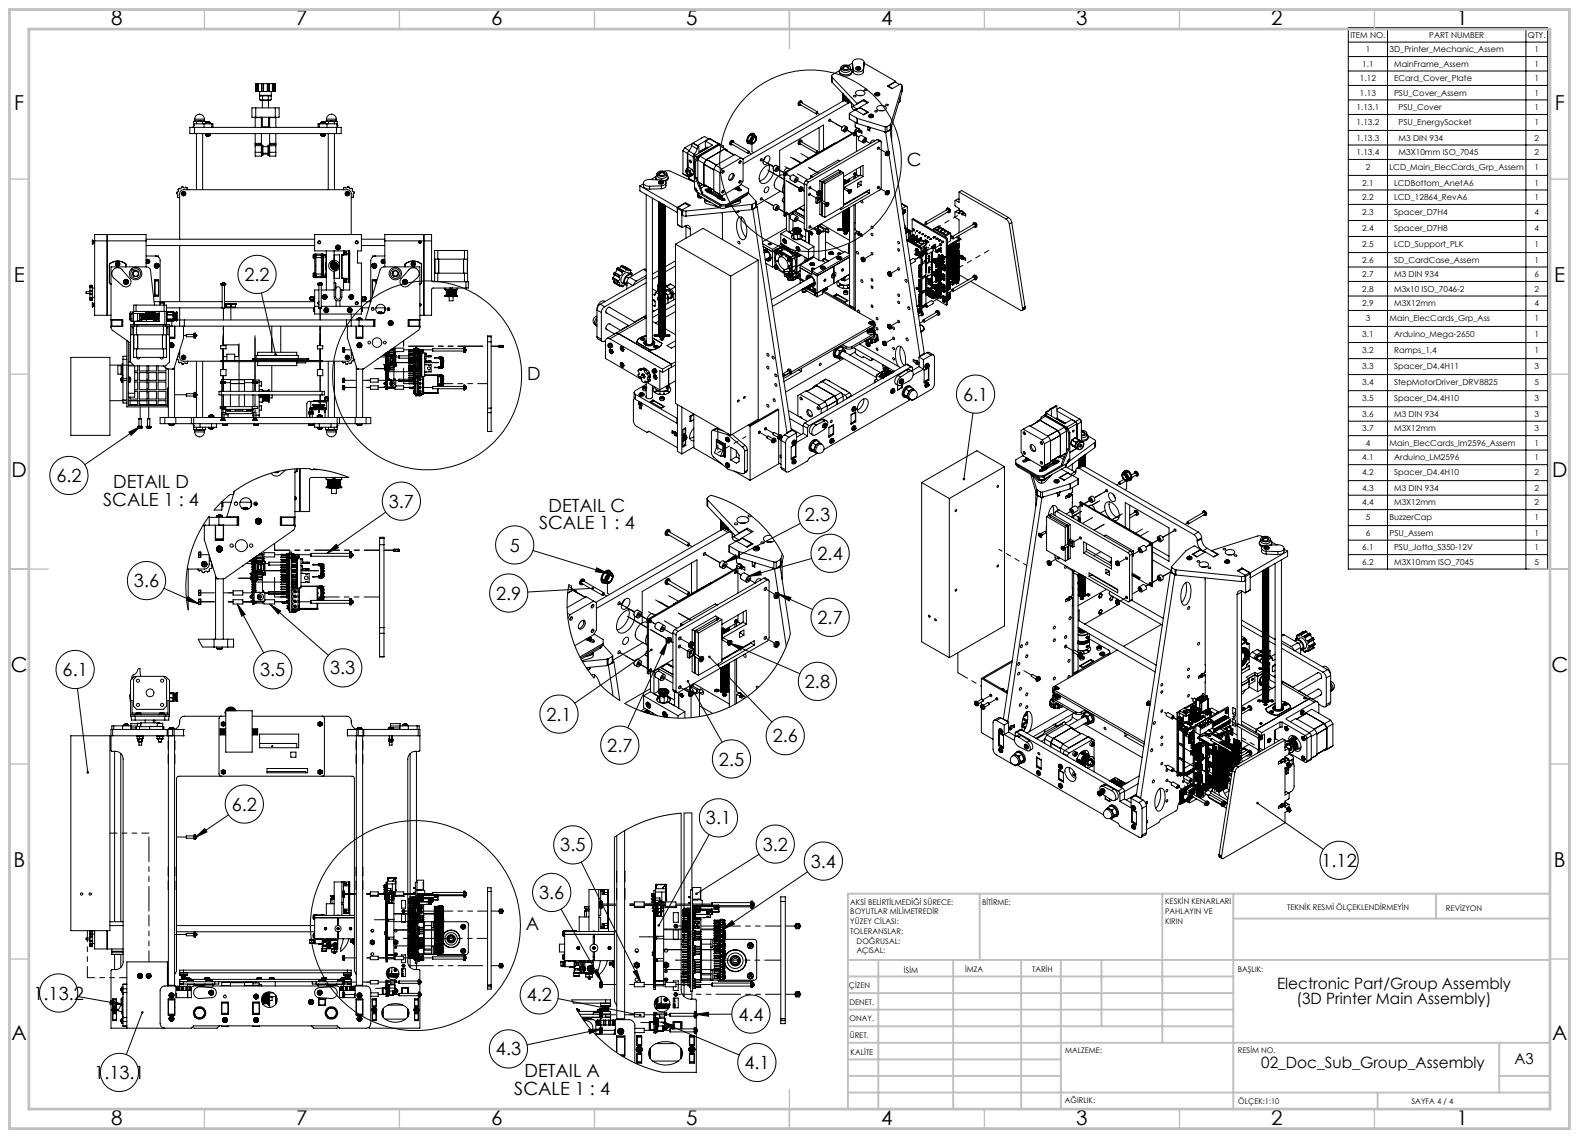
[picture p164: page 4]
DETAIL A SCALE 1 : 4; DETAIL C SCALE 1 : 4; DETAIL D; SCALE 1 : 4; BİTİRME:; KESKİN KENARLARI; PAHLAYIN VE; TEKNİK RESMİ ÖLÇEKLENDİRMEYİN; REVİZYON

1 | 3D_Printer_Mechanic_Assem | 1
1.1 | MainFrame_Assem | 1
1.12 | ECard_Cover_Plate | 1
1.13 | PSU_Cover_Assem | 1
1.13.1 | PSU_Cover | 1
1.13.2 | PSU_EnergySocket | 1
1.13.3 | M3 DIN 934 | 2
1.13.4 | M3X10mm ISO_7045 | 2
2 | LCD_Main_ElecCards_Grp_Assem | 1

E | | 2.1 | LCDBottom_AnetA6 | 1 | E

2.2 | LCD_12864_RevA6 | 1
2.3 | Spacer_D7H4 | 4
2.4 | Spacer_D7H8 | 4
2.5 | LCD_Support_PLK | 1
2.6 | SD_CardCase_Assem | 1
2.7 | M3 DIN 934 | 6
2.8 | M3x10 ISO_7046-2 | 2
2.9 | M3X12mm | 4
3 | Main_ElecCards_Grp_Ass | 1
3.1 | Arduino_Mega-2650 | 1
3.2 | Ramps_1.4 | 1
3.3 | Spacer_D4.4H11 | 3
3.4 | StepMotorDriver_DRV8825 | 5
3.5 | Spacer_D4.4H10 | 3
3.6 | M3 DIN 934 | 3
3.7 | M3X12mm | 3
4 | Main_ElecCards_lm2596_Assem | 1
4.1 | Arduino_LM2596 | 1
4.2 | Spacer_D4.4H10 | 2
4.3 | M3 DIN 934 | 2
4.4 | M3X12mm | 2
5 | BuzzerCap | 1
6 | PSU_Assem | 1
6.1 | PSU_Jotta_S350-12V | 1
6.2 | M3X10mm ISO_7045 | 5

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

İSİM | İMZA | TARİH | BAŞLIK: Electronic Part/Group Assembly (3D Printer Main Assembly)

ÇİZEN
DENET.
ONAY.
ÜRET.
