YazgacResearch/3DPrinter/Drawings/3D_Printer_Rev_02/Hirdavat/Table_Metric.png

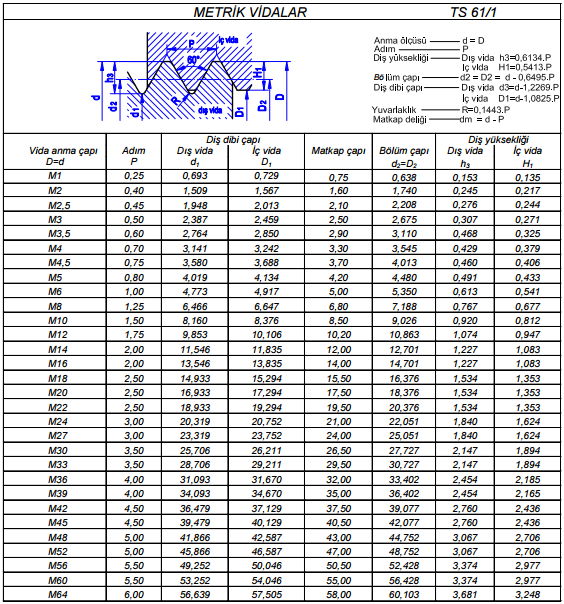
Drawings/3D_Printer_Rev_02/Hirdavat/Table_Metric.png
