YazgacResearch/3DPrinter/Drawings/3D_Printer_Rev_02/Ticari/e3d-v6-hot-end/E3Dv6_HotEnd1.JPG

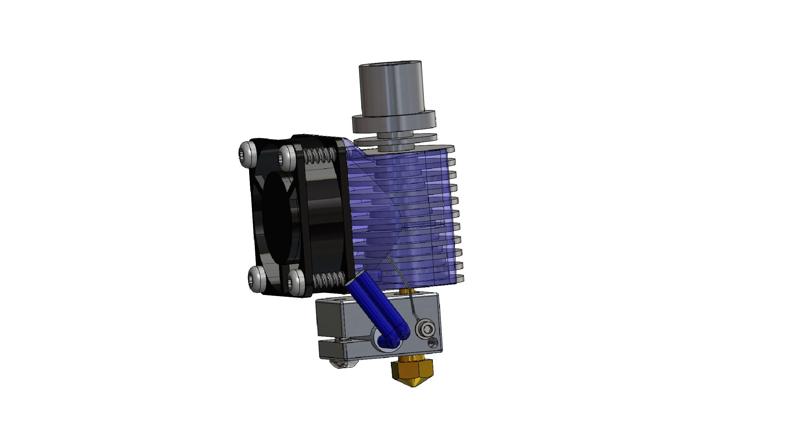
Drawings/3D_Printer_Rev_02/Ticari/e3d-v6-hot-end/E3Dv6_HotEnd1.JPG
