YazgacResearch/3DPrinter/Drawings/3D_Printer_Rev_02/Ticari/Fan_BLDC_40x10/Fan centrifugal 40x40x10 v9.png

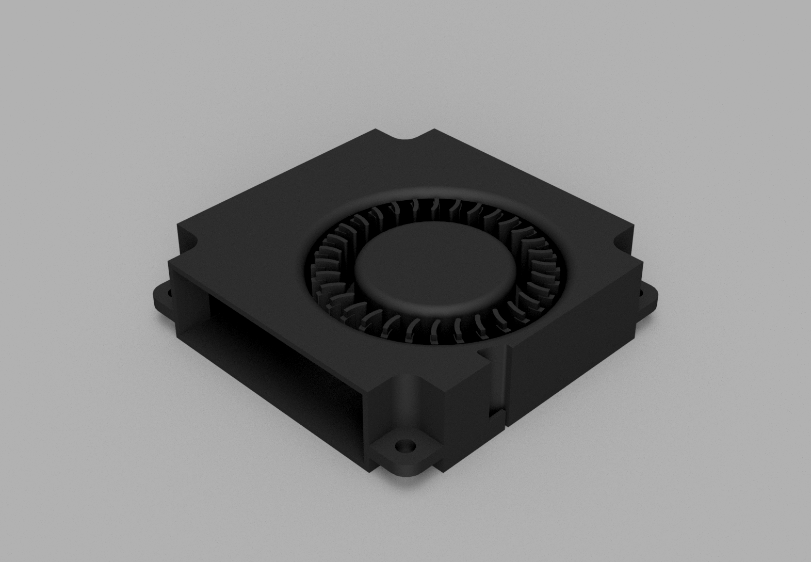
Drawings/3D_Printer_Rev_02/Ticari/Fan_BLDC_40x10/Fan centrifugal 40x40x10 v9.png
