YazgacResearch/3DPrinter/Drawings/3D_Printer_Rev_02/Ticari/GT2 Pulley 3mm bore/Snímek obrazovky 2018-11-15 v 23.43.34.png

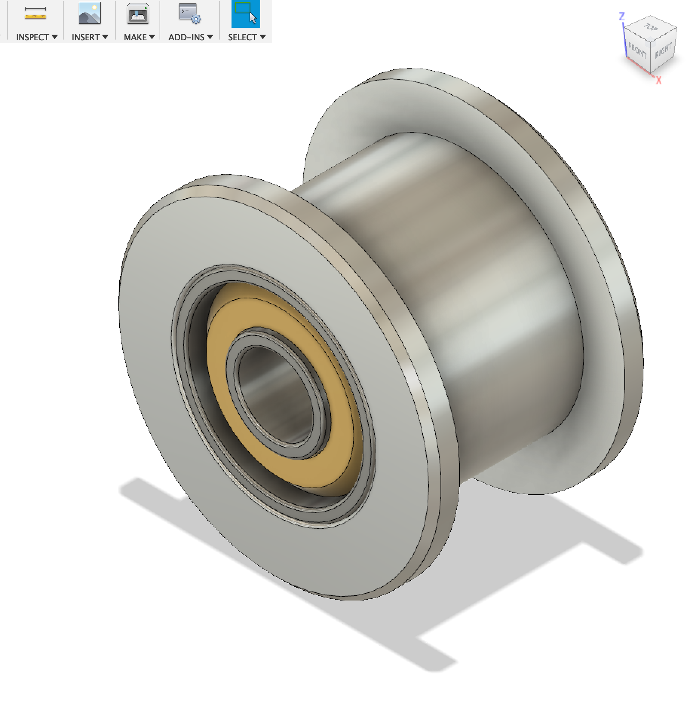
Drawings/3D_Printer_Rev_02/Ticari/GT2 Pulley 3mm bore/Snímek obrazovky 2018-11-15 v 23.43.34.png
