YazgacResearch/3DPrinter/Drawings/3D_Printer_Rev_02/Ticari/GT2 Pulley 3mm bore/Snímek obrazovky 2018-11-15 v 23.53.07.png

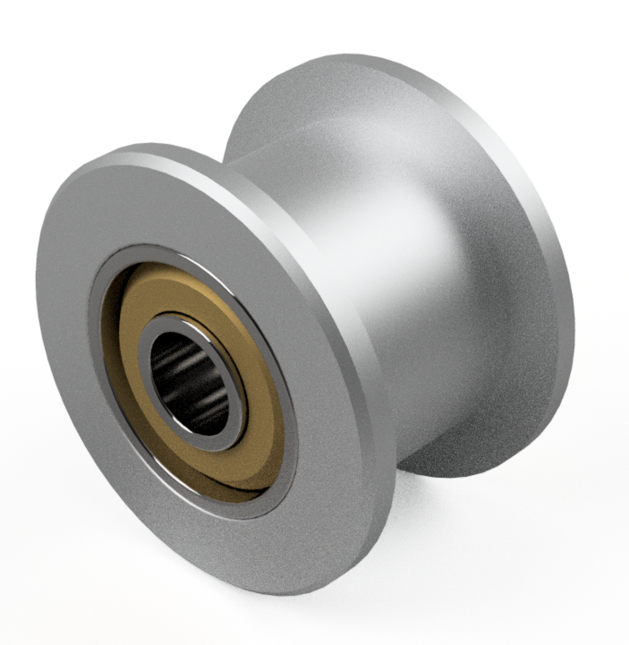
Drawings/3D_Printer_Rev_02/Ticari/GT2 Pulley 3mm bore/Snímek obrazovky 2018-11-15 v 23.53.07.png
