YazgacResearch/3DPrinter/Drawings/3D_Printer_Rev_02/Ticari/KFL08_Yatak/BEAR-KFL08-04.jpg

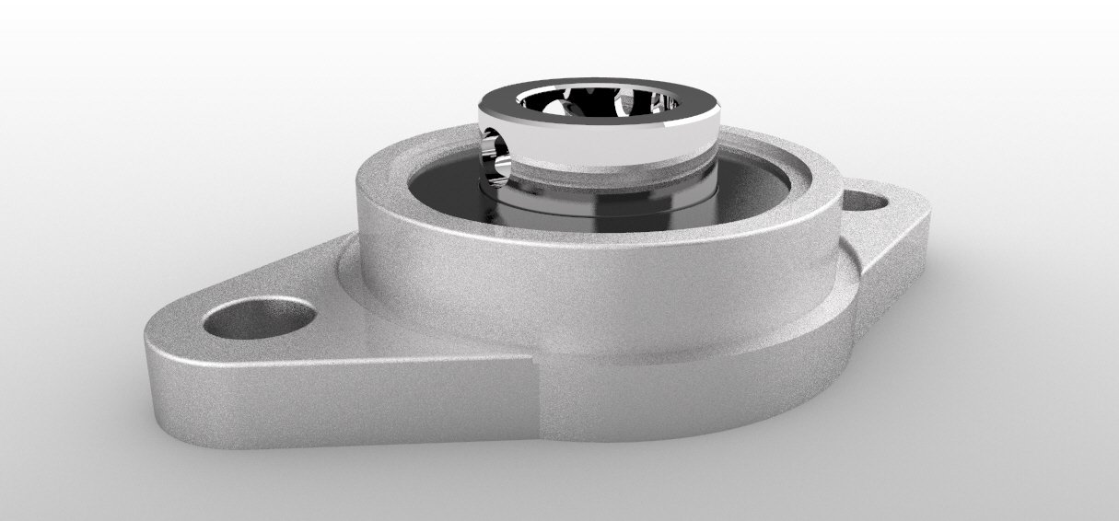
Drawings/3D_Printer_Rev_02/Ticari/KFL08_Yatak/BEAR-KFL08-04.jpg
