YazgacResearch/3DPrinter/Drawings/3D_Printer_Rev_02/Ticari/MK8 EXTRUDER RIGHT/MK8 RIGHT STEPMOTOR.jpg

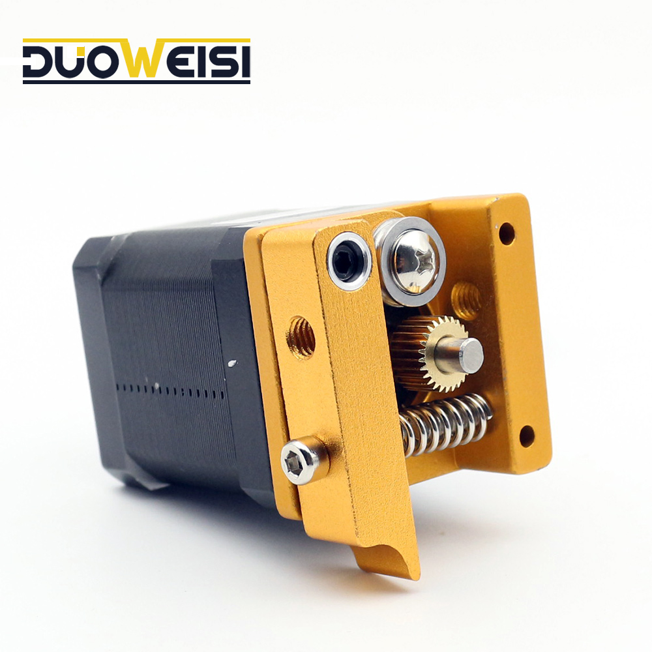
Drawings/3D_Printer_Rev_02/Ticari/MK8 EXTRUDER RIGHT/MK8 RIGHT STEPMOTOR.jpg
