YazgacResearch/3DPrinter/Drawings/3D_Printer_Rev_02/ZZ_Assembly_Documents/00_Doc_3D_Printer_Main.PDF

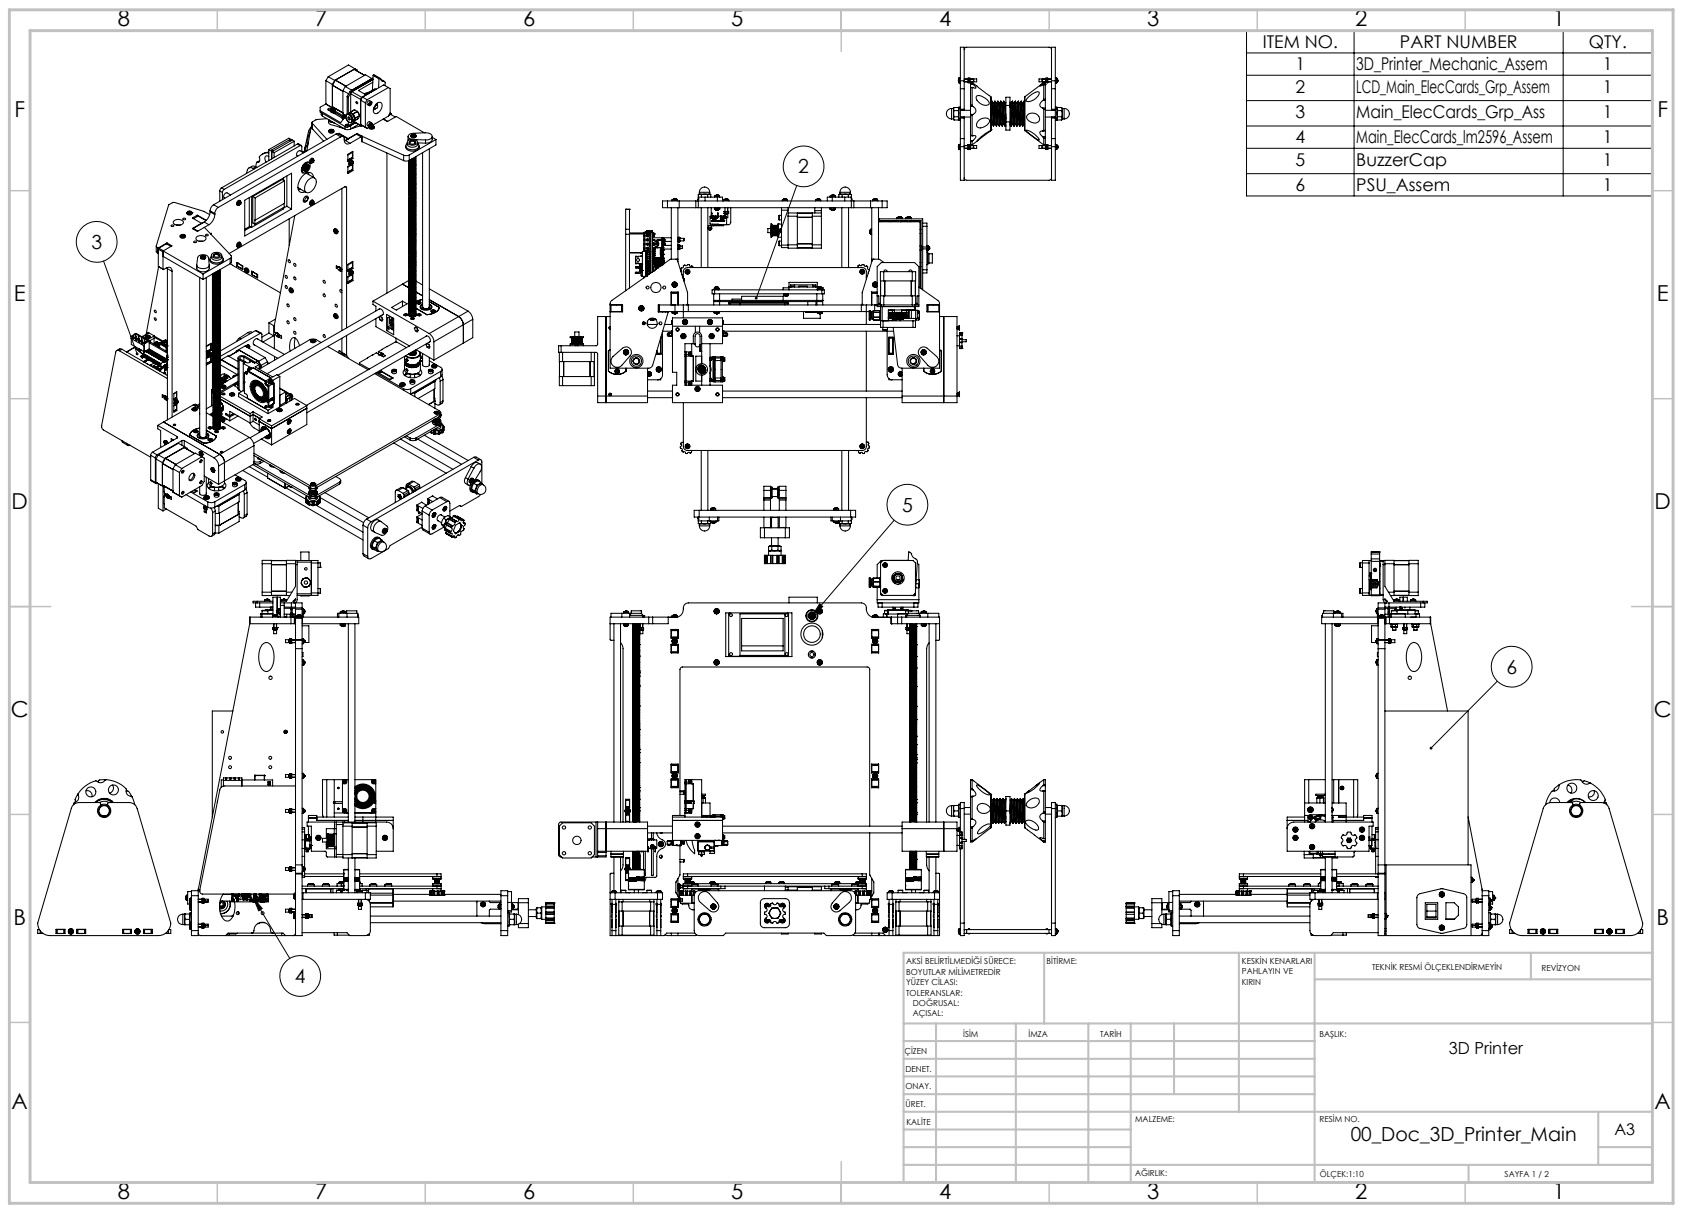
[picture p179: page 1]
BİTİRME:; KESKİN KENARLARI; PAHLAYIN VE; TEKNİK RESMİ ÖLÇEKLENDİRMEYİN; REVİZYON; ÖLÇEK:1:10; SAYFA 1 / 2

ITEM NO. | PART NUMBER | QTY.
1 | 3D_Printer_Mechanic_Assem | 1
2 | LCD_Main_ElecCards_Grp_Assem | 1
3 | Main_ElecCards_Grp_Ass | 1
4 | Main_ElecCards_lm2596_Assem | 1
5 | BuzzerCap | 1
6 | PSU_Assem | 1

AKSİ BELİRTİLMEDİĞİ SÜRECE:
BOYUTLAR MİLİMETREDİR
YÜZEY CİLASI:
TOLERANSLAR:
DOĞRUSAL:
AÇISAL:

İSİM | İMZA | TARİH | | | | BAŞLIK: 3D Printer

ÇİZEN
DENET.
ONAY.
ÜRET.
KALİTE | | | | MALZEME: | RESİM NO. 00_Doc_3D_Printer_Main | A3

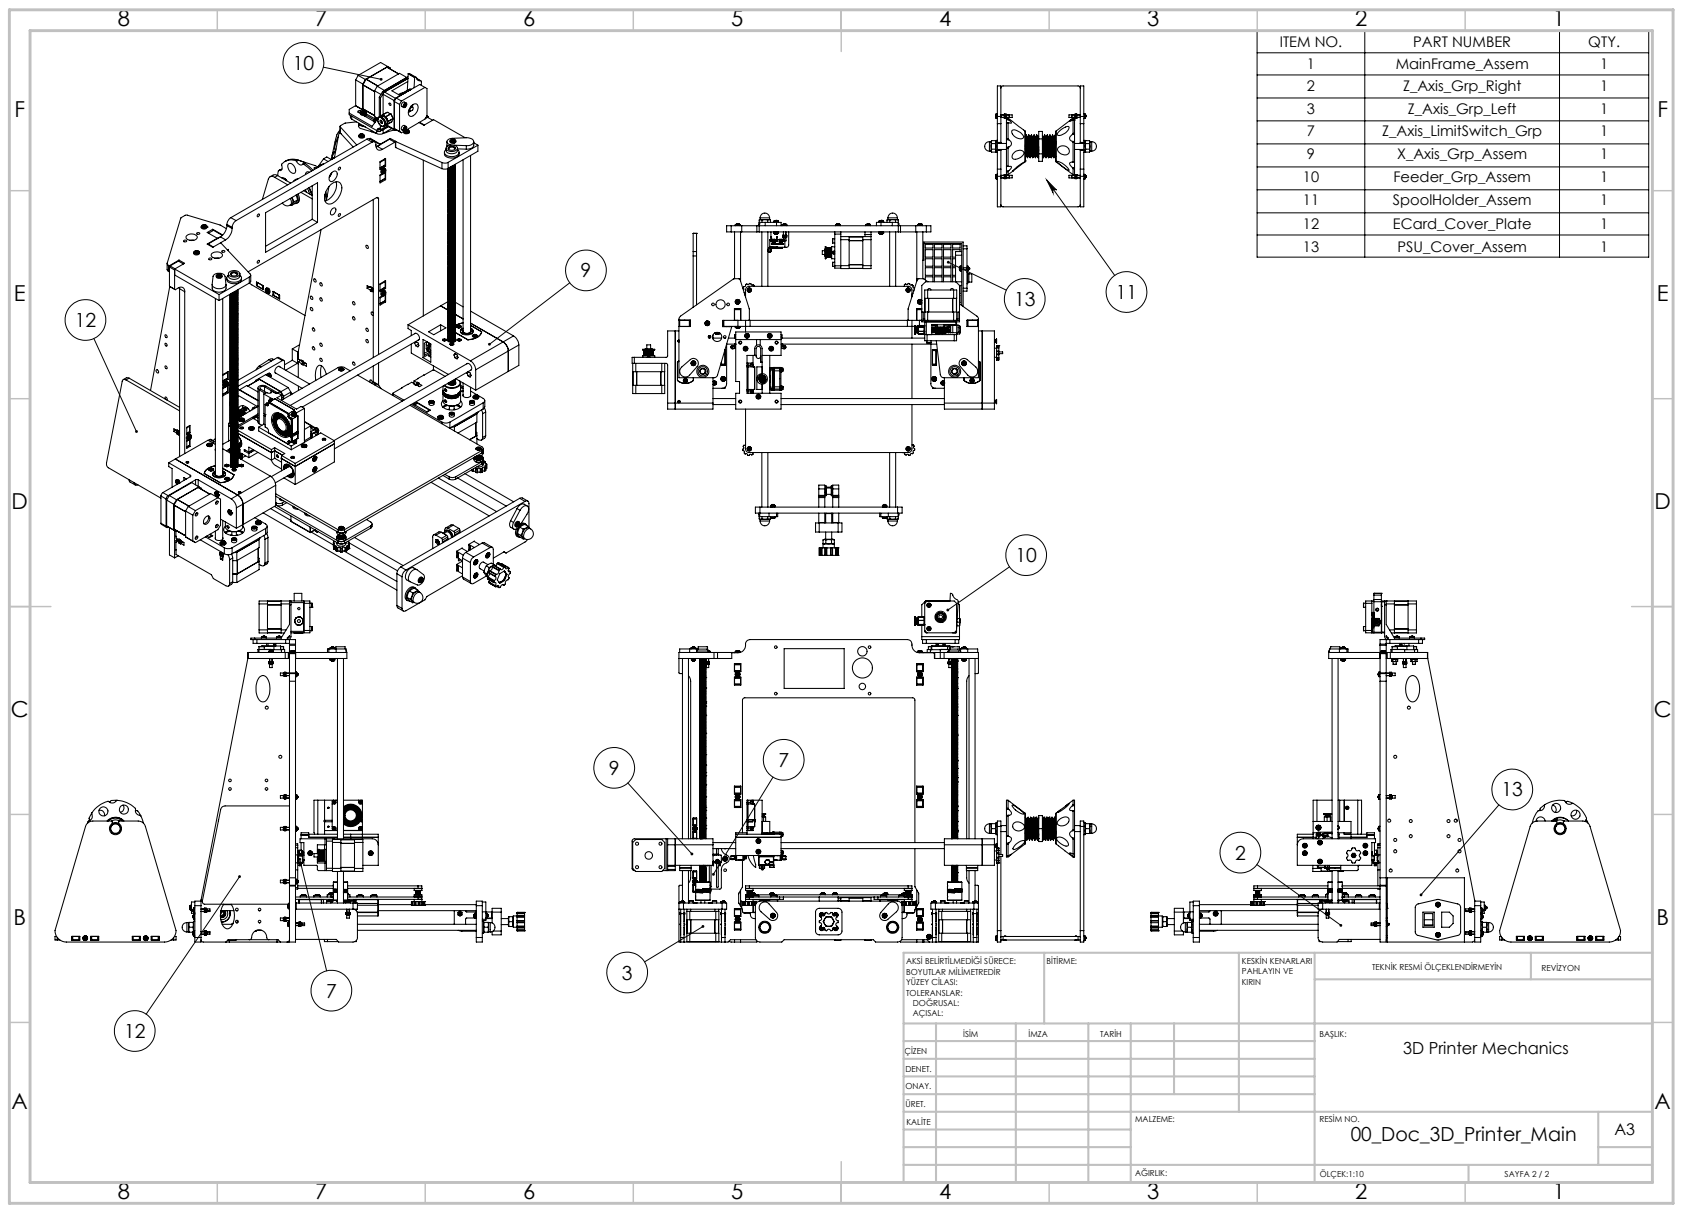
[picture p180: page 2]
BİTİRME:; KESKİN KENARLARI; PAHLAYIN VE; TEKNİK RESMİ ÖLÇEKLENDİRMEYİN; REVİZYON; ÖLÇEK:1:10; SAYFA 2 / 2

ITEM NO. | PART NUMBER | QTY.
1 | MainFrame_Assem | 1
2 | Z_Axis_Grp_Right | 1
3 | Z_Axis_Grp_Left | 1
7 | Z_Axis_LimitSwitch_Grp | 1
9 | X_Axis_Grp_Assem | 1
10 | Feeder_Grp_Assem | 1

E | | 11 | SpoolHolder_Assem | 1 | E

12 | ECard_Cover_Plate | 1
13 | PSU_Cover_Assem | 1

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

İSİM | İMZA | TARİH | | | | BAŞLIK: 3D Printer Mechanics

ÇİZEN
DENET.
ONAY.
ÜRET.
KALİTE | | | | MALZEME: | RESİM NO. 00_Doc_3D_Printer_Main | A3
