YazgacResearch/3DPrinter/Marlin-bugfix-2.0.4.4/Marlin/Configuration.h

#pragma once
#define CONFIGURATION_H_VERSION 020005
#define EAGLE_CONFIG
  #define STRING_CONFIG_H_AUTHOR "(OktayYazgac, Eagle Config)" // Who made the changes.
  #define CUSTOM_VERSION_FILE Version.h // Path from the root directory (no quotes)
#define SHOW_BOOTSCREEN
  #define CUSTOM_STATUS_SCREEN_IMAGE
#define SERIAL_PORT 0
  #define BAUDRATE 115200
  #define MOTHERBOARD BOARD_RAMPS_14_EFB
#define EXTRUDERS 1
  #define DEFAULT_NOMINAL_FILAMENT_DIA 1.75
  #define TEMP_SENSOR_0 11
  #define TEMP_SENSOR_1 0
  #define TEMP_SENSOR_2 0
  #define TEMP_SENSOR_3 0
  #define TEMP_SENSOR_4 0
  #define TEMP_SENSOR_5 0
  #define TEMP_SENSOR_6 0
  #define TEMP_SENSOR_7 0
  #define TEMP_SENSOR_BED 11
  #define TEMP_SENSOR_PROBE 0
  #define TEMP_SENSOR_CHAMBER 0
#define DUMMY_THERMISTOR_998_VALUE 25
#define DUMMY_THERMISTOR_999_VALUE 100
#define MAX_REDUNDANT_TEMP_SENSOR_DIFF 10
#define TEMP_RESIDENCY_TIME     10  // (seconds) Time to wait for hotend to "settle" in M109
#define TEMP_WINDOW              1  // (°C) Temperature proximity for the "temperature reached" timer
#define TEMP_HYSTERESIS          3  // (°C) Temperature proximity considered "close enough" to the target
#define TEMP_BED_RESIDENCY_TIME 10  // (seconds) Time to wait for bed to "settle" in M190
#define TEMP_BED_WINDOW          1  // (°C) Temperature proximity for the "temperature reached" timer
#define TEMP_BED_HYSTERESIS      3  // (°C) Temperature proximity considered "close enough" to the target
#define HEATER_0_MINTEMP   5
#define HEATER_1_MINTEMP   5
#define HEATER_2_MINTEMP   5
#define HEATER_3_MINTEMP   5
#define HEATER_4_MINTEMP   5
#define HEATER_5_MINTEMP   5
#define HEATER_6_MINTEMP   5
#define HEATER_7_MINTEMP   5
#define BED_MINTEMP        5
#define HEATER_0_MAXTEMP 275
#define HEATER_1_MAXTEMP 275
#define HEATER_2_MAXTEMP 275
#define HEATER_3_MAXTEMP 275
#define HEATER_4_MAXTEMP 275
#define HEATER_5_MAXTEMP 275
#define HEATER_6_MAXTEMP 275
#define HEATER_7_MAXTEMP 275
  #define BED_MAXTEMP      130
#define PIDTEMP
#define BANG_MAX 255     // Limits current to nozzle while in bang-bang mode; 255=full current
#define PID_MAX BANG_MAX // Limits current to nozzle while PID is active (see PID_FUNCTIONAL_RANGE below); 255=full current
#define PID_K1 0.95      // Smoothing factor within any PID loop
    #define PID_EDIT_MENU         // Add PID editing to the "Advanced Settings" menu. (~700 bytes of PROGMEM)
    #define PID_AUTOTUNE_MENU     // Add PID auto-tuning to the "Advanced Settings" menu. (~250 bytes of PROGMEM)
  #define PID_FUNCTIONAL_RANGE 10 // If the temperature difference between the target temperature and the actual temperature
    #define DEFAULT_Kp 22.2
    #define DEFAULT_Ki 1.08
    #define DEFAULT_Kd 114.0
  #define PIDTEMPBED
#define MAX_BED_POWER 255 // limits duty cycle to bed; 255=full current
    #define MIN_BED_POWER 0
    #define DEFAULT_bedKp 295.00
    #define DEFAULT_bedKi 35.65
    #define DEFAULT_bedKd 610.21
#define PREVENT_COLD_EXTRUSION
#define EXTRUDE_MINTEMP 170
#define PREVENT_LENGTHY_EXTRUDE
#define EXTRUDE_MAXLENGTH 200
#define THERMAL_PROTECTION_HOTENDS // Enable thermal protection for all extruders
#define THERMAL_PROTECTION_BED     // Enable thermal protection for the heated bed
#define THERMAL_PROTECTION_CHAMBER // Enable thermal protection for the heated chamber
#define USE_XMIN_PLUG
#define USE_YMIN_PLUG
#define USE_ZMIN_PLUG
#define USE_XMAX_PLUG
#define ENDSTOPPULLUPS
  #define X_MIN_ENDSTOP_INVERTING true  // Set to true to invert the logic of the endstop.
  #define Y_MIN_ENDSTOP_INVERTING true  // Set to true to invert the logic of the endstop.
  #define Z_MIN_ENDSTOP_INVERTING true  // Set to true to invert the logic of the endstop.
  #define X_MAX_ENDSTOP_INVERTING true  // Set to true to invert the logic of the endstop.
  #define Y_MAX_ENDSTOP_INVERTING false // Set to true to invert the logic of the endstop.
  #define Z_MAX_ENDSTOP_INVERTING false // Set to true to invert the logic of the endstop.
  #define Z_MIN_PROBE_ENDSTOP_INVERTING false // Set to true to invert the logic of the probe.
  #define X_DRIVER_TYPE  DRV8825
  #define Y_DRIVER_TYPE  DRV8825
  #define Z_DRIVER_TYPE  DRV8825
  #define Z2_DRIVER_TYPE DRV8825
  #define E0_DRIVER_TYPE DRV8825
  #define ENDSTOP_INTERRUPTS_FEATURE
  #define DEFAULT_AXIS_STEPS_PER_UNIT   { 200,  200, 800, 190 }
  #define DEFAULT_MAX_FEEDRATE          { 400, 400, 4, 25 }
  #define DEFAULT_MAX_ACCELERATION      { 9000, 5000, 50, 10000 }
  #define DEFAULT_ACCELERATION          1000    // X, Y, Z and E acceleration for printing moves
  #define DEFAULT_RETRACT_ACCELERATION  1000    // E acceleration for retracts
  #define DEFAULT_TRAVEL_ACCELERATION   1000    // X, Y, Z acceleration for travel (non printing) moves
#define DEFAULT_EJERK    5.0  // May be used by Linear Advance
    #define JUNCTION_DEVIATION_MM 0.04 // (mm) Distance from real junction edge
#define Z_MIN_PROBE_USES_Z_MIN_ENDSTOP_PIN
  #define NOZZLE_TO_PROBE_OFFSET { 10, 10, 0 }
#define MIN_PROBE_EDGE 10
#define XY_PROBE_SPEED 8000
#define Z_PROBE_SPEED_FAST HOMING_FEEDRATE_Z
  #define Z_PROBE_SPEED_SLOW (Z_PROBE_SPEED_FAST / 3)
  #define MULTIPLE_PROBING 2
  #define Z_CLEARANCE_DEPLOY_PROBE   10 // Z Clearance for Deploy/Stow
  #define Z_CLEARANCE_BETWEEN_PROBES  5 // Z Clearance between probe points
#define Z_CLEARANCE_MULTI_PROBE       5 // Z Clearance between multiple probes
#define Z_PROBE_LOW_POINT          -2 // Farthest distance below the trigger-point to go before stopping
#define Z_PROBE_OFFSET_RANGE_MIN -20
#define Z_PROBE_OFFSET_RANGE_MAX 20
  #define PROBING_HEATERS_OFF       // Turn heaters off when probing
  #define PROBING_FANS_OFF          // Turn fans off when probing
#define X_ENABLE_ON 0
#define Y_ENABLE_ON 0
#define Z_ENABLE_ON 0
#define E_ENABLE_ON 0 // For all extruders
#define DISABLE_X false
#define DISABLE_Y false
#define DISABLE_Z false
#define DISABLE_E false             // For all extruders
#define DISABLE_INACTIVE_EXTRUDER   // Keep only the active extruder enabled
  #define INVERT_X_DIR false
  #define INVERT_Y_DIR false
  #define INVERT_Z_DIR true
#define INVERT_E0_DIR true
#define INVERT_E1_DIR false
#define INVERT_E2_DIR false
#define INVERT_E3_DIR false
#define INVERT_E4_DIR false
#define INVERT_E5_DIR false
#define INVERT_E6_DIR false
#define INVERT_E7_DIR false
#define X_HOME_DIR -1
#define Y_HOME_DIR -1
#define Z_HOME_DIR -1
  #define X_BED_SIZE 220
  #define Y_BED_SIZE 220
  #define X_MIN_POS -5
  #define Y_MIN_POS 0
  #define Z_MIN_POS 0
#define X_MAX_POS X_BED_SIZE
#define Y_MAX_POS Y_BED_SIZE
  #define Z_MAX_POS 200
#define MIN_SOFTWARE_ENDSTOPS
  #define MIN_SOFTWARE_ENDSTOP_X
  #define MIN_SOFTWARE_ENDSTOP_Y
  #define MIN_SOFTWARE_ENDSTOP_Z
#define MAX_SOFTWARE_ENDSTOPS
  #define MAX_SOFTWARE_ENDSTOP_X
  #define MAX_SOFTWARE_ENDSTOP_Y
  #define MAX_SOFTWARE_ENDSTOP_Z
#define HOMING_FEEDRATE_XY (50*60)
#define HOMING_FEEDRATE_Z  (4*60)
#define VALIDATE_HOMING_ENDSTOPS
  #define EEPROM_SETTINGS     // Persistent storage with M500 and M501
  #define EEPROM_CHITCHAT     // Give feedback on EEPROM commands. Disable to save PROGMEM.
  #define EEPROM_AUTO_INIT  // Init EEPROM automatically on any errors.
#define HOST_KEEPALIVE_FEATURE        // Disable this if your host doesn't like keepalive messages
#define DEFAULT_KEEPALIVE_INTERVAL 2  // Number of seconds between "busy" messages. Set with M113.
#define BUSY_WHILE_HEATING            // Some hosts require "busy" messages even during heating
#define PREHEAT_1_LABEL       "PLA"
  #define PREHEAT_1_TEMP_HOTEND 200
  #define PREHEAT_1_TEMP_BED     50
  #define PREHEAT_1_FAN_SPEED     0 // Value from 0 to 255
#define PREHEAT_2_LABEL       "ABS"
  #define PREHEAT_2_TEMP_HOTEND 230
  #define PREHEAT_2_TEMP_BED     70
  #define PREHEAT_2_FAN_SPEED     0 // Value from 0 to 255
#define PRINTJOB_TIMER_AUTOSTART
#define LCD_LANGUAGE en
#define DISPLAY_CHARSET_HD44780 JAPANESE
#define LCD_INFO_SCREEN_STYLE 0
  #define SDSUPPORT
  #define SPEAKER
  #define LCD_FEEDBACK_FREQUENCY_DURATION_MS 10
  #define LCD_FEEDBACK_FREQUENCY_HZ 1200
  #define ANET_FULL_GRAPHICS_LCD
#define SOFT_PWM_SCALE 0
#define SERVO_DELAY { 300 }
