YazgacResearch/3DPrinter/(commit log)

2021-01-05 3D Printer
    Open Hardware, Open Software, High Resolution 3D Printer
    [00_Doc_3D_Printer_Main.SLDDRW, 01_Doc_Sub_Part-Grp_Assembly.SLDDRW, 03_DocA_LaserCutting_Assem_Al_3mm.DWG, 03_DocA_LaserCutting_Assem_Al_3mm.SLDDRW, 03_DocB_LaserCutting_Assem_Plexi_4.6mm.SLDDRW, 03_DocB_LaserCutting_Assem_Plexi_4.DWG, 03_DocC_LaserCutting_Assem_Plexi_8mm.DWG, 03_DocC_LaserCutting_Assem_Plexi_8mm.SLDDRW]
2021-01-05 Open Hardware, Open Software
    [30x20x5mm M5 M10 Hole R plus Nozzel Size div 4.3dm, 30x20x5mm M5 M10 Hole R plus Nozzel Size div 4.stl, Configuration.h, Configuration_adv.h, auto0.g]
